HChenZ/amd_fpga_2026/data/pynq/readme.md

# 旧 PYNQ v1 原始证据

更新：2026-11-01。本目录的记录属于无PUF的 PYNQ v1 / pynq-svc-v1，不是当前PUF3。
10-28 board目录保存容量内KAT；10-31 notebook_20261031_112052保存该旧版benchmark，
error_gate_20261031_112812保存9项错误/恢复门禁。它们在最终报告中作历史对照。
旧10-29目录已由远端变更移出工作树，可从Git历史追溯；不能把重测时间写回原记录。
当前PUF3主采样位于相邻pynq_puf3目录。本页不修改任何原始结果或既有包。
