HChenZ/amd_fpga_2026/docs/tech_report/figs/fig_3_1.tex

% 图 3-1 系统实物照片（正视，上电运行状态）
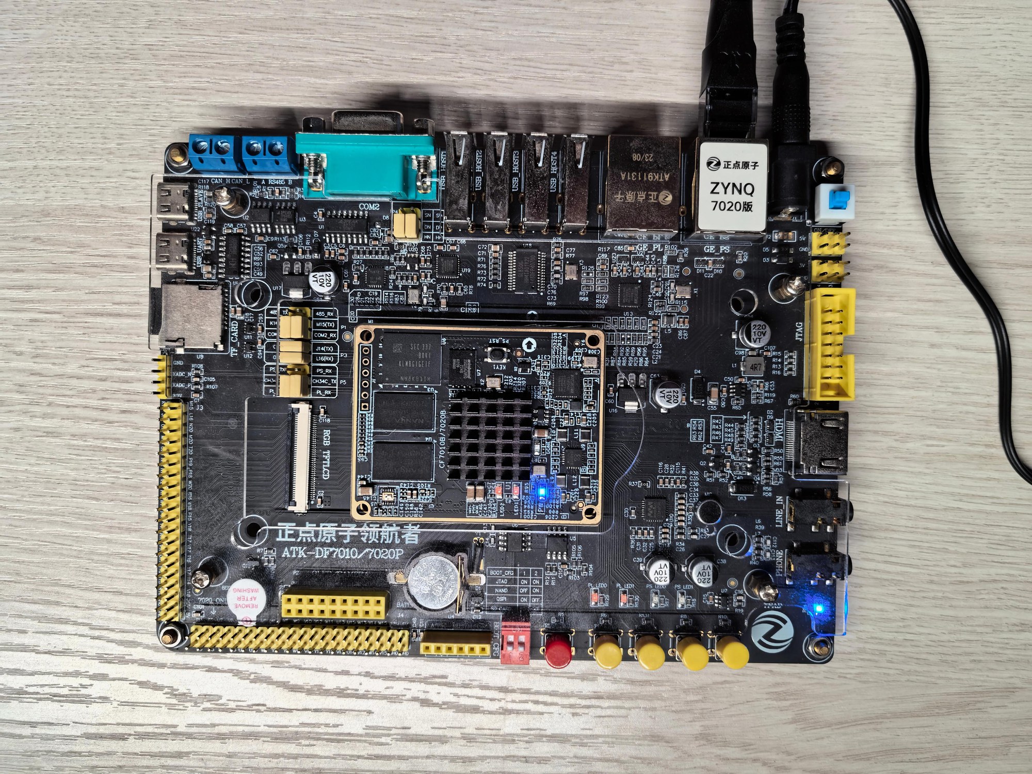
[picture p1: docs/tech_report/figs/board_photo.jpg]
