HChenZ/amd_fpga_2026/docs/tech_report/src_template/10_part1.md

## 摘要 {.unnumbered}

本作品在正点原子领航者 ZYNQ7020 开发板上实现集成 Ascon-AEAD128 的 RISC-V SoC。
PL 内为五级流水线 RV32IM + Zicsr 处理器，包含分支预测、I/D Cache、AXI 互连及 UART、GPIO、CLINT。
密码功能以 NIST SP 800-232 Final 为基准，提供纯软件、存储器映射加速器和定制指令三种方案。
四条定制指令使用 custom-0 编码空间，以 inline assembly 调用，不修改 GCC backend。

当前 PYNQ 发布版由 PS 经两个 AXI-Lite 窗口及 PL 内 UART mailbox 控制 RV32 服务固件。
明文和关联数据各不超过 16 B，三模式各通过 289 组官方容量内 KAT 及 289 次错误 Tag 拒绝。
Notebook 顺序执行、9 项错误恢复门禁与每模式 50 次加解密往返均已有实板记录。
固定官方 KAT #529（PT=16 B、AD=0），各预热 5 次后采样 30 次，加密 SW/HW/ISE 中位周期为
23342/1439/3995，HW 与 ISE 的周期加速比为 16.221×、5.843×；解密为 24005/1388/4385 周期。
周期来自固件 AEAD 调用边界，不含 PS 与串口；PS 调用墙钟中位 4.262–5.216 ms 单列，不充作同倍数响应加速。

Vivado 2025.2 对当前 `pynq_wrapper` 发布版在配置 100 MHz 下实现 WNS +0.034 ns、TNS 0、
setup/hold 失败端点 0、DRC 0 Error/0 Critical Warning，普通 Warning 如实保留。
另实现独立的 256 路 RO-PUF 与 Device DNA 密钥通路原型，同次上电的注册/重建自检通过，
最新有效日志注册质量为 128/128；不声称跨上电稳定、密钥保密隔离或完整安全启动。
host 完整 1089 组 KAT 与板级 289 组分列；独立频率、小时级稳定性与干净环境端到端复现尚未完成。

**关键词**：RISC-V；Ascon-AEAD128；定制指令扩展；MMIO；Zynq-7000；PYNQ；RO-PUF 原型

## 第一部分 作品概述

### 1.1 功能与特性

本作品在 Zynq-7020 上实现 RV32/PYNQ 短消息认证加密平台。PL 内为五级 RV32IM + Zicsr CPU，
提供标准 Ascon-AEAD128 软件、MMIO 与定制指令三种方案。当前 PT/AD 各 ≤16 B，key/nonce/tag 各 16 B。
PS 通过两个 AXI-Lite 窗口与 PL 内 UART mailbox 调用 RV32 服务固件，Jupyter 展示正确性、CPU 周期与 PS 墙钟。
三模式各 289 组官方容量内 KAT、坏 Tag 拒绝及 9 项错误恢复门禁已有实板记录；
完整 1089 组仅为 host 范围，不承诺超容量板级功能。

本作品面向资源受限嵌入式设备的短消息认证加密，选择 NIST SP 800-232 Final Ascon-AEAD128，
在既有五级流水线 RISC-V CPU 上比较纯软件与两条硬件加速路径。算法公开参考实现与官方 KAT
提供独立正确性基准；可交互 PYNQ 演示提供调用、验证与性能展示入口。

本次交付聚焦标准正确性、同平台周期对照、可运行 overlay 与可追溯证据。
host 执行完整 1089 组 KAT；板端只声明容量内 289 组及负向验证，未验收项见 §3.3.5。

### 1.2 应用领域

本作品面向资源受限嵌入式系统的短消息认证加密评估，例如传感器状态、控制消息或设备间小包数据。
当前实测只证明开发板上的有限长度功能与性能，不等于已部署产品的安全认证。

平台也可作为体系结构与 FPGA 实验载体：同一 RV32 上比较纯软件、CPU 驱动 MMIO 与定制指令，
用相同向量和测量边界观察周期差异。替换算法或平台需重新适配验证，不能直接沿用本作品性能值。

### 1.3 主要技术特点

三方案同平台、同输入对照；custom-0 的四条定制指令以 .insn 调用，不修改 GCC backend；
AEAD 密文和 Tag 与锁定 Final 参考逐字节比对；CPU mcycle 与 PS 墙钟分别保存。
构建采用 Vivado 2025.2，bit/hwh/固件逐项记录哈希；仿真、板测、实现报告与未测项分层标注。
当前 PYNQ 数据通道为 AXI-Lite 字节 FIFO 与 RV32 uncached UART，不使用共享可缓存数据缓冲。

### 1.4 主要性能指标

<span class="tabcap">表 1-1</span> **主要性能指标**

| 指标 | SW | HW/MMIO | ISE |
|---|---:|---:|---:|
| 加密 cycles | 23342 | 1439 | 3995 |
| 加密周期加速比 | 1.000× | 16.221× | 5.843× |
| 解密 cycles | 24005 | 1388 | 4385 |
| 解密周期加速比 | 1.000× | 17.295× | 5.474× |
| 加密 PS 墙钟 ms | 5.216 | 4.479 | 5.154 |
| 板级 KAT / 坏 Tag 拒绝 | 289/289 | 289/289 | 289/289 |

上表为当前 PYNQ release 官方 KAT #529（PT=16 B、AD=0）预热 5 次、采样 30 次的中位数，周期不含 PS/UART。
整机 LUT 14269、FF 19691、BRAM 34.5、DSP 4；100 MHz 下 WNS +0.034 ns、TNS 0、DRC 0 Error，频率未独立实测。

### 1.5 主要创新点

1. 同一 RV32 平台、同输入比较软件、MMIO 和定制指令，避免跨平台拼接加速比。
2. custom-0 状态读写与 P8/P12 置换，经 inline assembly 调用，不改编译器后端。
3. 策略扫掠与端点归因结合 RTL 结构改造，形成带 run 记录的时序收敛过程。
4. 发布哈希、官方 KAT、原始周期和墙钟、错误恢复门禁构成可复核演示链。

### 1.6 设计流程

设计流程以"先定口径、再做实现、最后留证"为主线，分六个阶段（图 1-1）：
确定指标及出处；按模块完成 RTL 并同步编写 testbench；
以参考实现和官方向量建立期望值，经单元仿真与 SoC 回归逐层收敛；
先策略扫掠、再按失败端点改结构；板上验证三方案并采集 KAT、周期与错误恢复；
核验哈希后于 11 月 1 日提交前冻结。细节见附录 D。

> <span class="figslot" data-src="1-1">图 1-1</span> **设计与验证流程**
