HChenZ/amd_fpga_2026/docs/tech_report/src_template/new/p2_2.md

本作品为纯电子系统，不含机械结构与运动部件。板卡采用正点原子领航者 ZYNQ7020 开发板，
以底板 + 核心板的两段式结构装配；设计成果全部位于 PL 内部逻辑与 PS 端软件，
不需要额外的机械加工件、传感器支架或外部供电模块。板级连接的仅有 50 MHz 时钟源、
USB 串口（UART）、两个用户按键、两个用户 LED 与以太网口，其中串口与网口分别用于
固件日志输出与 PYNQ 远程访问。
