HChenZ/amd_fpga_2026/docs/tech_report/src_template/new/p2_3_1.md

软件分为 RV32 裸机固件、PS Python 调用层与开发机验证脚本。
历史 PL-only 使用 ascon_rv32、ascon_hw_rv32、ascon_ise_rv32；当前发布使用 pynq_svc，
在同一固件中按 mode 选择 SW/HW/ISE。固件由 COE 随 bitstream 初始化，不在运行时动态加载。

PS 侧由 AsconHost、MailboxBackend、PynqUartTransport 与 mailbox_protocol.py 完成请求、身份、
deadline 与 epoch 管理。超时需显式 reset/recover，不隐式重发；单客户端串行，未实现跨进程锁。
主机侧由 sim/ascon、sim/pynq、sim/board 的脚本分别执行标准验证、桥/服务仿真和回归。

> <span class="figslot">图 2-11</span> **软件分层与调用关系**：PS Python、RV32 服务固件与验证脚本，
> 标明 AXI-Lite/UART 帧协议与 MMIO/定制指令边界。
