HChenZ/amd_fpga_2026/docs/tech_report/src_template/new/p2_3_2_2.md

MMIO 驱动使用 0x30000000 寄存器窗口：写 KEY(+0x10–1C)、NONCE(+0x20–2C)、
ADLEN/MLEN，推入 AD_WDATA(+0x40)/MSG_WDATA(+0x44)，写 CTRL 启动，轮询 STATUS，
读取 OUT_RDATA(+0x48) 与 TAGOUT(+0x4C–58)，结束后显式清零。
消息与 AD 各 ≤16 B，BUSY 写忽略，认证成功且在有效长度内才允许输出。

当前 #529 加密中位 1439 cycles，解密 1388 cycles；两者包含驱动调用内搬运与轮询，不含 PS/UART。
HW 轮询异常当前可能表现为 INTERNAL 或认证失败，不能声称存在独立 TIMEOUT 状态码；异常后整链恢复。
历史 688 cycles 与核本体 103 cycles 不替代当前服务测量。
