HChenZ/amd_fpga_2026/docs/tech_report/src_template/new/p2_3_2_3.md

ISE 用 ascon.w/ascon.rd 访问 10 个 32-bit 状态字，以 ascon.p12/ascon.p8 执行置换。
主操作码 0x0B、funct7=0、funct3=0/1/2/3；inline assembly 使用 .insn，未修改 GCC backend。
构建归档检出 24 条 custom-0 静态编码；真实服务运行 KAT 提供动态正确性证据。

当前 #529 加密为 3995 cycles，相对 SW 为 5.843×；历史 PL-only 2570 cycles/8.10× 单列。
取消与 hold 的定向测试通过，不据此声称完整中断/抢占上下文保存恢复已验收。
