HChenZ/amd_fpga_2026/docs/tech_report/src_template/new/p2_3_2_4.md

board_benchmark.py 对同一 release 完成身份检查、三模式 smoke 和固定输入采样。
官方 KAT #529、每模式预热 5 次，每操作 30 次，逐次核对 CT/tag/PT，并保存 raw_cycles/raw_wall_ns。
JSON 同时记录服务标志、发布哈希、测量范围和统计；错误结果不能混入成功性能统计。

周期来自 RV32 mcycle 的高低高一致读取。PS 端墙钟独立计量，不以事件计数器相加代替总周期，
也不将 CPU 周期加速比称为 PS 响应加速比。当前结果目录为 data/pynq/notebook_20261029_130920/。
