HChenZ/amd_fpga_2026/docs/tech_report/src_template/new/p3_1.md

当前 PYNQ release 已在领航者 ZYNQ7020 上运行：PYNQ 2.7.0、Python 3.8.2，PS7 FCLK0 配置 100 MHz。
Python 通过 AXI-Lite/UART mailbox 调用 PL 内 RV32，同一 overlay 可切换 SW/HW/ISE，无需重载 bitstream。
板级容量内 KAT、Notebook、warm benchmark 与错误恢复均已留证；小时级稳定性与独立频率尚未测量。

> <span class="figslot">图 3-1</span> **系统实物正面照片**：docs/tech_report/figs/board_photo.jpg，
> 可见领航者 ATK-DF7010/7020P 丝印与上电指示。照片不证明拍摄时运行的 bitstream、芯片速度等级或长时稳定性；
> 背面、核心芯片完整丝印、跳线与 SD 镜像记录仍需补齐。

| 项目 | 已有证据 |
|---|---|
| 当前 KAT | 三模式各 289/289，坏 Tag 各 289/289 |
| 当前加密中位周期 | SW/HW/ISE=23342/1439/3995 |
| 错误恢复 | 9/9 checks、7/7 reset；每模式 50 次加解密往返 |
| 实现时序 | WNS +0.034 ns、TNS 0，DRC 0 Error/0 Critical |
| 当前 bit/hwh | 4045688 B / 148833 B，配套身份与哈希 |
