HChenZ/amd_fpga_2026/docs/tech_report/src_template/new/p3_2.md

当前成果分为硬件/固件源、配套 release 与原始验证数据。
工程入口为 board/vivado_zynq7000_xc7z020_pynq/build.tcl；BRAM COE 由服务固件 build.sh 生成。
实际使用的 top、part、源集、IP 与源文件哈希见发布 manifest，不能以不存在的脚本或目录代替。

| 产物 | 实际位置 | 版本与范围 |
|---|---|---|
| 当前 overlay/固件 | board/vivado_zynq7000_xc7z020_pynq/release/ | bit/hwh/bin/coe/elf/manifest/sha256sums |
| 当前实现与回归 | build/reports/pynq_final_20261028/ | timing.rpt、utilization.rpt、drc.rpt、summary.json |
| 当前容量内 KAT | data/pynq/board_20261028/ | 官方 289 组 × 3 模式，含错误 Tag 拒绝 |
| 当前固定输入采样 | data/pynq/notebook_20261029_130920/ | 各档 30 样本与 PS 墙钟 |
| 当前错误恢复 | data/pynq/error_gate_20261029_134023/ | JSON、log、identity、已执行 ipynb |
| 历史 PL-only 镜像 | build/local/board_bitstream/ | 三镜像各 4045687 B；本地备份不是 clone 保证 |
| 历史 PL-only 日志 | data/ascon/results/board/ | uart_20261026_sw_and_ise.txt、uart_20261027_mmio.txt |

clean-clone 与最终证据包仍需独立验收；现有工件校验通过不等于源到板全流程已干净重建。
