HChenZ/amd_fpga_2026/docs/tech_report/src_template/new/p3_4_3.md

```sh
# 1. 编译服务固件
#    产物：build/local/pynq_svc/pynq_svc.{elf,bin,coe}
bash src/firmware/pynq_svc/build.sh

# 2. 构建独立 PYNQ overlay
#    不打开、不修改历史冻结工程
vivado -mode batch -source board/vivado_zynq7000_xc7z020_pynq/build.tcl
```

固件反汇编中应能找到 custom-0 指令（P12、P8），证明 ISE 确实进入二进制。构建完成后核对时序报告
WNS ≥ 0、TNS = 0、DRC 无 Error。复建的 bitstream 不要求与发布版逐字节相同，
应分别核对源输入、功能、时序、资源与新产物哈希；直接复现已发布结果时使用 `release/` 中的配套文件。
