HChenZ/amd_fpga_2026/docs/tech_report/src_template/new/p3_4_4.md

写卡、串口跳线与启动模式按 `board/vivado_zynq7000_xc7z020_pynq/handoff_20261028.md` 第 C 节执行。
登录板卡后：

```sh
cd ~/jupyter_notebooks
git clone https://github.com/HChenZ/amd_fpga_2026.git
cd amd_fpga_2026
# bit/hwh/固件必须配套
sha256sum -c board/vivado_zynq7000_xc7z020_pynq/release/sha256sums.txt
# 三模式各 289 组 KAT 与坏 Tag 拒绝
python3 src/pynq/board_demo.py --full-kat --out pynq_board_full.json
# KAT #529，预热 5 次，采样 30 次
python3 src/pynq/board_benchmark.py --out pynq_warm_benchmark.json
# 9 项错误恢复，每模式 50 次往返
python3 src/pynq/board_error_gate.py --out pynq_board_error_gate.json
```

交互演示使用 `src/pynq/pynq_board_demo.ipynb`（修改首个单元的仓库路径后 Restart Kernel → Run All）；
CLI 与 Notebook 共享同一通道，不要同时运行。通过标准：boot 自检 mask=7、固件标识 pynq-svc-v1、
simulated=false，三模式 KAT 与坏 Tag 拒绝全部通过；周期结果应与 1.4 节主要性能指标同量级。
