HChenZ/amd_fpga_2026/docs/tech_report/src_template/new/p4_1.md

以下方向均未实施，属后续计划，不计入本轮成果。

1. 长消息支持：当前 PT/AD 各 ≤16 B，经 AXI-Lite 字节 FIFO 传输；可改为共享缓冲或流式搬运，
   并补齐完整 1089 组板级 KAT 与多块吞吐测量。
2. 器件绑定密钥：将独立 RO-PUF/Device DNA 原型并入当前 overlay，关闭派生输入回读通路，
   补充跨上电、温压与多器件统计后再评估密钥用途。
3. 指令与算法：在现有 custom-0 状态指令上扩展 SP 800-232 中的 Ascon-Hash256/XOF128，
   并以 intrinsic 封装降低软件调用开销。
4. 工程验证：补独立频率测量、小时级稳定性、完整 ISA/异常矩阵与干净环境复现。
