HChenZ/amd_fpga_2026/skill/ab_eval_pynq/harness/selftest/t4_diagnose/naive/answers.md

## Q1
DMA 配置可能有问题，检查 IP 设置并重新生成比特流。

## Q2
硬件可能卡住了，重启板卡再试。

## Q3
可能是缓冲区没有更新，检查代码逻辑。

## Q4
可能比特流损坏，重新下载。

## Q5
时钟配置错误，检查 Vivado 设计。

## Q6
HLS 核可能没有正确启动，检查 ap_start。

## Q7
地址错误，检查地址映射。

## Q8
平台差异导致，检查驱动。
