HChenZ/amd_fpga_2026/docs/tech_report/figs/fig_2_10.pdf

PYNQ release: pynq-svc-v1, simulated=false, selftest_mask=7 PT/AD capacity: 16 B each
Official capacity KAT: SW / HW / ISE = 289 / 289 / 289 PASS Bad Tag rejection: SW / HW / ISE = 289 / 289 / 289 PASS

KAT #529, PT16 B / AD0, warmup=5, samples=30 each encrypt cycles (median): SW=23342, HW=1439, ISE=3995 decrypt cycles (median): SW=24005, HW=1388, ISE=4385 encrypt PS wall ms: SW=5.216, HW=4.479, ISE=5.154

Error gate: 9/9 PASS; reset recovery: 7/7
Each mode: 50 encrypt + 50 decrypt requests PASS
Sources: data/pynq/board_20261028/; notebook_20261029_130920/; error_gate_20261029_134023/ (JSON summaries, not a screenshot)
