HChenZ/amd_fpga_2026/docs/tech_report/figs/fig_2_2.pdf

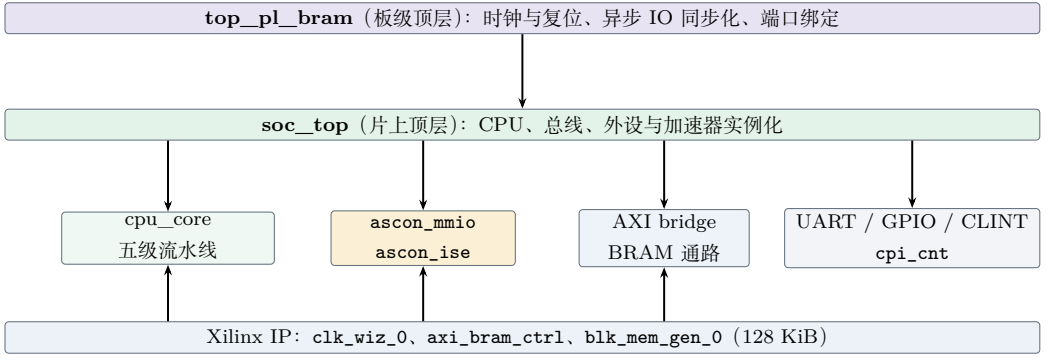
[picture p4: figure]
top_pl_bram（板级顶层）：时钟与复位、异步 IO 同步化、端口绑定; soc_top（片上顶层）：CPU、总线、外设与加速器实例化; cpu_core; 五级流水线; ascon_mmio; ascon_ise; AXI bridge; BRAM 通路; UART / GPIO / CLINT; cpi_cnt; Xilinx IP：clk_wiz_0、axi_bram_ctrl、blk_mem_gen_0（128 KiB）

历史 PL-only：const.xdc，50 MHz 输入与板外 IO；不作为当前 PYNQ 的约束

此图仅说明历史纯 PL 基准工程；三份 bitstream 各 4 045 687 B。 当前入口：board/vivado_zynq7000_xc7z020_pynq/build.tcl，顶层 pynq_wrapper，PS7 FCLK0 配置 100 MHz， 源集与工件身份以发布 manifest 为准。
