HChenZ/amd_fpga_2026/docs/tech_report/figs/fig_2_6.pdf

旋转常数：s0 : (19, 28)；s1 : (61, 39)；s2 : (1, 6)；s3 : (10, 17)；s4 : (7, 41)。 线性更新：si ← si ⊕ rotr(si, ri,1) ⊕ rotr(si, ri,2)。
轮常量为 8 bit，注入 s2 低字节；AEAD 的域分离 s4 ← s4 ⊕ 2

63 位于 AD 与消息之间。
AEAD IV：0x0000_1000_808c_0001；rate=128 bit，capacity=192 bit。 同一轮函数定义可以多次实例化，不意味着 MMIO 与 ISE 共享一块物理电路。
