HChenZ/amd_fpga_2026/docs/tech_report/figs/fig_2_7.pdf

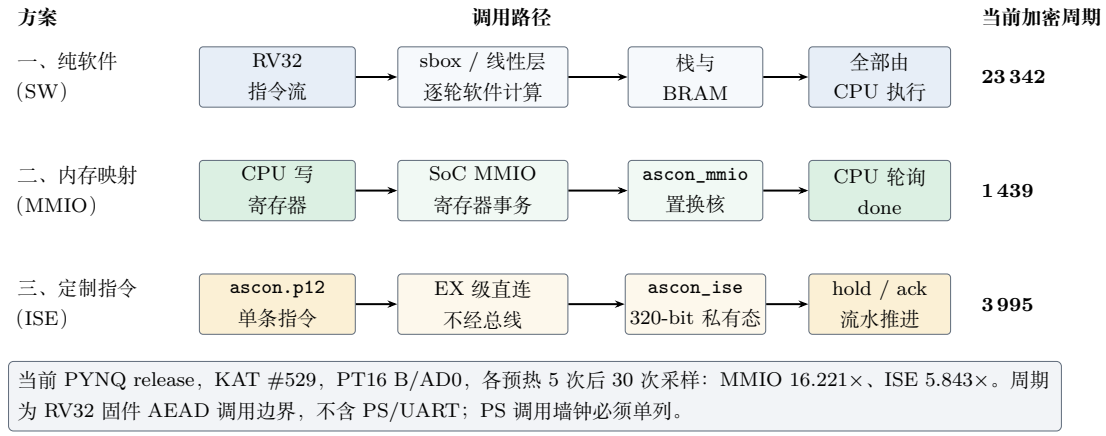
[picture p5: figure]
调用路径; 当前加密周期; 一、纯软件; 指令流; sbox / 线性层; 逐轮软件计算; BRAM; 全部由; CPU 执行; 二、内存映射; （MMIO）; CPU 写; 寄存器; SoC MMIO; 寄存器事务; ascon_mmio; 置换核; CPU 轮询; done; 三、定制指令; （ISE）; ascon.p12; 单条指令; EX 级直连; 不经总线; ascon_ise; 320-bit 私有态; hold / ack; 流水推进

当前 PYNQ release，KAT #529，PT16 B/AD0，各预热 5 次后 30 次采样：MMIO 16.221×、ISE 5.843×。周期 为 RV32 固件 AEAD 调用边界，不含 PS/UART；PS 调用墙钟必须单列。
