HChenZ/amd_fpga_2026/docs/tech_report/figs/fig_3_4.pdf

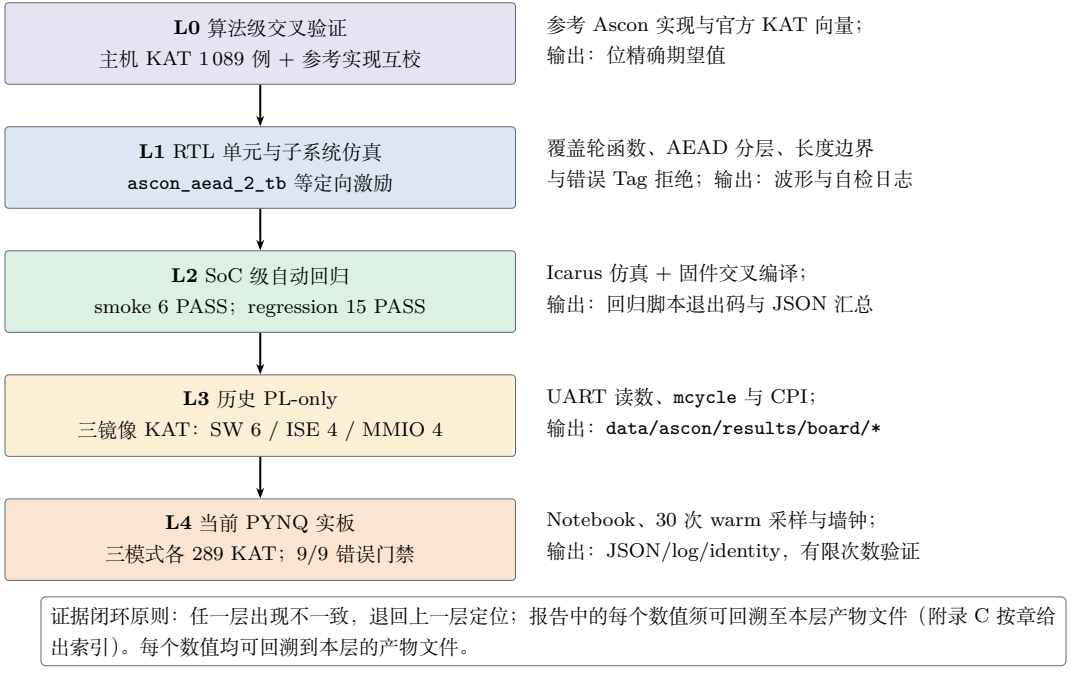
[picture p7: figure]
L0 算法级交叉验证; 主机 KAT 1 089 例 + 参考实现互校; L1 RTL 单元与子系统仿真; ascon_aead_2_tb 等定向激励; L2 SoC 级自动回归; smoke 6 PASS；regression 15 PASS; L3 历史 PL-only; 三镜像 KAT：SW 6 / ISE 4 / MMIO 4; L4 当前 PYNQ 实板; 三模式各 289 KAT；9/9 错误门禁; 参考 Ascon 实现与官方 KAT 向量；; 输出：位精确期望值; 覆盖轮函数、AEAD 分层、长度边界; 与错误 Tag 拒绝；输出：波形与自检日志; Icarus 仿真 + 固件交叉编译；; 输出：回归脚本退出码与 JSON 汇总; UART 读数、mcycle 与 CPI；; 输出：data/ascon/results/board/*; Notebook、30 次 warm 采样与墙钟；; 输出：JSON/log/identity，有限次数验证; 证据闭环原则：任一层出现不一致，退回上一层定位；报告中的每个数值须可回溯至本层产物文件（附录 C 按章给; 出索引）。每个数值均可回溯到本层的产物文件。
