HChenZ/amd_fpga_2026/report/technical/amd_fpga_2026_latex_final/amd_fpga_2026_report/output/pdf/final_report.pdf

# 全国大学生嵌入式芯片与系统设计竞赛

## 2026 FPGA 创新设计赛道

# 技术报告

### 报告类型： 技术报告

### 参赛赛道： AMD 自主选题初级组

### 作品名称： RISC-V 轻量密码加速 SoC

### 队伍编号： 41555

### 团队名称： 芯尽自然亮

### 文档日期： 2026 年 10 月 31 日

目录

摘要 | 1
第一部分 作品概述 | 2
第二部分 系统组成及功能说明 | 4

i

第三部分 完成情况及性能参数 | 37
第四部分 总结 | 59
第五部分 参考文献 | 62
附录 A 术语与缩写 | 63
附录 B 地址映射与指令编码 | 64
附录 C 证据索引 | 66

ii

附录 D 研制历程、证据分级与统计口径 | 77
插图目录 | 79
表格目录 | 80

iii

摘要

本作品在正点原子领航者 ZYNQ7020 开发板上实现集成 Ascon-AEAD128 的 RISC-V SoC。PL 内为五级流水线 RV32IM + Zicsr 处理器，包含分支预测、I/D Cache、AXI 互连 及 UART、GPIO、CLINT。密码功能以 NIST SP 800-232 Final 为基准，提供纯软件、存储 器映射加速器和定制指令三种方案。四条定制指令使用 custom-0 编码空间，以 inline assembly 调用，不修改 GCC backend。
本报告最终演示对象为 PUF3：PS 经两个 AXI-Lite 窗口及 PL 内 UART mailbox 控制 pynq-svc-puf3，同一 overlay 提供 SW/MMIO/ISE 与 RO-PUF/DNA 密钥通路。明文和关 联数据各不超过 16 B，三模式各通过 289 组容量内官方 KAT 及 289 次错误 Tag 拒绝。固 定官方 KAT #529（PT=16 B、AD=0），HWKEY 关闭，各预热 5 次后采样 30 次，加密 SW/HW/ISE 中位周期为 21862/1369/3895，HW 与 ISE 的周期加速比为 15.969×、5.613×； 解密为 22562/1213/4288 周期。周期来自固件 AEAD 调用边界，不含 PS 与串口；10-31 采样 的 PS 调用墙钟中位 4.137–5.130 ms 单列，不充作同倍数响应加速。
Vivado 2025.2 对当前 pynq_puf3_wrapper 在 100 MHz 约束下实现 WNS +0.104 ns、 TNS 0、WHS +0.041 ns，已约束路径 setup/hold 失败端点均为 0；整机为 18674 LUT、32002 FF、34.5 BRAM tile、4 DSP。DRC 为 0 Error/0 Critical Warning，但 methodology 含 TIMING-17，RO 振荡环计数器域仍未签核。10-31 完整板测以 mcycle 对 PS 单调时钟测得约 99.9723 MHz；同次上电 enroll quality=127/128、连续 5 次重建及 HWKEY 开关恢复通过。host 完 整 1089 组 KAT 与板级 289 组分列；跨上电、温压、熵、BER、唯一性、小时级稳定性与干 净环境端到端复现尚未验收。旧 PYNQ release 的 9 项错误恢复门禁保留为历史证据，不移作 PUF3 的通过结论。
关键词：RISC-V；Ascon-AEAD128；定制指令扩展；MMIO；Zynq-7000；PYNQ；RO-PUF 原型

## 第一部分 作品概述

### 1.1 功能与特性

本作品在 Zynq-7020 上实现 RV32/PYNQ 短消息认证加密平台，最终演示使用 PUF3 单 一 overlay。PL 内为五级 RV32IM + Zicsr CPU，提供标准 Ascon-AEAD128 软件、MMIO 与 定制指令三种方案，并接入可显式切换的 RO-PUF/DNA 密钥通路。当前 PT/AD 各 ≤16 B， key/nonce/tag 各 16 B。PS 通过两个 AXI-Lite 窗口与 PL 内 UART mailbox 调用 RV32 服 务固件，Jupyter 展示正确性、CPU 周期、PS 墙钟及 PUF 流程。PUF3 三模式各 289 组容量 内 KAT 与坏 Tag 拒绝已有实板记录；完整 1089 组仅为 host 范围。旧 release 的 9 项错误恢 复证据单列。
本作品面向资源受限嵌入式设备的短消息认证加密，选择 NIST SP 800-232 Final Ascon-AEAD128，在既有五级流水线 RISC-V CPU 上比较纯软件与两条硬件加速路径。算法公开参 考实现与官方 KAT 提供独立正确性基准；可交互 PYNQ 演示提供调用、验证与性能展示入 口。
本次交付聚焦标准正确性、同平台周期对照、可运行 overlay 与可追溯证据。host 执行完 整 1089 组 KAT；板端只声明容量内 289 组及负向验证，未验收项见 §3.3.3.7。

### 1.2 应用领域

本作品面向资源受限嵌入式系统的短消息认证加密评估，例如传感器状态、控制消息或设 备间小包数据。当前实测只证明开发板上的有限长度功能与性能，不等于已部署产品的安全认 证。
平台也可作为体系结构与 FPGA 实验载体：同一 RV32 上比较纯软件、CPU 驱动 MMIO 与定制指令，用相同向量和测量边界观察周期差异。替换算法或平台需重新适配验证，不能直 接沿用本作品性能值。

### 1.3 主要技术特点

三方案同平台、同输入对照；custom-0 的四条定制指令以.insn 调用，不修改 GCC backend； AEAD 密文和 Tag 与锁定 Final 参考逐字节比对；CPU mcycle 与 PS 墙钟分别保存。构建采 用 Vivado 2025.2，bit/hwh/固件逐项记录哈希；仿真、板测、实现报告与未测项分层标注。当 前 PYNQ 数据通道为 AXI-Lite 字节 FIFO 与 RV32 uncached UART，不使用共享可缓存数 据缓冲。

### 1.4 主要性能指标

表 1-1 主要性能指标

指标 | SW | HW/MMIO | ISE
加密 cycles | 21862 | 1369 | 3895
加密周期加速比 | 1.000× | 15.969× | 5.613×
解密 cycles | 22562 | 1213 | 4288
解密周期加速比 | 1.000× | 18.600× | 5.262×
加密 PS 墙钟 ms | 5.130 | 4.403 | 4.385
板级 KAT / 坏 Tag 拒绝 | 289/289 | 289/289 | 289/289

上表来自 data/pynq_puf3/notebook_20261031_114512/result.json，HWKEY 关 闭，官方 KAT #529（PT=16 B、AD=0）预热 5 次、采样 30 次，周期不含 PS/UART。整机 LUT 18674、FF 32002、BRAM 34.5、DSP 4；100 MHz 约束下 WNS +0.104 ns、TNS 0、DRC 0 Error。mcycle/PS 时基测得约 99.9723 MHz；RO 振荡环计数器域未签核，不以正 WNS 宣 称全域通过。

### 1.5 主要创新点

1. 同一 RV32 平台、同输入比较软件、MMIO 和定制指令，避免跨平台拼接加速比。
2. custom-0 状态读写与 P8/P12 置换，经 inline assembly 调用，不改编译器后端。
3. 策略扫掠与端点归因结合 RTL 结构改造，形成带 run 记录的时序收敛过程。
4. 工件哈希、官方 KAT、原始周期、墙钟与 PUF 门禁构成可复核演示链，旧版证据分列。

### 1.6 设计流程

设计流程以“先定口径、再做实现、最后留证”为主线，分六个阶段（图 1-1）：确定指标及

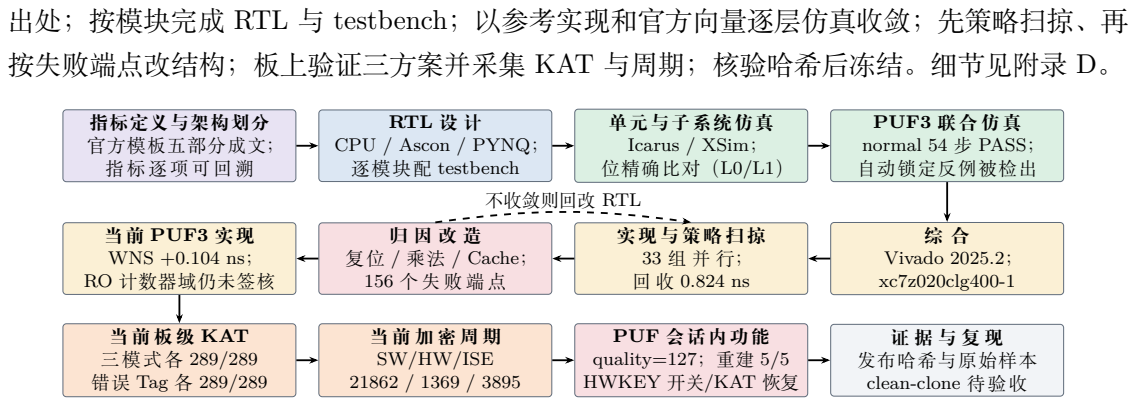
[picture p8: figure]
出处；按模块完成 RTL 与 testbench；以参考实现和官方向量逐层仿真收敛；先策略扫掠、再; 按失败端点改结构；板上验证三方案并采集 KAT 与周期；核验哈希后冻结。细节见附录 D。; 指标定义与架构划分 官方模板五部分成文； 指 标 逐 项 可 回 溯; RTL 设 计 CPU / Ascon / PYNQ； 逐模块配 testbench; 单元与子系统仿真 Icarus / XSim； 位精确比对（L0/L1）; PUF3 联 合 仿 真 normal 54 步 PASS； 自动锁定反例被检出; 综 合 Vivado 2025.2； xc7z020clg400-1; 归 因 改 造 复位 / 乘法 / Cache； 156 个 失 败 端 点; 当 前 PUF3 实 现 WNS +0.104 ns； RO 计数器域仍未签核; 当 前 板 级 KAT 三模式各 289/289 错误 Tag 各 289/289; 当 前 加 密 周 期 SW/HW/ISE 21862 / 1369 / 3895; PUF 会话内功能 quality=127；重建 5/5 HWKEY 开关/KAT 恢复; 证 据 与 复 现 发布哈希与原始样本 clean-clone 待验收; 不收敛则回改 RTL

图 1-1 设计与验证流程

## 第二部分 系统组成及功能说明

### 2.1 整体介绍

处理器采用经典五级顺序流水线结构：取指（IF）、译码与读寄存器（ID）、执行（EX）、访 存（MEM）、写回（WB），并配置 I-cache、D-cache、分支预测器、旁路网络与集中式冒险控 制。顶层 cpu_core 之下的并列单元构成如下表。

表 2-1 处理器功能单元组成

单元 | 文件 | 职责
取指 | if_stage.v、if_id.v | PC 生成、I-cache 查询、预测目标选择、冲刷 响应
译码 | id_stage.v、id_ex.v | 指令字段解析、立即数生成、结果类型 （ResultKind）判定、寄存器索引下发
执行 | ex_stage.v、mult.v、divider.v | ALU 与移位、分支条件判定、多周期乘除、 Ascon ISE 接入
访存 | mem_stage.v、mem_wb.v | load/store 对齐与 D-cache 事务、总线请求
写回 | mem_wb.v、regfile.v | 结果选择、GPR 写端口、CSR 写端口
控制 | ctrl.v（stall_ctrl）、bypass.v | 5 位 stall/flush 向量、两级旁路选择
存储 | icache.v、dcache.v、bus_ interconnect.v | 各 64 组 × 2 路 × 4 字/行；地址译码与总线 状态机
系统 | csr_file.v、clint.v、uart_ctrl.v、 gpio.v、cpi_cnt.v | 特权 CSR、定时器中断、串口、GPIO、CPI 事件计数
互连 | cpu_axi_bridge.v、axi_full_ master.v、soc_top.v、top.v、top_ pl_bram.v | 内部总线至 AXI4 master、BRAM 与外设； 板级顶层与时钟复位

数据通路的关键接口约定如下：

- 指令与数据的地址空间由 Cache 区分：I-cache 与 D-cache 独立查询同一片 BRAM 区 域（统一编址，0x1000_0000 起 128 KiB）；不可 Cache 的访问（MMIO）直接经总线完 成，不进入 Cache；
- 结果类型于 ID 级判定：指令在译码阶段即标注结果来源（算术、逻辑、移位、load、跳 转链接、乘法），EX 级据此选择数据通路，避免在执行级重复译码；
- 旁路于 ID 级选路、于 EX 入口生效：优先级为 EX/MEM > MEM/WB（bypass.v 中两级 MUX）；load-use 冒险以停顿方式解决，不采用推测加重放；
- CSR 读写置于 EX 级：mepc、mcause、mtvec 与陷入入口位于同一路径，使 ecall 与 mret 的 PC 修复仅有单一实现。

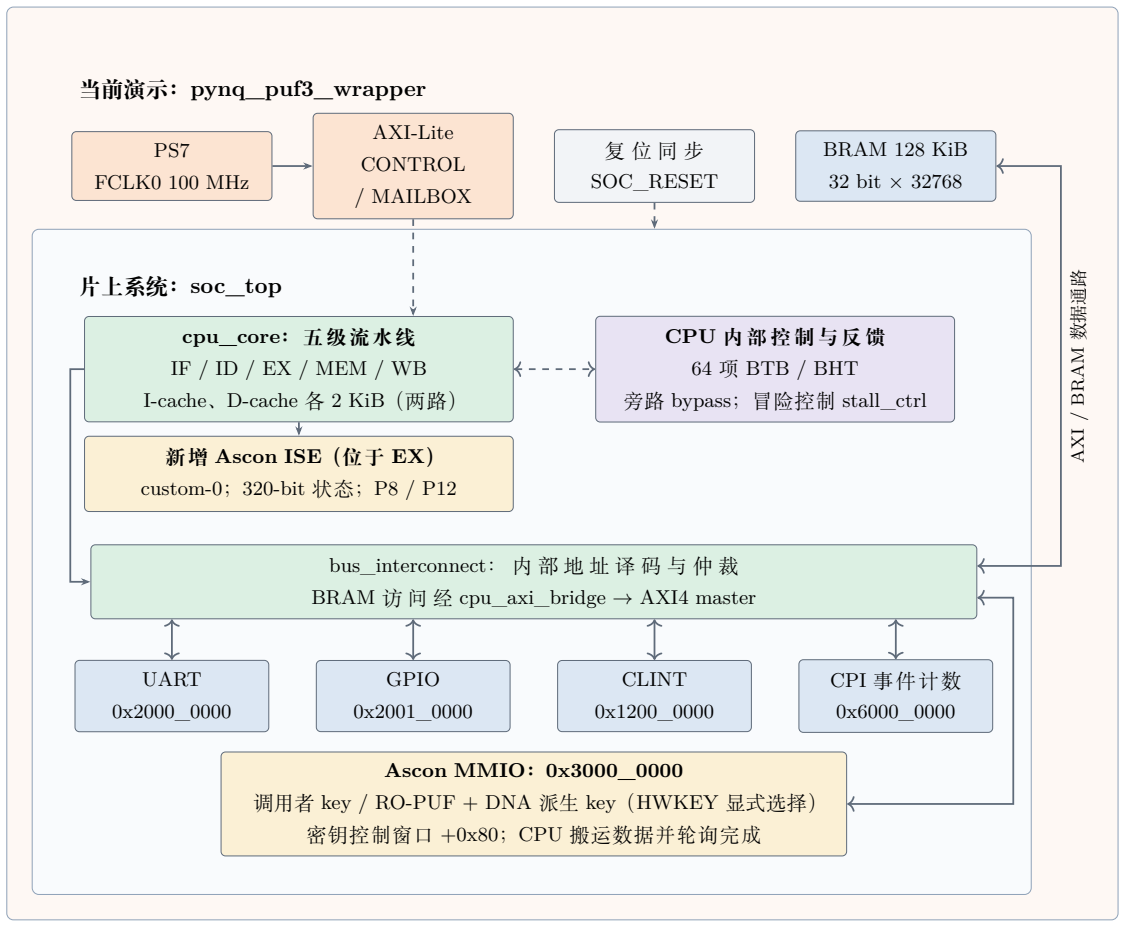
[picture p9: figure]
当前演示：pynq_puf3_wrapper; FCLK0 100 MHz; AXI-Lite; CONTROL; / MAILBOX; SOC_RESET; BRAM 128 KiB; 32 bit × 32768; 片上系统：soc_top; cpu_core：五级流水线; IF / ID / EX / MEM / WB; I-cache、D-cache 各 2 KiB（两路）; CPU 内 部 控 制 与 反 馈; 64 项 BTB / BHT; 旁路 bypass；冒险控制 stall_ctrl; 新增 Ascon ISE（位于 EX）; custom-0；320-bit 状态；P8 / P12; bus_interconnect： 内 部 地 址 译 码 与 仲 裁; BRAM 访 问 经 cpu_axi_bridge → AXI4 master; UART; GPIO; CLINT; CPI 事件计数; Ascon MMIO：0x3000_0000; 密钥控制窗口 +0x80；CPU 搬运数据并轮询完成; AXI / BRAM 数据通路

调用者 key / RO-PUF + DNA 派生 key（HWKEY 显式选择）

图 2-1 处理器与 SoC 总体框图

CPU 五级流水、I/D-cache、旁路与冒险控制、总线互连、AXI BRAM、UART/GPIO/CLINT/CPI，以及 Ascon MMIO 与 EX 级 ISE。当前系统时钟由 PS7 FCLK0 提供，PL-only 顶层仅作历史对照。

### 2.2 处理器架构与设计思路

### 2.2.1 设计目标与总体思路

CPU 采用 RV32 五级流水线结构，并集成 Ascon-AEAD128 软件、MMIO 加速和自定义 指令路径；本报告围绕当前 PUF3 工程的接口、验证和实测结果展开。

1. 在 XC7Z020 上以 100 MHz 稳定运行。7020 的 LUT 与布线资源有限，结构选择优先 考虑时序可收敛，而不是追求更高的单线程性能。
2. 为三种 Ascon 实现提供公平的对照平台。软件、MMIO 与定制指令必须运行在同一 CPU、 同一存储层次、同一测量方式（mcycle）下，周期差异才只来自实现方式本身。
3. 让定制指令接入后不破坏既有流水线语义。新增指令要能被停顿、被陷入取消，且不会因 停顿而重复执行。

据此形成以下设计取舍：

表 2-2 处理器设计取舍

决策 | 选择 | 理由与代价
流水线深 度 | 经典五级顺序流水，不做乱序与多发射 | 控制逻辑可审查、可验证；单发射使周期计 数可直接比较
冒险控制 | ctrl.v 集中产生 stall / flush，按固定优 先级裁决 | 多种停顿源（Cache、总线、乘除、ISE、 load-use）叠加时只有一处裁决，便于证明 正确性
数据冒险 | EX/MEM、MEM/WB 两级旁路， load-use 停顿一拍 | 不做推测加重放，以少量停顿换取简单可 靠的控制
译码 | ID 级标注结果类型（ResultKind）并随流 水传递 | 后级按类型选数据通路，避免在 EX/WB 重复译码，缩短关键路径
存储层次 | 分离 I/D-cache，代码与数据统一编址于 128 KiB BRAM；MMIO 绕过 Cache | 取指与访存并行；外设访问保持顺序与副 作用语义
分支预测 | 64 项 BTB + 2-bit BHT，分布式 RAM 零 延迟读出 | 小表面积与时序代价低；命中率未单独实 测，不作性能结论
加速接入 | MMIO 外设挂总线；ISE 置于 EX 级、持 有 320-bit 私有状态 | 前者不改 CPU，后者省去总线往返；ISE 以 hold / ack 握手跨多拍执行

时序收敛同样体现上述思路：先用 33 组实现策略确定工具能回收的余量，再按失败端点 归因做结构改造（D-cache 增加 MISS_CAPTURE、乘法器寄存器化、ISE 局部复位），而不 是降低频率（见 2.2.11 节）。

### 2.2.2 流水线微架构

图 2-2 按流水级分列给出处理器微架构。顶部为贯穿各级的集中冒险控制，竖条为四组流 水寄存器，底部为总线与 SoC 外设。

- IF：PC 按” 陷入向量 > 分支重定向 > 预测目标 > PC+4” 选择；分支预测器在同拍组 合读出目标，I-cache 使用同步数据 RAM 返回指令，未命中则停顿取指并整行回填。
- ID：并行生成五种立即数，标注结果类型；寄存器堆双读一写并带写读直通；load-use 冒
| 险在此检测，命中时冻结前两级并插入气泡。
- EX：旁路网络先选出最新操作数，再送入 ALU、乘除法、CSR 与 Ascon ISE。分支在 EX 级裁决，误预测时重定向 PC 并冲刷两条较年轻指令，同时训练 BTB/BHT。乘除与 ISE 为多周期单元，通过 ex_stall_req 冻结前级。
- MEM：可 Cache 地址走两路组相联 D-cache；MMIO 地址绕过 Cache，直接发出单拍
| 注册请求。
- WB：按结果类型选择 ALU、load、PC+4 或 CSR 值写回寄存器堆，并经旁路回送 EX。

各单元的实现细节见 2.2.3–2.2.10 节，结构改造汇总见 2.2.11 节。

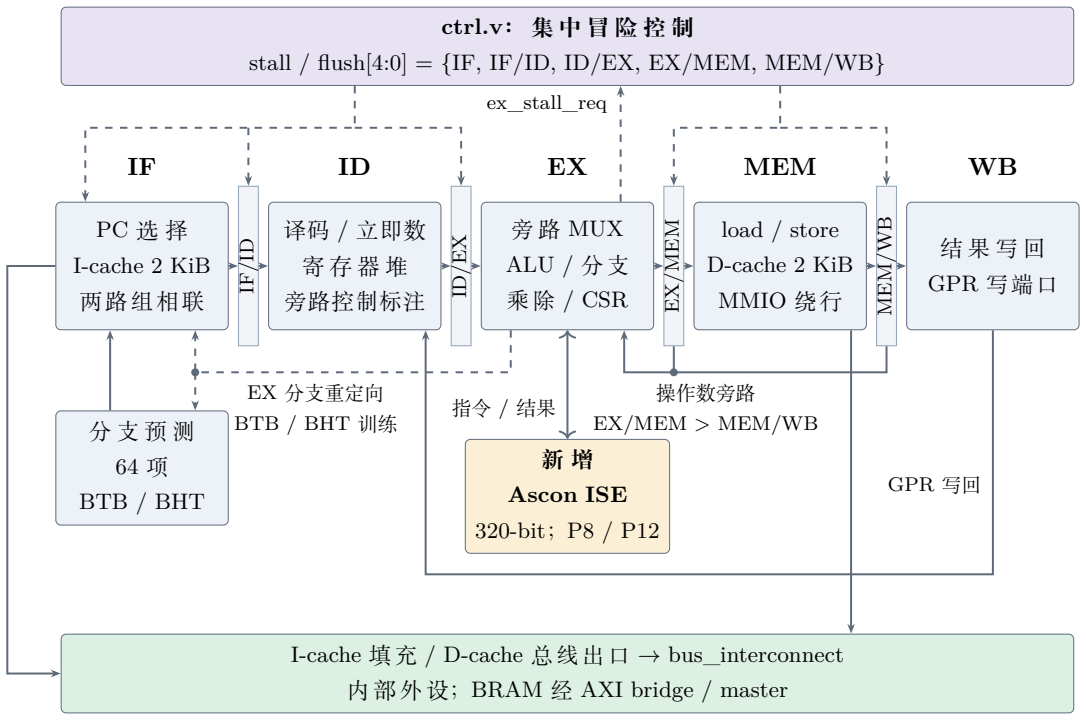
[picture p10: figure]
ctrl.v： 集 中 冒 险 控 制; MEM; I-cache 2 KiB; 两路组相联; 译码 / 立即数; 旁路控制标注; 旁 路 MUX; ALU / 分支; 乘除 / CSR; load / store; D-cache 2 KiB; MMIO 绕行; GPR 写端口; EX/MEM; MEM/WB; ex_stall_req; BTB / BHT; EX 分支重定向; BTB / BHT 训练; Ascon ISE; 320-bit；P8 / P12; 操作数旁路; EX/MEM > MEM/WB; GPR 写回; 内 部 外 设；BRAM 经 AXI bridge / master

stall / flush[4:0] = {IF, IF/ID, ID/EX, EX/MEM, MEM/WB}

I-cache 填充 / D-cache 总线出口 → bus_interconnect

图 2-2 RV32 处理器流水线微架构

CPU 共用源与 PUF3 构建源集对应。蓝色为既有 CPU 基础，橙色为新增 Ascon ISE；乘法握手及 D-cache MISS_CAPTURE 为本次优化。控制优先级见 §2.2.10；ISE 完成保持至 EX 级 ack，支持取消。

### 2.2.3 取指单元（IF）

取指级的职责为每周期产生一个 PC 及一条指令，需同时处理 Cache 命中、分支预测与流 水线冲刷三项相互耦合的条件。

- PC 来源优先级（由高至低）：陷入与中断入口、EX 级分支重定向（jump_en）、分支预 测目标、pc + 4；
- I-cache 查询：容量 2 KiB，64 组 × 2 路 × 4 字/行，两路组相联；tag 组合查询，数据 RAM 同步读出。未命中时进入 FILL 状态并向总线发出一次 burst 请求，ctrl.v 收到

icache_stall 后冻结 IF 与 IF/ID；
- 预测器接口：取指级以当前 PC 组合读出 pred_taken 与 pred_target（分布式 RAM， 零延迟），预测命中时当拍改选 PC，不增加流水级；
- 冲刷：flush[4] 清除 IF，flush[3] 清除 IF/ID。分支重定向（jump_en）时 ctrl.v 置 flush[3:2]（清除 IF/ID 与 ID/EX 两级，作废两条较年轻指令）；陷入、mret 与外 部中断时置 flush[3:1]（额外清除 EX/MEM）。各级冲刷的流水线代价随清除级数而 变，本文不作未经实测的拍数结论。

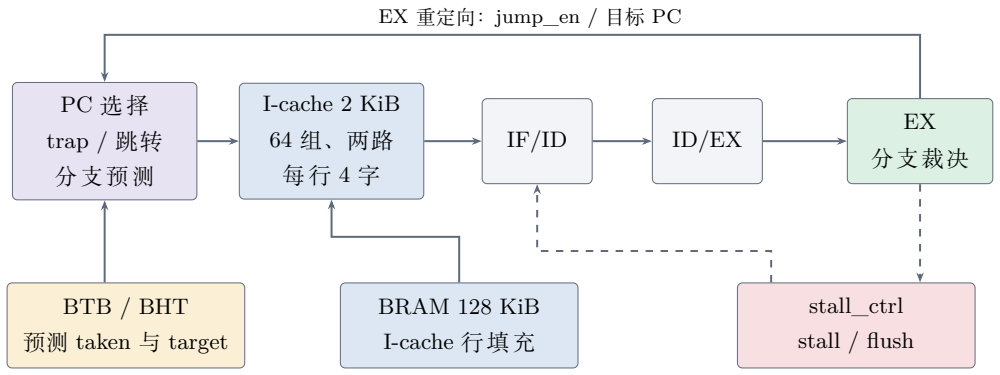
[picture p11: figure]
trap / 跳转; 分支预测; I-cache 2 KiB; 分支裁决; EX 重定向：jump_en / 目标 PC; BTB / BHT; 预测 taken 与 target; BRAM 128 KiB; I-cache 行填充; stall_ctrl; stall / flush

分支：flush[3:2] 清 IF/ID 与 ID/EX。陷入 / mret / 中断：flush[3:1]。 I-cache / fence.i 停顿：stall[4:3]，flush[2]。结构示意不代表固定惩罚拍数。

图 2-3 IF 级数据通路与冲刷语义

PC 选择、I-cache 查询、预测改选、miss FILL 与分支冲刷（flush[3:2] 两级）；为结构示意，不作为实测周期 波形。

### 2.2.4 译码单元（ID）

译码级完成字段解析与指令意图标注，为流水线中控制逻辑最密集的一级。

- 立即数生成：I、S、B、U、J 五种格式并行生成，由 opcode 选择；
- 寄存器堆：32 × 32-bit，双读一写；x0 恒为零（写端口屏蔽）；同步写、组合读。读地址与 有效写地址相同时直接返回 w_reg_data，存在寄存器堆内部写读旁路，并非返回旧值；
- 结果类型（ResultKind）：将指令映射为六类结果来源（算术、逻辑、移位、load、跳转 链接、乘法），该标注随流水线传递至 EX/MEM/WB，为后级” 不再重复译码” 的基础；
- CSR 指令与陷入：csrrw、csrrs、csrrc、ecall 与 mret 于 ID 级识别为 SYSTEM 类，具体读写与 mepc、mcause 更新在 EX 级完成；
- load-use 检测：ID 级比较 id_ex.rd 与当前 rs1、rs2，命中时置 stall_ld，由 ctrl. v 冻结 IF 与 IF/ID（stall[4:3]），并在 ID/EX 插入气泡（flush[2]）；EX/MEM 不 再清除。

### 2.2.5 执行单元（EX）

执行级为多功能并行与多周期串行相结合的混合结构，本作品的两处关键改造均作用于该 级。
并行功能单元：ALU（加、减、逻辑、比较、移位）、分支条件判定、跳转链接地址生成与 CSR 读写均在单周期内完成；乘法器 mult.v 完成 32 × 32 有符号与无符号乘法（RV32M 的 mul、mulh、mulhsu、mulhu），综合后被映射为 4 个 DSP48E1（实现报告 DSP 利用率 4 ／ 220），映射结果由工具的乘法推断产生而非显式例化 DSP 原语；除法器 divider.v 为迭代式

多周期实现（div、divu、rem、remu）。
多周期与握手：执行级向 ctrl.v 发出 ex_stall_req，后者冻结 IF、IF/ID 与 ID/EX

并在 EX/MEM 插入气泡。多周期单元完成时将结果与 done 一并锁存，直至被确认（ack）方 予释放。乘法器于本轮改造中增加 mul_ack 与 cancel 两个内部端口，其契约为：输入寄存器 至乘积寄存器，接受后下一拍乘积与 mul_done 有效；done 与结果保持至 ack；cancel 或 reset 取消且不产生完成信号。该契约使” 乘法结果在 EX 级保持” 与” 陷入取消” 两项行为互不干 扰。
Ascon ISE 接入点：custom-0（opcode 0x0b，funct7 = 0，funct3 区分四类操作）在该级 被识别为一类带状态的多周期指令，其读写对象为 ISE 内部的 10 个 32-bit 状态字（§2.3.3.4）， 而非通用寄存器。执行级以 hold 方式使流水线跨越 P12/P8 的多拍执行，done 保持至指令推

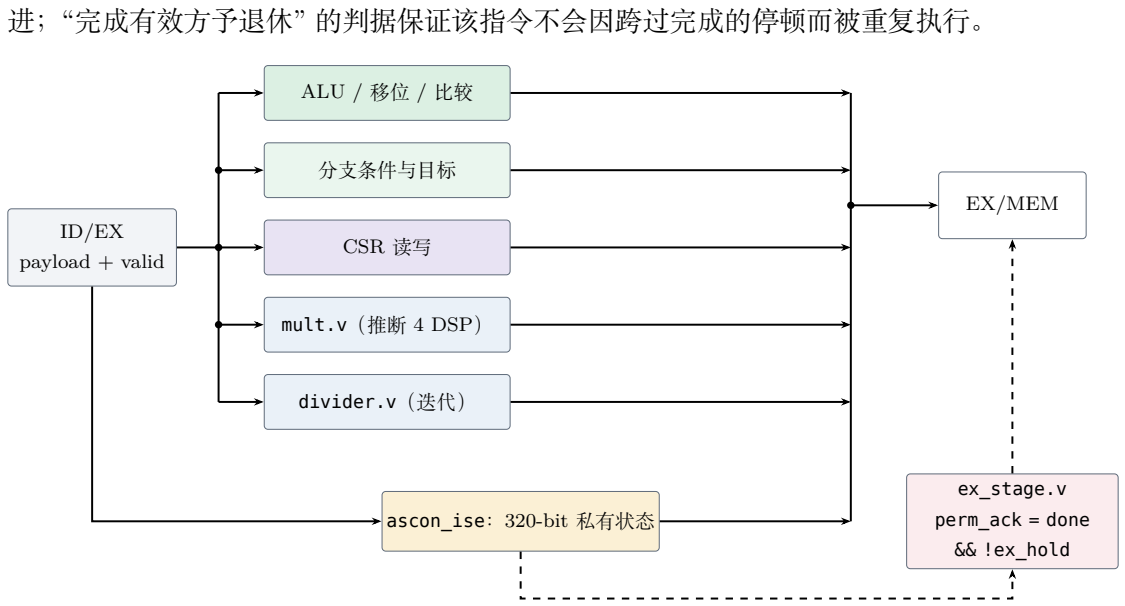
[picture p12: figure]
进；“完成有效方予退休” 的判据保证该指令不会因跨过完成的停顿而被重复执行。; payload + valid; ALU / 移位 / 比较; 分支条件与目标; CSR 读写; mult.v（推断 4 DSP）; divider.v（迭代）; ascon_ise：320-bit 私有状态; EX/MEM; ex_stage.v; perm_ack = done; && !ex_hold

Idle | Busy | Done
接受置换请求 | 置换完成

trap / mret / 中断取消

ack：指令推进、释放 stall

图 2-4 EX 级功能单元与多周期握手状态图

含 Idle → Busy → Done → ack 转换、陷入与中断取消分支，以及 ISE hold 与 ALU 单拍路径的复用关系。

### 2.2.6 访存与写回（MEM/WB）及 Cache 结构

访存级将执行级的地址与数据转换为 D-cache 事务或总线事务；写回级完成 GPR 与 CSR 写回。
D-cache 结构（dcache.v）：容量 2 KiB，64 组 × 4 字/行，两路组相联，采用 write-through 策略（store 不等待填充），tag 与数据分存；不可 Cache 的地址（MMIO 窗口）绕过 Cache，

改为单拍注册请求。状态机为 IDLE / MISS_CAPTURE / FILL 三态：

- IDLE：查询 tag，命中即返回；

- MISS_CAPTURE：本轮新增状态，将 miss 的 tag、index、way 及请求属性锁存一拍，使”miss 判定至总线请求” 不再经过单一长组合路径；
- FILL：等待总线填充完成，逐字写入 way。

I-cache：容量 2 KiB，64 组 × 2 路 × 4 字/行，两路组相联，状态机为 IDLE/FILL 两态， 未命中时整行填充。
写回：mem_wb 选择访存结果、load 数据、PC + 4 或 CSR 读值，驱动 regfile 写口；x0

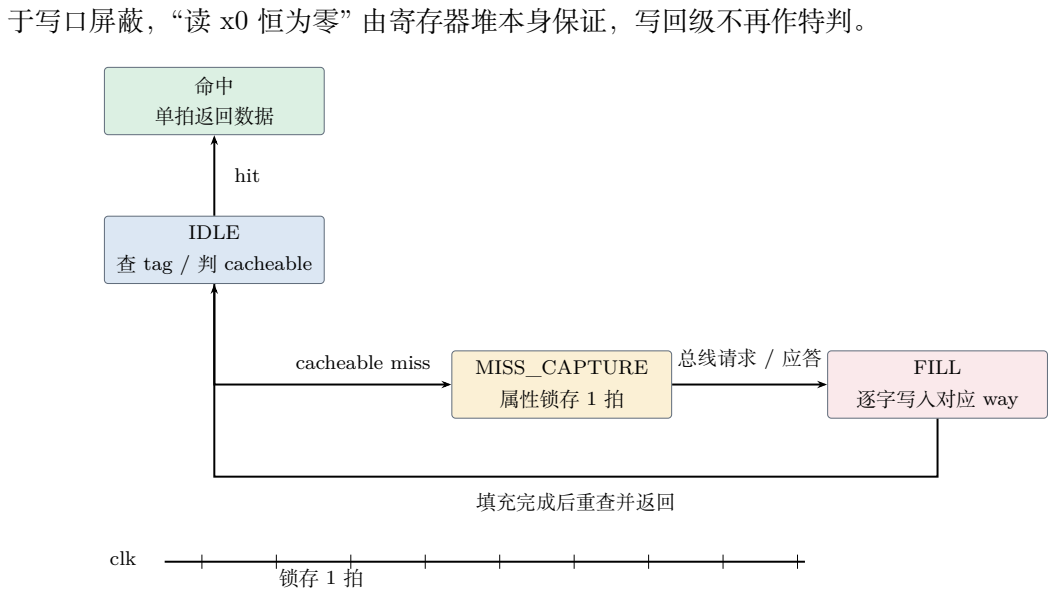
[picture p13: figure]
于写口屏蔽，“读 x0 恒为零” 由寄存器堆本身保证，写回级不再作特判。; IDLE; 查 tag / 判 cacheable; 单拍返回数据; MISS_CAPTURE; 属性锁存 1 拍; FILL; 逐字写入对应 way; hit; cacheable miss; 总线请求 / 应答; 填充完成后重查并返回; clk

req

busy

rdata

恢复命中

请求

等待

返回

图 2-5 D-cache 与总线请求时序

命中单拍、MISS_CAPTURE 一拍锁存、FILL 逐字写入，以及 store 与 MMIO 的绕过通路。

### 2.2.7 CSR、异常与计数

csr_file.v 实现的 CSR 集合为：mstatus（0x300）、misa（0x301）、mie（0x304）、 mtvec（0x305）、mscratch（0x340）、mepc（0x341）、mcause（0x342）、mtval（0x343）、mip （0x344）、mvendorid（0xF11）、marchid（0xF12）、mimpid（0xF13）、mhartid（0xF14），以

及 64-bit mcycle 与 mcycleh（0xB00 ／ 0xB80）。其中 mvendorid ／ marchid ／ mimpid

／ mhartid 返回常量 0。

- mcycle 为唯一周期来源：每个非复位时钟加一，RV32 经 0xb00（低）与 0xb80（高）访 问，软件按 high→low→high 顺序读取并校验一致性后重读。本作品全部周期加速比均以 mcycle 差值计算，不以事件计数之和替代——后者（cpi_cnt 的 inst、stall、flush 事件） 存在重叠，不可相加为周期数；

- 陷入流程：ecall 于 EX 级写入 mepc（当前 PC）与 mcause = 11，跳转至 mtvec；mret 自
mepc 恢复 PC；外部中断经 ireq_external = gpio_irq | uart_irq | ascon_irq
汇聚，抢占时由 stall_ctrl 清除较年轻指令；
- 计数与 CPI：cpi_cnt.v 挂接 0x6000_0000 窗口，提供 probe_inst_valid、probe_

stall_ld、probe_stall_md 与 probe_flush_br（每事件计权 2）四组 64-bit 计数； CPI 以同一区间的 cycle delta 与已退休指令 delta 计算，不采用事件加权和。

### 2.2.8 分支预测

预测器为 64 项单表结构（branch_predictor.v，INDEX_WIDTH = 6）：

- 表项：tag 表、BTB 目标表（分布式 RAM，ram_style="distributed"，整体 dont_ touch）、2-bit 饱和计数器 BHT 与打包 valid 向量；
- 索引：index = pc[7:2]（指令 4 字节对齐，低 2 位恒为零），tag = pc[31:8]；
- 预测：仅当 valid && tag_match && bht >= 2'b10 时判为 taken，目标取 BTB 中记 录的历史目标；
- 更新：分支进入 EX 级后训练（update_en、pc_ex、actual_taken、actual_target）， 并按 2-bit 状态机更新 BHT（00↔01↔10↔11，初值为弱不跳）。误预测冲刷由 ctrl.v 统 一处理，预测器不参与冲刷。

采用” 小型表 + 分布式 RAM” 而非大容量 BTB，系针对本平台的容量与时序折衷：在 100 MHz、LUT 资源受限的 7020 器件上，该结构的面积与时序代价均较低；就本 SoC 的主要 负载（AEAD 分块循环与基准测试主循环）而言，其命中率与单独性能贡献尚未量化，本文不 以结构描述替代实测结论。

### 2.2.9 总线与 SoC 外设

bus_interconnect.v 按地址高位将读写请求译码至各从设备；cpu_axi_bridge.v 与 axi_full_master.v 将内部事务转换为 AXI4 master（ID 1 bit、WSTRB = XLEN/8，支持 单拍与 burst）。

表 2-3 SoC 地址窗口与外设

窗口 | 基址 | 从设备 | 说明
MEM | 0x1000_
| 0000 | AXI BRAM Controller → Block RAM | 128 KiB，代码与数据统一空间，可 Cache
CLINT | 0x1200_

0000

clint.v | msip、mtimecmp、mtime，提供软件定时
中断

UART 0x2000_

0000

uart_ctrl.v | 当前 PYNQ 内部链路 6.25 Mbaud；历史板
外串口 115200；读 FIFO 有副作用

GPIO 0x2001_

0000

gpio.v | LED 控制、按键事件锁存（读清），两级同
步与消抖

续表 2-3

窗口 | 基址 | 从设备 | 说明
ASCON | 0x3000_
| 0000 | src/rtl/ascon/ ascon_mmio.v 与变体 key_mmio.v | AEAD 寄存器；+0x80 起为 PUF 状态/控 制，HWKEY 默认关闭（§2.3.4）
CPI | 0x6000_

0000

cpi_cnt.v | 四组 64-bit 事件计数

MMIO 事务不进入 D-cache。当前 PUF3 显式选择 board/vivado_zynq7000_

xc7z020_pynq_puf3/ 下 rtl/soc_top.v 与 rtl/key_mmio.v 两个变体，并使用

src/rtl/ascon/ascon_mmio.v 的硬件 key 输入；旧 PYNQ release 的 rtl_p0 源集

（现隔离于 archive/history/board/vivado_zynq7000_xc7z020_pynq/rtl_p0/）不含该 通路，不能互换。

### 2.2.10 流水线控制与冒险处理

ctrl.v 输出两个 5 位向量 stall[4:0] 与 flush[4:0]，位序为 {IF, IF/ID, ID/EX,

EX/MEM, MEM/WB}，优先级由高至低如下表。

表 2-4 流水线控制事件优先级

顺序 | 事件 | ctrl.v 中的动作
1 | inter_req（外部中断）或 jump_trap_en （陷入，同一条件分支） | flush[3:1]；jump_sel = 10（中断／陷 入向量）
2 | jump_trap_out（mret） | flush[3:1]；jump_sel = 11（mepc）
3 | dcache_stall | stall[4:0] 全冻结
4 | dmem_axi_stall_req（store 等待总线） | stall[4:0] 全冻结
5 | ex_stall_req（多周期单元与 ISE） | stall[4:2]；flush[1]（EX/MEM 插气 泡）
6 | jump_en（分支重定向） | flush[3:2]（IF/ID 与 ID/EX）；jump_ sel = 01
7 | load_use_rs1 ／ load_use_rs2 | flush[2]（ID/EX 插气泡）；stall[4:3] （IF 与 IF/ID）
8 | icache_stall ／ fence_i_stall | stall[4:3]；flush[2]

表中次序为 ctrl.v 内 if-else 链的实际判定顺序，据此，D-cache 与数据总线停顿优先于 分支重定向，I-cache/fence.i 停顿位于 load-use 之后，中断与陷入同属首个条件分支。 该层为加速指令正确执行的关键：ISE 的多拍执行属第 5 项，陷入与中断属第 1 项；两者 叠加时以 “陷入优先、ISE 状态一并清零、不发布迟到结果” 为语义（§2.3.3.4）。

### 2.2.11 与加速及时序收敛相关的结构改造

表 2-5 与加速及时序收敛相关的结构改造

序号 | 改造内容 | 位置 | 动机
1 | 器件与工程迁移：Kintex-7 → Zynq-7020，重建 3 个 IP 与 1 个 XDC，PLL 由 50 MHz 倍频至 100 MHz | board/vivado_ zynq7000_xc7z020_ ascon/ | 早期工程的目标器件为 xc7k325t，与提交板卡不符
2 | D-cache 增加 MISS_CAPTURE
状态，miss 属性锁存一拍后
再发总线
dcache.v | 消除”miss 判定至总线请求” 的长
组合路径（11 个失败端点）
3 | store 与 MMIO 绕过 MISS_
CAPTURE，恢复单拍注册请求
dcache.v | MISS_CAPTURE 对不可 Cache 访
问仅增加延迟，据此回收周期代
价
4 | 乘法器输入与输出寄存器化，
并引入 mul_ack、cancel 握
手

mult.v、ex_stage.v 乘法器组合深度对应 48 个失败 端点、−0.105 ns

5 | ISE 状态寄存器改为局部复
位控件

src/rtl/ascon/
ascon_ise.v

全局复位扇出对应 93 个失败端
点、−0.128 ns
6 | 新增 Ascon MMIO 窗口与
ISE 指令；PUF3 增加
HWKEY 显式开关

src/rtl/ascon/、

board/
vivado_zynq7000_
xc7z020_pynq_puf3/
下 rtl/soc_top.v 与

rtl/key_mmio.v

三模式短消息加速与 PUF 功能
共存
7 | UART 起始位检测审计（d0
与 d1/d2）
uart_rx.v | 已记录同步链风险；未做错误概
率实测，不以估计数值判定无影
响

前五项与加速功能无直接关联，但决定该 SoC 能否在 100 MHz 收敛。第 4 章将说明：33 组策略扫掠将 WNS 自 −0.942 ns 提升至 −0.118 ns，而剩余 0.118 ns 须由上述结构改造回收。

### 2.3 硬件系统介绍

### 2.3.1 硬件整体介绍

当 前 入 口 为 | board/vivado_zynq7000_xc7z020_pynq_puf3/build.tcl，
top=pynq_puf3_wrapper、part=xc7z020clg400-1、Vivado 2025.2。PS7 GP0 连接两 个 AXI-Lite 窗口，FCLK0 配置为 100 MHz；proc_sys_reset 与控制窗口管理复位。 pynq_svc_puf.coe 作为 128 KiB BRAM 初值，板上不做动态固件装载。

源集采用 board/vivado_zynq7000_xc7z020_pynq_puf3/ 内的 rtl/soc_top.v、 rtl/key_mmio.v，其余 CPU、Ascon、keys 与 pynq 模块由 build.tcl 从 src/rtl/

选择；blk_mem_gen_0 与 axi_bram_ctrl_0 的 XCI 从 board/vivado_zynq7000_ xc7z020_ascon/ 中保留的配置导入；opt_design 前置 hook puf_opt_pre.tcl 调用共享的

build/keys_ro_allow_loops.tcl 确认 RO 环路，并按 BD 层次重建 pb_ro_puf。board/

vivado_zynq7000_xc7z020_pynq_puf3/candidate/中的 manifest 记录源哈希、排除文件 与工件；IP 版本另见 reports/context.txt。目录名仍为 candidate，本文按用户指定将其作为最 终演示版本，不据此改变其 PUF 未验收状态。构建时按 manifest 的 excluded_from_build 排

除共享目录中的同名 soc_top.v、keys/key_mmio.v 及 PL-only 顶层 top_pl_bram.v，不 能用旧缓存或其他 COE 替代。
历史 PL-only 基准使用 top_pl_bram、板外串口及 clk_wiz_0；它与当前 PS 时钟工程分 开保存。三套历史固件对应三份 bitstream，当前 PYNQ 则在同一 overlay 下按 mode 选择三

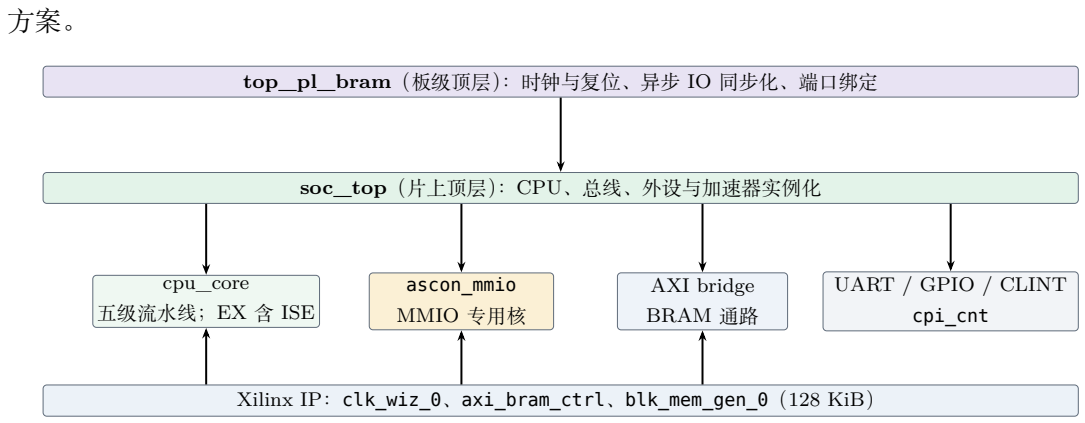
[picture p14: figure]
top_pl_bram（板级顶层）：时钟与复位、异步 IO 同步化、端口绑定; soc_top（片上顶层）：CPU、总线、外设与加速器实例化; cpu_core; 五级流水线；EX 含 ISE; ascon_mmio MMIO 专用核; AXI bridge; BRAM 通路; UART / GPIO / CLINT; cpi_cnt; Xilinx IP：clk_wiz_0、axi_bram_ctrl、blk_mem_gen_0（128 KiB）

历史 PL-only：const.xdc，50 MHz 输入与板外 IO；不作为当前 PYNQ 的约束

此图仅说明历史纯 PL 基准工程；三份 bitstream 各 4 045 687 B。
当前入口为 PUF3 的 build.tcl，顶层 pynq_puf3_wrapper，PS7 FCLK0 配置 100 MHz；源集与工件以 PUF3 candidate/manifest.json 为准。

图 2-6 历史 PL-only 工程结构

top_pl_bram 的板外时钟与串口入口，仅用于解释历史基准；当前 PS7/FCLK0/AXI-Lite 结构见 PS/PL 通 路图。

### 2.3.2 机械设计介绍

本作品为纯电子系统，不含机械结构与运动部件。板卡采用正点原子领航者 ZYNQ7020， 以底板与核心板装配。当前 PUF3 通过 PS 的 DDR/FIXED_IO、网口及 PYNQ 工作，不把 历史 PL-only 的 50 MHz 板外时钟、UART、按键与 LED 管脚作为当前 PL 顶层端口。PS 参 考晶振在 HWH 中为 33.333333 MHz；CPU 时钟来自 FCLK0，PL 内串口仅用于 mailbox 通 信。

### 2.3.3 电路各模块介绍

本节介绍三种密码实现和当前 PS/PL 接口；处理器核见 2.2 节。当前源集选择以发布 manifest 与 build.tcl 为准；同名源文件的其他变体不自动属于本次交付。职责、接口、测量范围与 验证边界分别说明，不以设计意图替代已取得的证据。

### 2.3.3.1 算法标准与参数定义

Ascon 的安全核心为 320 bit 状态 S = (s0, s1, s2, s3, s4)，每个分量 64 bit，认证加密通过” 吸收与挤出＋置换” 实现。AEAD128 的参数如下表。

表 2-6 Ascon-AEAD128 参数

参数 | 取值 | 本作品的处理
key | 16 byte / 128 bit | K0 取低 64 bit，K1 取高 64 bit
nonce | 16 byte / 128 bit | N0、N1 同理
tag | 16 byte / 128 bit | 完整输出，不截断
rate / capacity | 128 bit / 192 bit | 每块吸收 16 byte
初始向量 | 整数 0x0000_1000_808c_0001，字节串 01 00 8c 80 00 10 00 00 | 常量以位移式匹配
轮常量 | f0 e1 d2 c3 b4 a5 96 87 78 69 5a 4b
（第 0 至 11 轮）

P12 取前 12 个，P8 取后 8 个

域分离 | s4 ⊕= 2⁶³（0x8000_0000_0000_0000） | 于 AD 与 PT 之间插入

轮函数。第 i 轮先执行常量加与 S-box，再执行线性扩散：

s2 ⊕= ci

s0 ⊕= s4, | s4 ⊕= s3, | s2 ⊕= s1

t0 = s0 s1, t1 = s1 s2, t2 = s2 s3, t3 = s3 s4, t4 = s4 s0

s0 ⊕= t1, | s1 ⊕= t2, | s2 ⊕= t3, | s3 ⊕= t4, | s4 ⊕= t0
s1 ⊕= s0, | s0 ⊕= s4, | s3 ⊕= s2, | s2 = s2

线性层（rotr 表示 64 bit 循环右移）：

si ⊕= rotr(si

, ri,1) ⊕ rotr(si
, ri,2), (ri,1, ri,2) ∈ {(19, 28),(61, 39),(1, 6),(10, 17),(7, 41)}

AEAD 流程（加密方向）：

1. 初始化：S ← (IV, K0, K1, N0, N1)，S ← P

12(S)，s3 ⊕= K0，s4 ⊕= K1；
2. 关联数据：按 16 byte 分块吸收并执行 P

8；非空整块之后仍须追加一个空 padding 块并 再次执行 P

8；
3. 域分离：s4 ⊕= 2⁶³；

4. 明文：按 16 byte 分块挤出 Ci = Pi ⊕ (s0∥s1) 并执行 P

8；末块不足 16 byte 时先补 0x01
再补 0x00，末块不再置换；
5. 终结：s2 ⊕= K0，s3 ⊕= K1，S ← P

12(S)，s3 ⊕= K0，s4 ⊕= K1；
6. 标签：T = LE64(s3) ∥ LE64(s4)；密文与明文等长。

三种方案遵循的实现要点如下。完整 1,089 组 KAT 为 host 验证范围；当前板级三模式仅 验证容量内 289 组：

- padding 为” 追加字节 0x01 后补 0x00“，在 64-bit 字中表示为 1 ≪ (8n)，n < 8；
- AD 为空时既不吸收亦不 padding，但仍执行域分离；
- 整块 AD 与整块 PT 之后均须再经一个空 padding 块，不得以” 满块即结束” 处理；
- 长度须显式给出，不得由” 最高非零 bit” 反推（否则 00 与 a500 将判定错误）。

旋转常数：s0 : (19, 28)；s1 : (61, 39)；s2 : (1, 6)；s3 : (10, 17)；s4 : (7, 41)。 线性更新：si ← si ⊕ rotr(si, ri,1) ⊕ rotr(si, ri,2)。
轮常量为 8 bit，注入 s2 低字节；AEAD 的域分离 s4 ← s4 ⊕ 2

63 位于 AD 与消息之间。
AEAD IV：0x0000_1000_808c_0001；rate=128 bit，capacity=192 bit。 同一轮函数定义可以多次实例化，不意味着 MMIO 与 ISE 共享一块物理电路。

图 2-7 Ascon 置换数据通路

5 × 64-bit 状态、S-box 的五个与非项组合、线性层的五组双旋转与轮常量注入；标注 P12/P8 轮数差异及 ISE 内 320-bit 状态寄存器位置。

### 2.3.3.2 方案一：纯软件实现（SW）

软件实现为正确性基准，同时作为周期加速比的参照基准（SW cycles 位于分子）。生产

代码位于 ascon/ascon_c/aead/，锁定且不可修改的参考实现位于 sim/ascon/reference/ ascon_c/（ascon-c 固定 commit 446347f2）。
API 契约（C）：
- crypto_aead_encrypt(c, clen, m, mlen, ad, adlen, nsec, npub, k)：clen 含 16 byte tag；
- crypto_aead_decrypt(m, mlen, nsec, c, clen, ad, adlen, npub, k)：tag 拼 接于密文末尾，成功返回 0，且 *mlen = clen − 16；认证失败返回 −1，*mlen = 0， 并清除 m[0, clen−16) 范围内的候选明文；clen < 16 时返回 −1 且不写 m。

“认证失败须清除候选明文” 为项目验收要求，非 SUPERCOP 的强制项：原始 C 参考在 bad tag 时返回 −1，但缓冲区仍保留明文，且 mlen 等于明文长度。本作品修复生产 C 实现的 失败处理，并将” 原始 C 的真实 FAIL 行为” 作为保留证据，不予掩盖。
历史 PL-only 构建：以 xpack GCC 15.2.0、-O2 交叉编译裸机固件，链接至 0x10000000，

经 UART 输出结果。在 16 字节明文、warm 条件下，板上实测为 20806 周期。当前 PUF3 的固定输入加密中位为 21862 周期，见 §3.3.4.1；各组加速比仅使用同版本、同次运行的 SW cycles / 目标 cycles，不混用历史测量边界。

### 2.3.3.3 方案二：存储器映射加速器（MMIO ／ HW）

MMIO 实现将整个 AEAD 挂接于 0x30000000，CPU 承担参数搬运、状态轮询与结果读 取。当前接口取自 src/rtl/ascon/ascon_mmio.v；HWKEY 关闭时使用调用者 key，开启 时由 PUF3 的内部派生通路供 key。标准 KAT 与三模式 benchmark 均在 HWKEY 关闭时执 行。

表 2-7 MMIO 加速器寄存器

偏移 | 名称 | 读写 | 位定义与语义
0x00 | CTRL | W | [0] START（自清脉冲，仅空闲态接受）；[1] ENCRYPT（1 加密，0 解密）；[2] ZEROIZE（仅空闲 态接受，同一写中优先于 START）
0x04 | STATUS | R | [0] BUSY；[1] DONE；[2] FAIL（解密 tag 校验失败）
0x08 | ADLEN | W | AD 字节数
0x0C | MLEN | W | 消息字节数
0x10--0x1C | KEY | W | 四个小端序 32-bit key 字；key_hw_sel=1 时忽略写入， START 锁存硬件 key
0x20--0x2C | NONCE | W | N0 至 N3
0x30--0x3C | TAGIN | W | 解密时待校验的 tag
0x40 | AD_WDATA W | 推入一个 AD 字（内部指针自增）
0x44 | MSG_ WDATA | W | 推入一个消息字（加密为明文，解密为密文）
0x48 | OUT_ RDATA | R | 弹出一个输出字（加密为密文，解密为明文），指针自增
0x4C--0x58 | TAGOUT | R | 加密计算所得 tag

以下四项行为构成” 可用外设” 而非” 可计算模块” 的判据，须写入契约：

1. BUSY 期间全部写操作被忽略，包括 ZEROIZE、START、key/nonce、长度与输入缓冲；
2. 输出读门禁：OUT_RDATA 仅在 DONE && !BUSY && !FAIL 且未超出有效字数时返回数 据并推进指针，其余情形返回零且不推进。认证失败不得发布明文由硬件保证，不依赖软 件自觉；
3. ZEROIZE：清除 key、nonce、tagin、长度与状态，以及全部 AD、MSG、OUT 数组， 并经子核心复位清除适配器缓冲、s0..s4、候选明文与 P8/P12 私有副本。DONE 本身不 等于清理，取完结果后须显式清零；
4. 长度上限：硬件实际支持 AD 与消息各 0 至 16 byte（参数名 MAX_AD_BYTES=256 仅为

缓冲上限，不代表多块能力），超长请求显式返回 FAIL。该限制为 P0 的边界条件：板级 MMIO 周期加速比仅对 ≤16 byte 成立，正文不将其泛化为” 任意长度”。

延迟结构上，MMIO 调用周期由参数搬运、轮询往返与密码核本体组成。历史 PL-only 16 B 调用为 688 周期，核本体观测 103 周期；当前 PUF3 固定输入加密为 1369 周期。核外开 销的历史分解不直接套用到当前调用。AEAD ZEROIZE 不销毁独立 PUF 子系统中的 helper 或派生 key，二者生命周期须分别处理。

### 2.3.3.4 方案三：定制指令扩展（ISE）

ISE 将置换并入 CPU：320 bit Ascon 状态作为执行级的专用寄存器堆，由 4 条定制指令 访问。指令占用 RISC-V 预留的 custom-0 编码（0b0001011），未新造主操作码值，4 条指令 以 funct3 区分。

表 2-8 定制指令编码与语义

funct3 | 助记符 | 操作数 | 周期 | 语义
000 | ascon.w | rs1 为数据，rs2[3:0] 为索 引 | 1 | state[32*idx +: 32] = rs1
001 | ascon.rd | rs1[3:0] 为索引，rd 为结果 1 | rd = state[32*idx +:
| | | | 32]
010 | ascon.p12 | — | 多周期 | state = P12(state)
011 | ascon.p8 | — | 多周期 | state = P8(state)

状态映射固定为 10 个 32-bit 字：s0 低与高、s1 低与高，直至 s4。非法索引（不在 0 至 9 范围）读返回零、写被忽略；该行为属显式容错约定，不产生非法指令异常。保留 opcode 与 funct 编码的全局审计仍在待办之列，正文不声称已覆盖全部指令空间。 实现细节与生命周期如下：

- perm_start 为电平信号（指令位于 EX 且未完成期间保持有效），内部状态机对其打一 拍脉冲，完成后锁存结果；据此，流水线 hold 跨越完成不会导致重复执行；
- 取消：陷入与中断经 cancel 丢弃在飞操作并清零 ISE 状态，且不发布迟到结果；普通 分支冲刷仅清除较年轻指令，不影响已完成的置换；
- 局部复位寄存器化：P12/P8 的 1280-bit 私有复位扇出原挂接于全局复位的组合锥（93 个 失败端点、−0.128 ns），改为” 取消当拍清架构 state，下一拍清私有 s_reg/s_out“， 接受与 p_start 同拍释放局部复位，不增加正常执行的置换周期（§3.3.1）；
- 无上下文保存与恢复 ABI：陷入取消后不可自中间轮续算，调用者须串行独占或整体重 算。当前 bare-metal 自测不启用抢占，真实中断、多任务与嵌套调用下的恢复尚未验证；
- 软件封装：以 asm volatile 手写 intrinsic（不改动 GCC backend），逐字读写状态并调 用 P8/P12；软件侧 AEAD 循环与 MMIO 版本共用同一调用顺序与测试向量，故两版密 文与 tag 可逐字节比对。

历史 PL-only 16 B 加密为 2570 周期、相对同组软件 8.10×；当前 PUF3 固定输入为 3895

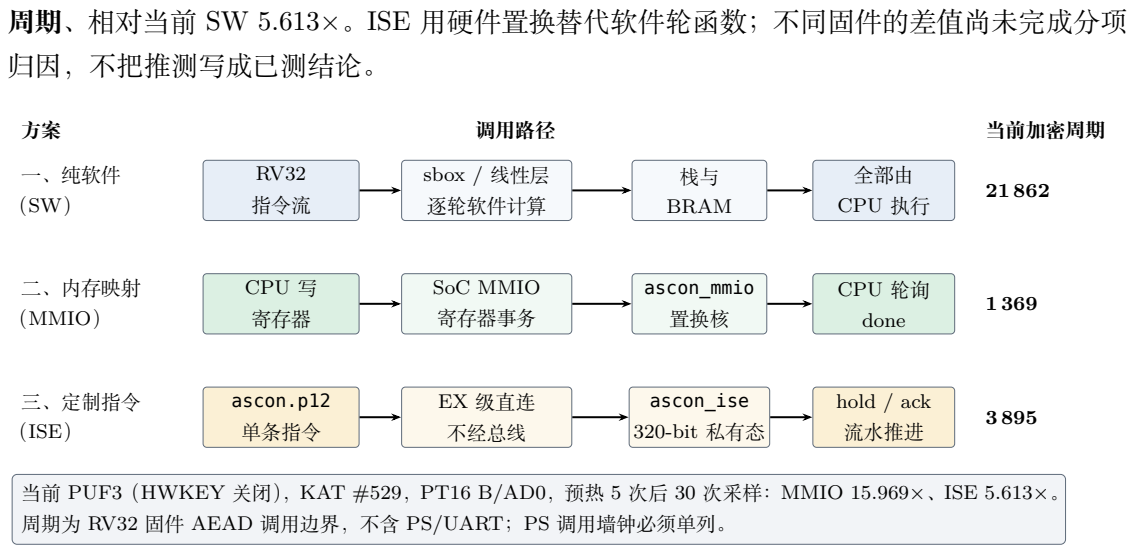
[picture p15: figure]
周期、相对当前 SW 5.613×。ISE 用硬件置换替代软件轮函数；不同固件的差值尚未完成分项; 归因，不把推测写成已测结论。; 调用路径; 当前加密周期; 一、纯软件; 指令流; sbox / 线性层; 逐轮软件计算; BRAM; 全部由; CPU 执行; 二、内存映射; （MMIO）; CPU 写; 寄存器; SoC MMIO; 寄存器事务; ascon_mmio 置换核; CPU 轮询; done; 三、定制指令; （ISE）; ascon.p12 单条指令; EX 级直连; 不经总线; ascon_ise 320-bit 私有态; hold / ack; 流水推进

当前 PUF3（HWKEY 关闭），KAT #529，PT16 B/AD0，预热 5 次后 30 次采样：MMIO 15.969×、ISE 5.613×。 周期为 RV32 固件 AEAD 调用边界，不含 PS/UART；PS 调用墙钟必须单列。

图 2-8 三种实现的调用路径对比

SW（全部于 CPU 内完成）、HW（CPU 经寄存器搬运至加速器并轮询）、ISE（CPU 直接执行 custom-0，状 态位于 EX 级）；标注三者的数据搬运量与关键延迟分项（搬运、轮询、算法本体）。

### 2.3.3.5 三种方案的可比性边界

表 2-9 三种方案的可比性边界

维度 | SW | MMIO（HW） | ISE
数据通路 | 全部于 CPU 内逐字运 算

CPU → MMIO 总线 → 专用核 CPU EX 级内，状
| | | 态寄存器
单次 AEAD 的 CPU 动作 | 纯计算 | 写 key/nonce/AD/msg/len → START → 轮询 STATUS → 读 OUT/TAG | 写状态 → P8/P12 → 读状态
当前 PUF3 加密周 期（KAT #529） | 21862 | 1369 | 3895
当前周期加速比 （相对 SW） | 1.000× | 15.969× | 5.613×
当前服务长度能力 | PT/AD 各 ≤16 B | PT/AD 各 ≤16 B | PT/AD 各 ≤16 B
主要成本 | CPU 软件运算 | 寄存器与窗口逻辑、轮询开销 | 指令译码、状态搬 运与 EX 级多周期
面积统计 | 三模式共同占用的整机 资源；不拆分独立面积 | 同左 | 同左
时序关注点 | CPU/Cache 公共路径 | 外设控制、轮询与完成路径 | EX 级 hold 与状态 复位扇出

续表 2-9

维度 | SW | MMIO（HW） | ISE
当前使用方式 | 正确性与周期基线 | CPU 搬运参数并主动轮询，短 消息加速 | 软件 AEAD 控制流 与硬件置换紧耦合

上述结果不宜读作” 性能强弱排序”，而应理解为两条技术路线的取舍：MMIO 的周期加速 比更高，但其能力受 16 byte 寄存器窗口与轮询开销约束，且 CPU 在轮询期间不可用；ISE 的 周期加速比相对较低，然其状态位于流水线内，无 MMIO 总线往返，但当前服务仍统一受 16 B 长度限制。三者置于同一 SoC、同一套向量与同一块板上测量，方能为该取舍提供实测依据。

证 | 据 archive/history/docs/ascon_key_management.md； report/design/ascon_standard_

baseline.md； src/rtl/ascon/ascon_mmio.v； src/rtl/ascon/ascon_ise.v。
当前采样来源为 data/pynq_puf3/notebook_20261031_114512/result.json。

### 2.3.3.6 PS/PL 数据通道方案论证

任务书初稿拟定的方案为”AXI-Lite 控制寄存器 + 共享 BRAM”。查证冻结 RTL 后，该 方案在不修改 src/rtl 的前提下不可成立，依据如下：

表 2-10 PS/PL 数据通道选择依据

证据 | 位置 | 后果

外设访问全部在 bus_
interconnect 内部译码（clint、
uart、gpio、cpi、ascon），无通向
PL 边界的 MMIO 出口
| | src/rtl/bus_ interconnect.v | 若为 CPU 增加 PS 可见寄存器窗 口，必须修改该文件

仅 0x1000_0000 至 0x100F_FFFF 被判为可 Cache

src/rtl/dcache.v 共享 BRAM 必落于该窗口内，PS 写入后 CPU 可能读到旧 Cache 行

无 D-cache 失效或清洗指令（仅
fence.i 触发 I-cache 冲刷）
src/rtl/cpu_core.v、 dcache.v | 固件无法在两次事务之间保证一致 性，volatile 与 fence 不足以替 代

历史 P0 时序余量为 WNS +0.087
ns
archive/history/ docs/freeze_ checkpoint_ 20261027.md §4 | 改动公共路径需重新验证；采用独 立 PYNQ 工程控制变更范围

据此，本作品采用” 以既有 UART MMIO 作为 PS/PL 数据通道” 的方案：在 PL 内新增

pynq_mbox.v 实现串口的另一端，字节经 uart_tx 送入 SoC 的 uart_rxd，SoC 的 uart_ txd 经 uart_rx 收入 RX FIFO 供 PS 读取。该方案具备四项性质：

1. 独立发布源集：历史 PL-only 证据保留，当前 BD 与桥接 RTL 单独构建并验证；
2. UART 属不可 Cache MMIO，当前无 PS/RV32 共享可缓存 buffer，缓存可见性记为 N/A， 不泛化为所有架构均无一致性问题；

3. 同一份服务固件既可运行于 P0 纯 PL 版本（接真实 UART 引脚），亦可运行于 PYNQ 版本（PS 为对端），仅需维护一条代码路径；
4. 代价为延迟与带宽：PUF3 链路为约 6.25 Mbaud（BAUD_CNT_MAX=16，100 MHz 分频）， 8N1 每字节约 1.6 µs。理论字节时间不等于 PS 调用墙钟。固定 KAT #529 的实测中位 为 4.137–5.130 ms，包含 Python、MMIO 与 UART。固件 AEAD 周期不含串口，须 与墙钟分列。

### 2.3.3.7 结构与寄存器定义

Jupyter (Python)
└─ AsconHost → MailboxBackend → PynqPuf3Transport（PUF3 Notebook 内）
│ pynq.MMIO × 2（GP0，各 4 KiB）
├─ CONTROL 0x4000_0000 ── pynq_ctl.v ：SOC_RESET / BUTTON / STAT(LED, RST) / ID └─ MAILBOX 0x4000_1000 ── pynq_mbox.v ：TX FIFO（64）─uart_tx─┐
│ PL 内部，不经引脚
RX FIFO（256）─uart_rx──┐ | │
▼ | ▼
SoC uart_rxd / uart_txd（PUF3 变体源集） cpu_core + dcache + uart_ctrl（0x2000_0000） └─ SW ／ MMIO ／ ISE + PUF/HWKEY

CONTROL 窗口（pynq_ctl.v，AXI-Lite 32 bit，遵循 WSTRB[0]）：

表 2-11 CONTROL 窗口寄存器

偏移 | 名称 | 读写 | 位定义
0x00 | CTRL | RW | [0] SOC_RESET（1 保持 RV32 复位，上电默认 1）；[3:2] BUTTON[1:0] 透传至 SoC GPIO
0x04 | STAT | RO | [0] SOC_RST_N（送给 SoC 的复位，1 为运行）；[3:2] LED[1:0] 回读
0x08 | ID | RO | 0x3346_5150（”PQF3”，小端）；区别于旧版 PYNQ ID
0x0C | VERSION | RO | 0x0000_0001

复位约定为：CTRL[0] 上电置 1（SoC 保持复位），PS 确认链路可用后写 0 释放；释放信 号经三级同步器进入 SoC 时钟域。
MAILBOX 窗口（pynq_mbox.v，TX 深度 64、RX 深度 256）：

表 2-12 MAILBOX 窗口寄存器

偏移 | 名称 | 读写 | 含义
0x00 | TXDATA | W | [7:0] 压入一字节；FIFO 满时延迟写响应
0x04 | RXDATA | R | [7:0] 弹出一字节；空时读 0 且不弹出
0x08 | TXSTAT | R | [15:0] 深度；[16] 满；[17] 空

续表 2-12

偏移 | 名称 | 读写 | 含义
0x0C | RXSTAT | R | [15:0] 深度；[16] 满；[17] 空；[18] 溢出（粘滞）
0x10 | RXCLR | W | [0] 清溢出标志
0x14 | TXFLUSH | W | [0] 清空 TX FIFO
0x18 | CNT | R | [15:0] PS 已压入字节数；[31:16] 已接收字节数（16-bit 回
绕）
0x1C | ID | R | 0x4D42_4F58。小端读出 58 4F 42 4D（”XOBM”），大端
为”MBOX”；与 CONTROL 的小端”PQF3” 编码方向相反， 按 RTL 现状记录

link_flush（由 CONTROL 的 SOC_RESET 驱动）为高时清空两侧 FIFO 与计数，保 证每次 SoC 复位后链路回到确定状态。

### 2.3.3.8 服务协议与服务固件

AEAD 字节流沿用 src/pynq/mailbox_protocol.py 的四类帧；PUF3 另增加 Y01P/Y01K：

表 2-13 服务帧类型

帧 | 长度 | 方向 | 用途
Y01Q | 48 B 头 + key16 + nonce16 + AD
+ data + tag

PS → PL AEAD 请求

Y01R | 48 B 头 + payload | PL → PS AEAD 响应
Y01S | 64 B | PL → PS 开机与 epoch 应答：固件标识、能力上
限、自检结果、boot mcycle
Y01E | 20 B | PS → PL PS 下发会话 epoch
Y01P | 16 B | PS → PL PUF 状态、注册、重建和 HWKEY 开
关命令
Y01K | 112 B | PL → PS PUF 状态、诊断量、op_mcycle；末 8
B 为发帧时刻 mcycle

请求头字段依次为：magic（Y01Q）、version、flags、epoch（u64）、request_id（u64）、 operation （1 加密 / 2 解密）、mode（1 SW / 2 HW / 3 ISE）、adlen、dlen、output_capacity、 taglen；响应头为 magic（Y01R）、version、flags、epoch、request_id、status、operation、mode、

size、cycles。状态码为 OK、AUTH_FAILED、LENGTH、UNSUPPORTED、INTERNAL；响应 flags 中 SIMULATED 位在真实硬件执行时恒为 0，CYCLES_VALID 位指示周期字段是否有效。协议约束 为：失败响应不得携带数据与周期；key 与 nonce 长度须为 16；解密请求须携带 16 字节 tag。

服务固件 pynq-svc-puf3（src/firmware/pynq_svc_puf/）具备以下设计特征：

- 单槽串行：一次仅处理一个请求，响应发完后回到帧同步状态，故 PS 侧无需额外 ACK 线；
- 周期口径：仅在 AEAD 调用边界读取 64-bit mcycle（0xB00/0xB80，hi-lo-hi 一致读取）， 不含串口传输时间；
- 能力上限：message 与 AD 各 16 字节，超长请求立即拒绝并返回 LENGTH；
- 构 建：src/firmware/pynq_svc_puf/build.py | 使 用 | GCC | 15.2.0、
RV32IM_Zicsr/ilp32、-O2；反汇编检出 22 条 custom-0 静态编码，其中 P12 为 1

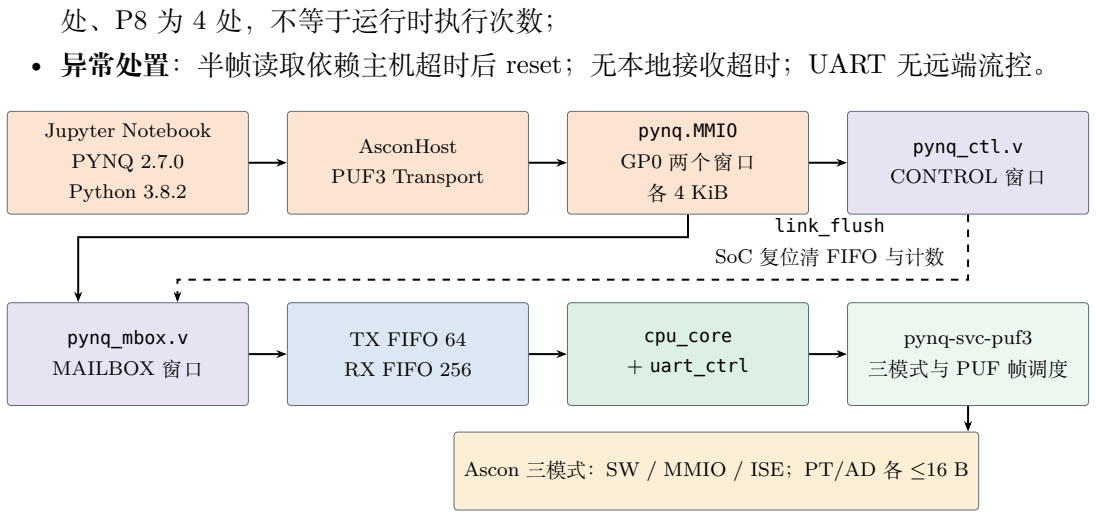
[picture p16: figure]
处、P8 为 4 处，不等于运行时执行次数；; • 异常处置：半帧读取依赖主机超时后 reset；无本地接收超时；UART 无远端流控。; Jupyter Notebook; PYNQ 2.7.0; Python 3.8.2; AsconHost; PUF3 Transport; pynq.MMIO GP0 两个窗口; 各 4 KiB; pynq_ctl.v CONTROL 窗口; pynq_mbox.v MAILBOX 窗口; TX FIFO 64; RX FIFO 256; cpu_core; + uart_ctrl; pynq-svc-puf3; 三模式与 PUF 帧调度; Ascon 三模式：SW / MMIO / ISE；PT/AD 各 ≤16 B; link_flush SoC 复位清 FIFO 与计数

帧格式（src/pynq/mailbox_protocol.py 与服务固件共同实现）：Y01Q 请求、Y01R 响应、Y01S 自检与 boot mcycle（64 B）、Y01E 会话 epoch（20 B）。新增 Y01P/Y01K 为 PUF 请求/响应（16/112 B）。ID 寄存器： CONTROL 0x3346_5150（小端读出“PQF3”）；MAILBOX 0x4D42_4F58（小端读出“XOBM”，按大端字 节序为“MBOX”，与 CONTROL 编码方向相反，按 RTL 现状记录）。板上官方容量内 KAT 与坏 Tag 拒绝各 289/289；固定 #529 的 warm 加密中位 SW/HW/ISE 为 21 862 / 1 369 / 3 895 周期；PUF 会话内重建 5/5。旧 release 的 9/9 门禁另列。

图 2-9 PS/PL 协同通路结构

Jupyter → Python API → 两个 AXI-Lite 窗口 → PL 内 UART 桥 → RV32 服务固件 → SW/MMIO/ISE； 标注时钟域（FCLK0 100 MHz）、FIFO 深度与帧格式。

### 2.3.3.9 Overlay 构建与时序签核

Overlay 由 PUF3 的 build.tcl 创建独立工程 pynq_puf3.xpr 与同名 Block Design。PS7 GP0、FCLK0=100 MHz、复位和两个 AXI-Lite 窗口连接如图 2-10。实现 策略为 Performance_ExtraTimingOpt 加布线后 phys_opt。board/vivado_zynq7000_

xc7z020_pynq_puf3/candidate/的 pynq_puf3.bit 为 4,045,693 B，pynq_puf3.hwh 为 158,472 B；BRAM MIF 与 pynq_svc_puf.coe 的 32768 个字一致（128 KiB 含补零）。

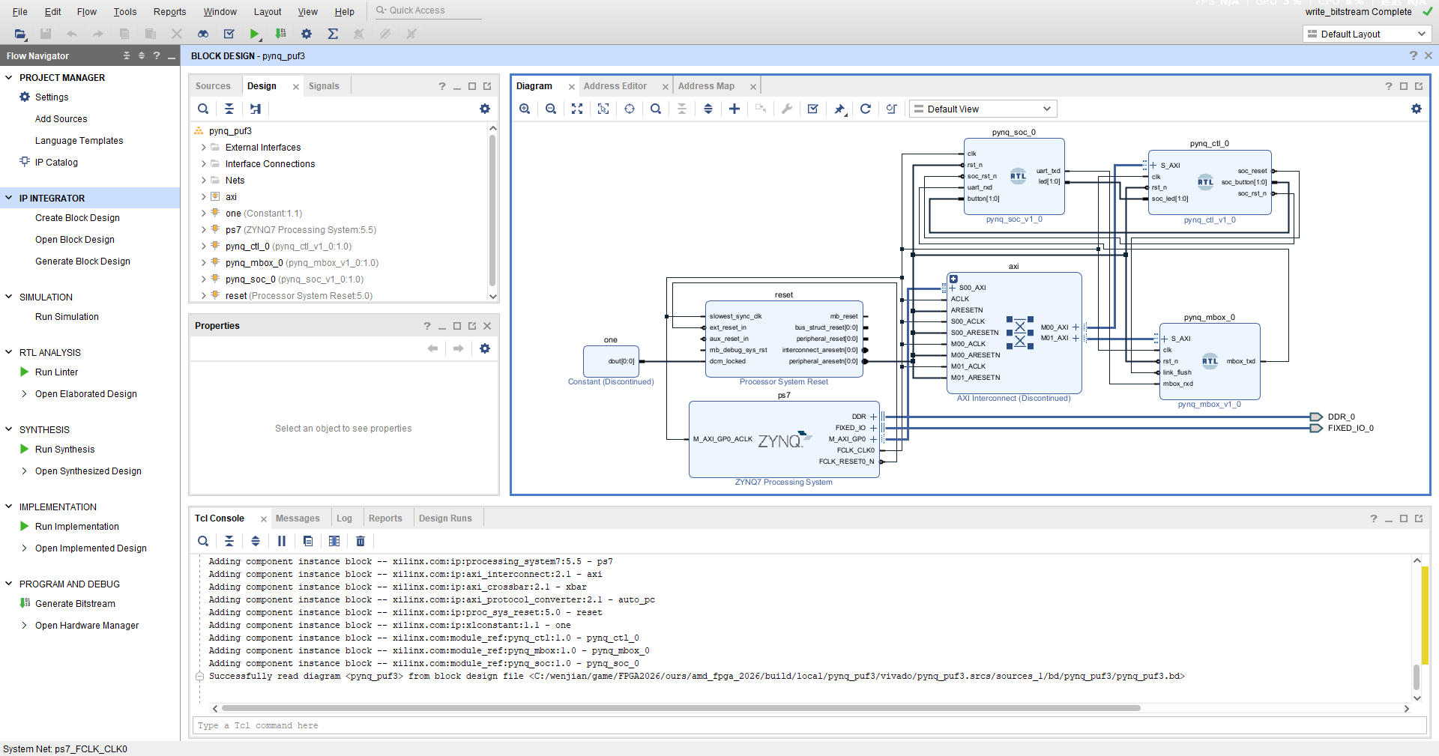
[picture p17: figure]

图 2-10 PUF3 的 Vivado Block Design

用户提供的真实截图，工程名 pynq_puf3；PS7 GP0 经 AXI Interconnect 连接控制/邮箱窗口，UART 在 PL 内部接至 SoC。DDR 与 FIXED_IO 已引出；与当前 build.tcl/HWH 结构对应。

时序与实现结果（100 MHz 约束，2026-10-30 的 PUF3 布线后报告）：

表 2-14 Overlay 时序与实现结果

指标 | 数值 | 判据
WNS / TNS | +0.104 ns / 0 | 已约束路径 setup 失败端点 0/73907
WHS / THS | +0.041 ns / 0 | 已约束路径 hold 失败端点 0/73907
未约束检 查 | no_clock=5120；未约束最大延迟引脚 =15360；组合环 =256 | 属 RO 振荡环计数器；不得宣称全域签核
DRC / methodol- ogy | DRC 0 Error / 0 Critical Warning；报 告列 824 项 Warning | methodology 另有 TIMING-17 Critical Warning 1000 条；不能与 DRC 混同
整机资源 | LUT 18674、FF 32002、BRAM 34.5 tile、 DSP 4 | PUF3 utilization.rpt；含完整 PUF 子系统

时序分三块报告：CPU/Ascon/总线的 clk_fpga_0 为 +0.104/+0.041 ns；25 MHz 的 ro_clk 为 +24.822/+0.115 ns，双向跨域路径也为正。256 路 RO 振荡环计数器在 Slow/Fast 角的最差 setup/hold 分别为 −0.478/−0.552 与 −0.598/−0.427 ns，尚未签核。1280 个 RO LUT 均分配 到 pblock，但 pblock 为 soft，仅 440 个实际放在区域内。原件见 board/vivado_zynq7000_

xc7z020_pynq_puf3/candidate/reports/。

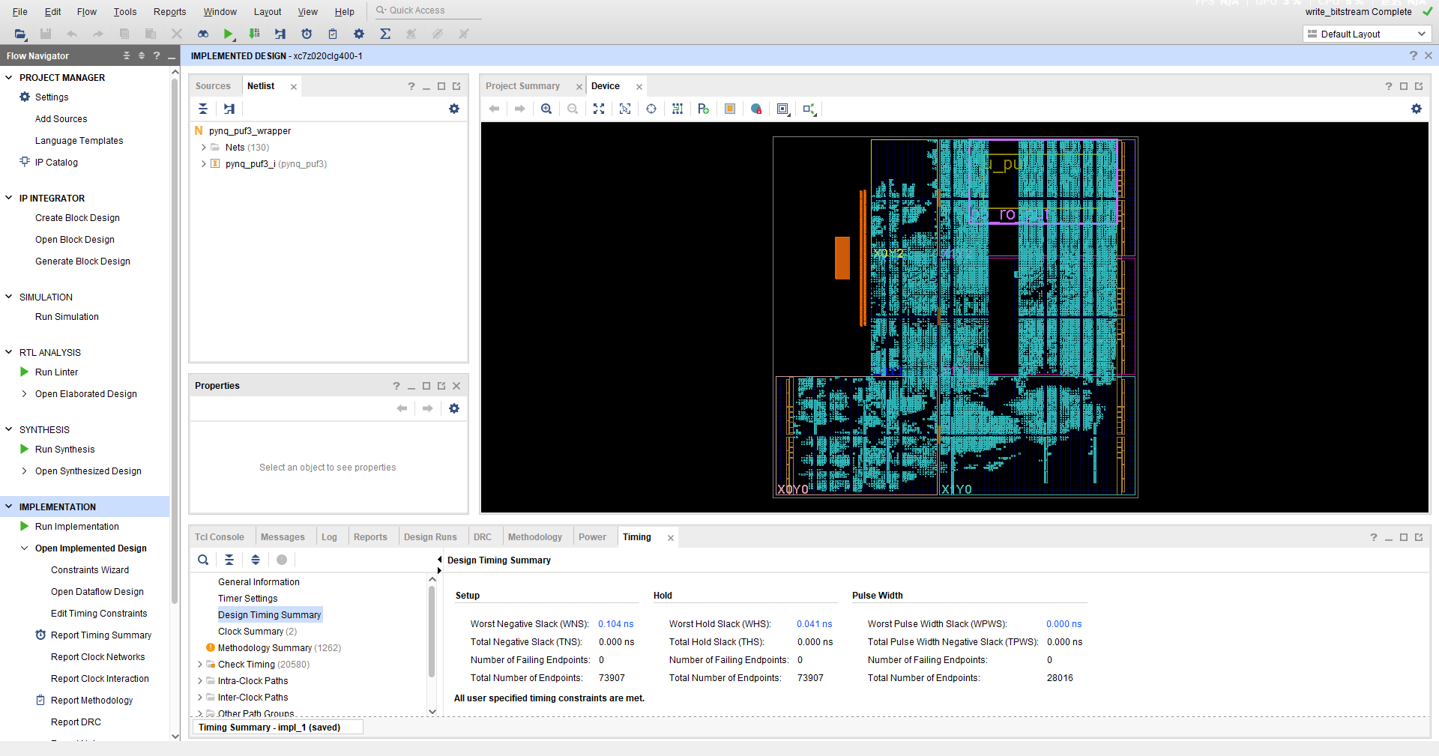
[picture p18: figure]

图 2-11 PUF3 实现后器件视图与时序摘要

用户提供的真实截图，top=pynq_puf3_wrapper、part=xc7z020clg400-1；界面 WNS +0.104 ns、WHS +0.041 ns 与报告一致。界面“All user specified timing constraints are met”仅针对已约束路径；RO 计数器域未签 核。

### 2.3.3.10 验证结果与板上实测

仿真与主机侧验证：下表前九项为旧 PYNQ release 的 10-28 基础验证，不视为 PUF3 全 量重跑；末两项为 PUF3 自身的固件构建和联合仿真，见 candidate/reports。前四项测试与

golden_checker.py 仍在 src/pynq/；run_bridge.py、run_service.py 属旧 release 验 证工具，现随历史工程隔离在 archive/history/sim/pynq/，其中旧相对路径按当时布局解 读，不作当前复现命令。

表 2-15 仿真与主机侧验证

验证项 | 内容 | 结果
test_host_api.py | 17 项，含历史 Notebook 顺序执行 | PASS
test_mailbox.py | 24 项协议编解码与错误分支 | PASS
test_navigator.py | 8 项 | PASS
test_pynq_transport.py | 14 项，含 real-service 标志回归 | PASS
golden_checker.py | 1,089 组官方 KAT、4,290 次拒绝（host 范围） | PASS
run_bridge.py | 真实桥 RTL：双向传输、空读、WSTRB、RX 满与溢出、 顺序读回、复位中止发送 | PASS
run_service.py | 真实 CPU + 最终固件 + AXI-Lite/UART + 行为级 AXI 存储；三模式 36 请求（加密/解密/坏 tag），检查 mcycle 非零；半帧复位后重新握手 | PASS
固件构建 | RV32IM_Zicsr/ilp32，24 条 custom-0，P12/P8 存在 | PASS

续表 2-15

验证项 | 内容 | 结果
镜像一致性 | Vivado BRAM MIF 与最终 BIN 逐字节比较（128 KiB 含 补零） | PASS
PUF3 固件构建 | GCC 15.2.0；22 条 custom-0；P12 1 处、P8 4 处； MIF/COE 32768 字一致 | PASS
PUF3 联合仿真 | normal 54 步通过；原自动锁定 RTL 的 mutant_autolock 反例被检出；RO/DNA 为行为模型 | PASS

PUF3 板上结果（10-31，领航者 ZYNQ7020，PYNQ 2.7.0，Python 3.8.2）：overlay 加

载与 PQF3 ID 检查通过；服务为 pynq-svc-puf3、simulated=false、selftest_mask=7，

PT/AD 上限各 16 B。data/pynq_puf3/notebook_20261031_114512/result.json 的总 状态为 PASS、exit_code=0，绑定 bit/hwh/manifest 哈希。
PUF3 在 message 与 AD 各 0 至 16 字节的全部 289 组组合上，SW/HW/ISE 各完成加 密、正确解密与坏 Tag 拒绝。该结果只保存各用例编号及通过计数，没有逐 KAT 周期数组。 下表保留 10-28 旧 release 的全长度周期统计作为历史对照，不作为 PUF3 性能；PUF3 固定 输入原始周期见表 3-13。

表 2-16 历史 PYNQ release 容量内 KAT 周期统计（非 PUF3）

模式 | 加密 KAT | 错误 Tag 拒
绝
周期最小值 | 周期均值 | 周期中位数 | 周期最大值
SW | 289/289 | 289/289 | 17584 | 23801.7 | 23543 | 33595
HW | 289/289 | 289/289 | 1229 | 1589.0 | 1594 | 1797
ISE | 289/289 | 289/289 | 3012 | 4122.0 | 4137 | 5209

上表的历史均值之比约为 SW/HW 15.0×、SW/ISE 5.8×，不是逐条加速比的均值。它覆 盖不同长度组合，不能与固定 #529 的 PUF3 warm 结果或 PL-only 的 20806/688/2570 周期 直接比较。不同源集、编译器与调用边界的周期差尚未完成分项归因。
证据身份：表 2-16 对应旧 release 的 bit 6e7f9320…/hwh 3ebd2640…，来源

data/pynq/board_20261028/pynq_board_full.json。当前 PUF3 对应 bit 769ed24c…

/hwh 4a0e7b95…，其数据以 data/pynq_puf3/notebook_20261031_114512/result.json 为准，不以旧版数值补缺。
10-31 PUF3 benchmark 与 Notebook：官方 KAT #529、PT=16 B、AD=0， 每模式预热 5 次后各 30 次加密/解密，全部 KAT 匹配。原始 cycles 数组与墙钟
摘 要 在 | data/pynq_puf3/notebook_20261031_114512/result.json； 已 执 行 本 体 为
src/pynq_puf3/pynq_puf3_board_test.ipynb。墙钟只归档 | summary，未保存逐次
raw_wall_ns，不能声称已从其原始数组复算中位数。
旧 release 的 V03 错误恢复（10-31 归档）：9/9 checks、7/7 reset，epoch 1→8；17 B 长度、半帧、过期 deadline、重复 ID、错误 epoch、RX overflow 与每模式 50 次加解密均有证

据，目录为 data/pynq/error_gate_20261031_112812/。它绑定 pynq-svc-v1，不能移作 PUF3 已测；当前 PUF3 额外错误恢复矩阵为 NOT_RUN。过期 deadline 用例也不证明硬件 永久卡死可自动恢复。

PUF3: pynq-svc-puf3, simulated=false, selftest_mask=7 PT/AD capacity: 16 B each
Official capacity KAT: SW / HW / ISE = 289 / 289 / 289 PASS Bad Tag rejection: SW / HW / ISE = 289 / 289 / 289 PASS

KAT #529, PT16 B / AD0, warmup=5, samples=30 each encrypt cycles (median): SW=21862, HW=1369, ISE=3895 decrypt cycles (median): SW=22562, HW=1213, ISE=4288 encrypt PS wall ms: SW=5.130, HW=4.403, ISE=4.385

PUF quality=127; reconstructs_stable=5; HWKEY restore PASS FCLK0 via mcycle/PS: 99.9723 MHz; RO timing NOT signed off Source: data/pynq_puf3/notebook_20261031_114512/result.json (JSON summary, not a screenshot; HWKEY off during benchmark)

图 2-12 PUF3 板测数据重排

容量内 KAT、固定输入 warm benchmark 与 PUF 会话内流程，取自 10-31 归档 JSON，不是原始终端截图 或 Python 调用示例。

### 2.3.3.11 未闭环项

表 2-17 PYNQ 通路未闭环项

项 | 状态 | 说明
超出容量的 800 组板上用例 | NOT_RUN / 当前接 口不支持 | 全量 host 已通过，不列为本次新增功能承诺
warm benchmark 执行 Notebook 本体 | 已归档 | src/pynq_puf3 的板测 Notebook 含执行输出
小时级与资源泄漏 | not_measured | 30 次固定输入采样不等于小时级 RSS/FD 统 计
协议错误与恢复 | PUF3 完整矩阵 NOT_RUN | 9/9 属旧 release；当前无共享 cacheable buffer
重复断电上电稳定性 | not_measured | 需冷启动与每次 smoke，软件 reset 不等于断 电
FCLK 的 mcycle/PS 时基测 量 | 已测约 99.9723 MHz | 约 3 秒间隔估测；不是示波器测量或 Fmax
RO 计数器时序 | 未签核 | Slow/Fast 角存在负 setup/hold slack
硬件轮询超时的错误语义 | [待完善] | 当前可能表现为内部失败或解密认证失败； 异常时整链 reset 后重测，不作为认证性能数 据

证据 archive/history/board/vivado_zynq7000_xc7z020_pynq/validation_20261028.md；archive/

history/board/vivado_zynq7000_xc7z020_pynq/validation_20261029.md；data/pynq/board_

20261028/pynq_board_full.json；data/pynq/notebook_20261031_112052/；data/pynq/error_gate_

20261031_112812/

### 2.3.4 PUF3 集成的 RO-PUF 与器件绑定通路

当前最终演示版本 PUF3 已将 RO 采样、注册、重建判定、派生与 MMIO 硬件 key 选择 接入同一 overlay。它与不含 PUF 的旧 PYNQ release 是两个源集。以下保留 PL-only 原型的 研制记录，并给出 10-31 当前板测；功能接入不等于产品级硬件信任根或安全启动验收。

### 2.3.4.1 架构与已实现代码

src/rtl/keys/ 包含 device_dna、ro_unit、ro_puf_core、puf_key 和 key_mmio。256 路 RO 经计数、两两比较及多次表决产生 128-bit 响应；注册保存参考响应与掩码，重建将当 前响应的掩码位与参考比较。Device DNA 提供 57-bit 器件标识，不是秘密熵源。 派生通路将固定上下文、响应及 DNA 组成 320-bit 状态，执行 P12 后取低 128 bit 作为 key。这是自定义置换派生原型，不是 NIST 对该 KDF 构造的认证或安全证明。key 寄存器没 有 CPU 读地址，内部连接 ascon_mmio。PUF3 将选择逻辑改为 key_hw_sel = hwkey_on & key_have；复位关闭，key_mmio 的 CTRL(+0x84)[3]/[4] 打开/关闭，OFF 优先，STA-TUS(+0x80)[6]/[7] 回读实际选择/请求。标准 KAT 与 benchmark 使用调用者 key，随后才单 独验证 PUF key。HWKEY 不改变 SW/ISE 的 key 来源。

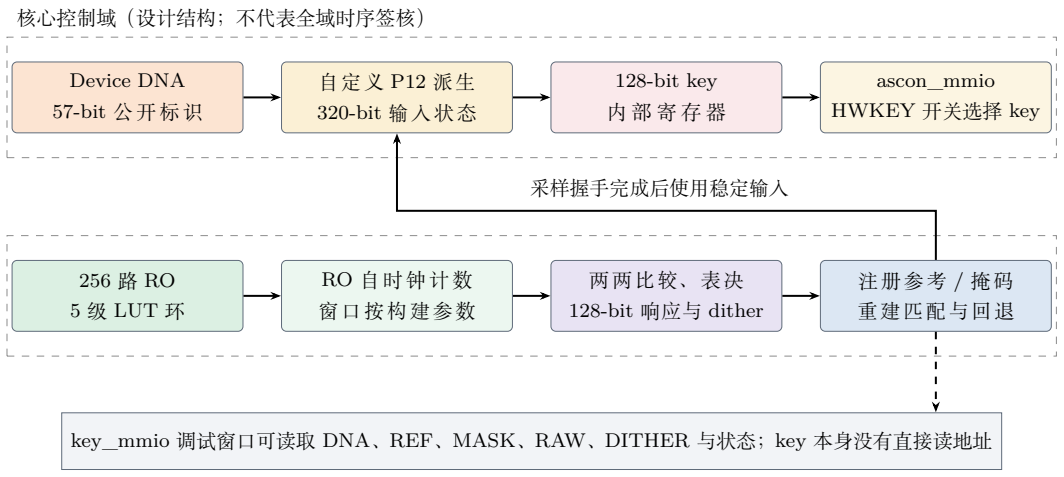
[picture p19: figure]
核心控制域（设计结构；不代表全域时序签核）; Device DNA; 57-bit 公开标识; 自定义 P12 派生; 320-bit 输入状态; 128-bit key; ascon_mmio; HWKEY 开关选择 key; 5 级 LUT 环; RO 自时钟计数; 窗口按构建参数; 两两比较、表决; 128-bit 响应与 dither; 注册参考 / 掩码; 重建匹配与回退; 采样握手完成后使用稳定输入; key_mmio 调试窗口可读取 DNA、REF、MASK、RAW、DITHER 与状态；key 本身没有直接读地址

当前 PUF3 已集成此通路；quality=127/128，连续 5 次会话内重建及 HWKEY 开关通过。 派生输入可由调试窗口读取，不能仅凭 key 无读地址声称保密隔离。 跨上电、温压与多器件可靠性未测；RO 振荡环计数器域未签核，不声称完整安全启动。

图 2-13 PUF3 内的 RO-PUF/DNA 密钥原型

RO 阵列、计数与表决、参考和掩码、DNA 与 P12 派生、128-bit 内部 key；HWKEY 显式选择，调试回读 与未签核计数器域保留说明。

### 2.3.4.2 实板观测与失败保留

证据为 data/ascon/results/board/uart_20261027_keys3.txt 及对应 XDat（原件

归档于 archive/evidence/raw_records_20261102.zip，可按 §3.4.1 恢复）。同一文件含 两个版本片段，必须区分：

表 2-18 实板观测与失败保留

片段 | 原始状态 | 可以支持的结论
v2 抢跑片段 | busy 时启动，出现 quality=0，后续 127， 最终 FAIL | 不能把该 127/128 当作正式通过结果
v3 先等 idle | enroll=0x00008026，quality=128；MASK 全 1、DITHER 全 0、REF=RAW | 此次注册 128/128 位通过该采样判据
v3 reconstruct status=0x00008026；固件输出 PASS | 同次上电注册后，重建状态未报告
| | mismatch/fallback

固件 keys_rv32/main.c（PUF 原型自检固件，现位于 archive/history/src/ firmware/keys_rv32/）的 PASS 检查的是 ready、mismatch 与 fallback 状态，并未在这 份板级日志中直接比较两次秘密 key，也没有以派生 key 完成 AEAD Tag 验证。因此 “同次注 册/重建自检通过” 成立，“跨上电同密钥稳定” “认证启动通过” 不成立。

### 2.3.4.3 安全与实现边界

当前 key_mmio 可回读 REF、MASK、RAW 与 DNA，puf_key 的派生上下文和算法也可 见。因此仅有 “key 寄存器不可直接读取” 不足以证明软件无法重算派生值；本版应称为可观测 的密钥生成实验原型，不能称为已经实现密钥保密隔离。无 helper 或匹配失败时的 DNA-only 回退也不提供秘密密钥保证。
历史 PL-only 扩展源集曾记录 no_clock=10944、未约束内部端点 =27312，不能套用到 PUF3。当前 PUF3 为 5120 个无时钟引脚、15360 个未约束最大延迟引脚、256 个组合环；采 样控制时钟 ro_clk 已声明，但振荡环计数器仍有负 slack。跨上电、温压、多器件唯一性及小 时级稳定性继续未测。
10-31 最终演示版本 PUF3 板测。 data/pynq_puf3/notebook_20261031_114512/
result.json | 及 同 目 录 | mailbox_log.txt | 对 应 已 执 行 的 | src/pynq_puf3/

pynq_puf3_board_test.ipynb。bit 哈希前缀为 769ed24c，区别于旧 release 的 6e7f9320。 三模式各通过 289 组容量内 KAT 与 289 次坏 Tag 拒绝；注册 quality=127/128，未注册启用 硬件 key 返回 NO_PUF_KEY，连续 5 次 reconstruct 稳定；HWKEY 开启后调用者 key 的 官方密文被拒，PUF key 往返成功，重建后密文一致，关闭后 KAT 恢复。
当前 PUF3 固定输入加密中位 SW/HW/ISE 为 21862/1369/3895 cycles，解密为 22562/1213/4288；加密加速比 15.969/5.613，解密 18.600/5.262，与摘要、表 1-1 和表 3-13 采用同一记录。HWKEY 开启的单次 HW 加密另记 1676 cycles，不混入上述官方 KAT benchmark。

本轮使用约 3 秒的 mcycle 与 PS 单调时钟间隔估测 FCLK0 为 99.9723 MHz，寄存器推 导为 99.999999 MHz。PYNQ Clocks 的 150 MHz 显示使用了 50 MHz 参考时钟假设，不能直 接当作实际频率。此估测不是示波器或 Fmax 测量，也不能移作旧 release 的独立频率验收。记

录仍明确 timing_signoff_ro_domain=false、cross_power_cycle=not_measured；跨断 电、熵、BER、温压与唯一性继续未测。
PUF3 中的密钥通路作为已实施的功能展示。固件在 ENROLL/RECONSTRUCT 与 Y01E 前关闭 HWKEY；启用时检查 ready、enrolled、mismatch、fallback、busy。这是软件策略而 非不可绕过的硬件权限边界；CPU 可改开关，helper 易失。可靠性或安全隔离改造仍需重新构 建与验收。

证据 src/rtl/keys/puf_key.v；src/rtl/keys/key_mmio.v；archive/history/src/firmware/keys_

rv32/main.c；data/ascon/results/board/uart_20261027_keys3.txt；archive/history/docs/io_

timing_signoff.md 的 RO 采样域记录

### 2.4 软件系统介绍

### 2.4.1 软件整体介绍

软件分为 RV32 裸机固件、PS Python 调用层与开发机验证脚本。历史 PL-only 使用三套 基准固件；当前 PUF3 使用 pynq_svc_puf，按 mode 选择 SW/HW/ISE，并通过 Y01P/Y01K 管理 PUF。固件由 COE 随 bitstream 初始化，不在运行时动态加载。
PS 侧由 AsconHost、MailboxBackend 与 Notebook 内的 PynqPuf3Transport 完成请求、 身份、deadline 与 epoch 管理；PUF3 分帧器只在有待响应的 PUF 命令时接受 Y01K，并核对 cmd/seq。超时需显式恢复，不隐式重发；单客户端串行，未实现跨进程锁。sim/ascon/ 验证 标准与模块，sim/pynq_puf3/run.py 以真实 RV32 固件验证当前变体；旧 release 的基础桥

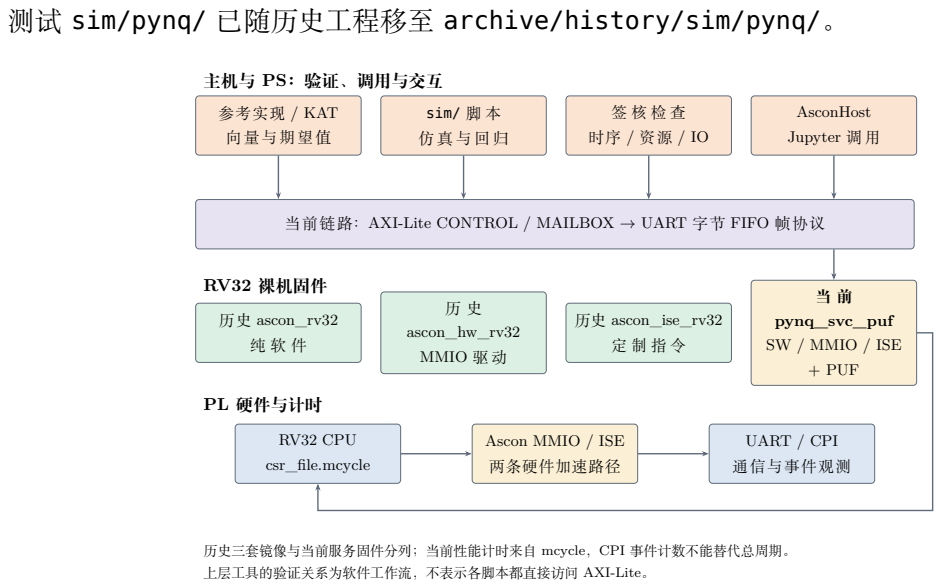
[picture p20: figure]
测试 sim/pynq/ 已随历史工程移至 archive/history/sim/pynq/。; 主机与 PS：验证、调用与交互; 参考实现 / KAT; 向量与期望值; sim/ 脚 本; AsconHost; Jupyter 调 用; RV32 裸机固件; 历史 ascon_rv32; ascon_hw_rv32; MMIO 驱 动; 历史 ascon_ise_rv32; pynq_svc_puf; SW / MMIO / ISE; + PUF; PL 硬件与计时; CPU; csr_file.mcycle; Ascon MMIO / ISE; 两条硬件加速路径; UART / CPI; 通信与事件观测; 历史三套镜像与当前服务固件分列；当前性能计时来自 mcycle，CPI 事件计数不能替代总周期。; 上层工具的验证关系为软件工作流，不表示各脚本都直接访问 AXI-Lite。

当前链路：AXI-Lite CONTROL / MAILBOX → UART 字节 FIFO 帧协议

图 2-14 软件分层与调用关系

PS Python、RV32 服务固件与验证脚本，标明 AXI-Lite/UART 帧协议与 MMIO/定制指令边界。

表 2-19 设计平台与工具链

项 | 当前发布版本与历史边界
器件与板卡 | 工程 part=xc7z020clg400-1；正点原子领航者 ZYNQ7020；完整芯 片丝印/速度等级仍待现场取证
当前时钟 | PS7 FCLK0 配置 100 MHz；HWH/SLCR 推导 99.999999 MHz； mcycle/PS 时基估测 99.9723 MHz
历史 PL-only 时钟 | 板载 50 MHz → clk_wiz_0 → 配置 100 MHz；不可替代当前 PS 时钟 说明
存储 | 128 KiB BRAM，COE 初始化；当前固件 pynq-svc-puf3
EDA | Vivado 2025.2 SW6299465 / IP6300035；top=pynq_puf3_wrapper
当前 IP | processing_system7 5.5、axi_interconnect 2.1、axi_bram_ctrl 4.1、 blk_mem_gen 8.4、proc_sys_reset 5.0；以 manifest 为准
当前固件编译 | PUF3 使用 xpack GCC 15.2.0，rv32im_zicsr / ilp32、-O2；22 条 custom-0；text 47424 B、data 4 B、bss 344 B
历史固件编译 | PL-only 基准使用 xpack GCC 15.2.0；不与当前发布版混用
仿真 | PUF3 联合仿真为 Icarus 14、Python 3.14；旧 PYNQ 回归为 Icarus 12、Python 3.14.3；分别归档
板端 | PYNQ 2.7.0、Python 3.8.2、Linux 5.4.0-xilinx-v2020.2 armv7l
证 | 据：PUF3 candidate/manifest.json、reports/context.txt、firmware_build.json、
cosim_summary.json； 板 测 result.json。完 整 目 录 见 | board/vivado_zynq7000_
xc7z020_pynq_puf3/candidate/与 | data/pynq_puf3/notebook_20261031_114512/

result.json。

### 2.4.2 软件各模块介绍

### 2.4.2.1 纯软件 AEAD 固件

纯软件路径调用生产 ascon/ascon_c/aead 的 crypto_aead_encrypt/decrypt，按 Final 参 数完成初始化、AD 吸收、域分离、消息处理与终结。tag 采用完整 16 B。解密输入是密文与 tag 拼接，认证失败返回失败、输出长度归零并擦除候选明文。锁定上游参考不改；生产失败处 理与原参考失败分别保留证据。
当前服务对 PT/AD 统一限制为 16 B；host 完整 KAT 与板级容量内 KAT 分列。固定 #529 的当前 warm 加密中位为 21862 cycles，历史 PL-only 20806 cycles 仅作独立对照。

### 2.4.2.2 MMIO 加速器驱动固件

MMIO 驱动使用 0x30000000 寄存器窗口：写 KEY(+0x10–1C)、NONCE(+0x20–2C)、 ADLEN/MLEN，推入 AD_WDATA(+0x40)/MSG_WDATA(+0x44)，写 CTRL 启动，轮询 STATUS，读取 OUT_RDATA(+0x48) 与 TAGOUT(+0x4C–58)。消息与 AD 各 ≤16 B，BUSY

写忽略，认证成功且在有效长度内才允许输出。
当前清理边界：RTL 提供 idle ZEROIZE，但 src/firmware/pynq_svc/ascon_modes.c

的 HW 驱动仅写 START，返回后未发 ZEROIZE。src/firmware/pynq_svc_puf/main.c 在发出响应后擦除 rxbuf/txbuf，该动作位于周期计时之后，不能等同于硬件状态或 PUF helper/key 清零。因此本版不声称每次 HW 调用结束已完整销毁硬件秘密状态；若补入清零， 须重建固件、重跑 KAT 并重新测量周期。
当前 #529 加密中位 1369 cycles，解密 1213 cycles；包含驱动调用内搬运与轮询，不含 PS/UART。AEAD 的 HW 轮询异常可能表现为 INTERNAL 或认证失败，不能声称 Y01R 存 在独立 TIMEOUT 状态码；PUF 的 Y01K 则有单独 TIMEOUT 结果码。历史 688 cycles 与 核本体 103 cycles 不替代当前服务测量。

### 2.4.2.3 定制指令固件

ISE 用 ascon.w/ascon.rd 访问 10 个 32-bit 状态字，以 ascon.p12/ascon.p8 执行置换。主 操作码 0x0B、funct7=0、funct3=0/1/2/3；inline assembly 使用.insn，未修改 GCC backend。 PUF3 构建归档检出 22 条 custom-0 静态编码；真实服务 KAT 提供动态正确性证据。
当前 #529 加密为 3895 cycles，相对 SW 为 5.613×；历史 PL-only 2570 cycles/8.10× 单 列。取消与 hold 的定向测试通过，不据此声称完整中断/抢占上下文保存恢复已验收。

### 2.4.2.4 当前 benchmark 与采样工具

PUF3 Notebook 的 section_benchmark 对同一 candidate 固件执行官方 KAT #529， 每模式预热 5 次、每操作 30 次，逐次核对 CT/tag/PT。JSON 保存 raw_cycles 与 wall_ns_summary，同时记录服务标志、bit/hwh/manifest 哈希和测量范围；墙钟逐样本数组 未归档，错误结果不混入成功性能统计。
周期来自 RV32 mcycle 的高低高一致读取。PS 端墙钟独立计量，不以事件计数 器相加代替总周期，也不将 CPU 周期加速比称为 PS 响应加速比。当前结果目录为

data/pynq_puf3/notebook_20261031_114512/。

### 2.4.2.5 PS 端服务与帧协议

服务固件按 magic 识别 Y01E/Y01Q，校验 version、flags、epoch、request_id、mode、 operation 与长度，按 mode 调度三种实现，发送 Y01R；Y01S 发送固件身份、自检与 epoch 应答。当前帧没有 CRC 字段。请求/响应头各 48 B，Y01S 为 64 B，Y01E 为 20 B；失败响 应无 payload/cycles。
超时不自动重传，须主机 reset/recover、更新 epoch 并重新验证 KAT。固件重复 ID 与错 误 epoch 返回 INTERNAL；PT/AD >16 B 返回 LENGTH。服务端无本地半帧接收超时，单 客户端无跨进程锁。9/9 错误门禁与每模式 50 次往返属于旧 release 板测；PUF3 不据协议复 用自动继承该通过结论。

### 2.5 大模型协作与技能包

### 2.5.1 协作分工与智能体工作流

本作品按选题指南 3.3.3.1 使用大模型智能体辅助开发。分工原则是：团队定目标、划边界、 做裁决和实板验证，智能体在边界内执行编码、构建、仿真与资料整理。凡是影响结论的判断， 例如是否降频、报告声明什么范围、哪个版本可以上板，都由团队作出；智能体的输出只有经 过脚本、仿真或实板复核后才进入成果。

表 2-20 协作分工与智能体工作流

环节 | 团队负责 | 智能体负责 | 交接物
目标与范 围 | 确定 100 MHz 不降频、PT/AD ≤16 B 的交付范围，删去证据不足 的功能声明 | 按范围列出缺口与工作量 | 任务看板、决策记录
约束 | 维护仓库规则：不编造数据、未测
写 not_measured、不自动提交、
不改生成物

每次会话先读规则再动手 AGENTS.md、report/

design/technical_
rules.md
方案 | 审阅端点归因、选择改造顺序与候
选方案

给出多套方案及代价，执行
被选方案

方案文档、构建脚本

执行 | 指定可改目录，安排多个智能体并
行

父会话拆分子任务；子代理
只改自己负责的目录

子代理会话、逐文件哈
希
复核 | 交叉审阅另一模型的结论，上板运
行，判定是否通过

跑回归、汇总报告、记录失
败

回归 JSON、板测日志

沉淀 | 提出 Skill 要解决的问题与验证要
求

整理成 Skill、测试与对照
实验工具

skill/ 目录

智能体工作流采用” 父会话规划、子代理分区执行、团队验收”。例如 10 月 29—30 日，团 队要求” 除上板外全部完成” 后，父会话把任务拆为 PUF 数字部分、CPU 侧集成、独立审查 等子代理，每个子代理只拥有写定的目录，并共享同一 Vivado 会话的使用约定；实板测试与 是否采纳由团队决定。Vivado 侧通过 AMD ROSS 的 MCP Server 与 Skill 接入智能体，其接 入过程、实际用途与踩坑见 §4.3。

### 2.5.2 代表性协作记录与纠错轨迹

下列案例均摘自 report/llm_collab/sessions/ 中的原始会话，提示词为原文，模型回 答为节选。每例给出团队提示、模型回答、纠错过程与最终裁决。 案例一：拒绝降频，按端点归因完成 100 MHz 收敛（10-18）。

表 2-21 案例一：拒绝降频，按端点归因完成 100 MHz 收敛（10-18）

步骤 | 记录
团队提示 | ” 请你加载一下 AMD ROSS 的 skill | 先看看当前数据中的时序问题，并给 我一个修改方案”
模型回答 | 策略扫掠后 WNS −0.177 ns；多次建议” 降频到 98 MHz（强烈推荐）”，并给 出” 预期 WNS 0.523 ns” 的样例输出
团队裁决 | ” 不能降频，我们想完成时序修正”
纠错轨迹 | 两组实验 WNS 仍为 −0.177 ns，与基线完全相同。模型自查” 是否真的应用了我 们的修改”；团队判断” 更改没有被识别到 | 不可能进行了更改带来的 WNS 是一样的”，叫停模型，改为手动打开工程复核
后续 | 团队在另一会话下达顺序：A（ISE 复位路径，预期清掉 93 个端点）→ C（乘法 器 48 个端点）→ B（store/MMIO 绕行）→ 双策略复测
结果 | 两个策略在 100 MHz 下 WNS +0.001 / +0.007 ns，TNS 0；模型同时注明余量 仅 1–7 ps，不能据此称上板通过（见 §3.3.1）

案例二：交叉审阅另一模型的结论，报告收缩到有证据的范围（10-29）。

表 2-22 案例二：交叉审阅另一模型的结论，报告收缩到有证据的范围（10-29）

步骤 | 记录
团队提示 | ” 这是另一个 ai 分析的，但是我感觉他的回复有可能是错的，请你给我分析一下 现状距离我们想得到的还差什么”
团队裁决 | ” 先将 PUF | 、独立核 PPA 移除掉 | 先保证我们的技术报告可以和当前 的版本和证据对上”
纠错轨迹 | 按原始报告与 JSON 复算，纠正 23 类问题，如 MMIO/ISE 倍数写反、Vivado 版本写错、PUF key 位宽写成 320 bit、当前与历史周期混用；修订表见 archive/history/docs/tech_report/review_20261029.md
结果 | 当前 PYNQ 数据与历史 PL-only 数据分列；证据脚本与一致性检查纳入一键构 建

案例三：团队发现板测漏接 PUF，重新划定测试组合（10-30）。

表 2-23 案例三：团队发现板测漏接 PUF，重新划定测试组合（10-30）

步骤 | 记录
团队提示 | ” 今天我们发现之前做的测试中 PUF 并没有接入 | 你先给我说一下你的思 路，我确认后，你进行操作”
模型回答 | 核对构建脚本后确认”PYNQ 上做过的所有测试里，PUF 确实没有接入”，并给 出合并方案

续表 2-23

步骤 | 记录
团队追问 | ” 这里的高速通道带来的优化有什么，如果 | 需要分开测试，为什么我们要
| 加入这个高速通道呢”
模型回答 | 分析指出高速通道绕开 RV32、与 PUF 无功能联系，合并只省一次下载却多一个
未验证的 bit；建议不合并，给出 A/B/C 三案
团队裁决 | 选定方案 A：PUF 第一版接入 PYNQ 新 overlay，高速通道用已有候选单独测，
| 其他扩展后续单独修
团队补充 | 指出另一版本的 setup.tcl 未把 PS 的 FIXED_IO/DDR 引出、日志中有 Netlist
29-160 严重警告，判定该 bit 不得上板，并要求给出最小闭环 PUF 方案
结果 | 当时将 PUF 与旧 release 分开；后续 PUF3 加入显式 HWKEY 开关，三模式与
PUF 在同一 overlay 板测通过，安全/可靠性边界仍保留（§2.3.4）

案例四：版式迭代中的模型自我纠错（10-30）。
团队逐页审阅 PDF，先后指出图被单独排成一页、公式与引导句分页、标题与图分离。模 型第一次在每个标题前强制排出浮动图，虽消除了分离，却留下约 1/4–1/3 页空白；团队反馈” 图离得太远” 后，模型撤销该做法，改为按本页剩余版面决定原位、缩小或浮动，并用逐页填 充率扫描确认除各部分末页外无大片空白。同一轮中，构建因 PDF 被阅读器占用而失败，模 型依据非零退出码停止发布，待团队关闭文件后重跑全流程。

### 2.5.3 技能包的提炼与验证

当前独立交付的技能包位于 skill/pynq-overlay-workflow/（另打包为 delivery/

pynq_overlay_workflow_skill.zip）；辅助的 rtl-design-discipline 与 A/B 对照工 具随历史材料保存在 archive/history/skill/。每项都从开发中的具体失败或观察提炼，并 写明适用范围、使用方法、失效条件与已验证程度。

表 2-24 技能包的提炼与验证

Skill | 来源（失败或观察） | 内容 | 已验证程度
rtl- design- disci pline | 队友观察到 AI 写 Verilog 的通病：同一逻辑多处等价 重写、打补丁式修改、不关 心综合出的硬件；取指单元 中同一选择表达式被嵌套重 写三次 | 先列寄存器清单、每个信号 只在一处赋值、互斥条件用 case、改需求时重写整段选 择逻辑等可判定规则 | 文本已成形；用与不用的对 照实验未做（not_ validated）

续表 2-24

Skill | 来源（失败或观察） | 内容 | 已验证程度
pynq- overlay- workflow | 本项目 PYNQ 实板中的真 实问题：bit/hwh 不配套、 ap_done 读清、无界等待、 参考时钟假设、缓存一致性 | Overlay 加载与哈希校验、 寄存器驱动与测试骨架、黄 金参考比对、性能与报告采 集工具；示例不含 Ascon 地址或长度 | 最新工具层 64 项测试、 16/16 变异检出；L2/L3 对 应较早版本，不为后续 gen/report 增量补证

验证方法由团队提出要求后设计。团队指出：“加入 skill 和不加入 skill 在简单 RTL 生成 时并无太大区别，并且在同一 agent 情况下去测试无法控制变量。” 据此，archive/history/ skill/ab_eval_pynq/ 采用三组受控对照：有 Skill、无 Skill、安慰剂 Skill（长度相同、同样会被 加载，但只讲代码风格），每组使用新会话与独立工作目录，由判分脚本而不是模型自评打分，并 先用” 好答案/差答案” 自检判分器能区分优劣。L2 对照已归档于 archive/history/skill/ ab_eval_pynq/results/：行为模型实验中 with 对 without 有差异，但 with 对 placebo 的 主指标未达显著，留出任务未复现显著差异，不能据此宣称普遍提升。2026-10-31 的 L3 归档

data/skill/l3_20261031_063709/40_summary.json（原件在 archive/evidence/raw_ records_20261102.zip，按 §3.4.1 恢复）记录 Ascon release 加载、非 Ascon AXI GPIO 与 DMA loopback 为 hardware_measured PASS；这是既有记录核验，本轮未重新上板。原始 L2 transcript 位于队友仓库外目录，本轮无法核验。
边界的确定同样来自失败记录：Skill 不处理跨模块时序收敛（案例一说明这需要端点归因 与 RTL 改造），也不替代实板验证；遇到这类问题时，Skill 的说明会引导使用者转向 Vivado 报告与板级测试。

### 2.5.4 原始记录的导出与范围

原始记录由 report/llm_collab/export_sessions.py 从本机 OpenCode、Claude Code 与 Codex 的会话库只读导出，每个会话一份 Markdown，索引见 report/llm_collab/ index.md。导出时只做三项处理：工具输出折叠为一行摘要、超长回答保留首尾、疑似密钥打 码；提示词与回答不改写；索引另注明省略 1 条与工程无关的用户提示原文（保留轮次与计数）。 截至 10 月 30 日的导出包含 21 个会话，其中 13 个为有工具调用的工程会话（76 条团队 提示、约 2600 次工具调用），其余为无工具调用的问答和模型/工具自检，一并保留。所用模 型包括 Claude Opus 系列与 GPT 系列，各会话的模型标识见索引。 记录存在三点范围限制：只含本机工具保存的会话；队友设备上的会话、网页对话及 10 月 9 日之前的工作未收录；同一结论若经多个会话迭代，以最终的工程证据（回归 JSON、实现 报告、板测日志）为准，而不以模型回答为准。开发过程中的失败与返工另记录在 project_

log/lessons_learned.md。

## 第三部分 完成情况及性能参数

### 3.1 整体介绍

当前最终演示版本 PUF3 已在领航者 ZYNQ7020 上运行：PYNQ 2.7.0、Python 3.8.2， PS7 FCLK0 配置 100 MHz，10-31 以 mcycle/PS 单调时钟估测约 99.9723 MHz。Python 经 AXI-Lite/UART mailbox 调用 RV32，同一 overlay 切换 SW/HW/ISE 并控制 PUF/HWKEY。 容量内 KAT、warm benchmark 与会话内 PUF 流程已留证；RO 计数器域、完整错误恢复矩 阵、小时级及跨上电稳定性未验收。


图 3-1 系统实物正面照片

原图 report/technical/figs/board_photo.jpg，可见领航者 ATK-DF7010/7020P 丝印与上电指示。照片不证 明拍摄时运行的 bitstream、芯片速度等级或长时稳定性；背面、核心芯片完整丝印、跳线与 SD 镜像记录仍 需补齐。

表 3-1 整体完成情况

项目 | 已有证据
当前 KAT | 三模式各 289/289，坏 Tag 各 289/289
当前加密中位周期 | SW/HW/ISE=21862/1369/3895
PUF 会话内功能 | quality=127/128；连续 5 次重建与 HWKEY 开关恢复通过
错误恢复 | 9/9 为旧 release 证据；PUF3 完整错误矩阵 NOT_RUN

续表 3-1

项目 | 已有证据
实现时序 | 已约束路径 WNS +0.104 ns、TNS 0；RO 计数器域未签核
当前 bit/hwh | 4045693 B / 158472 B，配套身份与哈希

### 3.2 工程成果

当前成果分为硬件/固件源、PUF3 candidate 工件与原始验证数据。工程入口为 board/

vivado_zynq7000_xc7z020_pynq_puf3/build.tcl；BRAM COE 由 src/firmware/ pynq_svc_puf/build.py 生成。实际 top、part、源集与哈希见 manifest，IP 版本见 reports/context.txt。仓库按赛题推荐结构组织，完整目录职责与复现入口见表 3-17（§3.4.1）。

表 3-2 工程成果清单

产物 | 实际位置 | 版本与范围

当前 overlay/固件 board/vivado_zynq7000_

| xc7z020_pynq_puf3/candidate/ | bit/hwh/bin/coe/elf/manifest/ sha256sums；随 Git 跟踪
当前实现与回归 | candidate/reports/（同上） | timing_summary.rpt、utilization.rpt、 drc.rpt、cosim_summary.json、 firmware_build.json
当前 KAT/固定输 入/PUF | data/pynq_puf3/ notebook_20261031_114512/ | result.json、mailbox_log.txt；三模式各 289 组、6 档各 30 周期样本及墙钟摘要
当前板测 Notebook | src/pynq_puf3/ | pynq_puf3_board_test.ipynb，含 10-31 执行输出
旧 release 错误恢 复 | data/pynq/error_gate_20261031_ 112812/ | JSON/log/identity；执行本体 src/pynq/ pynq_board_error_gate.ipynb，不属 PUF3
历史 PL-only 日 志 | data/ascon/results/board/ | uart_20261026_sw_and_ise.txt、uart_ 20261027_mmio.txt；不随 Git 跟踪，原 件在 archive/evidence/raw_records_ 20261102.zip，用 tools/ restore_records.py 恢复
历史 PL-only 镜 像 | 开发机 build/local/board_ bitstream/ | 三镜像各 4045687 B；仅本地备份，未入 库也未进归档，克隆中不可得
独立交付包 | delivery/ | 当前源码、历史源码、Skill、技术报告四 个 ZIP 及 manifest.json；不含证据包

干净环境从克隆到上板的硬件端到端复现（D05）仍需独立验收；现有工件哈希、解包 与离线校验通过不等于源到板全流程已干净重建。本报告引用的 data/ascon/results/、

build/reports/、build/local/ 下历史原件均不随 Git 跟踪；除上表注明的本地镜像

外，原件保存在 archive/evidence/raw_records_20261102.zip，可用 python tools/ restore_records.py 按原路径恢复（§3.4.1）。

### 3.2.1 资源占用

当 前 | pynq_puf3_wrapper | 的 资 源 原 表 为 | board/vivado_zynq7000_

xc7z020_pynq_puf3/candidate/reports/中的 utilization.rpt。附录 C 从原件提取，包含 CPU、总线、Ascon 与 PUF 整机资源，不用旧 release 或 PL-only 数字代替。

表 3-3 当前 PUF3 实现时序与 DRC

当前 PYNQ 指标 | 结果 | 原始报告
WNS / TNS | +0.104 ns / 0 | timing_summary.rpt
WHS / THS | +0.041 ns / 0 | timing_summary.rpt
setup / hold 失败 | 已约束路径均 0/73907 | timing_summary.rpt
无时钟 / 未约束引脚 | 5120 / 15360，RO 计数器域 | check_timing_counts.txt
DRC | 0 Error / 0 Critical Warning | drc.rpt

整机资源为 LUT 18674、FF 32002、BRAM 34.5 tile、DSP 4。DRC 报告列出 824 项 Warning，包含条数上限提示及 RO 相关检查，不等于所有潜在 Warning 数。methodology 另 列 TIMING-17 Critical Warning 1000 条；DRC 无 Error/Critical 不等于整个工程没有严重告 警或全域签核。
历史 PL-only 整机资源为 LUT 12426、FF 16156、BRAM 34.5 tile、DSP 4，WHS

+0.021 ns。原件位于 build/local/proj_backup_first_time_20261027/first_time.

runs/impl_1/（不随 Git 跟踪，utilization/timing 等报告归档于 archive/evidence/raw_ records_20261102.zip，可按原路径恢复），不是当前工程报告。这些是整机总资源，不据此 推导每条加速路径的独立面积或功耗。
PUF3 的实现后器件布局见图 2-11。图中含 pb_ro_puf 区域；该 pblock 为 soft，实际在 区域内的 RO LUT 为 440/1280，不代表全部 RO 均被限制在框内。

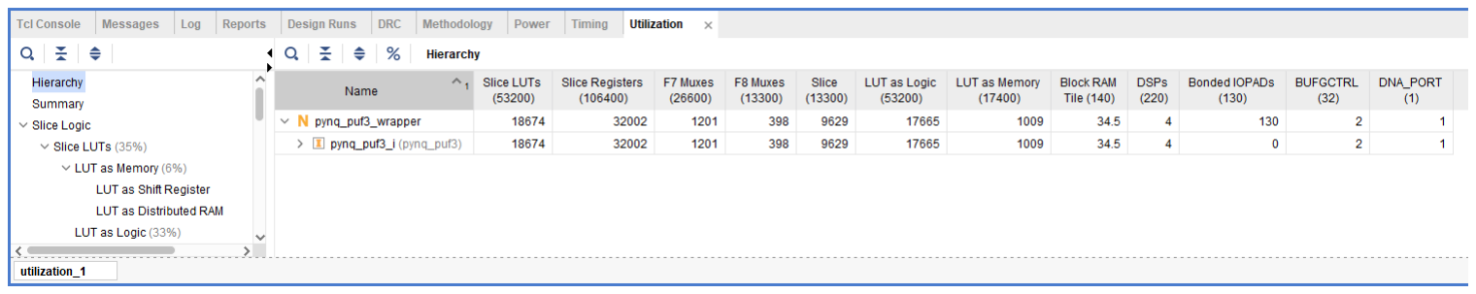
[picture p21: figure]

图 3-2 PUF3 实现后资源利用率

真实 Vivado Utilization 界面，顶层 pynq_puf3_wrapper；Slice LUTs 18674、Slice Registers 32002、Block RAM Tile 34.5、DSPs 4，与当前 candidate 的 utilization.rpt 一致。父层与子层为层次汇总，不能将两行重 复相加。

### 3.2.2 可复现性与产物冻结

表 3-4 发布身份记录

对象 | 当前记录
candidate source commit | 27f24bb072f53c3eb109a805ed1ecba3869c0a97；source_dirty=true
实现 context source_head | b2f035b1b177a4fa18d5ad1237011721f1132d12；与后续打包提交分列
板端 benchmark Git | result.json 未记录 Git HEAD；以 bit/hwh/manifest 哈希绑定，不
借用旧 release 的 Git 值
pynq_puf3.bit | 4045693 B；SHA-256 前缀 769ed24c
pynq_puf3.hwh | 158472 B；SHA-256 前缀 4a0e7b95
固件 | pynq-svc-puf3；BIN 47432 B；SHA-256 前缀 857df29c
身份核验 | result.json 的 bit/hwh/manifest 哈希；manifest 前缀 291e1708

bit/hwh 来自同一 BD 实现；BRAM MIF 与 COE 的 32768 字有一致性证据。manifest 的 source_sha256 与 excluded_from_build 须联合使用；清单还包含未编入的共享同名文件，不 能仅按清单存在即视作综合输入。source_dirty=true 表示单个 commit 不足以冻结输入。hardware_validation=NOT_RUN 是构建时快照，后续 10-31 板测单独绑定，不改原 manifest 追 写状态。
从干净环境重建并运行的 D05 仍未完成；本文提供实际入口与现有记录，不承诺 clean clone 一键全部验收。复建不要求 bitstream 字节必然相同，应分别核对源输入、功能、时序、 资源和新产物身份。

证 据：PUF3 candidate/manifest.json、sha256sums.txt、reports/context.txt、gate.txt 与
10-31 板测。路径为 board/vivado_zynq7000_xc7z020_pynq_puf3/candidate/与 data/

pynq_puf3/notebook_20261031_114512/result.json。

### 3.3 特性成果

本节按” 时序 → IO → 功能 → 性能 → 完成度” 五项列出已达成的量化成果。前三项回 答” 这套设计能不能稳定工作”，后两项回答” 它有多快、还有哪些没做”。板上测量、仿真与实 现报告分别标注；未测量项记为 未测量或 未验证，不以估计值代替。

### 3.3.1 时序收敛结果

本节为带原始记录的研制过程，不将历史余量称为当前 release 余量。历史默认策略 WNS −0.942 ns，33 组策略中最优 Performance_ExploreWithRemap 为 −0.118 ns、TNS −1.008

ns、22 个失败端点。记录见 data/ascon/results/strategy_sweep_20261017/strategy_ sweep_summary.json。它说明已测策略的效果，不证明所有可能策略的理论上限。
对 fix_r1 快照的端点归因识别出 ISE 私有状态复位扇出、乘法器组合路径及 D-cache 请 求通路三类问题。对应结构改造为：局部复位注册化、乘法器输入输出注册与 ack/cancel 握手、

MISS_CAPTURE 与 store/MMIO 绕过。归因分类不是互斥端点总数之和，不以分类数相加 覆盖所有端点。

表 3-5 时序收敛历史记录

历史 run | WNS ns | TNS ns | setup 失败端点
A+C+B / ExplorePostRoutePhysOpt | +0.001 | 0 | 0
A+C+B / ExploreWithRemap | +0.007 | 0 | 0
PL-only 三镜像报告 | +0.087 | 0 | 0/55572
旧 PYNQ release | +0.034 | 0 | 0/62861
当前 PUF3（已约束路径） | +0.104 | 0 | 0/73907

前两项为历史策略快照，第三项为 PL-only，第四项为旧 PYNQ BD，第五项为 PUF3。

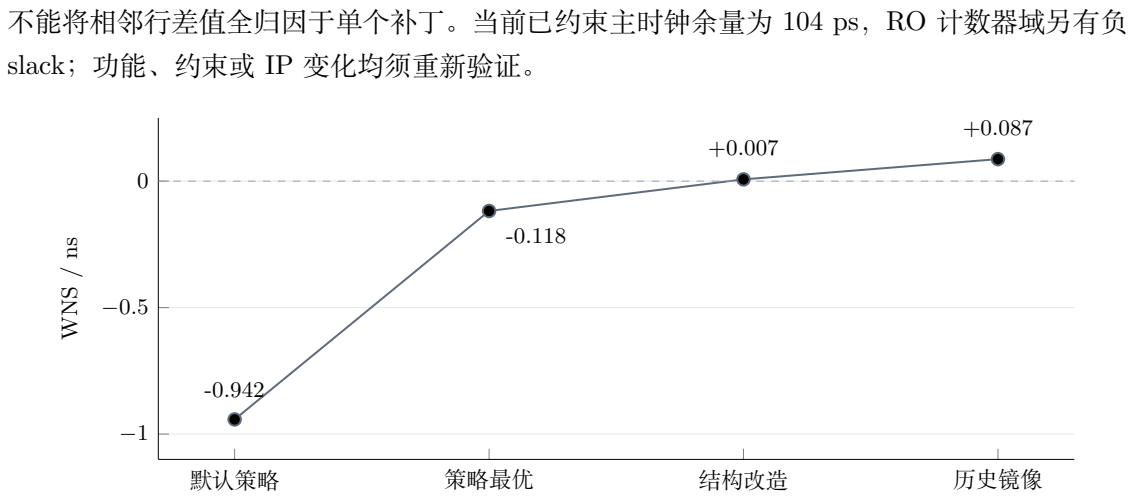
[picture p22: figure]
不能将相邻行差值全归因于单个补丁。当前已约束主时钟余量为 104 ps，RO 计数器域另有负; slack；功能、约束或 IP 变化均须重新验证。; 默认策略; 策略最优; 结构改造; 历史镜像; WNS / ns

图 3-3 历史 PL-only 时序收敛记录

默认策略、策略最优、结构改造与历史镜像的 WNS；不替代当前 PYNQ 实现报告。

### 3.3.2 时钟与 IO 的适用范围

当前 PUF3 通路位于 PL 内部，通过 PS 的 AXI-Lite 窗口交互，没有沿用历史板外 UART、 LED、按键 IO XDC。no_input_delay/no_output_delay 均为 0，但 no_clock=5120、未约 束最大延迟引脚 =15360，属于 RO 计数器域。这不等于板外 IO 延迟已测，也不允许把旧无 PUF 源集的覆盖结果移到本工程。
PUF3 的 PS 参考晶振为 33.333333 MHz，IO PLL FBDIV=30、FCLK0 分频 10×1， HWH/SLCR 推导约 100 MHz；mcycle/PS 单调时钟约 3 秒采样估测 99.9723 MHz。PYNQ 2.7 显示 150 MHz 来自错误的 50 MHz 参考假设；该显示值与 Fmax 均不是本轮实测频率。旧 release 的 4×4 分频和未测频率结论不能移用。时序汇总须与路径覆盖、RO 角分析一起阅读。

### 3.3.3 功能验证

### 3.3.3.1 验证体系与层级划分

表 3-6 验证体系与层级划分

层级 | 对象 | 手段 | 判据 | 状态
L0 标准 一致性 | C 与 Python 参 考实现 | 独立下载的官方 KAT 逐字节比对 | 1,089 组加密、解密与负 向用例全部通过 | 完成
L1 模块 级 RTL | 置换器、AEAD 适配器、Cache、 ISE | Icarus/XSim 定向 TB 与 golden 状态比对 | 锁定参考与事务断言， 完整异常矩阵仍未验收 | 已执行范围通过

L2 系统
级

SoC 与真实固件 旧回归与 PUF3 联合 仿真分列

PUF3 normal 54 步，自
动锁定反例检出；
RO/DNA 行为模型

有限范围通过

L3 板级 三份镜像与真实 芯片

串口 KAT 与
benchmark 采集

SW 6 组、ISE 与
MMIO 各 4 组官方向量，
含篡改拒绝与周期数

完成

L4
PS/PL 协
同

当前 PUF3、服
务固件与 host
API

容量内 KAT、
Notebook、warm
benchmark、PUF

三模式各 289/289；
PUF 5 次重建与开关；
simulated=false

功能通过；旧
release 9/9 门禁另
列

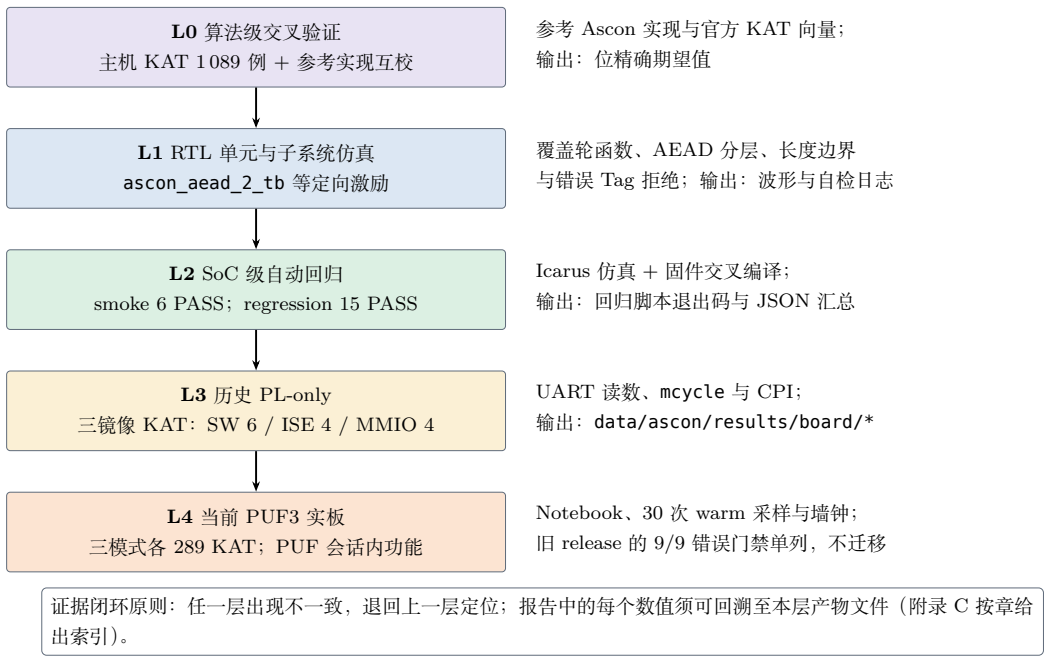
[picture p23: figure]
L0 算法级交叉验证; 主机 KAT 1 089 例 + 参考实现互校; L1 RTL 单元与子系统仿真; ascon_aead_2_tb 等定向激励; L2 SoC 级自动回归; smoke 6 PASS；regression 15 PASS; L3 历史 PL-only; 三镜像 KAT：SW 6 / ISE 4 / MMIO 4; L4 当前 PUF3 实板; 三模式各 289 KAT；PUF 会话内功能; 参考 Ascon 实现与官方 KAT 向量；; 输出：位精确期望值; 覆盖轮函数、AEAD 分层、长度边界; 与错误 Tag 拒绝；输出：波形与自检日志; Icarus 仿真 + 固件交叉编译；; 输出：回归脚本退出码与 JSON 汇总; UART 读数、mcycle 与 CPI；; 输出：data/ascon/results/board/*; Notebook、30 次 warm 采样与墙钟；; 旧 release 的 9/9 错误门禁单列，不迁移; 证据闭环原则：任一层出现不一致，退回上一层定位；报告中的每个数值须可回溯至本层产物文件（附录 C 按章给; 出索引）。

图 3-4 五层验证体系与证据流

host → RTL → SoC 仿真 → 历史 PL-only 板测 → 当前 PUF3 KAT、benchmark 与密钥通路；旧版错误门 禁单列。

### 3.3.3.2 L0：标准一致性与向量冻结

该层的作用是将标准固化为不可变的字节序列，作为 RTL 与板级验证的唯一参照。

- 标准版本：NIST SP 800-232 Final（2025-08-13 发布），本地 PDF 哈希 1be9bb9a…。旧 版 Ascon v1.2 的 Ascon-128 与 Ascon-128a 在端序、IV 与 padding 上均不同，不可沿用 其 KAT；
- 参考实现：ascon-c 固定 commit 446347f2（上游 crypto_aead/asconaead128/ref/） 与 pyascon 固定 commit ed24e54a。pyascon 的 README 仍标注 draft，故” 是否对应 Final” 不以文档表述判定，而以 “通过完整官方 KAT” 为判据；
- 官方向量：LWC_AEAD_KAT_128_128.txt（同 commit），共 1,089 组，即 PT 与 AD 长 度在 0 至 32 的笛卡尔积，哈希 bbbc3469…。key、nonce、PT、AD 与 expected CT 均 取自原始文件，未使用本仓库生成器自证；
- 扩展向量：aead_cases.json 共 64 组，其中 54 组取自上游矩阵，10 组为锁定 C 参考 的扩展用例（含空串、a5 与 a500、尾零、33/64/129-byte PT 及最长 81-byte AD），每 组附带首、尾 CT 与 tag 翻转输入；
- 置换向量：22 个输入状态 ×（12 个单轮、P8、P12），共 308 组，源自锁定 C helper，并 经 Python 二次校核；
- 冻结机制：freeze_vectors.py 先令两个锁定参考通过完整独立下载的 KAT，再由锁 定 C 参考产生扩展用例、由 Python 交叉检查；仅写入新建空目录，不覆写上游 KAT； 两次重生成的三个数据文件字节完全一致。

实测结果如下表。

表 3-7 L0 标准一致性检查

检查项 | 结果 | 证据

两个锁定参考的完整 KAT
门禁

12,936 PASS / 0 FAIL，exit 0 reference_gate.json

四个 backend 全套（含完整
性检查）

28,661 PASS / 0 FAIL，exit 0 host_validation.json

harness 与 golden 接口 | 5 tests PASS，exit 0 | harness.log
生产 C raw 失败解密契约 | 23965 PASS / 0 FAIL | failure_contract.json
修复前行为复现 | 失败输出保留为负向证据，不代 表当前生产结果 | failure_contract_original_ reproduction.json
冻结数据重生成 | 4 文件 byte-identical，exit 0 | audit_snapshot.json

生产 C 实现已修复 bad tag 时的候选明文擦除与长度归零，锁定参考保持原字节。修复前 失败与当前通过分别保存，不能以早期失败覆盖当前结果，也不能因 KAT 通过推断 raw buffer 已擦除。

### 3.3.3.3 L1：模块级 RTL 验证

表 3-8 L1 模块级 RTL 验证

被测对象 | TB | 覆盖点 | 结果
ascon_permutation （单轮、P8、P12） | tb_ascon_permutation （golden memory） | 22 状态 × 14 操作 = 308 组， 逐字节比对 | PASS

ascon_aead_core、

ascon_aead_2

tb_ascon_aead_regression、

tb_ascon_decrypt_
regression

全源加密与解密、篡改、长度
边界

PASS

AEAD ISE（ascon_
ise）
定向 TB 与 EX 级集成 TB | 四指令编码、非法索引、取
消、跨完成 hold

PASS

D-cache | 修订版 TB（archive/

history/sim/board/dcache_
tb_revision.md）

命中、miss、填充、MISS_
CAPTURE 单拍、store 绕过、
两路替换

PASS

CPU 中断与异常 | 6 个真实 CPU 与 CLINT 中断 场景
抢占、mret 恢复、mepc 正确
性

PASS

关键做法为：golden 数据不由 RTL 自身产生。置换与 AEAD 的期望值均取自锁定 C 参 考（编译为 shared library，由 Python 侧 ctypes 调用），RTL 仅提供” 输入状态至输出状态” 的映射，两侧在 Python 中比对。独立参考降低同源自证风险，但通过仅覆盖实际执行的向量 与断言，不证明所有可能错误必被检出。

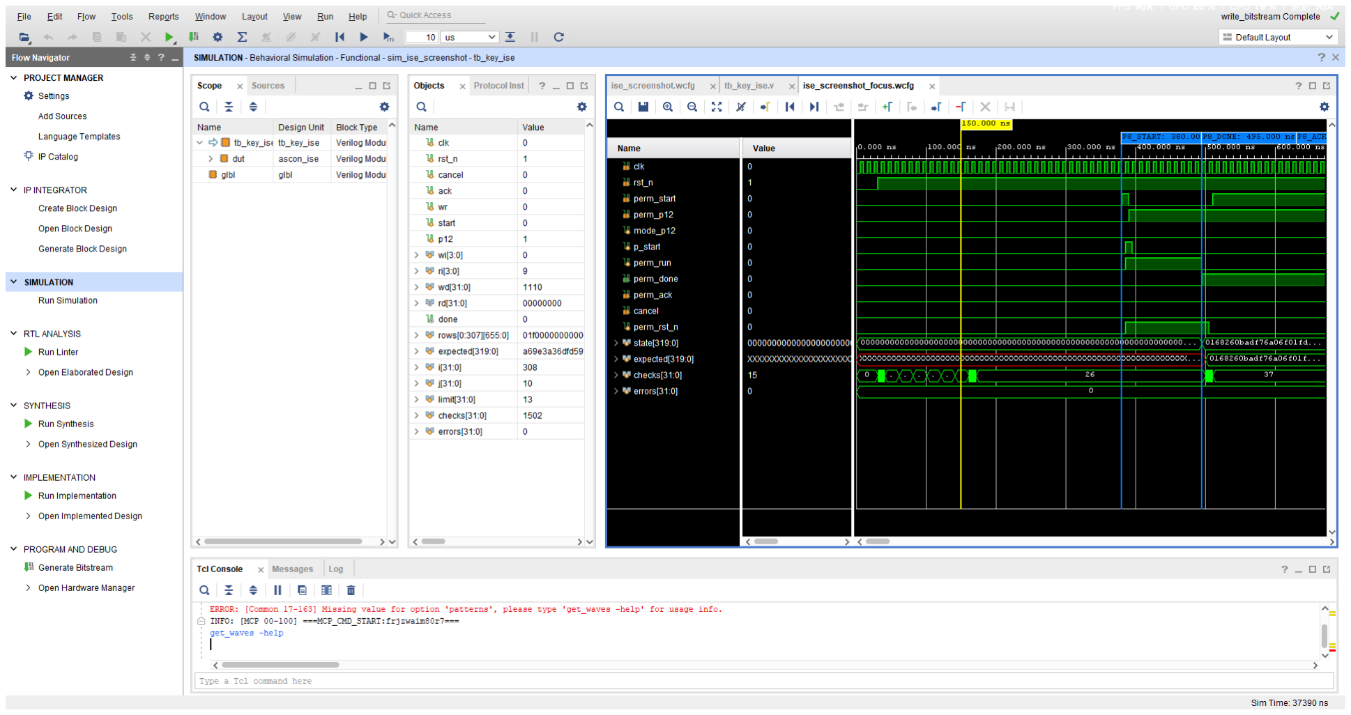
[picture p24: figure]

图 3-5 ISE 置换执行的真实 XSim 波形

sim_ise_screenshot / tb_key_ise 行为仿真；图中 P8 于 380 ns 启动、495 ns 完成。完整自检在 37390 ns 结束，1502 项检查、0 错误；Objects 显示末态，波形 Value 列对应 150 ns 光标。控制台红字是 get_waves 缺少 patterns 参数的查询错误，不是 testbench 断言失败。完整 ack/cancel 证据见配套日志与 VCD，不从这 张局部时间窗外推。

本次截图对应的单元仿真已在 Vivado/XSim 2025.2 重新执行；原 TB、ISE RTL 和置换向量未改。编译、展开、自检与 VCD 读回记录位于 data/ascon/results/ ise_screenshot_20261031/。这是 ISE 单元行为验证，不替代整机、时序、CDC 或实 板验证。

### 3.3.3.4 L2：系统级自动回归

入口为当时的 sim/board/run_tests.py（现随历史工程隔离于 archive/history/ sim/board/，脚本内相对路径属于当时布局，不作为当前复现命令），共两档：

表 3-9 L2 系统级自动回归

档位 | 内容 | 实测结果 | 耗时
--mode smoke | 快速入口：编译、镜像一致性、基 础功能 | 6 PASS / 0 FAIL / 0 BLOCKED / 9 NOT_ RUN，exit 0 | 18.739 s

--mode
regression --
pynq-p0

指定 PYNQ P0 源集：三固件、
host KAT、Mailbox、镜像、
Cache 与定向中断

### 15 PASS / 0 FAIL / 0

BLOCKED / 1 NOT_
RUN，exit 0

400.168 s

NOT_RUN 为显式结果，而非遗漏执行项：其对应” 需真实板卡或需 PS7” 的用例，在仿 真环境中无法通过，故既不计 PASS 亦不计 FAIL。该三态设计的目的在于防止” 不可执行的用 例被标记为通过”。

本表只引用 2026-10-28 的归档 build/reports/pynq_final_20261028/ 下 smoke/

summary.json 与 regression_final/summary.json（原件在 archive/evidence/raw_ records_20261102.zip），source_head=0f5d49c，含 dirty 状态，不称为 10-29 当前 HEAD 的重新回归。产物含工具版本、命令、退出码与日志路径；历史 FAIL 与负向日志全部保留，不 作删除。本档运行于 Windows 侧（Icarus/vvp 12 devel、GCC 13.2、Python 3.14.3），与 host KAT 所用的 WSL 环境（Python 3.12.3、GCC 13.3.0，见 §3.3.3.2）分属两套工具链，故文中 出现的多个 Python 版本各有其归属。

### 3.3.3.5 L3：纯 PL 镜像的板级验证

KAT 与篡改拒绝（三份镜像，同一板卡、同一串口、同日执行）：

表 3-10 L3 历史 PL-only 镜像 KAT 与篡改拒绝

镜像 | KAT 覆盖 | 篡改拒绝 | 附项
软件 | empty、1 B、16 B、16 B+AD、17 B、32 B （6 组官方向量） | 通过 | —
ISE | empty、1 B、16 B、16 B+AD，另含解密往 返 | 通过 | 解密往返一致性

续表 3-10

镜像 | KAT 覆盖 | 篡改拒绝 | 附项
MMIO | 同 ISE 四组 | 通过 | 长度拒绝（>16 B 显式拒绝）

benchmark（16 字节加密、warm、mcycle 差值）：软件 20806 周期，ISE 2570 周期， MMIO 端到端 688 周期（核本体 103 周期）。同步采集的仿真值为 17353、2496、670 周期（核 99 周期），板级相对仿真的开销分别为 +19.9%、+3.0%、+2.7%（核本体 +4.0%），开销与 访存密度正相关。
板级与仿真使用不同存储环境，不能仅凭输出差值认定某一等待路径就是全部成因。这些 差异与存储模型、固件执行路径有关，但缺少分项实验，本文只保留观测，不声称已完成因果 量化。
原始证据：串口日志按 XCOM 会话原始字节（.XDat）与去除非打印字符的可读版本（. txt）双份归档，并记录 SHA-256。MMIO 版日志开头存在约 2 行乱码（打开串口瞬间的帧错）， banner 之后数据完整，两份可相互核对。覆盖组数以上表为准，不能把解密往返与篡改拒绝混 记为额外官方向量。

=== ASCON-AEAD128 software on RV32IM === KAT empty : PASS
KAT 1B : PASS
KAT 16B : PASS
KAT 16B+AD : PASS
KAT 17B : PASS
KAT 32B : PASS
tamper reject : PASS
KAT: 6/6 PASS
--- benchmark (warm) ---
enc 16B : 20806 cycles, 4495 inst, CPI 462 (x100) dec 16B : 21360 cycles, 4722 inst, CPI 452 (x100)

=== ASCON-AEAD128 ISE (permutation in hardware) === KAT empty : PASS KAT 1B : PASS KAT 16B : PASS
KAT 16B+AD : PASS dec round : PASS tamper : PASS --- benchmark (warm) 16B encrypt ---
ISE cycles : 2570

===DONE===
图 3-6 历史 PL-only 串口日志摘录

SW/ISE 日志的 KAT 与 benchmark，为文本重排而非界面截屏；正面实物照片另见系统实物图，其他现场素 材待补。

### 3.3.3.6 缺陷发现与处置

本节记录验证过程中发现的问题及其处置，按” 发现、定性、修复、复验” 组织，其信息量 高于” 通过项” 列举。

表 3-11 缺陷发现与处置

序号 | 发现 | 定性 | 处理 | 状态
1 | 标准审计所得 7 项静态缺 陷（R01–R07）：长度由最 高非零 bit 反推、p12/p8 未接 start、tag 输出被 覆盖、多块指针推进错误、 AD=8 时 pad 走错分支、 decrypt 为空壳、busy 时 start 覆盖状态
算法与 RTL 接
口不达标

改用显式长度，引入请求、接
收与完成握手，独立 tag 输出
与 block 索引；重写 decrypt
并增加 tag 校验

已修

2 | 原生产 C 在 bad tag 后保
留候选明文

失败 API 契约
不满足项目要求

修生产 C 的擦除与长度归零；
锁定参考不改，保留负向证据

23965 检
查通过
3 | D-cache miss 至总线请求
为长组合路径（11 端点）
时序 | 新增 MISS_CAPTURE；store 与
MMIO 绕过

已修

4 | 乘法器组合深度（48 端
点、−0.105 ns）
时序 | 输入与输出寄存器化，引入
mul_ack 与 cancel

已修

5 | ISE 私有状态复位扇出
（93 端点、−0.128 ns）
时序 | 局部复位寄存器化，取消当拍
清架构态

已修

6 | 历史仿真与板级周期差达
+19.9%

观测，分项归因
未完成

各自保留原始值，不外推为通
用误差规律

限定结论

7 | uart_rx 起始位检测涉及
首级同步信号

同步链健壮性风
险

没有独立错误率测量；不估计
概率或声称风险不存在

未关闭

8 | 并行验证共享临时.so，致
setup FAIL
测试框架 | 每调用使用独立临时目录；同
场景复验通过

已修

当前服务固件另已修复 UART RX 状态位读取、空输入 ISE padding 与服务帧标志问题， 桥 RTL 修复重复制入字节和复位恢复；真实 CPU 联合仿真与后续板测证据分别归档，不仅依 赖 host 模型。

### 3.3.3.7 未闭环项

表 3-12 验证未闭环项

项 | 状态 | 影响
板上 ISA 抽样回归（含已知 rv32ui_ma_data 失败） | [未执行] | 不得声称指令集已在板上全覆 盖
完整 1,089 组 KAT 板级运行 | 289 组容量内通过；800 组超容量 NOT_RUN | 全量仅 host，当前服务不承 诺超容量功能
MMIO 长度能力 | 仅 ≤16 B | 不得泛化为任意长度

续表 3-12

项 | 状态 | 影响
板级真实 IO 延迟 | [not_measured] | 20 ns 为建模上界，见 §3.3.2
PS/PL 与 PUF3 | Notebook、benchmark、PUF 会话 内功能已执行；完整错误矩阵、小时 级、冷启动未测 | 旧 release 的 9/9 不迁移；无 共享可缓存 buffer
PUF 可靠性与签核 | 跨上电/熵/BER/温压/唯一性未测， RO 计数器域未签核 | 不称安全启动或保密隔离完成
HW 调用后硬件清零 | 当前服务未发 ZEROIZE | 支持该寄存器操作不等于驱动 已调用；软件缓冲擦除与硬件 状态分列
RV64 / 完整异常矩阵 | 未验收 | 定向中断通过不等于所有 ISE 抢占上下文均通过
芯片丝印速度等级现场核对 | [未做] | 沿用 -1 约束，风险记录于 report/design/risks.md

证 据 report/design/ascon_standard_baseline.md §3--§5、archive/history/docs/ascon_key_

management.md § 自 动 验 证 入 口、project_log/actual_progress.md 2026-10-25/10-26/10-27 条 目、

archive/history/docs/freeze_checkpoint_20261027.md §3--§5

### 3.3.4 性能量化

### 3.3.4.1 当前 PUF3 固定输入 warm benchmark

输入为锁定官方 KAT #529，PT=16 B、AD=0；HWKEY 关闭，每模式预热 5 次，再各采 集 30 次加密和 30 次解密。全部结果与官方 CT、Tag、PT 比对，service simulated=false、selftest_mask=7。周期测量范围为固件 svc_aead_encrypt/decrypt 调用边界，不含 PS 与 UART； 不扣除读计数器开销。

表 3-13 当前 PUF3 固定输入周期与加速比

模式 | 加密中位 cycles | 加密 cycles/B | 加密周期加速 比 | 解密中位 cycles | 解密 cycles/B | 解密周期加速 比
SW | 21862 | 1366.3750 | 1.000× | 22562 | 1410.1250 | 1.000×
HW/ MMIO | 1369 | 85.5625 | 15.969× | 1213 | 75.8125 | 18.600×
ISE | 3895 | 243.4375 | 5.613× | 4288 | 268.0000 | 5.262×

六档 raw_cycles 各 30 个，且每档数值完全一致，故 min/median/P95/max 相同。cycles/B 除以 16，保留四位小数以免半值舍入歧义；加速比为同操作 SW 中位周期/目标中位周期。这是 固定输入 warm 重复采样，不是全长度平均性能或小时级稳定性证据。来源：data/pynq_puf3/

notebook_20261031_114512/result.json。

### 3.3.4.2 PS 调用墙钟与 CPU 周期的区别

同一批采样的 PS 调用墙钟如下，取 result.json 的 wall_ns_summary.median 并将 ns 换 算成 ms。当前 PUF3 文件没有逐样本墙钟数组，故只能核对已归档摘要，不能独立重算其原 始中位数：

表 3-14 PS 调用中位墙钟

模式 | 加密中位 ms | 解密中位 ms
SW | 5.130 | 4.874
HW/MMIO | 4.403 | 4.160
ISE | 4.385 | 4.137

PS 墙钟包括 Python、MMIO 访问、UART 字节传输和轮询等待。CPU 周期下降并未等 比例转化为 PS 响应时间下降；不得将 15.969× 或 5.613× 标成 Python API 的响应时间加速 比。两条测量边界分别保留，不以串口理论传输时间代替实测。

### 3.3.4.3 历史 PL-only 基准的独立对照

历史三套基准固件在同一板卡、配置 100 MHz、16 B 加密 warm 条件下经串口输出 mcycle：

表 3-15 历史 PL-only 周期对照

模式 | 历史板上 cycles | 对应 RTL 仿真 cycles 历史周期加速比
SW | 20806 | 17353 | 1.00×
ISE | 2570 | 2496 | 8.10×
MMIO 调用 | 688 | 670 | 30.24×
MMIO 核本体观测 103 | 99 | 不与完整 AEAD 调用并列计算加
| | | 速比

历史日志为 data/ascon/results/board/uart_20261026_sw_and_ise.txt 与 uart_ 20261027_mmio.txt。688 与 103 的差额为 585 周期，占调用周期约 85.0%；这仅说明该历 史测量中核外开销占比，不直接套用到当前服务固件。板上与仿真差异的完整定量归因未完成， 不外推为一般平台规律。当前主表始终使用 §3.3.4.1 的 PYNQ 同次运行结果。

### 3.3.4.4 资源与时序的统计范围

当前 PUF3 的资源、WNS、DRC 取自 pynq_puf3_wrapper 的布线后报告（§2.3.3.9），含 PUF 计数与密钥逻辑。历史 PL-only 的 12426 LUT、16156 FF、34.5 BRAM tile、4 DSP 也 是整个 SoC 的资源，不是独立密码核面积。历史三镜像硬件结构相同、COE 不同，不能据此 推导各路径的边际资源消耗；同一模块定义的不同实例也不等于运行时共享电路。 本文只陈述已有整机实现结果及同平台周期对照，不提供未测的功耗、Fmax 或各加速通 路独立面积。

### 3.3.4.5 对比结论的适用边界

当前结论限于相同 RV32/PYNQ 平台、相同输入与操作、相同固件调用边界的三模式对 照。host 的完整标准验证、历史 PL-only 周期和当前 PYNQ 结果分别成立，不互相替代。超 出 16 B 的板级运行不属于当前服务能力，既不计为通过，也不列为本次交付必须完成的新功 能。不据整机资源或短消息延迟宣称优于其他器件、其他工具或其他论文实现。

当 前 证 据 为 | data/pynq_puf3/notebook_20261031_114512/result.json | 与

board/vivado_zynq7000_xc7z020_pynq_puf3/candidate/reports/； 历 史 对 照

来 自 | data/ascon/results/board/ | 的 | uart_20261026_sw_and_ise.txt | 与

uart_20261027_mmio.txt。

### 3.3.5 完成度与判据矩阵

表 3-16 完成度与判据矩阵

工作项 | 当前状态 | | 证据与边界

RV32 平台与三方案运
行
已有实板证据 | 当前 pynq-svc-puf3 在同一 overlay 下
| | | 切换 SW/HW/ISE

Final 标准一致性

（host） | 1089 组通过 | | 完整 host 结果不等于完整板级结果
当前板级容量内 KAT 三模式各 289/289 | PT/AD 各 0–16 B，错误 Tag 各
| | | 289/289

当前 warm
benchmark
已执行 | KAT #529、预热 5 次、每档 30 次；
| | | 原始 cycles 与墙钟摘要已存

Notebook 从头顺序执

行 | 已执行并归档 | | src/pynq_puf3/ 内板测本体；10-31 JSON/log 单独归档
板级错误恢复 | PUF3 完整矩阵 NOT_RUN | 旧 release 为 9/9 checks、7/7 reset，不
| | | 移作当前通过
连续请求 | 已验证有限次数 | PUF3 全容量 KAT 与 30 次 warm 采
| | | 样；旧 release 的 50 次往返另列
当前实现时序 / DRC 部分域签核 | WNS +0.104 ns、TNS 0、DRC 0
Error/0 Critical；RO 计数器未签核、
| | | methodology 有 Critical

当前 RO-PUF/DNA
通路
已集成、会话内功能通过 | quality=127/128；连续 5 次重建、
HWKEY 开关及 KAT 恢复通过；可靠
| | | 性/保密隔离未验收
完整 1089 组板测 | NOT_RUN | 800 组超接口容量；本稿不承诺全量板
| | | 级支持
板上 ISA 抽样 | NOT_RUN | 历史仿真 49/50，ma_data 因非对齐访
| | | 存失败；不称全套 ISA 通过

续表 3-16

工作项 | 当前状态 | 证据与边界
RV64、完整异常与抢 占矩阵 | 未验收 | 不作为当前 RV32 bare-metal 演示的已 验证能力
小时级资源泄漏与冷 启动重复性 | not_measured | 无 RSS/FD 长时曲线，不以有限次数 请求替代
FCLK 与完整实物取 证 | 部分完成 | mcycle/PS 时基估测 99.9723 MHz；正 面照片已有，完整丝印、跳线和 SD 镜 像取证仍待补
实际交付 Skill | pynq-overlay-workflow S01–S05 已 收口 | 最新离线 64 测试、16/16 变异；L2/L3 属较早版本，泛化结论仍受限（§2.5.3）
clean-clone / 交付包 | D05 硬件端到端未完成；交付改为 delivery/ 四个独立 ZIP | 11-02 解包校验（host 61 项、Skill 61 通过/3 跳过、固件 BIN 与 candidate 一致、elaboration）通过；不含 Vivado 重建与实板，不等于干净环境硬件复现 （§3.4）

### 3.4 复现说明

本节给出从克隆仓库到上板的复现路线、命令与判据。所有命令在仓库根目录执行；输出

写入新的 build/local/reproduce/<run>/ 或脚本默认的 build/local/ 忽略目录，不覆盖 已跟踪的 candidate/、build/metadata/ 与 10-31 板测原件。任一步非零退出即保存日志并停

止，不以历史结果补齐。逐步说明与常见问题见仓库 report/reproduce_from_zero.md，本 节与其一致。按目的选择路线：

- A 运行已发布 PUF3：§3.4.1 克隆 → §3.4.3 第 0 步身份核对 → §3.4.5 上板。证明匹配 candidate 的本次板测，不代表从源码重建。
- B 从源码重建：§3.4.3 全部 → §3.4.4 → §3.4.5（使用新 candidate）。逐层验证软件、RTL、 固件、实现与本次板测，须保存新结果，不能把 10-31 板测绑定到新 bit。
- C 校验交付包：§3.4.6。证明包完整性、离线单测、固件 BIN 一致与源集 elaboration，不 运行 Vivado 或实板。

### 3.4.1 仓库结构与原始记录

仓库按赛题 3.3.5.4 推荐的 README.md、src、sim、build、board、data、skill、report 八项组织，另有 tools、archive、delivery 等补充目录（表 3-17）。2026-11-02 起原 docs/ 并入

report/：技术报告移至 report/technical/，设计说明移至 report/design/，从零复现指

南为 report/reproduce_from_zero.md。当前 PUF3 及其共享依赖保留在根目录；独立历 史工程（旧 PYNQ v1、PUF-only、CPU-DMA、PUF v2 等）隔离在 archive/history/ 的 相同相对子树，其中脚本的相对路径属于当时布局，仅作源码追溯，不作为当前复现命令。

表 3-17 仓库目录与复现用途

目录 | 内容 | 复现中的用途
board/ vivado_zynq7000_ xc7z020_pynq_puf3/ | build.tcl、ro_corner_sta.tcl、package.py、 opt_design 前置 hook 与时序 XDC；rtl/ 下 soc_top.v、key_mmio.v 两个变体； candidate/ 为已验证工件、manifest 与 reports | Vivado 重建入口；现成 工件上板与身份核对

board/
vivado_zynq7000_
xc7z020_ascon/、

board/
atk_navigator_7020/

PUF3 导入的 axi_bram_ctrl_0、
blk_mem_gen_0 XCI 与历史 PL-only 工程配 置；板卡与引脚资料

构建依赖；不是上板入口

src/ | rtl/（CPU 及 ascon/、keys/、pynq/）； firmware/pynq_svc_puf/ 及其复用的 pynq_svc/、ascon_hw_rv32/；pynq/ 公共 API 与帧协议；pynq_puf3/ 板测 Notebook
源码与板端入口
ascon/ | 生产 C（ascon_c/aead/）与 Python 实现 （pyascon/）
纯软件 AEAD 源
sim/ | ascon/（host 标准验证、独立 RTL 回归、锁定 参考 reference/）；pynq_puf3/run.py（真实 RV32 联合仿真）；keys/（DNA_PORT、 BUFG、LUT 行为模型）
离线验证
build/ | 共享 RO 环路 hook 与 pblock 约束； metadata/ 中冻结的源集核对与交付校验记录
构建支持；本机输出写
入忽略目录 build/

local/
data/ | ascon/（锁定 KAT、扩展与置换向量、规范及 来源）；pynq_puf3/（10-31 主采样）；pynq/ （旧 release 板测）
判据与原始样本

skill/pynq-overlay-workflow/

独立 Skill、示例与测试 | 单测；与工程构建无关
report/ | technical/（本报告 PDF）、design/、
| llm_collab/、reproduce_from_zero.md

说明、协作记录与逐步
复现指南

续表 3-17

目录 | 内容 | 复现中的用途
tools/ | verify_puf3_sources.py、verify_delivery.py、 restore_records.py、package_delivery.py | 身份校验、交付包校验、 原件恢复与打包
archive/ | history/ 隔离的历史工程源码；evidence/ 原 始记录 ZIP 与索引 | 追溯；不参与当前构建
delivery/ | 当前源码、历史源码、Skill、技术报告四个 ZIP 与 manifest.json | 交付包校验

tasks/、
project_log/、
image/、submission/

任务看板、实际进度与踩坑记录、界面截图、旧
提交流程说明

追溯；不参与构建

Git 只跟踪源码、配置、已验证 candidate 与当前板测原件。本报告引用的 data/ascon/

results/、build/reports/ | 与 | build/local/proj_backup_first_time_20261027/
等 历 史 原 件 保 存 在 | archive/evidence/raw_records_20261102.zip；tools/
restore_records.py 按原路径把其中 data/ 与 build/ 记录恢复到本机忽略目录，已有文件字 节不同即拒绝覆盖。开发机本地的历史 PL-only bitstream（build/local/board_bitstream/） 未入库，也不在该归档中。

git clone https://github.com/HChenZ/amd_fpga_2026.git
cd amd_fpga_2026
git rev-parse HEAD | # 记录版本
git status --short | # 新克隆应无输出
python -X utf8 tools/restore_records.py | # 按需：恢复附录 C 与 host 样本测试所需的归档原件

### 3.4.2 环境与版本

表 3-18 环境与版本

项 | 版本或要求
源码 | 在新目录克隆，记录 git rev-parse HEAD 与 git status --short；不在已 有开发副本上强制同步或覆盖旧构建
身份核对 | Python 3.10 及以上（既有记录为 3.12–3.14）与 Git；不需要 Vivado、交叉编译 器或板卡
host 标准验证 | Python 与主机 GCC（锁定 C 参考编译为共享库后经 ctypes 调用）；推荐 Linux/WSL，Windows 下须在同一环境中可找到 gcc，并设置 PYTHONUTF8=1 （见 §3.4.3）
RTL 与联合仿真 | Icarus Verilog（iverilog/vvp）；PUF3 归档记录为 Icarus 14.0 (devel)
固件工具链 | xPack riscv-none-elf-gcc 15.2.0，rv32im_zicsr/ilp32、-O2；build.py 的 -- prefix 填 gcc 可执行文件名或完整路径

续表 3-18

项 | 版本或要求
EDA | Vivado 2025.2（build.tcl 版本不符即报错退出）；器件 xc7z020clg400-1、top pynq_puf3_wrapper；不升级 IP
测试与校验 | pytest；PyMuPDF 仅用于交付包校验读取报告 PDF（python -m pip install pytest PyMuPDF）
板卡 | 正点原子领航者 ZYNQ7020 与厂家移植 PYNQ 2.7.0 镜像；10-31 板测记录 Python 3.8.2、Linux 5.4.0-xilinx-v2020.2 armv7l；网口与电脑同网段

### 3.4.3 离线验证：源集身份、host、RTL 与联合仿真

# 0 源集与工件身份（无需 Vivado / 交叉编译器 / 板卡）

python -X utf8 tools/verify_puf3_sources.py
python -X utf8 tools/verify_puf3_sources.py --compile --output build/local/reproduce/run_01/source_check.json # 1 host 标准验证与失败契约（需主机 gcc；--report 指向新目录，避免覆盖恢复出的归档原件；
# 中文 Windows 先设置 PYTHONUTF8=1，PowerShell 写法 $env:PYTHONUTF8=1）

python -X utf8 sim/ascon/run_validation.py --report build/local/reproduce/run_01/host_validation.json
python -X utf8 sim/ascon/check_failure_contract.py --report build/local/reproduce/run_01/failure_contract.json python -X utf8 sim/ascon/test_harness.py
# 2 独立 RTL 回归（Icarus；需保留 .git 与 origin/main 引用）

python -X utf8 sim/ascon/prepare_rtl_vectors.py --output build/local/reproduce/run_01/rtl_vectors
python -X utf8 sim/ascon/run_rtl_regression.py --vectors build/local/reproduce/run_01/rtl_vectors --report
| build/local/reproduce/run_01/rtl_regression.json
python -X utf8 sim/ascon/test_rtl_harness.py --vectors build/local/reproduce/run_01/rtl_vectors --report
| build/local/reproduce/run_01/rtl_harness.json
# 3 PUF3 固件与真实 RV32 联合仿真（输出 build/local/pynq_svc_puf/ 与 build/local/pynq_puf3/sim/）

python -X utf8 src/firmware/pynq_svc_puf/build.py --prefix riscv-none-elf-gcc
python -X utf8 sim/pynq_puf3/run.py

表 3-19 离线验证判据与既有记录

步骤 | 通过判据 | 既有记录

0 源集身份 exit 0、status=PASS；56 项生产输入与 7 项构建支持

| hash 一致，5 项工件 MATCH，build_support.missing 为空；--compile 时 elaboration.exit_code=0 | build/metadata/ puf3_sources.json

1 host 标准 三条命令 exit 0；host_validation 的

| summary.failed=0（四个后端各覆盖锁定的 1,089 组 KAT）；failure_contract 无失败项；test_harness 为 unittest OK，子进程中的预期 FAIL 是注入反例 | host_validation 28,661/0； failure_contract 23,965/0； harness 5 tests OK
2 RTL 回 归 | 三条命令 exit 0；rtl_regression 的 summary.status=PASS（容量内官方 KAT 289 组加密 与解密）；rtl_harness 的 summary.failed=0 | rtl_integration_regression PASS； rtl_integration_harness 4/0

续表 3-19

步骤 | 通过判据 | 既有记录
3 固件 | 输出 BUILD OK；build.json 中 custom-0 共 22 条 （P12 1 处、P8 4 处）；同为 xPack 15.2.0 时 BIN 应与 candidate（857df29c…）逐字节一致 | candidate/reports/ firmware_build.json

3 联合仿真 exit 0；summary.json 中 result=PASS、

| normal_pass=true、 mutant_autolock_detected=true、steps=54；反例 TB 非零退出是预期结果 | candidate/reports/ cosim_summary.json

步骤 1、2 的既有记录位于 data/ascon/results/（按 §3.4.1 恢复），其中 host 结果来 自 WSL（Python 3.12.3、GCC 13.3.0）。这一层只证明 host、RTL 与仿真模型范围，不能转记 为目标硬件已跑完整 1,089 组或物理 PUF 可靠；仿真中的 RO/DNA/BUFG 与 AXI BRAM 均为行为模型。
2026-11-02 在源码版本 864520d 的干净检出（git worktree，无任何忽略文件）中，于中 文 Windows 11（Python 3.13.9、MinGW-w64 GCC 8.1.0、Icarus 14.0 devel、xPack GCC 15.2.0）按上述命令复跑：第 0 步 status=PASS、elaboration exit 0；host 28,661/0、失败契约 23,965/0；RTL 回归 PASS、反例 4/0；固件 BIN 与 COE 均与 candidate 逐字节一致；联合仿 真 54 步 PASS 且自动锁定反例被检出；随后恢复原件运行 pytest 得 122 passed / 3 skipped。 test_harness.py 在未启用 Python UTF-8 模式时报 3 个 error：子进程清理已加载的临时 DLL 时输出本地编码的错误信息，父进程解码失败，并非功能断言失败；设置 PYTHONUTF8=1 后同

一检出中 5 项全部 OK。记录见 build/metadata/offline_reproduce_check.json；该复 跑不含 Vivado 与实板。

### 3.4.4 比特流构建与新候选

# 前置：§3.4.3 第 3 步通过；build.tcl 读取 build/local/pynq_svc_puf/pynq_svc_puf.coe

vivado -mode batch -source board/vivado_zynq7000_xc7z020_pynq_puf3/build.tcl -notrace -tclargs Performance_ExtraTimingOpt 4
vivado -mode batch -source board/vivado_zynq7000_xc7z020_pynq_puf3/ro_corner_sta.tcl -notrace -tclargs build/local/pynq_puf3/vivado/pynq_puf3.runs/impl_1/pynq_puf3_wrapper_postroute_physopt.dcp build/local/pynq_puf3/ro_sta
# 可选：仅在专用重建克隆中先备份 candidate/ 再运行；该脚本会删除并重写 candidate/

python -X utf8 board/vivado_zynq7000_xc7z020_pynq_puf3/package.py

build.tcl 要求 Vivado 2025.2；若 build/local/pynq_puf3/vivado/pynq_puf3.xpr 已 存在即拒绝覆盖（应换新克隆，不盲删旧构建），缺少固件 COE 时报错。它按 §2.3.1 的源 集选择创建工程，实现后执行门禁：setup/hold slack 均不小于 0、无 DRC Error/Critical Warning、无 Netlist 29-160、1280 个 RO LUT 全部分配到 pb_ro_puf；通过时打印

PYNQ_PUF3_GATE 行与 PYNQ_PUF3_BUILD_PASS，bit/hwh 写入 build/local/pynq_puf3/ vivado/，报告在其 reports/。ro_corner_sta.tcl 只对本次布线后 checkpoint 做器件模型角 分析，RO_CORNER_STA_DONE 表示分析完成，不表示 RO 计数器时序通过。

package.py 复查门禁与 DRC 报告、联合仿真（normal 与自动锁定反例）、固件 BIN 与变体 RTL 哈希、hwh 中 FCLK0 配置（FBDIV 30、分频 10×1）、MIF 与 COE 逐字一致以及 RO 分 析所用 checkpoint，然后重写 candidate/ 并打印 PYNQ_PUF3_PACKAGE_PASS；新 manifest 的 hardware_validation 仍为 NOT_RUN，须由新板测绑定。复建不要求 bitstream 字节或 WNS +0.104 ns 逐位重现，应分别核对功能、时序、资源与新工件哈希；直接复现已发布板测时使用

board/vivado_zynq7000_xc7z020_pynq_puf3/candidate/的配套文件。

### 3.4.5 上板运行

板卡为正点原子领航者 ZYNQ7020；镜像取自厂家资料盘 4_Source_Code/5_PYNQ_

Design/IMG/ZYNQ-7020-2.7.0.zip，解压后 img 的 SHA-256 前缀 a9a48675，记录于

archive/history/board/vivado_zynq7000_xc7z020_pynq/handoff_20261028.md §B。 写卡、底板 P5 串口跳线、SD 启动模式与网络按该文件 §C 及 board/atk_navigator_7020/ 资料执行；该文件其余步骤针对旧 v1，不用于 PUF3。10-31 板测 JSON 记录了 PYNQ 与内 核版本，但未记录镜像哈希。登录板卡后：

cd /home/xilinx/jupyter_notebooks
git clone https://github.com/HChenZ/amd_fpga_2026.git # 板卡无外网时由电脑 scp 完整仓库

cd amd_fpga_2026
git rev-parse HEAD
cd board/vivado_zynq7000_xc7z020_pynq_puf3/candidate
sha256sum -c sha256sums.txt # bit/hwh/bin/coe/elf/manifest 共 6 项应全部 OK
# 浏览器打开 http://< 板卡 IP>:9090，将 src/pynq_puf3/pynq_puf3_board_test.ipynb

# 复制为新副本（保留已归档的执行版），Restart Kernel -> Run All；

# 仓库不在默认路径 /home/xilinx/jupyter_notebooks/amd_fpga_2026 时先设置 ASCON_REPO

# 默认 FULL_KAT=True、WARMUP=5、REPETITIONS=30、KAT_COUNT=529、RECONSTRUCTS=5、CLOCK_INTERVAL_S=3.0

表 3-20 板测判据与 10-31 主采样

段 | 判据（任一不满足即 FAIL） | 10-31 主采样
身份与时钟 | bit/hwh 哈希与 candidate manifest 一致；控制 ID 为 PQF3=0x33465150；服务为 pynq-svc-puf3、 simulated=false、selftest_mask=7；下载前 IO PLL FBDIV 等于 hwh 的 30；下载后由 SLCR 推算的 FCLK0 在 100±0.5 MHz 内；mcycle 对 PS 单调时钟测 得 100 MHz±1% | 99.999999 MHz（寄存器推 导）；99.9723 MHz （mcycle/PS）
容量内 KAT | SW/HW/ISE 各 289 组（PT/AD 各 0–16 B）加密结果 与官方 CT/Tag 一致、解密还原 PT，翻转 Tag 末字节 后各 289 次被拒
三模式各 289/289，坏 Tag
各 289 次拒绝
固定输入基 准 | KAT #529、PT16/AD0、HWKEY 关闭，每模式预热 5 次后加密、解密各 30 次，逐次核对 CT/Tag/PT

加密 21862/1369/3895；解
密 22562/1213/4288 cycles

续表 3-20

段 | 判据（任一不满足即 FAIL） | 10-31 主采样
PUF 会话内 流程 | 注册有效（quality>0）；5 次重建均无 mismatch/fallback；HWKEY 开启后调用者 key 的官 方密文被拒、PUF key 往返成功且重建后密文一致，关 闭后 KAT 恢复 | quality=127/128；重建 5/5
总体与输出 | result.json 中 status=PASS、exit_code=0；结果写入 新的 data/pynq_puf3/notebook_< 时间 >/
| （result.json 与 mailbox_log.txt）

notebook_20261031_
114512

新板测的 result.json 绑定本次 bit/hwh/manifest 哈希；重建产生的新 candidate 只能 由新板测证明，不得沿用 10-31 记录，也不得覆盖 10-31 主采样。原版 PYNQ Clocks 显示 150 MHz 源于其 50 MHz 参考时钟假设，不作为频率判据。src/pynq/ 中 board_demo.py、 board_benchmark.py、board_error_gate.py 绑定旧 pynq-svc-v1，不能替代该 Notebook。

### 3.4.6 交付包与报告数据复核

python -X utf8 tools/restore_records.py | # 恢复归档原件（拒绝覆盖不同字节）
python -m pytest -q -p no:cacheprovider | # 默认收集 src/pynq 与独立 Skill 测试

python -X utf8 tools/verify_delivery.py --output build/local/reproduce/run_01/delivery_check.json

pytest 的冻结基线为 122 passed / 3 skipped，3 项跳过是依赖另一工程实物工件的可选 Skill 测试，不等于实板 PASS。verify_delivery.py 在仓库外解包四个 ZIP，核对 ZIP 与成员哈希，运行 包内 host 61 项与独立 Skill 测试，用包内源码重编固件并与 candidate 的 BIN 比较，再做 PUF3

源集 elaboration；11-02 记录为 PASS（build/metadata/source_delivery_check.json）。 它不运行 Vivado 或实板；不要以 package_delivery.py 代替校验，该脚本会重写四个 ZIP 与清 单。
报告摘要、表 1-1、表 3-13/3-14 与附录 C 摘录由报告目录中的 review_evidence.py 从原

件重算核对，不手填数值。LaTeX 编辑源随 delivery/technical_report.zip 提供；在完

整仓库中恢复原件后，将包内 latex/ 解压到 report/technical/amd_fpga_2026_latex_ final/amd_fpga_2026_report/ 即可运行该脚本，build_review.py 另需 Tectonic 重新编译 并核对 PDF。

### 3.4.7 复现边界

- 干净环境从克隆到上板的完整硬件端到端复现（D05）尚未由第三方执行；本节离线步骤 已在干净检出中复跑（§3.4.3），Vivado 重建与实板未在本轮重做。
- PT/AD 超过 16 B 的 800 组官方 KAT 超出当前接口容量，板上不执行；完整 1,089 组 只在 host 验证。
- 当前已约束主时钟 setup 余量 104 ps，RO 计数器域仍未签核；更换 Vivado、IP、约束 或实现策略须重新验证，正 WNS 不保证复建结果。

- 芯片完整丝印与速度等级仍待实物核对；PUF 只有会话内功能证据，跨上电、温压、BER、 熵与唯一性未测；旧 release 的 9/9 错误门禁与 Skill L3 结果不能继承到 PUF3。
- archive/history/ 中的历史脚本保留当时相对路径，只作源码追溯；开发机本地的历 史 PL-only bitstream 未入库，克隆中不可得。

## 第四部分 总结

### 4.1 可扩展之处

以下方向为后续计划；当前最终演示已采用 PUF3，§2.3.4 的功能通过不等于下述可靠性 与安全性目标已完成。

1. 长消息支持：当前 PT/AD 各 ≤16 B，经 AXI-Lite 字节 FIFO 传输；可改为共享缓冲或 流式搬运，并补齐完整 1089 组板级 KAT 与多块吞吐测量。
2. 器件绑定密钥：在 PUF3 已接入的基础上修正 RO 计数器时序，评估关闭派生输入回读 通路、helper 持久化与失败处理，补充跨上电、温压、BER、熵及多器件统计后再评估密 钥用途。
3. 指令与算法：在现有 custom-0 状态指令上扩展 SP 800-232 中的 Ascon-Hash256/XOF128， 并以 intrinsic 封装降低软件调用开销。
4. 工程验证：补 PUF3 完整错误恢复矩阵、小时级稳定性、完整 ISA/异常矩阵与干净环境 复现；已有 mcycle/PS 时基频率估测，仪器级测量另行开展。

### 4.2 心得体会

实现可运行与结论可复核是不同目标。标准 KAT、真实 CPU 仿真与实板测试各自覆盖不 同问题，不能用某一层通过替代另一层验收；相同文件名也不能证明工件属于同一构建。因此， 发布身份、逐文件哈希、source_dirty 和源集选择应与原始样本一并保存。 性能比较首先是测量边界的比较。当前固定 16 B 输入下 MMIO 与 ISE 均降低了固件调 用周期，但 PS 侧调用仍包含 Python 与通信开销，响应时间没有获得同倍数改善。保留这一 区别，比仅展示最大的周期加速比更有解释力。
验证框架同样需要负向用例。旧 release 的错误长度、过期 epoch、重复请求及 FIFO overflow 门禁，和 PUF3 的自动锁定反例、未注册拒绝 HWKEY、坏 Tag 拒绝，分别提供有限但可复 查的证据。它们不构成无限时稳定性、完整 ISA 合规或安全认证证明；版本变化后不能靠文字 转移通过结论。

### 4.3 AMD ROSS 使用心得

AMD ROSS 是面向 Vivado 的智能体辅助套件，由 Vivado MCP Server 与一组 Skill 组成 （官方仓库 Xilinx/ross-ai-assistant，MIT 许可）。本项目在 Vivado 2025.2 上通过 OpenCode 接 入其 MCP Server，用于 RTL lint、时序端点分析、长时实现与仿真配置。以下内容均整理自 项目日志与当时的验证文档，不含新的测量。

表 4-1 AMD ROSS 在本项目中的实际用途

场景 | 用法 | 结果
接入评估 （10-17） | 只读核对官方文档与各 Skill 的版本要 求；官方下载入口返回 BIG-IP 错误 19，未取得 Server | MCP 时序/资源查询记为 not_measured， 不凭整体版本号推断兼容性
接入（10-18） | 本机 vivado-mcp-server 2026.9.1 以 stdio 方式登记到 OpenCode， VIVADO_PATH 指向 Vivado 2025.2 | 实测连接可用；工程保持 2025.2，未升级 到 2026.1
D-cache 修复后 lint | vivado-rtl-lint Skill（走其 2026.1 以前 版本的解析分支），与修复前 HEAD 对 照 | 2 条 WARNING（ASSIGN-1、ASSIGN-6） 与 HEAD 相同，修复未引入新告警
时序端点归因 | 在独立目录打开 fix_r1 布线后 DCP 的 副本，导出全部失败端点 | 156 个端点分为 ISE 93、乘法器 48、 D-cache 11、其他 4，据此确定 A→C→B 的改造顺序（§3.3.1）
双策略实现 | 在 MCP 会话中执行 build_timing_acb.tcl | exit 0，耗时 3895.571 s；WNS +0.001 / +0.007 ns，TNS 0，四类失败端点全部归 零
DSP 打包核实 | 只读查询 Remap 实现中乘法器 DSP 的寄存器属性 | 4 个 DSP 均 AREG/BREG=1，仅 1 个 PREG=1，MREG 均为 0；以实测属性代 替按编码意图推测
方法学告警处 置 | PUF v2 实验工程参照 timing-methodology Skill 的 TIMING-6/7/17 指引逐项判定 | 未加豁免、全局 clock group 或成片 false path；2025.2 不接受该 Skill 的 report_methodology -json 示例，保留文 本报告流程
ISE 波形仿真 | 在 PUF3 工程中新增 sim_ise_screenshot 仿真集，复用原 tb_key_ise 与向量 | 1502 项检查、0 错误，37390 ns 结束；图 3-5 的截图基于该仿真

价值在于把 Vivado 纳入对话闭环。打开 checkpoint、查询路径、生成报告都可以在同一 会话中完成，“查报告—定位—修改—复验” 的周期明显缩短。更重要的是能拿到完整数据：按 top-20 路径推测时只看到 ISE 复位扇出，导出全部 156 个失败端点后才发现乘法器这一第二 瓶颈，只改 ISE 一项不能保证收敛。约 65 分钟的双策略实现托管在 MCP 会话中，期间可以 并行处理其他工作。
版本边界要逐个 Skill 核对。ROSS 的完整测试基线是 Vivado 2026.1，但各 Skill 的最低版 本不同：timing-methodology、ip-configurator、ILA/VIO 调试要求 2026.1 及以上，rtl-lint 则保 留了旧版本解析分支。在 2025.2 上，lint Skill 的 linterCsvFile 参数不被支持（Synth 8-734）， 改按其 2026.1 以前的分支由.rpt 解析生成 CSV。没有取得 Server 时只记 not_measured，既 不一概拒绝，也不宣称全部兼容。
MCP 的返回文字不能直接当作结果。MCP 按命令字符串做短时去重，中途切换工程

或仿真顶层后再发相同的 close_project、launch_simulation 可能被跳过，须检查返回中的 SKIPPED、用语义相同的显式参数重发，并以真实仿真器 transcript 核实；一批命令中有一 条失败时同批其余命令全部跳过，后续 lint 读到的仍是旧文件。execute 本身可以写工程，工具 白名单不能保证 Tcl 只读，因此分析一律在 DCP 副本或新目录中进行；多个 AI 与人工 Vivado 会话并行时会抢同一工程、顶掉 run，需要独立会话与目录。本机未配置 amd-doc-search 文档 检索，不熟悉的命令和 IP 参数以 Vivado help、对象内省和报错信息确认。 结论与裁决仍由团队负责。加载 ROSS Skill 分析时序后，模型多次建议降频到 98 MHz （§2.5.2 案例一），团队否决并改为端点归因加 RTL 结构改造，最终在 100 MHz 约束下收敛。 ROSS 是工具链的一环，不替代验证本身：功能正确性靠 testbench、独立黄金参考与 KAT， 物理实现以布线后报告为准，板上行为靠实板测试。若后续升级到 Vivado 2026.1，可再评估 timing-methodology 与 ILA/VIO 调试 Skill；当前交付为保持可复现，仍固定在 Vivado 2025.2。

证 | 据 archive/history/docs/ross_usage_experience.md；archive/history/docs/ross_and_

engineering_skills_evaluation.md；archive/history/docs/timing_acb_validation.md；project_

log/lessons_learned.md 的 L68、L85、L87、L88、L91、L93 条；project_log/development_log.md

2026-10-31 ISE 截图仿真条目

## 第五部分 参考文献

1. NIST, Ascon-Based Lightweight Cryptography Standards for Constrained Devices, SP 800-232, Aug. 2025. DOI: 10.6028/NIST.SP.800-232.
2. C. Dobraunig et al., “Ascon v1.2: Lightweight Authenticated Encryption and Hashing,” Journal of Cryptographic Engineering, 2021（背景，不作 Final 向量来源）.
3. Ascon C reference implementation, ascon/ascon-c, commit 446347f2，crypto_aead/

asconaead128/ref/，CC0-1.0.
4. M. Meichlseder, pyascon, commit ed24e54a（锁定第二参考，Final 一致性由 KAT 验证） .
5. RISC-V International, The RISC-V Instruction Set Manual, Volumes I and II.
6. AMD/Xilinx, Zynq-7000 SoC Technical Reference Manual, UG585.
7. AMD/Xilinx, Vivado Design Suite User Guide: Implementation, UG904.
8. AMD/Xilinx, Vivado Design Suite User Guide: Using Constraints, UG903.
9. AMD/Xilinx, Vivado Design Suite User Guide: Design Analysis and Closure Techniques, UG906.
10. 全国大学生嵌入式芯片与系统设计竞赛 2026 FPGA 创新设计赛道《选题指南（AMD 自 主选题初级组）》（比赛名称以实际报名及可追溯原件为准）.
11. AMD/Xilinx, Ross AI Assistant（Vivado MCP Server 与 Skills），GitHub Xilinx/ross-ai-assistant，审阅提交 2cdc9eef，MIT；本项目使用 vivado-mcp-server 2026.9.1.

## 附录 A 术语与缩写

表 A-1 术语与缩写

缩写 | 全称与含义
AEAD | Authenticated Encryption with Associated Data，认证加密
AD | Associated Data，关联数据
ISE | Instruction Set Extension，本文的状态读写与置换定制指令
MMIO | Memory-Mapped I/O，存储器映射访问
KAT | Known-Answer Test，已知答案测试
WNS / TNS | Worst Negative Slack / Total Negative Slack
WHS / THS | Worst Hold Slack / Total Hold Slack
DRC | Design Rule Check
COE | BRAM 初值文件
mcycle | RV32 的 64-bit 周期来源，CSR 0xB00/0xB80
warm | 经过预热的执行状态，不等于首次调用或长期平均

## 附录 B 地址映射与指令编码

B.1 SoC 地址映射

表 B-1 SoC 地址映射

窗口 | 基址 | 从设备
MEM | 0x10000000 | 128 KiB AXI BRAM，统一代码数据空间
CLINT | 0x12000000 | 定时器与软件中断
UART | 0x20000000 | 当前 mailbox 的 RV32 uncached MMIO 端
GPIO | 0x20010000 | LED 与按键事件
ASCON | 0x30000000 | src/rtl/ascon/ascon_mmio.v 的 AEAD 寄存器
PUF KEY | 0x30000080 | PUF3 变体 board/vivado_zynq7000_ xc7z020_pynq_puf3/rtl/key_mmio.v 的状态、控制与诊 断回读
CPI | 0x60000000 | 指令与停顿等事件，不能相加替代总周期

B.2 定制指令编码

主 操 作 码 | custom-0=0x0B、funct7=0；funct3=0/1/2/3 | 分 别 为 | as-
con.w/ascon.rd/ascon.p12/ascon.p8。状态共 10 个 32-bit 字，按 s0 低/高至 s4 低/高排 列；非法索引读零、写忽略。索引取自寄存器值而非寄存器编号；具体接口与取消边界见 §2.3.3.4，不声称完整非法编码空间已验收。

B.3 MMIO 加速器寄存器

AEAD | 寄 存 器 为 | CTRL(0x00)、STATUS(0x04)、ADLEN(0x08)、MLEN(0x0C)、
KEY(0x10–1C)、NONCE(0x20–2C)、TAGIN(0x30–3C)、AD_WDATA(0x40)、 MSG_WDATA(0x44)、OUT_RDATA(0x48)、TAGOUT(0x4C–58)。标准 KAT/benchmark 使用调用者 key；HWKEY 开启时忽略 KEY 写入，START 锁存内部派生 key。
PUF3 在同一基址的 +0x80 为 STATUS，+0x84 为 CTRL（[0] START、[1] ENROLL、
[2] CLEAR、[3] HWKEY_ON、[4] HWKEY_OFF，OFF 优先）；STATUS[6]/[7] 为实际选 择/开关请求。+0x88/8C 为 DNA、+0x90 为 QUALITY、+0x94–A0 为 REF、+0xA4–B0 为 MASK、+0xB4–C0 为 DITHER、+0xC4–D0 为 RAW。这些诊断量可读，key 无直接读地址 不等于保密隔离。

B.4 PYNQ AXI-Lite 窗口

表 B-2 PYNQ AXI-Lite 窗口

窗口 | PS 基址 | 功能
CONTROL | 0x40000000（4 KiB） | 复位、按键控制、LED/复位状态；ID=0x33465150 （PQF3）、VERSION=1
MAILBOX | 0x40001000（4 KiB） | 字节 TX/RX FIFO、状态、overflow、计数、ID

地址由当前 HWH 校验；不是 RV32 本地 MMIO 地址。详细定义见 §2.3.3.7。

## 附录 C 证据索引

2026-10-31 核验：远端 c385a9d99754 的板测更新已合并到工作区；本稿最终演示对象

改为 PUF3。主要数据来自 data/pynq_puf3/notebook_20261031_114512/result.json，

工件位于 board/vivado_zynq7000_xc7z020_pynq_puf3/candidate/。旧 PYNQ release、 PL-only 与当前 PUF3 按原身份引用，不能把旧版已通过项目自动转移到当前版本。 本目录的 review_evidence.py 从原始 JSON、manifest 与报告生成下列摘录，并验证哈

希、周期重算与正文主表。输出 validation/evidence_check.json 记录证据文件哈希。墙 钟在 PUF3 JSON 中只有摘要，不能独立复算其逐次中位数。ISE 配图对应同日另列的 XSim 单元复验；报告构建仅读取证据，没有重新综合实现或上板。

下表与各节“来源”中，board/vivado_zynq7000_xc7z020_pynq_puf3/candidate/、

data/pynq_puf3/、data/pynq/ 与 src/ 下文件随 Git 跟踪；data/ascon/results/、data/

skill/、build/reports/ 与 build/local/ 下的历史原件不随 Git 跟踪，保存在 archive/

evidence/raw_records_20261102.zip，运行 python tools/restore_records.py 后按 原路径可得（§3.4.1）。

表 C-1 结论与主要证据对照

结论 | 主要证据
当前工件身份 | board/vivado_zynq7000_xc7z020_pynq_puf3/ candidate/的 manifest.json、sha256sums.txt
当前实现/资源/时序 | board/vivado_zynq7000_xc7z020_pynq_puf3/ candidate/reports/的 timing_summary.rpt、utilization.rpt、 drc.rpt、ro_corner_sta.txt
当前 KAT/benchmark/PUF | data/pynq_puf3/notebook_20261031_114512/ result.json 及同目录 mailbox_log.txt
当前执行 Notebook | src/pynq_puf3/pynq_puf3_board_test.ipynb
当前仿真与固件 | board/vivado_zynq7000_xc7z020_pynq_puf3/ candidate/reports/的 cosim_summary.json、 firmware_build.json
旧 release 全容量统计 | data/pynq/board_20261028/pynq_board_full.json，只用 于历史表 2-16
旧 release 错误恢复 | data/pynq/error_gate_20261031_112812/；执行本体为 src/pynq/pynq_board_error_gate.ipynb
host 标准与失败契约 | data/ascon/results/ 的 host_validation、reference_gate、 failure_contract JSON

续表 C-1

结论 | 主要证据
历史 PL-only 原始日志 | data/ascon/results/board/ 下 uart_20261026_sw_and_ise.txt、uart_20261027_mmio.txt、 uart_20261027_keys3.txt
历史策略记录 | data/ascon/results/strategy_sweep_20261017/
真实工程截图 | 本报告 figs/ 下 Block Design、Implemented Design、 Utilization、ISE waveform 四张 PNG；用户提供，原字节保存
ISE 截图配套自检 | data/ascon/results/ise_screenshot_20261031/，1502 checks / 0 errors
原始记录归档 | archive/evidence/raw_records_20261102.zip；tools/ restore_records.py 按原路径恢复，拒绝覆盖不同字节
实物照片 | report/technical/figs/board_photo.jpg（与图 3-1 内嵌 JPEG 字节一致）；不证明当前运行镜像或芯片速度等级

资源利用率界面和 ISE 真实仿真波形已补入图 3-2、3-5，原工程截图的缺图位置已补齐。 截图支持可视核对，不替代原始报告、板测身份或 RO 全域签核。交付不再附证据包；仓库中 的原始记录以上述归档保存，开发机本地的历史 PL-only bitstream 未入库。

C.1 当前 PUF3 工件身份

来源：board/vivado_zynq7000_xc7z020_pynq_puf3/candidate/的 manifest.json。以 下仅摘取身份与工件字段，构建时的 NOT_RUN 保持原样，后续板测另列。

{
"source_commit": "27f24bb072f53c3eb109a805ed1ecba3869c0a97", "source_dirty": true,
"part": "xc7z020clg400-1",
"top": "pynq_puf3_wrapper",
"vivado": "2025.2",
"control_id": "0x33465150", "hardware_validation": "NOT_RUN", "artifacts": {
"pynq_puf3.bit": {
"bytes": 4045693,
"sha256": "769ed24c4ef4b155eccf5b92569a94d00315f7f6913b68c7eaffe65a96fa4654" },
"pynq_puf3.hwh": {
"bytes": 158472,
"sha256": "4a0e7b95b6cb2d25c0a387e3a193aae56e937f0e2201346c67320dbc973a9675" },
"pynq_svc_puf.bin": {
"bytes": 47432,
"sha256": "857df29c4310cd483e92730d81f333a68e6970658d5cb81344faf29ec50dd9b7" },
"pynq_svc_puf.coe": {

"bytes": 327742,
"sha256": "bf3b0591afb251695d81846e6f844b2c5087b6ed38047242dcdde3fea05c6a9e" },
"pynq_svc_puf.elf": {
"bytes": 53868,
"sha256": "d7ceb168daba6de16e67f8ef753b373ee0b87e2797ab2746297a45b5d3f3ff28" }
}
}

C.2 当前实现原件

以下均来自 board/vivado_zynq7000_xc7z020_pynq_puf3/candidate/reports/，摘 录行保留原文，省略的行不补写。

C.2.1 时序原文

| Tool Version : Vivado v.2025.2 (win64) Build 6299465 Fri Nov 14 19:35:11 GMT 2025
| Date | : Fri Oct 30 19:32:48 2026
| Design | : pynq_puf3_wrapper
| Device | : 7z020-clg400
| Speed File | : -1 PRODUCTION 1.12 2019-11-22
| Design State : Physopt postRoute
TIMING-17 Critical Warning Non-clocked sequential cell | 1000
| Design Timing Summary
WNS(ns) | TNS(ns) TNS Failing Endpoints TNS Total Endpoints | WHS(ns) | THS(ns) THS Failing
Endpoints THS Total Endpoints | WPWS(ns) | TPWS(ns) TPWS Failing Endpoints TPWS Total Endpoints
0.104 | 0.000 | 0 | 73907 | 0.041 | 0.000
0 | 73907 | 0.000 | 0.000 | 0 | 28016
clk_fpga_0 {0.000 5.000} | 10.000 | 100.000
ro_clk | {0.000 20.000} | 40.000 | 25.000
clk_fpga_0 | 0.104 | 0.000 | 0 | 54424 | 0.041 | 0.000
0 | 54424 | 0.000 | 0.000 | 0 | 22191
ro_clk | 24.822 | 0.000 | 0 | 6127 | 0.115 | 0.000
0 | 6127 | 19.500 | 0.000 | 0 | 5825
ro_clk | clk_fpga_0 | 3.742 | 0.000 | 0 | 258 | 0.216
0.000 | 0 | 258
clk_fpga_0 | ro_clk | 6.994 | 0.000 | 0 | 1 | 0.428
0.000 | 0 | 1

C.2.2 整机资源原文

| Tool Version : Vivado v.2025.2 (win64) Build 6299465 Fri Nov 14 19:35:11 GMT 2025
| Date | : Fri Oct 30 19:33:12 2026
| Design | : pynq_puf3_wrapper
| Device | : xc7z020clg400-1
| Design State : Physopt postRoute
| Slice LUTs | | 18674 | | 0 | | 0 | | 53200 | 35.10 |
| Slice Registers | | 32002 | | 0 | | 0 | | 106400 | 30.08 |
| Slice Registers | | 32002 | | 0 | | 0 | | 106400 | 30.08 |

| Block RAM Tile | | 34.5 | | 0 | | 0 | | 140 | 24.64 |
| DSPs | | | 4 | | 0 | | 0 | | 220 | 1.82 |

C.2.3 DRC 汇总原文

| Tool Version : Vivado v.2025.2 (win64) Build 6299465 Fri Nov 14 19:35:11 GMT 2025
| Date | : Fri Oct 30 19:33:02 2026
| Host | : DESKTOP-5H4M0DR running 64-bit major release (build 9200)
| Command | : report_drc -file
C:/wenjian/game/FPGA2026/ours/amd_fpga_2026/build/local/pynq_puf3/vivado/reports/drc.rpt
| Design | : pynq_puf3_wrapper
| Device | : xc7z020clg400-1
| Speed File | : -1
| Design State : Fully Routed
Checks found: 824
| Rule | | Severity | Description | | Checks |
| CHECK-3 | | Warning | Report rule limit reached | | 2 | |
| DPOP-1 | | Warning | PREG Output pipelining | | 2 | |
| DPOP-2 | | Warning | MREG Output pipelining | | 4 | |
| LUTLP-2 | | Warning | Combinatorial Loop Allowed | | 256 | |
| PDRC-153 | | Warning | Gated clock check | | 256 | |
| PLHOLDVIO-2 | Warning | Non-Optimal connections which could lead to hold violations | 256 | |
| RBOR-1 | | Warning | RAMB output registers | | 3 | |
| REQP-1839 | | Warning | RAMB36 async control check | | 20 | |
| REQP-1840 | | Warning | RAMB18 async control check | | 20 | |
| RTSTAT-10 | | Warning | No routable loads | | 1 | |
| UTLZ-3 | | Warning | Resource utilization | | 4 | |

C.2.4 RO 计数器角分析与覆盖

正 WNS 不覆盖未声明的振荡环计数器。下列器件模型分析不是板上 RO 频率测量。

There are 5120 register/latch pins with no clock driven by root clock pin: pynq_puf3_i/pynq_soc_0/inst/u_soc_axi_top/u_soc_top/u_puf_key/u_puf/ro_en_reg/Q (HIGH) There are 15360 pins that are not constrained for maximum delay. (HIGH)
There are 256 combinational loops in the design. (HIGH)
FAST_MIN ring period ns: min 1.194 max 7.849 -> fastest RO 837 MHz
SLOW_MAX ring period ns: min 3.473 max 18.613 -> fastest RO 288 MHz 20-bit counter wraps above 400 MHz (window 65536 x 40 ns)
== Slow corner, RO period 3.473 ns ==
ro_osc1 intra setup -0.478 (pynq_puf3_i/pynq_soc_0/inst/u_soc_axi_top/u_soc_top/u_puf_key/u_puf/g_ro[169].cnt_reg[169][3]/C -> pynq_puf3_i/pynq_soc_0/inst/u_soc_axi_top/u_soc_top/u_puf_key/u_puf/g_ro[169].cnt_reg[169][17]/D, skew -1.545)
ro_osc1 intra hold -0.552
(pynq_puf3_i/pynq_soc_0/inst/u_soc_axi_top/u_soc_top/u_puf_key/u_puf/g_ro[170].cnt_reg[170][15]/C -> pynq_puf3_i/pynq_soc_0/inst/u_soc_axi_top/u_soc_top/u_puf_key/u_puf/g_ro[170].cnt_reg[170][16]/D, skew 1.447)
== Fast corner, RO period 1.194 ns ==
ro_osc1 intra setup -0.598 (pynq_puf3_i/pynq_soc_0/inst/u_soc_axi_top/u_soc_top/u_puf_key/u_puf/g_ro[182].cnt_reg[182][3]/C -> pynq_puf3_i/pynq_soc_0/inst/u_soc_axi_top/u_soc_top/u_puf_key/u_puf/g_ro[182].cnt_reg[182][11]/D, skew -0.705)

ro_osc1 intra hold -0.427
(pynq_puf3_i/pynq_soc_0/inst/u_soc_axi_top/u_soc_top/u_puf_key/u_puf/g_ro[170].cnt_reg[170][15]/C -> pynq_puf3_i/pynq_soc_0/inst/u_soc_axi_top/u_soc_top/u_puf_key/u_puf/g_ro[170].cnt_reg[170][16]/D, skew 0.804)

C.3 容量内 KAT 核对

来源：data/pynq_puf3/notebook_20261031_114512/result.json 的 sections.kat。核 对 3 组用例集合均为 PT/AD 各 0–16 B 的 289 组；KAT 编号 #529 是其中一组，不是用例总 数。

{
"sw": {
"kat_pass": 289,
"tag_reject": 289,
"case_count": 289
},
"hw": {
"kat_pass": 289,
"tag_reject": 289,
"case_count": 289
},
"ise": {
"kat_pass": 289,
"tag_reject": 289,
"case_count": 289
}
}

C.4 固定输入 warm 复算（KAT #529，PT16/AD0）

来 源：data/pynq_puf3/notebook_20261031_114512/result.json | 的 | sec-
tions.benchmark。5 次预热、每档 30 次；cycles 从 raw_cycles 重算，墙钟从 wall_ns_summary 换算，二者证据粒度不同。

sw/encrypt: n=30 median_cycles=21862; cycles/B=1366.3750; median_wall_ms(summary)=5.1296550 sw/decrypt: n=30 median_cycles=22562; cycles/B=1410.1250; median_wall_ms(summary)=4.8743495 hw/encrypt: n=30 median_cycles=1369; cycles/B=85.5625; median_wall_ms(summary)=4.4026330 hw/decrypt: n=30 median_cycles=1213; cycles/B=75.8125; median_wall_ms(summary)=4.1595980 ise/encrypt: n=30 median_cycles=3895; cycles/B=243.4375; median_wall_ms(summary)=4.3854980 ise/decrypt: n=30 median_cycles=4288; cycles/B=268.0000; median_wall_ms(summary)=4.1371100 hw/encrypt speedup=15.969
hw/decrypt speedup=18.600
ise/encrypt speedup=5.613
ise/decrypt speedup=5.262

C.5 旧 release 错误门禁记录

来源：data/pynq/error_gate_20261031_112812/pynq_board_error_gate.json。这 是旧 release 的证据，PUF3 完整错误矩阵仍为 NOT_RUN。

firmware_id=pynq-svc-v1 (NOT PUF3)
initial_health: PASS
over_capacity_data_17B: PASS over_capacity_ad_17B: PASS half_frame_requires_reset: PASS deadline_timeout_requires_recovery: PASS duplicate_request_id_rejected: PASS stale_epoch_rejected: PASS rx_fifo_overflow_detected: PASS repeated_requests: PASS

C.6 归档仿真回归

C.6.1 PUF3 联合仿真与固件

来 | 源：board/vivado_zynq7000_xc7z020_pynq_puf3/candidate/reports/的
cosim_summary.json、firmware_build.json。normal 为生产正例；mutant_autolock 是应 失败的原自动锁定 RTL 反例。仿真中 RO/DNA/BUFG 与 AXI BRAM 使用行为模型，不测 PUF 物理特性。

{
"cosim": {
"result": "PASS",
"steps": 54,
"normal_pass": true,
"mutant_autolock_detected": true,
"simulation_only": "behavioral RO/DNA/BUFG and AXI BRAM; KEY_WINDOW=256 via defparam" },
"custom0": {
"p12_0x200b": 1,
"p8_0x300b": 4,
"all_opcode_0x0b": 22
},
"size": "text\t | data\t | bss\t | dec\t | hex\tfilename\r\n 47424\t | 4\t | 344\t 47772\t
ba9c\tC:\\wenjian\\game\\FPGA2026\\ours\\amd_fpga_2026\\build\\local\\pynq_svc_puf\\pynq_svc_puf.elf" }

C.6.2 ISE 截图配套单元仿真

来源：data/ascon/results/ise_screenshot_20261031/。截图显示首个 P8 片段；完 整自检结果和源文件哈希另存，控制台的查询命令错误不计为 TB 断言错误。

Time resolution is 1 ps
SUMMARY ISE checks=1502 errors=0

$finish called at time : 37390 ns : File "C:/wenjian/game/FPGA2026/ours/amd_fpga_2026/sim/ascon/tb_key_ise.v" Line 63

{
"status": "PASS",
"evidence_kind": "behavioral_rtl_simulation", "tool": "Vivado/XSim 2025.2", "simulation_top": "tb_key_ise",
"checks": 1502,
"errors": 0,
"finish_ns": 37390.0,
"scope": "Existing ISE unit TB; not whole-SoC, timing, CDC, or board validation" }

C.6.3 旧 P0 smoke 与 regression

来源：build/reports/pynq_final_20261028/，保留 NOT_RUN 项，不称为 PUF3 重 跑。

{
"smoke": {
"source_head": "0f5d49c38597947dace3f1c99220deca8ef48e14", "counts": {
"PASS": 6,
"FAIL": 0,
"BLOCKED": 0,
"NOT_RUN": 9
},
"elapsed_s": 18.739,
"status": "PASS"
},
"regression_final": {
"source_head": "0f5d49c38597947dace3f1c99220deca8ef48e14", "counts": {
"PASS": 15,
"FAIL": 0,
"BLOCKED": 0,
"NOT_RUN": 1
},
"elapsed_s": 400.168,
"status": "PASS"
}
}

C.7 host 标准验证与失败契约

来源：data/ascon/results/。原始失败复现与生产修复后结果分别保留。

{
"host_validation": {
"passed": 28661,
"failed": 0,

"exit_code": 0
},
"reference_gate": {
"passed": 12936,
"failed": 0,
"exit_code": 0
},
"failure_contract": {
"passed": 23965,
"failed": 0,
"exit_code": 0
},
"failure_contract_original_reproduction": { "passed": 1,
"failed": 1,
"exit_code": 1
}
}

C.8 历史 PL-only 日志选行

来源：data/ascon/results/board/ 的 SW/ISE 和 MMIO 原始文本。当前性能主表不 用这些历史周期。

=== ASCON-AEAD128 software on RV32IM === KAT empty : PASS
KAT 1B : PASS
KAT 16B : PASS
KAT 16B+AD : PASS
KAT 17B : PASS
KAT 32B : PASS
tamper reject : PASS
KAT: 6/6 PASS
enc 16B : 20806 cycles, 4495 inst, CPI 462 (x100) enc 32B : 25787 cycles, 5606 inst, CPI 459 (x100) dec 16B : 21360 cycles, 4722 inst, CPI 452 (x100) dec 32B : 26444 cycles, 5857 inst, CPI 451 (x100) ===DONE===
=== ASCON-AEAD128 ISE (permutation in hardware) === KAT empty : PASS
KAT 1B | : PASS
KAT 16B | : PASS
KAT 16B+AD : PASS
dec round : PASS
tamper | : PASS
ISE cycles | : 2570
===DONE===
=== ASCON-AEAD128 hardware (MMIO) on RV32IM ===
KAT empty | : PASS
KAT 1B | : PASS
KAT 16B | : PASS
KAT 16B+AD : PASS
dec roundtrip: PASS

tamper reject: PASS
len reject : PASS
crypto latency : 103 cycles
full MMIO | : 688 cycles
===DONE===

C.9 历史 PL-only 时序原文

来 | 源：build/local/proj_backup_first_time_20261027/first_time.runs/

impl_1/ 的 routed timing summary。原件已归档于 archive/evidence/raw_records_

20261102.zip，恢复后按该路径可读。

| Tool Version : Vivado v.2025.2 (win64) Build 6299465 Fri Nov 14 19:35:11 GMT 2025
| Date | : Tue Oct 27 18:42:44 2026
| Design | : top_pl_bram
| Device | : 7z020-clg400
| Speed File | : -1 PRODUCTION 1.12 2019-11-22
| Design State : Routed
| Design Timing Summary
WNS(ns) | TNS(ns) TNS Failing Endpoints TNS Total Endpoints | WHS(ns) | THS(ns) THS Failing
Endpoints THS Total Endpoints | WPWS(ns) | TPWS(ns) TPWS Failing Endpoints TPWS Total Endpoints
0.087 | 0.000 | 0 | 55572 | 0.021 | 0.000
0 | 55572 | 3.750 | 0.000 | 0 | 17227

C.10 历史策略 sweep 记录

逐 项 记 录 见 | strategy_sweep_summary.json， 位 于 | data/ascon/results/

strategy_sweep_20261017/。该历史默认/最优 WNS 为 −0.942/ − 0.118 ns；不与不同 源集的 PUF3 run 混作单补丁效果。校验清单包含该文件哈希。

C.11 实物照片与工程截图

图 3-1 为已有板卡正面照片；图 2-10、2-11、3-2、3-5 分别为用户提供的 Block Design、 Implemented Design、Utilization 和 ISE 波形截图，每张只出现一次。四张 PNG 逐字节复制 并保存 SHA-256，工程名、数值、波形及控制台记录保持原样。

vivado_block_design.png
SHA-256 0bd4c00d440e6383c67189dfdfd83e5fc6279eb30ec67ee4a6b540aa3e9201c6 vivado_implemented_design.png
SHA-256 7931afa35924144401781e4f1529f6bca8d9d5b585a5a7dd0c3b52d96c023e91 vivado_utilization.png
SHA-256 1047372c228582332d7d1c4abcd6cb79dcfa2d56fffb9dec91173f2c4952b2cf vivado_ise_waveform.png
SHA-256 4fef2cc0498695c3c9d8a11f3ad4bfd0924e2433d8f3914090eee160f06ad4ac

C.12 PUF3 功能与历史原型边界

当前来源：data/pynq_puf3/notebook_20261031_114512/result.json。下列结果证 明会话内功能，不证明跨上电恢复、BER、熵、温压或唯一性；REF/RAW/MASK/DNA 可读， 也不证明保密隔离。

{
"clock": {
"fclk0_mhz_register_derived": 99.999999, "fclk0_mhz_measured_mcycle": 99.9723, "pynq_clocks_fclk0_mhz": 150.0, "measurement": {
"mcycle": [
1417316,
302040308
],
"host_s": [
353.655703317,
356.662766276
]
}
},
"functional": {
"enroll_quality": 127,
"reconstructs_stable": 5,
"caller_key_rejected_under_puf_key": true, "same_ciphertext_after_reconstruct": true, "kat_restored_after_hwkey_off": true,
"puf_key_hw_encrypt_cycles": 1676,
"limits": "in-session only (helper volatile); REF/MASK/RAW/DNA readable; entropy/BER/temperature/cross-power-cycle not measured"
},
"timing_signoff_ro_domain": false,
"cross_power_cycle": "not_measured"
}

历史来源：data/ascon/results/board/uart_20261027_keys3.txt，保留 v2 抢跑失败和 v3 通过片段；历史 quality=128 不覆盖当前的 127。

# 来源：XCOM 串口捕获（COM7 / 115200 8N1），原始字节见 xcom_raw_20261027_keys3.XDat

# 本文件含两段连续捕获：

# | 第 1 段 = PUF 握手 v2 固件（固件未等 idle 抢跑，读数误判，结论作废，仅作问题记录）

# | 第 2 段 = v3 固件（先等 idle 再发 START），板级全通过

[第 1 段：v2 固件 —抢跑误判]

STATUS boot : 00000001 busy=1 enrolled=0 done=0 quality=0 STATUS pre-enr: 00000001 busy=1 enrolled=0 done=0 quality=0 STATUS enrol: 00000023 quality=0
FAIL enroll not marked
FAIL quality=0
STATUS pre-rec: 00007f05 busy=1 enrolled=1 done=0 quality=127 STATUS recon: 00007f26
FAIL
[第 2 段：v3 固件 —板级通过]

STATUS boot : 00000001 busy=1 enrolled=0 done=0 quality=0

STATUS idle : 0000003a busy=0 enrolled=0 done=1 quality=0 STATUS enrol: 00008026 quality=128
STATUS recon: 00008026
PASS key subsystem: enroll + reconstruct stable

## 附录 D 研制历程、证据分级与统计口径

D.1 研制历程

表 D-1 研制历程

阶段 | 时间 | 已发生结果
资产恢复 | 2026-09 | 从原始 ZIP 恢复真实 XC7Z020 baseline，与 Kintex legacy 分开保存
标准锁定 | 2026-10-07 | 固定 Final 规范、参考实现提交、许可、KAT 与 SHA-256
三方案集成 | 2026-10-09–16 | AEAD RTL、MMIO、ISE 接入，目标固件仿真与安全 契约验证
时序收敛 | 2026-10-17–20 | 33 组策略及结构改造；双策略芯片内部时序通过
历史 PL-only 板测 | 2026-10-26–27 | SW/ISE/MMIO 三镜像代表 KAT 与 warm 周期记录
PYNQ 发布 | 2026-10-28 | 独立 BD、bit/hwh/固件对应；三模式各 289 组容量内 KAT 与坏 Tag 拒绝
PYNQ 验证收口 | 2026-10-29 | Notebook 顺序执行、30 次 warm benchmark、9/9 错误 门禁与每模式 50 次往返
PUF3 集成 | 2026-10-30 | 修正 FCLK 分频与 HWKEY 显式选择；同一 overlay 的 容量内 KAT、benchmark、PUF 流程通过
最新板测归档 | 2026-10-31 | PUF3 三模式各 289 组、30 次采样及 PUF 流程再次通 过；作为本稿最终演示对象；旧 release 错误门禁仍另列

D.2 设计准则与证据分级

接口先于实现；未测量项不填零、不计为通过。分别记录 hardware_measured、simulation、 implementation_report 与 not_measured。正 WNS 只说明该 run 在给定约束下通过，不等于 最大频率或跨温压稳定性。相同模块源文件不等于共享一个硬件实例；全 SoC 资源不充作某一 加速通路的独立面积。
当前 PUF3 的 bit/hwh/固件由 candidate/manifest 与逐文件哈希对应。打包 source_commit、实现 context source_head 和板测工件身份分别记录；板测 JSON 未保 存 Git HEAD，不补填其他版本的提交。构建 source_dirty=true，须结合 source_sha256、 excluded_from_build 与构建输入，不能只 checkout 单个 commit 即宣称可复现。

D.3 术语与统计口径

表 D-2 术语与统计口径

术语 | 定义
三方案 | SW 为软件 AEAD；HW/MMIO 为 CPU 读写寄存器的 AEAD 外设； ISE 为状态读写与 P8/P12 定制指令
周期加速比 | 同次运行、相同输入与操作下 SW cycles / 目标 cycles；不是 PS 响应 时间加速比
固件调用周期 | RV32 svc_aead_encrypt/decrypt 边界 mcycle 差值，不含 PS/UART
PS 调用墙钟 | PS 侧一次 mailbox 调用时间，含 Python、MMIO、串口及等待
历史 P0/PL-only | 三套独立基准固件对应的 bitstream，仅为历史对照
当前最终演示 PUF3 | 一个 overlay 内 SW/HW/ISE 与 PUF/HWKEY；服务 pynq-svc-puf3； PT/AD 各 ≤16 B；工件仍存 candidate/
旧 PYNQ release | 不含 PUF、服务 pynq-svc-v1；其 9/9 错误门禁与历史性能不迁移到 PUF3
配置/测量频率 | 配置 100 MHz；HWH/SLCR 推导 99.999999 MHz；mcycle/PS 时基 估测 99.9723 MHz，非 Fmax

## 插图目录

1-1 设计与验证流程 | | 3
2-1 处理器与 SoC 总体框图 | | 5
2-2 RV32 处理器流水线微架构 | | 7
2-3 IF 级数据通路与冲刷语义 | | 8
2-4 EX 级功能单元与多周期握手状态图 | | 9
2-5 D-cache 与总线请求时序 | | 10
2-6 历史 PL-only 工程结构 | | 14
2-7 Ascon 置换数据通路 | | 16
2-8 三种实现的调用路径对比 | | 19
2-9 PS/PL 协同通路结构 | | 23
2-10 PUF3 的 Vivado Block Design | | 24
2-11 PUF3 实现后器件视图与时序摘要 | | 25
2-12 PUF3 板测数据重排 | | 27
2-13 PUF3 内的 RO-PUF/DNA 密钥原型 | | 28
2-14 软件分层与调用关系 | | 30
3-1 系统实物正面照片 | | 37
3-2 PUF3 实现后资源利用率 | | 39
3-3 历史 PL-only 时序收敛记录 | | 41
3-4 五层验证体系与证据流 | | 42
3-5 ISE 置换执行的真实 XSim 波形 | | 44
3-6 历史 PL-only 串口日志摘录 | | 46

## 表格目录

1-1 主要性能指标 | | 3
2-1 处理器功能单元组成 | | 4
2-2 处理器设计取舍 | | 6
2-3 SoC 地址窗口与外设 | | 11
2-4 流水线控制事件优先级 | | 12
2-5 与加速及时序收敛相关的结构改造 | | 13
2-6 Ascon-AEAD128 参数 | | 15
2-7 MMIO 加速器寄存器 | | 17
2-8 定制指令编码与语义 | | 18
2-9 三种方案的可比性边界 | | 19
2-10 PS/PL 数据通道选择依据 | | 20
2-11 CONTROL 窗口寄存器 | | 21
2-12 MAILBOX 窗口寄存器 | | 21
2-13 服务帧类型 | | 22
2-14 Overlay 时序与实现结果 | | 24
2-15 仿真与主机侧验证 | | 25
2-16 历史 PYNQ release 容量内 KAT 周期统计（非 PUF3） | | 26
2-17 PYNQ 通路未闭环项 | | 27
2-18 实板观测与失败保留 | | 29
2-19 设计平台与工具链 | | 31
2-20 协作分工与智能体工作流 | | 33
2-21 案例一：拒绝降频，按端点归因完成 100 MHz 收敛（10-18） | | 34
2-22 案例二：交叉审阅另一模型的结论，报告收缩到有证据的范围（10-29） . . . . | 34
2-23 案例三：团队发现板测漏接 PUF，重新划定测试组合（10-30） | | 34
2-24 技能包的提炼与验证 | | 35
3-1 整体完成情况 | | 37
3-2 工程成果清单 | | 38
3-3 当前 PUF3 实现时序与 DRC | | 39
3-4 发布身份记录 | | 40
3-5 时序收敛历史记录 | | 41
3-6 验证体系与层级划分 | | 42
3-7 L0 标准一致性检查 | | 43
3-8 L1 模块级 RTL 验证 | | 44

3-9 L2 系统级自动回归 | | 45
3-10 L3 历史 PL-only 镜像 KAT 与篡改拒绝 | | 45
3-11 缺陷发现与处置 | | 47
3-12 验证未闭环项 | | 47
3-13 当前 PUF3 固定输入周期与加速比 | | 48
3-14 PS 调用中位墙钟 | | 49
3-15 历史 PL-only 周期对照 | | 49
3-16 完成度与判据矩阵 | | 50
3-17 仓库目录与复现用途 | | 52
3-18 环境与版本 | | 53
3-19 离线验证判据与既有记录 | | 54
3-20 板测判据与 10-31 主采样 | | 56
4-1 AMD ROSS 在本项目中的实际用途 | | 60
A-1 术语与缩写 | | 63
B-1 SoC 地址映射 | | 64
B-2 PYNQ AXI-Lite 窗口 | | 65
C-1 结论与主要证据对照 | | 66
D-1 研制历程 | | 77
D-2 术语与统计口径 | | 78
