HChenZ/amd_fpga_2026/ascon/readme.md

# 算法代码与本机旧工程

更新：2026-11-01。ascon_c/aead 与 pyascon 是标准算法/host参考验证相关代码，被多个固件/工具复用，
不绑定某一个overlay。XOF保留为原目录，不是当前PUF3主演示功能。
锁定的独立reference在sim/ascon/reference；其来源/hash/许可不因本次说明更新改变。

本机ASCON.xpr及其缓存是旧top_pl_bram开发工程，不是当前PUF3 BD入口；不因目录名含Ascon就作为主演示工程。
当前PUF3请按report/design/version_entrypoints.md选择，程序与工程文件不改、不删除。
