HChenZ/amd_fpga_2026/data/readme.md

# 向量、当前板测与原始记录

- ascon/保留Final标准来源、KAT和固定向量，供源码验证使用；结果日志不混入源码附件。
- pynq_puf3/保留当前10-31主采样，身份PQF3/固件pynq-svc-puf3，绑定已验证candidate。
- pynq/是旧v1的对照记录，不是PUF3的错误门禁。
- 原始host/ISA/实现/高级实验/恢复/Skill记录压缩归档在archive/evidence，字节不改；本机恢复副本被忽略。

原始记录可能保留当时的路径、称谓和版本标识，不能为修改对外文字而篡改；交付源码不包含这些记录包。
记录路径的中性显示别名不改变原字节。需要重新测量时另建run，不改旧结果的日期或通过状态。
