HChenZ/amd_fpga_2026/board/vivado_zynq7000_xc7z020_pynq_puf3/readme.md

# pynq_puf3：三模式 SW/HW(MMIO)/ISE 服务 + PUF v1，单一 bitstream

2026-11-02 隔离补注：旧v1/PUF-only工程已移至archive/history/board；下文当时相邻工程路径仅保留设计语境。
当前构建/固件/Notebook及共享IP路径不改，当前源包另附必要依赖。交付从project_board.md和delivery/README.md开始，
不再把旧证据包作为比赛附件；原始记录仍保留在仓库归档。

**2026-11-01 入口说明**：本目录是当前主演示，PUF3 意为三模式 + PUF v1，不是 PUF 第三代。
板测用 src/pynq_puf3/pynq_puf3_board_test.ipynb，默认 FULL_KAT=True；旧 src/pynq 的三个 CLI
仍为 pynq-svc-v1，不能只换 --release 路径使用。本轮仅说明分责，不改程序或工件。
生成 manifest 的 NOT_RUN 是打包时快照，当前板测以10-31 result.json的工件绑定为准；不要直接改 manifest 成 PASS。
共享依赖与历史入口见 report/design/version_entrypoints.md。

2026-10-30；owner TBD。独立入口：不打开、不修改 PYNQ 发布版
（`../vivado_zynq7000_xc7z020_pynq/release/`）、`../vivado_zynq7000_xc7z020_pynq_puf/`
与 JTAG 工程；共享的 `src/rtl/soc_top.v`、`src/rtl/keys/key_mmio.v` 也没有改。

## 为什么需要它

| overlay | 三模式加速比 | PUF |
|---|---|---|
| PYNQ 发布版（`rtl_p0`，ID `PYNQ`） | 有，已上板 | 无 |
| pynq_puf（`src/rtl` PUF 版，ID `PFU1`） | 无（固件是 keys_rv32 自检） | 有，仍是 NOT_RUN |
| **pynq_puf3（本目录，ID `PQF3`）** | 有 | 有 |

pynq_puf 不能直接换成三模式固件，原因是 `src/rtl/soc_top.v` 会在 PUF 密钥就绪时
（复位后约 0.65 ms）**自动并永久**把 `key_hw_sel` 置 1。之后 `ascon_mmio` 忽略 CPU 写入的 KEY，
HW 模式就过不了官方 KAT。仿真反例证明了这一点：同一份固件配原 RTL，开机自检
mask 只有 `0x05`，HW 模式丢失（`reports/cosim_mutant_autolock.log`）。

## FCLK0 时钟配置（2026-10-30 板测发现后修正）

第一版候选（bit `56b3bc45…`）在板上读回 `pynq.Clocks.fclk0_mhz = 93.75`，身份检查阶段即失败。
根因：PYNQ 加载 overlay 时只把 hwh 里的 FCLK0 **分频值**写进 SLCR，IO PLL 保持启动镜像的配置。

| 项 | 第一版 hwh | 板上启动镜像 | 结果 |
|---|---|---|---|
| PS 晶振 | 33.333333 MHz | 33.333333 MHz（厂家 base BD） | — |
| IO PLL | FBDIV 48 → 1600 MHz（IP 自选） | FBDIV 30 → 1000 MHz | 不一致 |
| FCLK0 分频 | 4 × 4 | 由 PYNQ 照 hwh 写入 | 实际 1000/16 = **62.5 MHz** |
| PYNQ 读回 | — | 原版 PYNQ 2.7 `_ClocksZynq` 固定假设 50 MHz 参考 | 50 × 30 / 16 = **93.75 MHz** |

厂家 base BD 的 FCLK1 142.857 = 1000/7、FCLK3 200 = 1000/5，与 IO PLL 1000 MHz 吻合。
修正后的 `build.tcl` 固定 `PCW_OVERRIDE_BASIC_CLOCK=1`、`PCW_IOPLL_CTRL_FBDIV=30`、
分频 10 × 1，得到 1000/10 = 100 MHz；时序约束仍按 10 ns 签核。门禁目标没有放宽。

注意：修正后原版 `pynq.Clocks.fclk0_mhz` 会显示 **150 MHz**（50 × 30 / 10），这是它的参考时钟
假设造成的，不是真实频率。板测 Notebook `src/pynq_puf3/pynq_puf3_board_test.ipynb` 因此改为：
1. 下载前读 SLCR，IO PLL FBDIV 必须等于 hwh 的 30，否则拒绝下载；
2. 下载后用 hwh 的晶振值（33.333333）由 SLCR 推算 FCLK0，必须为 100 ± 0.5 MHz；
3. 用 RV32 `mcycle`（Y01K 帧末 8 字节为发帧时刻 mcycle）对 PS 单调时钟做独立测量，
   间隔 3 s，必须为 100 MHz ± 1 %；
4. 原版 PYNQ 读数和它假设的参考时钟只记录，不参与判定。

PYNQ 发布版和 pynq_puf 的 hwh 同样是 FBDIV 48、分频 4 × 4，在这块板上实际同样是 62.5 MHz。
cycles 与加速比不受影响（都按 mcycle 计），但"板上 100 MHz"的说法对它们不成立。
这两个工程不属于本目录，本次未改。

## 改了什么

| 层 | 文件 | 变化 |
|---|---|---|
| RTL | `rtl/soc_top.v`（复制自 `src/rtl/soc_top.v`） | `key_hw_sel = hwkey_on & key_have`，不再在 `key_valid` 时自动锁定 |
| RTL | `rtl/key_mmio.v`（复制自 `src/rtl/keys/key_mmio.v`） | CTRL[3] HWKEY_ON、CTRL[4] HWKEY_OFF（OFF 优先，复位为关）；STATUS[6] key_hw_sel、STATUS[7] hwkey_on |
| 固件 | `src/firmware/pynq_svc_puf/` | 由 pynq_svc 加上 Y01P/Y01K 帧；固件 ID `pynq-svc-puf3`；开机自检和 Y01E 前先关 HWKEY |
| PS / board test | `src/pynq_puf3/pynq_puf3_board_test.ipynb` | 单文件 Notebook，内含 PQF3 驱动、`Puf3BridgeRegs`、`PynqPuf3Transport.puf_command()`、KAT、benchmark 和 PUF 流程 |
| BD | `build.tcl` | 与 pynq_puf 相同（FIXED_IO/DDR 外接、RO pblock、门禁），只换 COE、变体 RTL 和 ID `0x33465150` |

`puf_opt_pre.tcl` 是 `../vivado_zynq7000_xc7z020_pynq_puf/puf_opt_pre.tcl`（56929b0）的快照；
`pynq_puf3_timing.xdc` 是同目录 `pynq_puf_timing.xdc`（ro_clk 生成时钟）的快照，
内容与提交 5eb64a5 中的版本逐字节一致。

Y01Q/Y01R/Y01S/Y01E 的字节格式与发布版完全一致，所以三模式 cycles 的测量口径不变。
但加速比必须在本 bitstream 上**重新测量**，不能沿用发布版的数字。

### PUF 帧（Y01P → Y01K）

Y01P 16B：`'Y01P' | u32 version=1 | u32 cmd | u32 seq`。cmd：0 STATUS、1 ENROLL、
2 RECONSTRUCT、3 HWKEY_ON、4 HWKEY_OFF。

Y01K 112B：`magic | u16 version | u16 flags | u32 cmd | u32 seq | u32 result | u32 STATUS |
u32 DNA_LO | u32 DNA_HI | u64 op_mcycle | REF16 | MASK16 | RAW16 | DITHER16 | u64 now_mcycle`。
末8字节是发帧时刻 mcycle，不是零填充；本处只按已实现固件更正说明。
result：0 OK、1 TIMEOUT、2 NOT_ACCEPTED、3 BAD_CMD、4 BAD_VERSION、5 NO_PUF_KEY、6 BUSY_STUCK。

固件策略（不是硬件强制）：ENROLL/RECONSTRUCT 开始前关 HWKEY；HWKEY_ON 只在
key_ready=1、enrolled=1、mismatch=0、fallback=0、busy=0 时执行，否则返回 NO_PUF_KEY，
所以 DNA-only 降级密钥不会被当作 PUF 密钥使用。

## 构建与离线检查（仓库根目录）

```sh
python -X utf8 src/firmware/pynq_svc_puf/build.py
python -X utf8 sim/pynq_puf3/run.py
vivado -mode batch -source board/vivado_zynq7000_xc7z020_pynq_puf3/build.tcl -notrace -tclargs Performance_ExtraTimingOpt 4
vivado -mode batch -source board/vivado_zynq7000_xc7z020_pynq_puf3/ro_corner_sta.tcl -notrace -tclargs build/local/pynq_puf3/vivado/pynq_puf3.runs/impl_1/pynq_puf3_wrapper_postroute_physopt.dcp build/local/pynq_puf3/ro_sta
python -X utf8 board/vivado_zynq7000_xc7z020_pynq_puf3/package.py
```

`ro_corner_sta.tcl` 是 `../vivado_zynq7000_xc7z020_pynq_puf/ro_corner_sta.tcl`（5eb64a5）的逐字节快照。
`package.py` 会检查 `ro_corner_sta.txt` 第一行记录的 dcp，必须就是出 bit 的那个 checkpoint。

当前候选（bit `769ed24c…`）由修正时钟后的 `build.tcl` 从头一次构建得到（impl_1，
ExtraTimingOpt + 布线后 phys_opt），没有再挑选策略。策略来历：第一版网表上 RefinePlacement
（未开布线后 phys_opt）为 −0.123；`explore_impl.tcl` 在同一网表上试了 4 个策略，ExtraTimingOpt
+0.104 最好，第一版 bit 由 `finalize_run.tcl impl_2` 写出（已作废）。修正版的 PL 布局布线结果与
第一版相同（WNS/WHS、RO 布局、ro_corner_sta 数值完全一致），变化的只有 PS7 时钟配置与固件。

`build.tcl` 拒绝复用已存在的 `build/local/pynq_puf3/vivado`。以下任一条件不满足就停止，
不复制 bit：setup/hold ≥ 0、没有 DRC Error/Critical Warning、没有 `Netlist 29-160`、
1280 个 RO LUT 全部分配到 `pb_ro_puf`。`package.py` 会复查这些门禁，并另外检查：
cosim 两个用例、固件 bin 哈希、变体 RTL 哈希，以及生成的 `.mif` 与 COE 逐字一致。

## 离线结果

候选（2026-10-30，离线门禁 PASS），完整信息见 `candidate/manifest.json`；
当前板测原始证据（最终报告唯一主采样）见 `data/pynq_puf3/notebook_20261031_114512/`。
10-30 的三次运行（含首次 62.5 MHz 失败）已于 11-01 由 c05782d 移出工作树，可从 Git 历史取回：

| 项 | 结果 |
|---|---|
| 实现 | 综合使用 Vivado Synthesis Defaults；实现使用 Performance_ExtraTimingOpt，并开启布线后 phys_opt（`build.tcl` impl_1，从头构建），FCLK0 10.000 ns |
| PS 时钟（hwh） | 晶振 33.333333 MHz，IO PLL FBDIV 30（1000 MHz，与板上启动镜像一致），FCLK0 分频 10 × 1 → 99.999999 MHz |
| Setup / hold | WNS +0.104 ns、TNS 0；WHS +0.041 ns、THS 0（73907 个端点） |
| 策略对比 | impl_1 RefinePlacement −0.123（未开布线后 phys_opt）；ExtraTimingOpt +0.104；RefinePlacement +0.025；Explore +0.016；NetDelay_low −0.244。违例路径都在 CPU 的 id_ex 前递 → dcache/id_ex CE，不在 PUF/HWKEY 逻辑 |
| DRC / PS 引脚 | 0 个 Error 或 Critical Warning；没有 `Netlist 29-160` |
| RO | 1280 个 LUT 全部分配到 `pb_ro_puf`；pblock 变为 soft，物理上只有 440 个落在区域内 |
| 资源 | 18674 LUT / 32002 FF / 34.5 BRAM tile / 4 DSP |
| BRAM 初始化 | 生成的 `.mif` 与 `pynq_svc_puf.coe` 逐字一致（32768 字） |
| HWH | `pynq_ctl_0` 位于 0x40000000，ID_VALUE 0x33465150；`pynq_mbox_0` 位于 0x40001000；FCLK0 100 MHz |
| 未签核 | 5120 个无时钟引脚（ro_en 根时钟）、15360 个无最大延迟约束的引脚、256 个有意保留的组合环；methodology TIMING-17 共 1000 条 |

### 三块电路的签核状态（与 pynq_puf 提交 5eb64a5 的方法相同）

| 部分 | 状态 | 依据 |
|---|---|---|
| CPU / Ascon / 总线（clk_fpga_0，100 MHz） | 已签核：WNS +0.104 ns，WHS +0.041 ns | 实现策略 ExtraTimingOpt + 布线后 phys_opt；每次尝试都记在 `reports/explore_impl.txt` |
| PUF 采样控制（ro_clk，25 MHz） | 已签核：WNS +24.822 ns，WHS +0.115 ns；ro_clk→clk 为 +3.742 / +0.216，clk→ro_clk 为 +6.994 / +0.428 | `pynq_puf3_timing.xdc` 把 ro_clk 声明为 FCLK0 四分频（只用于实现阶段，不加例外），无需测量 |
| 振荡环计数器（256 × 20 位） | **未签核** | 见下 |

`ro_corner_sta.tcl` 只做分析、不改 bit：它用 AMD 器件延时模型算出每个已布线环的周期，
再在每个角下用该角自己的环周期检查计数器。本候选的结果（`reports/ro_corner_sta.txt`）：

| 角 | 最快环 | 计数器 setup 最差 | 计数器 hold 最差 |
|---|---|---|---|
| Slow（周期 3.473 ns） | 288 MHz | −0.478 ns | −0.552 ns |
| Fast（周期 1.194 ns） | 837 MHz | −0.598 ns | −0.427 ns |

在两个角下，计数器都有负 slack（计数器时钟由 LUT 驱动）；快角下最快环超过 20 位计数器
在窗口内回绕的上限（400 MHz）。这一块只靠约束或上板测量签不下来，必须修改 PUF RTL，
本候选不宣称已签核。

cosim 用例：

- **normal**：54 步全部 PASS，覆盖开机自检、36 个三模式 KAT 请求和 PUF 流程。
  PUF 流程依次为：降级状态下拒绝 HWKEY → ENROLL → RECONSTRUCT → HWKEY_ON →
  HW 拒绝调用方 key（AUTH_FAILED）→ SW/ISE 不受影响 → HWKEY_OFF 后 HW KAT 恢复 →
  未知命令 BAD_CMD → Y01E 重新握手后 HWKEY 自动关闭。
- **mutant_autolock**：使用原 `src/rtl` 自动锁定 RTL，开机 mask 为 0x05，TB 以非零码退出。

## 上板

```sh
在 PYNQ Jupyter 中打开并按顺序执行
`src/pynq_puf3/pynq_puf3_board_test.ipynb`。
```

最近一次板测（2026-10-31 11:45 UTC，`data/pynq_puf3/notebook_20261031_114512/result.json`，最终报告引用）：

- Notebook 状态 `PASS`、exit code `0`；bit/hwh/manifest 哈希与 `candidate/` 一致；FCLK0 寄存器推算
  `99.999999 MHz`，mcycle/PS 时基估测 `99.9723 MHz`（非示波器/Fmax 测量）。
- SW/HW/ISE 各 289 个容量内 KAT 通过，错误 Tag 各 289 次拒绝。
- KAT #529（HWKEY 关闭）中位 cycles：加密 21862/1369/3895，解密 22562/1213/4288；HW 相对 SW 加速比
  `15.969x` / `18.600x`，ISE `5.613x` / `5.262x`。墙钟只有 summary 中位，不保存原始数组。
- PUF quality `127`（/128），5 次 reconstruct 稳定，HWKEY 隔离和关闭后 KAT 恢复均通过。
- 结论仅为 `in-session functional pass`；超过 16 B 接口的 KAT、完整错误门禁、跨电源周期、温度/BER/熵/唯一性和
  RO 振荡环计数器时序签核仍未完成。

测试分四段，全部通过才 exit 0：
1. 身份与时钟：哈希、ID、固件 ID；下载前 IO PLL FBDIV = 30，下载后 SLCR 推算 FCLK0 = 100 ± 0.5 MHz，
   mcycle 实测 100 MHz ± 1 %（见上文"FCLK0 时钟配置"；原版 `pynq.Clocks` 显示 150 属正常）；
2. 三模式 KAT：当前 Notebook 默认 `FULL_KAT=True`，每模式跑289个；False是旧6例抽样，不是本 Notebook 的 `--full-kat` CLI 参数；
3. 基准：KAT #529，预热 5 次、采集 30 次，输出中位 mcycle 和相对 SW 的加速比；
4. PUF：enroll，5 次 reconstruct 稳定且 helper 不变；HWKEY 打开后 HW 拒绝官方密文；
   PUF 密钥往返成功；reconstruct 后密文相同；HWKEY 关闭后官方 KAT 恢复。

## 限制（不得宣称）

- 每次复位都要重新 enroll（helper 是易失的），只能证明同一会话内可重复；
  熵、BER、温度、唯一性、跨上电重建均为 not_measured。
- 振荡环计数器域没有签核（ro_corner_sta 在两个角下都是负 slack），需要改 PUF RTL；
  正的 WNS 只覆盖 clk_fpga_0 和 ro_clk 两个已声明的时钟。
- REF/RAW/MASK/DITHER/DNA 可经 MMIO 读出，不能宣称保密；HWKEY 是固件策略，
  CPU 软件可以随时打开或关闭。
- 板测结果在 Notebook 的 `result.json` 和 `mailbox_log.txt` 输出存在之前一律为 NOT_RUN；当前已有一次 `in-session functional pass`，不等同于完整 PUF 验收通过。
