HChenZ/amd_fpga_2026/report/llm_collab/sessions/20261028_codex_f6619c40.md

# # AMD FPGA 2026 — PYNQ 最终集成、验证、提交与上板交接 你

- 工具：codex；模型：openai；会话：`01a1812b-1b72-7942-b088-1d17f6619c40`
- 开始：2026-10-28 14:23；用户提示 1 条；工具调用 87 次

## 用户提示（2026-10-28 14:23）

# AMD FPGA 2026 — PYNQ 最终集成、验证、提交与上板交接

你现在负责完成 AMD FPGA 2026 项目的 PYNQ 集成与最终交付。

仓库：https://github.com/HChenZ/amd_fpga_2026

**本次任务是实际完成代码、工程、验证、Git 提交与团队交接。**

## 一、项目背景与任务目标

- 开发板：正点原子领航者 ZYNQ 7020，目标器件暂按 `xc7z020clg400-1`，实物完整型号及速度等级须核实。
- 主要开发工具：Vivado 2025.2、Windows、WSL2 Ubuntu、RISC-V GCC、Python。
- PYNQ 系统镜像已经解压，Windows 路径：`E:\ZYNQ-7020-2.7.0`，目录中有 `.img` 文件。
- 用户现在无法进行开发板网络联调，晚上由队友完成上板验证。
- 队友已将新的 PYNQ Overlay 骨架、PUF 代码及相关文档合并到远端 main。

**最终目标：尽可能完成 PYNQ + 自研 RISC-V CPU + Ascon-AEAD128 的软件与硬件集成，让队友晚上拉取仓库后，按照交接文档进行上板验证。**

允许对 SoC 顶层、总线、固件等共享文件进行必要修改，不需要为了 PUF 单独设计严格隔离机制。但应优先保证已有 P0 的 Ascon 正确性、性能与上板成果不退化。

## 二、第一阶段：检查工作区并同步最新 main

开始任何修改之前，必须实际执行：

```bash
git status
git branch -vv
git branch --show-current
git worktree list
git remote -v
git fetch origin --prune
git log --oneline -12 origin/main
```

特别要求：

1. 确认当前是否在 `main` 分支。
2. 检查工作区是否干净，是否存在未提交或未跟踪文件。
3. 查看是否有其他 worktree，确认队友是否还在其他分支开发。
4. 检查本地与远端 main 的提交差异。
5. 如果当前是干净的 main，使用 `git pull --ff-only origin main` 更新。
6. 如果当前不在 main，或者工作区存在未提交修改，不要直接切换、覆盖或丢弃数据。先安全保存已有改动，再以最新 main 建立工作分支或独立 worktree。
7. 本次开发建议使用 `feat/pynq-final-integration` 分支。
8. 不得使用 `git reset --hard`、`git clean -fd` 或 force push 来处理冲突。

我此前了解到远端 main 最新为 `0f5d49c`，但你必须重新 fetch 核对，不得假设它仍是最新版本。

## 三、第二阶段：复核队友已提交的 PYNQ 实现

首先阅读：

- `AGENTS.md`
- `README.md`
- `docs/pynq_bringup_m1.md`
- `docs/freeze_checkpoint_20261027.md`
- `docs/io_timing_signoff.md`
- `board/vivado_zynq7000_xc7z020_pynq/readme.md`
- `tasks/task_board.md`
- `project_log/actual_progress.md`

重点检查：

- `src/rtl/pynq/`
- `src/firmware/pynq_svc/`
- `src/pynq/pynq_transport.py`
- `src/pynq/make_pynq_profile.py`
- `src/pynq/test_pynq_transport.py`
- `sim/pynq/`
- 现有 Vivado PYNQ 工程与源集

队友已经设计了 AXI-Lite + UART FIFO Bridge 方案：

Jupyter → Python API → AXI-Lite → UART Bridge → RISC-V 服务固件 → Ascon SW/MMIO/ISE。

**请优先复用这个方案，不要未经必要性分析重新设计一套共享 BRAM Mailbox 系统。**

检查所有模块的接口契约、状态机、复位、握手、缓存、时钟和数据格式。

现有测试结果只能作为历史证据，必须重新检查当前 main 的实际状态。

## 四、第三阶段：完成剩余代码开发

重点完成以下工作：

### 4.1 PYNQ 通信与 RTL

检查并修复：

- AXI-Lite 控制寄存器读写。
- FIFO 满、空、溢出及反压处理。
- UART Bridge 双向传输。
- SoC Reset、启动握手及状态反馈。
- 不同复位条件下的请求清理。
- Mailbox 请求与响应帧。
- 事务身份、epoch、request_id、ACK、超时及错误恢复。
- 控制寄存器与 Python 驱动之间的语义一致性。

不得通过硬编码或伪造完成信号使测试通过。

### 4.2 RISC-V 服务固件

检查并完善 `src/firmware/pynq_svc/`：

- 正确接收 Python 侧请求。
- 执行 Ascon 软件、MMIO、ISE 三种模式。
- 正确处理 key、nonce、AD、plaintext、ciphertext、tag。
- 支持加解密与官方 KAT。
- 正确拒绝错误 Tag，不返回未经认证的明文。
- 严格检查长度上限，不允许静默截断。
- 正确读取并返回 64-bit `mcycle`。
- 处理连续请求、复位、超时和异常状态。

检查交叉编译脚本是否包含写死的工具链绝对路径，尽量改为可配置方式，保证队友也能复现。

### 4.3 Python 和 Jupyter

完成真实硬件 Transport 与现有 AsconHost 的连接。

检查：

- `pynq.MMIO` 的实际访问。
- Overlay 加载与硬件身份校验。
- HWH 地址和寄存器映射。
- PYNQ 2.7.0 环境中的 Python 兼容性。
- SW/MMIO/ISE 模式选择。
- 加密、解密、Tag 和 cycles 的展示。
- 错误提示、异常处理及超时恢复。
- Notebook 从头顺序执行的可复现性。

模拟模式必须显式标注 `simulated`；真实硬件失败时不得静默回退模拟。没有真实周期数据就使用 `NOT_MEASURED`。

## 五、第四阶段：完成 Vivado PYNQ 工程

这是本轮重点。

不要只补充 GUI 操作步骤，而应尽可能完成**可复现的 Tcl 自动构建**。

基于已有：

`board/vivado_zynq7000_xc7z020_pynq/`

完成或修复：

1. PS7 配置。
2. AXI GP0 与 AXI-Lite 外设连接。
3. `pynq_ctl`、`pynq_mbox`、`pynq_soc` 集成。
4. PS/PL 时钟和复位。
5. RISC-V SoC 与 BRAM IP。
6. 对应 `pynq_svc.coe` 的 BRAM 初始化。
7. 生产 RTL 源文件选择和模块冲突检查。
8. Block Design 验证。
9. 综合、实现和 bitstream 生成。
10. 导出匹配的 `.bit`、`.hwh` 和必要的硬件信息。

注意，当前仓库已有 PUF 相关 RTL，也保留了 P0 冻结源集。

必须审查 PYNQ 当前的 `rtl_p0` 文件与 main 最新源码的差异，明确当前选择的是哪一套实现，以及是否影响原有 Ascon KAT。

优先保证 PYNQ 的 Ascon 功能正确，再考虑后续 PUF 集成；不得破坏此前已经上板验证的三套 Ascon 版本。

如果 Vivado 无法完成构建，应实际定位失败原因并尽可能修复。禁止将只通过 elaboration 或使用 IP stub 的结果视为正式 FPGA 工程通过。

## 六、第五阶段：全面执行离线验证

运行现有测试，包括：

```bash
python src/pynq/test_host_api.py
python src/pynq/test_mailbox.py
python src/pynq/test_navigator.py
python src/pynq/test_pynq_transport.py
python src/pynq/golden_checker.py
python src/pynq/make_pynq_profile.py --selftest
bash sim/pynq/elab_check.sh
bash src/firmware/pynq_svc/build.sh
```

另外按 `sim/board/readme.md` 执行适用的 smoke、regression 和 targeted validation。

必要时新增测试，重点包括：

- AXI-Lite 寄存器功能。
- UART Bridge 双向数据完整性。
- FIFO 边界与反压。
- Reset during transaction。
- Mailbox 协议、超时和错误恢复。
- Ascon 官方 KAT 与错误 Tag 拒绝。
- PS/PL 接口相关的真实 RTL 联合仿真。
- 真实服务固件与 Python 协议的一致性。

测试必须记录实际命令、退出码、PASS/FAIL、运行环境和原始证据。

若没有实物板卡或实际系统环境，板级验证必须标注 `NOT_RUN`，不能伪造通过。

## 七、第六阶段：统一通过 GitHub 仓库交付

队友晚上应该能够通过：

```bash
git pull --ff-only origin main
```

获取本次交付的代码、必要产物和交接文档。

交付规则：

1. 源代码、Tcl、XDC、Vivado 工程配置、Python、Notebook、固件源码与测试脚本全部正常纳入仓库。
2. 正式上板必须使用的最终 `.bit`、`.hwh`、`.coe`、固件文件及必要的配置，经过验证后应放入工程下明确的发布目录，例如：

   `board/vivado_zynq7000_xc7z020_pynq/release/`

3. 只保留真正需要交付的最终产物，不要提交全部 Vivado `.runs`、`.cache`、`.gen`、`.Xil` 或中间 checkpoint。
4. 对于被 `.gitignore` 忽略、但确实必须交付的少量最终文件，检查大小和来源后按需显式跟踪；不得盲目解除整个生成目录的忽略规则。
5. 如果个别产物不适合直接存入 Git，评估 Git LFS 或 GitHub Release，明确实际获取方法，并确保队友有访问权限；不能只留下本机路径。
6. 所有正式产物生成 SHA256 manifest，记录源码提交、Vivado 版本、IP 版本、bit/hwh/COE 之间的对应关系。
7. 轻量的验证报告、结果摘要及必要日志纳入仓库相应目录。
8. 不需要上传约 8GB 的厂家 PYNQ 系统 `.img`。该镜像在 `E:\ZYNQ-7020-2.7.0`，交接文档必须注明文件名、SHA256 和获取方式。
9. 保持仓库结构清楚，不创建多余的重复工程或无用压缩包。

**原则：凡是队友晚上运行项目所必需的文件，都应能够通过仓库、受控发布附件或文档中明确的外部来源找到。不能只存在于我的本地 `build/local`。**

## 八、第七阶段：编写详细的中文交接文档

请在仓库中编写：

`board/vivado_zynq7000_xc7z020_pynq/handoff_20261028.md`

这份文档是今晚队友上板的主要依据。

要求写成可以逐步照做的操作手册，而不是简略的开发总结。

必须包含：

### A. 当前开发成果

- 本次代码修改与新增模块。
- 最终源代码提交。
- 软件、RTL、固件和 Vivado 工程验证情况。
- 哪些测试实际通过。
- 哪些仍需上板。
- 所有已知风险和限制。

### B. 文件与环境

- 仓库入口。
- 最终 Vivado 工程。
- Tcl 自动构建入口。
- 固件编译入口。
- bit/hwh/COE 的实际位置。
- PYNQ 镜像的文件名、版本和来源。
- 必需的工具、版本和依赖。
- 如何验证 SHA256 和工程身份。

### C. 开发板启动

- 电源连接。
- JTAG 下载线。
- USB-UART 串口。
- P5 跳帽。
- SD Boot 设置。
- 镜像写卡。
- Linux 启动日志。
- 与路由器连接。
- 查询开发板 IP。
- 浏览器访问 Jupyter。

涉及跳帽、启动模式或供电时，必须依据实际领航者 7020 资料，不得猜测。

### D. PYNQ 上板验证

按顺序给出：

1. PYNQ Linux 启动。
2. Python/PYNQ 环境检查。
3. Jupyter 基础功能检查。
4. 加载自研 Overlay。
5. 检查 AXI-Lite 寄存器身份。
6. 测试 PS/PL Mailbox 通信。
7. 启动 RISC-V 服务固件。
8. 执行 Ascon 软件加解密。
9. 执行 Ascon MMIO 加解密。
10. 执行 Ascon ISE 加解密。
11. 官方 KAT 和错误 Tag 验证。
12. 周期数和加速比测试。

每一步都应写出实际命令或点击位置、预期结果、失败判据以及需要保存的证据。

如果某一功能在本轮尚未实现，必须明确标注，不得编写成已经可执行的操作。

### E. 故障排查和备用方案

针对以下问题分别说明：

- SD 卡无法启动。
- 串口无输出或乱码。
- 开发板无法获取 IP。
- Jupyter 无法访问。
- Overlay 加载失败。
- HWH 物理地址不匹配。
- AXI-Lite 读取异常。
- UART FIFO 数据丢失。
- RISC-V 服务固件未启动。
- Ascon KAT 错误。
- 性能数据异常。
- PYNQ 真实通信尚未打通。

保留已经通过上板验证的 PL-only Ascon 方案作为备用演示路线。

### F. 晚间验收记录

文档中留出实际填写位置：

- 板卡型号与芯片丝印。
- 镜像和 SD 卡信息。
- Linux/PYNQ/Python 版本。
- bitstream SHA256。
- UART 原始日志。
- 软件/MMIO/ISE KAT 结果。
- 真实周期与加速比。
- Vivado WNS/TNS/DRC。
- 遇到的问题及最终结论。

队友不需要重新研究代码，只要按照交接文档执行并记录结果。

同时同步更新 `README.md`、任务看板和实际开发日志，历史证据不得擅自改写。

## 九、第八阶段：使用中文提交、合并和推送 GitHub

**用户已明确授权本次开发完成后执行 commit、merge、push，不需要再次逐项请求确认。**

所有 Git 提交信息必须使用中文描述。

可以保留 Conventional Commits 英文类型前缀，但具体描述必须是中文，例如：

```text
feat(pynq): 完成PS与PL通信接口和Overlay工程
fix(pynq): 修复UART邮箱握手及FIFO状态处理
test(pynq): 补充Ascon通信与加解密回归测试
docs(pynq): 完善领航者7020上板交接文档
merge: 合并PYNQ最终集成成果
```

要求：

1. 完成代码检查、测试和文档后，审核 `git diff`、`git status`。
2. 仅提交本次任务实际修改的文件和明确需要跟踪的正式产物。
3. 确认没有误提交临时缓存、未授权的其他工作区内容、敏感数据或巨型镜像。
4. 在开发分支提交代码，Commit Message 使用中文。
5. 再次 fetch 最新 main，检查队友是否新增提交。
6. 如有远端更新，安全整合并重新运行受影响的测试。
7. 将开发成果合并进入 main，合并提交说明同样使用中文。
8. 推送远端 `origin/main`。
9. 确认远端 main 包含本次全部已验收成果，且工作区干净。
10. 记录最终 Commit SHA、提交链接和修改文件清单。

对于已经通过离线验证、但仍需晚上上板确认的成果，可以如实提交并保留 `NOT_RUN` 标记。

如果出现无法安全解决的合并冲突、提交权限问题或关键测试失败，不得强行覆盖或伪造结果。应保留已完成的提交和分支，准确报告阻塞。

## 十、最终执行报告

请在完成后用**中文**输出：

1. 当前与最终 Git 分支、Commit SHA。
2. 本次实际新增、修改的代码及功能。
3. 已执行测试和对应 PASS/FAIL。
4. Vivado 工程是否真正生成 bitstream。
5. 最终 `.bit`、`.hwh`、`.coe` 等文件在仓库中的位置。
6. 哪些功能仍需实板验证。
7. 交接文档的 GitHub 路径。
8. 是否成功合并并推送到远端 main。
9. 队友晚上拉取仓库后，第一步应该做什么。

**不要停留在调研或计划阶段。优先完成可执行开发和验证，确保队友今晚能够最大限度地直接上板，而不是重新编写代码。**

若确实无法完成某项硬件功能，保留已完成的有效成果，明确其阻塞原因和可执行的下一步。还有就是如果遇到仓库本地还有没有提交的，直接覆盖/丢弃就行

### 模型回答（2026-10-28 14:25）

我会先核对工作区、分支和远端 main，再复核 PYNQ 链路并执行构建与回归。已收到本轮 commit、merge、push 授权；实板结果会保留为 `NOT_RUN`，只发布实际构建和验证过的产物。

虽然你允许丢弃本地改动，我会先检查其内容；如有需要保留的工作，可用独立工作区继续集成。

<details><summary>工具调用 3 次</summary>

- `exec` `text(await tools.exec_command({cmd:"git status; git branch -vv; git branch --show-current; git worktree list; git remote -v; git fetch origi`
- `exec` `text(await tools.exec_command({cmd:"git pull --ff-only origin main; git switch -c feat/pynq-final-integration; Get-Content docs/pynq_bringup`
- `exec` `text(await tools.exec_command({cmd:"Get-Content src/rtl/pynq/top_pynq.v; Get-Content src/rtl/pynq/pynq_soc.v; Get-Content src/firmware/pynq_`

</details>

### 模型回答（2026-10-28 14:26）

已确认起始工作区干净、分支为 main；fetch 后远端最新仍为 `0f5d49c`，现已快进更新并建立 `feat/pynq-final-integration`。另外两个 worktree 保持原样。

当前 PYNQ 目录确实只有骨架，还没有 Tcl 构建入口或 bit/hwh。我会沿用 UART FIFO Bridge，优先补齐真实构建链，并检查固件、复位和主机协议的一致性。

<details><summary>工具调用 3 次</summary>

- `exec` `text(await tools.exec_command({cmd:"Get-Content src/rtl/pynq/pynq_mbox.v; Get-Content src/rtl/pynq/pynq_ctl.v; Get-Content src/firmware/pynq`
- `exec` `text(await tools.exec_command({cmd:"where.exe python; where.exe vivado; where.exe iverilog; Get-ChildItem C:/,E:/ -Directory | Select-Object`
- `exec` `text(await tools.exec_command({cmd:"Get-Content src/firmware/pynq_svc/svc_io.c; Get-Content src/rtl/uart_rx.v | Select-Object -Last 95; Get-`

</details>

### 模型回答（2026-10-28 14:26）

复核发现三个会影响上板的问题：服务固件的 ISE 路径漏了空消息和整块尾部的 padding；AXI 写寄存器忽略了 `WSTRB`；SoC 复位时 FIFO 清空了，但串口收发器仍可能残留半帧。我会修复这些问题并补验证。

另外，UART 两线本身没有接收端反压，原注释所说的“FIFO 满会让 SoC TX 停止”不成立。当前最大响应可完整放入 RX FIFO，但仍需验证连续传输和溢出恢复。

<details><summary>工具调用 9 次</summary>

- `exec` `text(await tools.exec_command({cmd:"@'\nfrom pathlib import Path\np=Path('src/firmware/pynq_svc/ascon_modes.c');s=p.read_text();s=s.replace(`
- `exec` `text(await tools.exec_command({cmd:"$env:PYTHONUTF8='1'\n@'\nfrom pathlib import Path\np=Path('src/firmware/pynq_svc/ascon_modes.c');s=p.rea`
- `exec` `text(await tools.exec_command({cmd:"$env:PYTHONUTF8='1'\n@'\nfrom pathlib import Path\np=Path('board/vivado_zynq7000_xc7z020_pynq/build.tcl'`
- `exec` `text(await tools.exec_command({cmd:"$env:PYTHONUTF8='1'\n@'\nimport subprocess,json,time,os\nfrom pathlib import Path\nout=Path('build/local`
- `exec` `text(await tools.exec_command({cmd:"Get-Content build/local/pynq_final/vivado.log -Tail 30; rg --files | rg 'run_cpu_regression|tb_cpu|tb_as`
- `exec` `text(await tools.exec_command({cmd:"$env:PYTHONUTF8='1'\n@'\nfrom pathlib import Path\np=Path('board/vivado_zynq7000_xc7z020_pynq/build.tcl'`
- `exec` `text(await tools.exec_command({cmd:"Get-Content src/pynq/pynq_transport.py -First 100; Get-Content sim/ascon/tb_ascon_sw.v | Select-Object -`
- `exec` `text(await tools.exec_command({cmd:"Get-Content sim/pynq/tb_pynq_bridge.v -First 180; Get-Content build/local/pynq_final/vivado_retry.log -T`
- `exec` `text(await tools.exec_command({cmd:"$env:PYTHONUTF8='1'\n@'\nfrom pathlib import Path\np=Path('src/pynq/pynq_transport.py');s=p.read_text().`

</details>

### 模型回答（2026-10-28 14:31）

Python、协议、Transport 模型和 profile 自检首轮均通过，服务固件也已用 WSL 的 GCC 13.2.0 重新编译。还发现并修复了服务帧模拟标志位解析错误，以及主机在开机自检结束前就发送 epoch 帧的问题；后者可能撑满 CPU 的 16 字节接收 FIFO。

Vivado 已完成 BD 验证，正在生成 IP 并继续综合。我正在补跑真实 CPU、服务固件和 AXI-Lite/UART 桥的联合仿真，核验模型测试覆盖不到的链路。

<details><summary>工具调用 11 次</summary>

- `exec` `text(await tools.exec_command({cmd:"$env:PYTHONUTF8='1'\n@'\nfrom pathlib import Path\n# Reuse established CPU+behavioral AXI memory wiring,`
- `exec` `text(await tools.exec_command({cmd:"Get-Content build/local/pynq_final/regression/summary.md; Get-Content build/local/pynq_final/regression/`
- `exec` `text(await tools.exec_command({cmd:"$env:PYTHONUTF8='1'\n@'\nfrom pathlib import Path\np=Path('sim/pynq/run_service.py');p.write_text('''\"\`
- `exec` `text(await tools.exec_command({cmd:"Get-Content build/local/pynq_final/vivado_retry.log -Tail 15; Get-Content build/local/pynq_final/vivado/`
- `exec` `text(await tools.write_stdin({session_id:31409,chars:"",yield_time_ms:1000,max_output_tokens:1500})); text(await tools.exec_command({cmd:"$e`
- `exec` `text(await tools.exec_command({cmd:"$env:PYTHONUTF8='1'\n@'\nfrom pathlib import Path\np=Path('src/rtl/pynq/pynq_mbox.v');s=p.read_text().re`
- `exec` `text(await tools.exec_command({cmd:"Select-String 'ERROR:' build/local/pynq_final/vivado/pynq_overlay.runs/pynq_pynq_soc_0_0_synth_1/runme.l`
- `exec` `text(await tools.exec_command({cmd:"$env:PYTHONUTF8='1'\n@'\nfrom pathlib import Path\np=Path('board/vivado_zynq7000_xc7z020_pynq/build.tcl'`
- `exec` `text(await tools.exec_command({cmd:"python -m py_compile src/pynq/ascon_host_api.py src/pynq/mailbox_protocol.py src/pynq/mailbox_backend.py`
- `exec` `text(await tools.exec_command({cmd:"$env:PYTHONUTF8='1'\n@'\nfrom pathlib import Path\np=Path('src/pynq/board_demo.py');p.write_text('''\"\"`
- `exec` `text(await tools.exec_command({cmd:"Select-String -Pattern 'ERROR:|CRITICAL' build/local/pynq_final/vivado_final.log; Get-Content src/pynq/m`

</details>

### 模型回答（2026-10-28 14:36）

完整回归在当前 main 上暴露了源集问题：原 CPU runner 没有加入新增的 PUF 模块，三套固件测试都在编译阶段失败。我保留了失败日志，并新增显式的 `--pynq-p0` 选项，用 PYNQ 已钉住的两个 P0 文件验证本轮源集，避免混入 PUF 的硬件密钥覆盖逻辑。

Vivado 首次综合也因旧辅助 RTL 使用 `i++` 而失败；全量设为 SystemVerilog 又遇到 BD module-reference 限制。接下来只为需要的辅助文件设置 SystemVerilog 类型，继续验证。

<details><summary>工具调用 8 次</summary>

- `exec` `text(await tools.exec_command({cmd:"$env:PYTHONUTF8='1'\n@'\nfrom pathlib import Path\np=Path('board/vivado_zynq7000_xc7z020_pynq/build.tcl'`
- `exec` `text(await tools.exec_command({cmd:"$env:PYTHONUTF8='1'\n@'\nfrom pathlib import Path\np=Path('sim/pynq/tb_pynq_bridge.v');s=p.read_text();s`
- `exec` `text(await tools.write_stdin({session_id:31409,chars:"",yield_time_ms:1000,max_output_tokens:2000})); text(await tools.exec_command({cmd:"Ge`
- `exec` `text(await tools.exec_command({cmd:"$env:PYTHONUTF8='1'\n@'\nfrom pathlib import Path\np=Path('sim/pynq/run_service.py');s=p.read_text().rep`
- `exec` `text(await tools.exec_command({cmd:"Get-Content build/local/pynq_final/service_1.log -Tail 12; Get-Content build/local/pynq_final/regression`
- `exec` `text(await tools.exec_command({cmd:"rg -n 'https|镜像|image|img|zip' board/atk_navigator_7020/readme.md board/atk_navigator_7020/vendor_source`
- `exec` `text(await tools.exec_command({cmd:"rg --files --hidden --no-ignore build board E:/amd_fpga_2026_backups E:/amd_fpga_2026_integration/build `
- `exec` `text(await tools.exec_command({cmd:"$env:PYTHONUTF8='1'\n@'\nimport json\nfrom pathlib import Path\ncells=[('markdown','# 领航者7020：真实 PYNQ As`

</details>

### 模型回答（2026-10-28 14:39）

新增桥测试已通过：零 `WSTRB` 无副作用、RX FIFO 填满后的溢出标志、256 字节顺序读回、清标志，以及发送中途复位。TX FIFO 满时也已改为等待空间后再完成写事务，避免静默丢字节。

PYNQ 2.7 的旧版 Python 兼容处理、真实硬件 CLI 和 Notebook 已补齐。镜像 SHA256 已算出，正在写入交接手册；Vivado 和真实服务固件联合仿真仍在运行，尚未标为通过。

<details><summary>工具调用 12 次</summary>

- `exec` `text(await tools.exec_command({cmd:"Get-Content build/local/pynq_final/vivado_build.log -Tail 8; Get-Content build/local/pynq_final/vivado/p`
- `exec` `text(await tools.exec_command({cmd:"rg --files --hidden --no-ignore E:/amd_fpga_2026_key_lifecycle E:/FPGA C:/fpga_work E:/VIVADO | rg '\\.b`
- `exec` `text(await tools.exec_command({cmd:"rg -n 'wire.*pc|reg.*pc|rx_count' src/rtl/cpu_core.v board/vivado_zynq7000_xc7z020_pynq/rtl_p0/soc_top.v`
- `exec` `text(await tools.exec_command({cmd:"$env:PYTHONUTF8='1'\n@'\nfrom pathlib import Path\np=Path('sim/pynq/tb_pynq_svc.v');s=p.read_text().repl`
- `exec` `text(await tools.exec_command({cmd:"Get-CimInstance Win32_Process -Filter \"name='vvp.exe'\" | Select-Object ProcessId,CommandLine; Get-Cont`
- `exec` `text(await tools.exec_command({cmd:"Select-String -Pattern '1000ac80|10002450' build/local/pynq_svc/pynq_svc.disasm.txt -Context 4,5; Get-Co`
- `exec` `text(await tools.exec_command({cmd:"Get-Content build/local/pynq_final/service_1.log -Tail 10; Get-Content build/local/pynq_final/vivado_bui`
- `exec` `text(await tools.exec_command({cmd:"rg -n 'uart_ctrl|uart_.*\\(' board/vivado_zynq7000_xc7z020_pynq/rtl_p0/soc_top.v; Get-Content build/loca`
- `exec` `text(await tools.exec_command({cmd:"Get-Content src/rtl/uart_ctrl.v | Select-Object -Skip 240 -First 100; Get-Content src/firmware/ascon_hw_`
- `exec` `text(await tools.exec_command({cmd:"Get-Content src/rtl/uart_ctrl.v -Tail 50; Get-Content build/local/pynq_final/service_1.log -Tail 6; Get-`
- `exec` `text(await tools.exec_command({cmd:"Select-String 'cpu_r_data' src/rtl/uart_ctrl.v -Context 0,16","max_output_tokens":1200})); `
- `exec` `text(await tools.exec_command({cmd:"Copy-Item build/local/pynq_final/service_1.log build/local/pynq_final/service_before_fix.log\nStop-Proce`

</details>

### 模型回答（2026-10-28 14:43）

联合仿真定位到了一个模型测试没有发现的关键错误：固件把 UART “接收非空”读成了 STATUS bit3，实际 RTL 定义是 bit1；bit3 是“接收 FIFO 满”。这会让固件收到部分 epoch 数据后一直等待。

已修正寄存器位并重新编译，修复前日志已保留。正在重跑真实固件链路；最终 BRAM 初始化和 bitstream 也必须使用这版固件。

<details><summary>工具调用 7 次</summary>

- `exec` `text(await tools.exec_command({cmd:"Get-Content build/local/pynq_final/service_1.log -Tail 6; Get-Content build/local/pynq_final/vivado_buil`
- `exec` `text(await tools.exec_command({cmd:"$env:PYTHONUTF8='1'\n@'\nfrom pathlib import Path\np=Path('board/vivado_zynq7000_xc7z020_pynq/handoff_20`
- `exec` `text(await tools.exec_command({cmd:"Get-Content build/local/pynq_final/service_1.log -Tail 12; Get-Content build/local/pynq_final/vivado_bui`
- `exec` `text(await tools.exec_command({cmd:"Select-String 'ERROR:' build/local/pynq_final/vivado/pynq_overlay.runs/synth_1/runme.log; Get-Content bu`
- `exec` `text(await tools.exec_command({cmd:"$env:PYTHONUTF8='1'\n@'\nfrom pathlib import Path\np=Path('sim/board/run_tests.py');s=p.read_text();need`
- `exec` `text(await tools.exec_command({cmd:"$env:PYTHONUTF8='1'\n@'\nfrom pathlib import Path\np=Path('sim/pynq/tb_pynq_svc.v');s=p.read_text().repl`
- `exec` `text(await tools.exec_command({cmd:"Get-Content build/local/pynq_final/vivado_resume.log -Tail 10; Get-Content build/local/pynq_final/servic`

</details>

### 模型回答（2026-10-28 14:49）

修复 UART 状态位后，真实 RV32 联合仿真已通过 SW/MMIO/ISE 共 36 次加密、解密和错误 Tag 拒绝。另一次加入“半帧中途复位后重新握手”的验证正在运行。

Vivado 的 SoC 综合已通过；顶层综合失败定位到导入 XCI 时残留的 `ascon_keys.coe` 依赖。Tcl 已清除旧依赖，并重新生成服务固件 BRAM，当前继续顶层构建。

<details><summary>工具调用 11 次</summary>

- `exec` `text(await tools.exec_command({cmd:"$env:PYTHONUTF8='1'\n@'\nfrom pathlib import Path\np=Path('src/pynq/board_demo.py');s=p.read_text().repl`
- `exec` `text(await tools.exec_command({cmd:"Get-Content build/local/pynq_final/vivado_resume.log -Tail 8; Get-Content build/local/pynq_final/service`
- `exec` `text(await tools.apply_patch("*** Begin Patch\n*** Update File: E:/amd_fpga_2026/board/vivado_zynq7000_xc7z020_pynq/package_release.py\n@@\n`
- `exec` `text(await tools.exec_command({cmd:"$env:PYTHONUTF8='1'\n@'\nfrom pathlib import Path\np=Path('board/vivado_zynq7000_xc7z020_pynq/package_re`
- `exec` `text(await tools.exec_command({cmd:"$env:PYTHONUTF8='1'\n@'\nfrom pathlib import Path\np=Path('sim/pynq/run_service.py');s=p.read_text().rep`
- `exec` `text(await tools.exec_command({cmd:"Get-Content build/local/pynq_final/vivado_resume.log -Tail 10; Get-Content build/local/pynq_final/regres`
- `exec` `text(await tools.exec_command({cmd:"Select-String 'C_EXT_RESET_HIGH|PCW_FPGA0_PERIPHERAL_FREQMHZ' build/local/pynq_final/vivado/pynq_overlay`
- `exec` `text(await tools.exec_command({cmd:"rg -n 'C_EXT_RESET_HIGH|ext_reset_in' build/local/pynq_final/vivado/pynq_overlay.gen/sources_1/bd/pynq/i`
- `exec` `text(await tools.exec_command({cmd:"Get-ChildItem build/local/pynq_final/vivado -Filter '*.mif' -Recurse | Select-Object -First 3 FullName; `
- `exec` `text(await tools.write_stdin({session_id:31303,chars:"",yield_time_ms:1000,max_output_tokens:1800})); text(await tools.write_stdin({session_`
- `exec` `text(await tools.clock__curr_time({})); text(await tools.exec_command({cmd:"Get-CimInstance Win32_Process -Filter \"name='vvp.exe'\" | Selec`

</details>

### 模型回答（2026-10-28 14:54）

最终 P0 完整回归已通过：三套真实 CPU 固件、COE/BIN 一致性、Host/邮箱 KAT、D-Cache 和中断定向验证均为 PASS。修订版桥测试和模型测试也已通过。

Vivado 已进入布局优化。发布目录会等实现、时序和产物核验完成后再收口；交接文档已写好启动、校验、KAT、周期取证与故障恢复步骤，正在补入最终结果。

<details><summary>工具调用 7 次</summary>

- `exec` `text(await tools.exec_command({cmd:"$env:PYTHONUTF8='1'\n@'\nfrom pathlib import Path\nimport shutil,json,ast\nreport=Path('build/reports/py`
- `exec` `text(await tools.exec_command({cmd:"Get-Content build/local/pynq_final/vivado_resume.log -Tail 10; Get-Content build/local/pynq_final/servic`
- `exec` `text(await tools.exec_command({cmd:"$env:PYTHONUTF8='1'\n@'\nfrom pathlib import Path\nimport hashlib,shutil,json\nmif=Path('build/local/pyn`
- `exec` `text(await tools.exec_command({cmd:"git diff -- src/pynq/pynq_transport.py src/rtl/pynq/pynq_mbox.v src/firmware/pynq_svc/main.c sim/board/r`
- `exec` `text(await tools.exec_command({cmd:"Get-Content build/local/pynq_final/vivado_resume.log -Tail 10; Get-Content build/local/pynq_final/vivado`
- `exec` `text(await tools.exec_command({cmd:"Get-Content build/local/pynq_final/vivado_resume.log -Tail 12; Select-String -Pattern 'WNS=|Timing const`
- `exec` `text(await tools.exec_command({cmd:"$env:PYTHONUTF8='1'\n@'\nimport subprocess,json,time\nfrom pathlib import Path\nout=Path('build/reports/`

</details>

### 模型回答（2026-10-28 15:01）

官方 corpus 驱动的真实服务联合仿真也已通过：三模式共 36 次请求，检查了加密结果、解密明文、错误 Tag 不返回明文和非零 mcycle；半帧中途复位后重新握手通过。Vivado 生成的 BRAM MIF 已与最终固件 BIN（补零到 128 KiB）逐字节核对一致。

当前实现进入第二轮布线优化，仍需等待最终 setup、hold 和 DRC 结果。发布文件、哈希清单和中文交接手册会随验收结果一起提交。

<details><summary>工具调用 4 次</summary>

- `exec` `text(await tools.exec_command({cmd:"Get-Content build/local/pynq_final/vivado_resume.log -Tail 7; Get-Content build/reports/pynq_final_20261`
- `exec` `text(await tools.exec_command({cmd:"$env:PYTHONUTF8='1'\n@'\nfrom src.pynq.make_pynq_profile import parse_hwh\nfrom pathlib import Path\np=P`
- `exec` `text(await tools.exec_command({cmd:"Get-Content build/local/pynq_final/vivado/pynq_overlay.runs/impl_1/pynq_wrapper_timing_summary_postroute`
- `exec` `text(await tools.exec_command({cmd:"Select-String 'WNS\\(ns\\)' build/local/pynq_final/vivado/pynq_overlay.runs/impl_1/pynq_wrapper_timing_s`

</details>

### 模型回答（2026-10-28 15:03）

100 MHz 实现结果已出：bitstream 已生成，最终 WNS `+0.034 ns`、TNS `0`、WHS `+0.020 ns`，setup/hold 均无失败端点，内部未约束端点为 0。

接下来核验最终 DRC，打包匹配的 bit/hwh、固件和 SHA256 清单，再完成中文提交、合并及远端 main 核验。

<details><summary>工具调用 11 次</summary>

- `exec` `text(await tools.exec_command({cmd:"Get-Content build/local/pynq_final/vivado_resume.log -Tail 8; Get-Content build/local/pynq_final/vivado/`
- `exec` `text(await tools.exec_command({cmd:"Get-Content build/local/pynq_final/vivado_resume.log -Tail 8; Get-Content build/local/pynq_final/vivado/`
- `exec` `text(await tools.exec_command({cmd:"$env:PYTHONUTF8='1'\n@'\nfrom pathlib import Path\nimport shutil\nfor f in ['build.tcl','resume.tcl']:\n`
- `exec` `text(await tools.exec_command({cmd:"git check-ignore board/vivado_zynq7000_xc7z020_pynq/release/pynq.bit board/vivado_zynq7000_xc7z020_pynq/`
- `exec` `text(await tools.exec_command({cmd:"$env:PYTHONUTF8='1'\n@'\nfrom pathlib import Path\nfor name in ['build.tcl','rebuild_firmware.tcl']:\n p`
- `exec` `text(await tools.exec_command({cmd:"Get-Content .gitattributes -First 18; git config --get core.autocrlf; Get-Content build/local/pynq_final`
- `exec` `text(await tools.exec_command({cmd:"$env:PYTHONUTF8='1'\n@'\nfrom pathlib import Path\np=Path('.gitattributes');s=p.read_text(encoding='utf-`
- `exec` `text(await tools.exec_command({cmd:"$env:PYTHONUTF8='1'\n@'\nfrom pathlib import Path\nimport shutil\np=Path('.gitattributes');s=p.read_text`
- `exec` `text(await tools.exec_command({cmd:"$env:PYTHONUTF8='1'\npython board/vivado_zynq7000_xc7z020_pynq/package_release.py\npython src/pynq/make_`
- `exec` `text(await tools.exec_command({cmd:"Get-Content build/reports/pynq_final_20261028/context.txt -Tail 12; git status --short; git fetch origin`
- `exec` `text(await tools.exec_command({cmd:"$env:PYTHONUTF8='1'\n@'\nfrom pathlib import Path\nimport subprocess,json,hashlib\np=Path('.gitattribute`

</details>

### 模型回答（2026-10-28 15:10）

中文提交、合并和推送已完成，远端 main 已更新到 `506e856`。正式 bit/hwh、服务固件和清单已进入仓库，无需依赖本机 `build/local`。

我正在最后核对远端提交和发布文件哈希。今晚仍需确认实物型号、PYNQ 启动、Overlay 加载、PS7 MMIO、容量内 289 组 KAT 和真实周期；这些均保留为 `NOT_RUN`。

<details><summary>工具调用 1 次</summary>

- `exec` `text(await tools.exec_command({cmd:"git fetch origin --prune; git status; git branch --show-current; git rev-parse HEAD; git rev-parse origi`

</details>

### 模型回答（2026-10-28 15:10）

已完成开发、验证、中文提交、合并和推送。任务：Y01/Y02/Y03/Y04/V01/V04，owner：TBD。

1. **Git 状态**：起始为 main；开发分支为 `feat/pynq-final-integration`。最终 main 与远端一致：[506e856](https://github.com/HChenZ/amd_fpga_2026/commit/506e856626dc6d59fa7ea31674a55bb42f9ced19)，工作区干净。硬件对应源码提交为 `86dc10f`。

2. **实际改动**：补齐自动 Vivado Tcl、真实硬件 CLI/Notebook、CPU/服务固件联合仿真；修复 UART 接收状态位、ISE padding、握手与证据标志、WSTRB、FIFO 和复位处理。保留 P0 软件密钥源集，未覆盖原 PUF 工程。

3. **验证结果**：指定八条命令全部 PASS；smoke、显式 P0 完整 regression、桥测试均 PASS。真实 CPU 联合仿真通过三模式共 **36 次官方向量事务**及半帧复位恢复。历史失败日志已保留。

4. **Vivado**：已真正生成 **100 MHz bitstream**。WNS **+0.034 ns**、TNS **0**、WHS **+0.020 ns**；DRC **0 Error / 0 Critical Warning**，仍有警告，已记录。

5. **正式产物**：[release 目录](https://github.com/HChenZ/amd_fpga_2026/tree/main/board/vivado_zynq7000_xc7z020_pynq/release) 包含 `pynq.bit`、`pynq.hwh`、`pynq_svc.coe/.elf/.bin`、manifest 和 SHA256 清单。仓库文件哈希已逐项核验通过。

6. **仍需实板验证**：芯片完整型号、PYNQ 启动、Overlay/PS7 MMIO、每模式容量内 289 组 KAT、连续请求及真实周期。消息和 AD 上限各 **16B**；板级结果仍为 `NOT_RUN`。

7. **中文交接文档**：[handoff_20261028.md](https://github.com/HChenZ/amd_fpga_2026/blob/main/board/vivado_zynq7000_xc7z020_pynq/handoff_20261028.md)。含接线、写卡、加载、验证、排障和晚间记录表。旧 PL-only 三版 bit 本机未找到，备用路线需持有者按冻结 SHA 提供原文件。

8. **远端交付**：已成功合并并推送 `origin/main`，再次 fetch 和远端 SHA 核验一致。

9. **队友第一步**：执行 `git pull --ff-only origin main`，打开交接文档，先核对板卡、镜像及发布文件 SHA256，再按 C、D 节上板。
