HChenZ/amd_fpga_2026/report/llm_collab/sessions/20261102_codex_45a9efb2.md

# 请帮我解决当前 AMD FPGA 项目技术报告的代码块中的长命令被强制拆行、出现

- 工具：codex；模型：openai；会话：`01a19c5c-c3a8-7d91-a49f-0ac645a9efb2`
- 开始：2026-11-02 21:06；用户提示 2 条；工具调用 77 次

## 用户提示（2026-11-02 21:06）

请帮我解决当前 AMD FPGA 项目技术报告的代码块中的长命令被强制拆行、出现 `↪` 换行符号的问题。。仅修改这个不要做其他改动

**一、先检查现有工程**

1. 检查当前 Git 仓库状态，阅读 `README.md`、`report/readme.md` 和技术报告的编译说明。
2. 找到当前最新版技术报告及对应的 LaTeX 源文件。当前报告为 85 页，PDF 路径为 `report/technical/amd_fpga_2026_latex_final/amd_fpga_2026_report/output/pdf/final_report.pdf`。
3. 如果 LaTeX 源文件不在 Git 工作树中，请检查 `delivery/technical_report.zip`，使用现有正式源文件，不要重新生成整篇报告。
4. 检查代码框使用的 LaTeX 环境、字体大小、换行配置以及换行标记的来源。

**二、排版修改要求**

1. 每条 Bash、PowerShell、Python 或 Vivado 命令在 LaTeX 源码中必须保留为一条完整的逻辑命令，不要人为添加硬换行。
2. 优先让整条命令在 PDF 的一行内显示。可以适当缩小代码字体、调整代码框左右留白或者利用页面可用宽度，但不要使字体小到难以阅读。
3. 如果命令确实太长，允许在空格等合适位置自动进行视觉换行，但不要显示 `↪`、`\` 或其他额外的换行符号，也不要将一条命令误排成两条独立命令。
4. 不得修改任何命令的实际参数、路径、执行顺序和语义。
5. 不得出现超出页边距、代码被截断、文字重叠等问题。
6. 请检查整个报告中的代码块，而不只是第 3.4 节。保持所有代码块的排版风格统一。
7. 尽量通过修改 LaTeX 的代码环境配置一次性解决，不要逐条手工修改命令。

**三、重点检查位置**

技术报告第 3.4 节“复现说明”，尤其是下面这条命令：

`python -X utf8 tools/verify_puf3_sources.py --compile --output build/local/reproduce/run_01/source_check.json`

目前它在 PDF 中被拆为两行，第二行前面出现 `↪` 标记。

我的期望是：优先完整显示为一行；放不下时可以自动换行，但显示和复制时不能产生额外命令字符。

其他较长的 Vivado、RTL 仿真及验证命令也按同一标准检查。

**四、修改范围**

本次只允许调整代码块的排版格式及必要的 LaTeX 配置。

不要修改：

- 报告正文内容、技术论述与章节结构；
- 任何实验数据、表格数值、公式、图片和图题；
- 复现命令的实际内容；
- RTL、固件、Vivado 工程、板测数据与原始证据；
- 已验证的 bitstream、HWH 和 candidate。

尽量保持原有页数、字体风格及版式，不要因为修改代码块造成新的大面积空白或分页异常。

**五、重新编译和检查**

完成后：

1. 使用仓库现有的 LaTeX/Tectonic 编译流程重新生成 PDF。
2. 检查编译日志，确保无 Overfull、缺字、未定义引用等问题。
3. 对新旧 PDF 进行对比，确认除了必要的代码排版和由此引起的正常分页变化外，没有改变技术内容。
4. 重点检查第 3.4 节所有包含命令的页面，确认没有被截断、错误换行或者溢出。
5. 如果需要保持交付材料一致，请仅更新技术报告对应的 PDF、LaTeX 源及 `technical_report.zip`，同步校验相关哈希与清单。不要重新打包其他工程文件，也不要覆盖历史冻结快照。
6. 请保留原报告的备份，并列出最终修改的文件。

**六、最终交付**

请直接完成修改、编译和排版验证，不要只给出修改建议。

补充要求：本次不需要等我人工确认，**完成 LaTeX 排版修改、重新编译和验证后，直接提交并推送到 GitHub 仓库。**

具体要求：

1. 完成上一条指令中的全部修改，确保长命令的自动换行不再显示 `↪`，且不改变命令语义。
2. 重新编译技术报告，检查 PDF 排版、代码块、页边距、编译警告以及新旧报告的技术内容一致性。
3. 如果需要同步更新 `delivery/technical_report.zip`，请使用仓库已有的打包和校验流程，同时更新对应的 manifest、SHA-256 和说明文档。不要重打其他无关交付包。
4. 所有相关检查通过后，执行 `git add`、`git commit` 和 `git push`，推送到当前仓库的远程分支。如果当前工作分支为 `main`，则推送至 `origin/main`。
5. 提交信息建议使用：`docs: 优化技术报告代码块换行与排版`
6. **仅提交本次任务涉及的文件**，不要覆盖、删除或提交其他人未完成的修改，不要使用 `git push --force`。
7. 如果发现远程分支有新提交，先安全同步并检查冲突；无法安全合并时停止推送并说明原因，不得强行覆盖。
8. 最后验证本地与远程提交一致、工作区状态正常。

**本次授权你直接完成修改、验证、commit 和 push，不需要中途向我确认。**

完成后汇报最终 PDF 路径、页数、修改文件、编译与校验结果，以及 Git commit SHA 和推送结果。

### 模型回答（2026-11-02 21:08）

我会先检查仓库状态、正式 LaTeX 源和编译流程，只调整代码块排版；完成整篇检查和交付校验后，仅提交本次相关文件并安全推送。

我会使用 PDF 技能验证新旧报告的内容与页面显示。

<details><summary>工具调用 6 次</summary>

- `exec` `text(await tools.exec_command({cmd:"git status --short; git branch --show-current; Get-Content AGENTS.md; Get-Content README.md; Get-Content`
- `exec` `text(await tools.exec_command({cmd:"Get-Content docs/project_overview.md,docs/technical_rules.md,tasks/task_board.md,project_log/actual_prog`
- `exec` `text(await tools.exec_command({cmd:"Get-ChildItem -Force | Select-Object Name; git log -5 --oneline; git remote -v; git ls-files '*final_rep`
- `exec` `text(await tools.exec_command({cmd:"git fetch origin; git status -sb; git worktree list; Get-ChildItem E:/amd_fpga_2026_backups,E:/amd_fpga_`
- `exec` `text(await tools.exec_command({cmd:"Get-ChildItem E:/amd_fpga_2026_integration/report -ErrorAction SilentlyContinue; Get-Content docs/tech_r`
- `exec` `text(await tools.write_stdin({session_id:7191,chars:"",yield_time_ms:1000,max_output_tokens:2000})); text(await tools.exec_command({cmd:"Get`

</details>

### 模型回答（2026-11-02 21:09）

当前工作区已有 5 个文件的未提交改动，我会保留并排除它们。用户指定的报告目录和 ZIP 在本地尚不存在；远程 `main` 有更新，我正在核对是否包含正式报告，再安全同步。

<details><summary>工具调用 5 次</summary>

- `exec` `text(await tools.write_stdin({session_id:7191,chars:"",yield_time_ms:1000,max_output_tokens:2500})); text(await tools.exec_command({cmd:"git`
- `exec` `text(await tools.exec_command({cmd:"git diff --stat HEAD origin/main; git diff --stat; git ls-tree -r --name-only origin/main report/technic`
- `exec` `text(await tools.write_stdin({session_id:60287,chars:"",yield_time_ms:1000,max_output_tokens:3500})); `
- `exec` `text(ALL_TOOLS.filter(x=>/create_worktree|list_artifacts/.test(x.name))); text(await tools.exec_command({cmd:"git show origin/main:AGENTS.md`
- `exec` `text(await tools.exec_command({cmd:"git clone --shared --no-checkout E:/amd_fpga_2026 E:/amd_fpga_2026_backups/report_layout_20261102; git -`

</details>

### 模型回答（2026-11-02 21:18）

已确认远程最新版包含 85 页报告，正式 LaTeX 源保存在 `delivery/technical_report.zip` 中。由于本地分支与远程已分叉，且工作区有他人改动，我会在基于最新 `origin/main` 的隔离检出中完成修复和推送，保留原工作区。

<details><summary>工具调用 6 次</summary>

- `exec` `text(await tools.exec_command({cmd:"node C:/Users/xiong/.codex/plugins/cache/openai-primary-runtime/pdf/26.1026.10807/skills/pdf/container_t`
- `exec` `text(await tools.exec_command({cmd:"@'\nimport zipfile,pathlib,shutil\nz=zipfile.ZipFile('delivery/technical_report.zip'); dest=pathlib.Path`
- `exec` `text(await tools.exec_command({cmd:"Get-ChildItem C:/Users/xiong,E:/amd_fpga_2026_backups -Filter tectonic.exe -Recurse -ErrorAction Silentl`
- `exec` `text(await tools.exec_command({cmd:"@'\nimport pymupdf as f,pathlib,re\nr=pathlib.Path('report/technical/amd_fpga_2026_latex_final/amd_fpga_`
- `exec` `text(await tools.write_stdin({session_id:80661,chars:"",yield_time_ms:1000,max_output_tokens:1300})); text(await tools.exec_command({cmd:"Ge`
- `exec` `text(await tools.exec_command({cmd:"rg -n -i 'tectonic(.exe|/|\\\\)|tectonic.*exe' delivery/snapshot_and_report_check.json build/metadata/re`

</details>

### 模型回答（2026-11-02 21:20）

已定位原因：所有代码块共用 `fvextra` 的 `codeblock` 环境，启用了任意位置换行，`↪` 来自默认续行标记。源码中的命令本身完整，无需改动。

我会统一取消续行标记，让命令优先在空格处换行，并调整代码区宽度与字距，尽量保持原字号和页数。当前还在定位可用的 Tectonic 编译器。

<details><summary>工具调用 6 次</summary>

- `exec` `text(await tools.exec_command({cmd:"@'\nfrom pathlib import Path\np=Path('report/technical/amd_fpga_2026_latex_final/amd_fpga_2026_report/pr`
- `exec` `text(await tools.exec_command({cmd:"wsl -d Ubuntu -- sh -c 'command -v tectonic; command -v xelatex; ls /mnt/c/wenjian/toolchain/tectonic/ 2`
- `exec` `text(await tools.exec_command({cmd:"$asset = (Invoke-RestMethod https://api.github.com/repos/tectonic-typesetting/tectonic/releases/tags/tec`
- `exec` `text(await tools.write_stdin({session_id:54264,chars:"",yield_time_ms:1000,max_output_tokens:1200})); text(await tools.exec_command({cmd:"Ge`
- `exec` `text(await tools.exec_command({cmd:"Get-ChildItem report/technical/amd_fpga_2026_latex_final/amd_fpga_2026_report/validation -Directory | So`
- `exec` `text(await tools.exec_command({cmd:"Get-ChildItem report/technical/amd_fpga_2026_latex_final/amd_fpga_2026_report/validation -Recurse -File `

</details>

### 模型回答（2026-11-02 21:22）

已完成统一配置修改：保留原代码字号，仅略微压缩字距、减少左右留白，并取消续行符号。正式证据核对已通过，编译正在首次下载所需的 TeX 包；完成后会检查全篇内容一致性和代码块页面。

<details><summary>工具调用 9 次</summary>

- `exec` `text(await tools.write_stdin({session_id:54264,chars:"",yield_time_ms:1000,max_output_tokens:1500})); text(await tools.exec_command({cmd:"Ge`
- `exec` `text(await tools.exec_command({cmd:"Get-ChildItem C:/Users/xiong/AppData/Local/TectonicProject -Recurse -Force | Select-Object -First 16 Ful`
- `exec` `text(await tools.exec_command({cmd:"Get-ChildItem C:/Users/xiong/AppData/Local/TectonicProject -File -Recurse | Measure-Object -Property Len`
- `exec` `text(await tools.apply_patch("*** Begin Patch\n*** Add File: E:/amd_fpga_2026_backups/report_layout_20261102/build/local/check_report_layout`
- `exec` `text(await tools.write_stdin({session_id:54264,chars:"",yield_time_ms:1000,max_output_tokens:1500})); text(await tools.exec_command({cmd:"Ge`
- `exec` `text(await tools.exec_command({cmd:"python -c \"import pymupdf,pathlib; p=pathlib.Path('build/local/report_layout_backup'); d=pymupdf.open(p`
- `exec` `text(await tools.write_stdin({session_id:54264,chars:"",yield_time_ms:1000,max_output_tokens:1800})); text(await tools.exec_command({cmd:"Ge`
- `exec` `text(await tools.exec_command({cmd:"python -c \"import pymupdf,collections; d=pymupdf.open('build/local/report_layout_backup/final_report.pd`
- `exec` `text(await tools.write_stdin({session_id:54264,chars:"",yield_time_ms:1000,max_output_tokens:1500})); text(await tools.exec_command({cmd:"py`

</details>

### 模型回答（2026-11-02 21:24）

TeX 包仍在下载，缓存持续增长，目前未收到编译错误。已准备好逐条命令比对、全文比对和代码文字边界检查；后续会据此验证换行没有改变命令，也没有引入裁切或溢出。

<details><summary>工具调用 8 次</summary>

- `exec` `text(await tools.exec_command({cmd:"python -X utf8 -c \"import pymupdf; d=pymupdf.open('build/local/report_layout_backup/final_report.pdf');`
- `exec` `text(await tools.exec_command({cmd:"python -X utf8 -c \"from pathlib import Path; p=Path('build/local/check_report_layout.py'); t=p.read_tex`
- `exec` `text(await tools.apply_patch("*** Begin Patch\n*** Update File: E:/amd_fpga_2026_backups/report_layout_20261102/build/local/check_report_lay`
- `exec` `text(await tools.write_stdin({session_id:54264,chars:"",yield_time_ms:1000,max_output_tokens:1600})); text(await tools.exec_command({cmd:"Ge`
- `exec` `text(await tools.apply_patch("*** Begin Patch\n*** Add File: E:/amd_fpga_2026_backups/report_layout_20261102/build/local/repack_report_layou`
- `exec` `text(await tools.write_stdin({session_id:54264,chars:"",yield_time_ms:1000,max_output_tokens:1800})); text(await tools.exec_command({cmd:"Ge`
- `exec` `text(await tools.exec_command({cmd:"rg -n -A 2 -B 2 'Missing character|undefined references|multiply defined|Overfull|Font Warning|fontspec `
- `exec` `text(await tools.exec_command({cmd:"wsl -d Ubuntu -- ls /usr/share/fonts/truetype/dejavu/; Get-ChildItem C:/Windows/Fonts -Filter '*Deja*'; `

</details>

### 模型回答（2026-11-02 21:27）

首次编译被检查脚本拦下：本机缺少原报告使用的 DejaVu Sans Mono，编译器回退后造成箭头和框线缺字。我会补齐原字体依赖后重编，再继续排版验证。

<details><summary>工具调用 7 次</summary>

- `exec` `text(await tools.exec_command({cmd:"$fontDir = \"$env:LOCALAPPDATA/Microsoft/Windows/Fonts\"; New-Item -ItemType Directory -Force $fontDir |`
- `exec` `text(await tools.write_stdin({session_id:63093,chars:"",yield_time_ms:1000,max_output_tokens:1500})); `
- `exec` `text(await tools.exec_command({cmd:"python -X utf8 build/local/check_report_layout.py; Get-ChildItem report/technical/amd_fpga_2026_latex_fi`
- `exec` `text(await tools.exec_command({cmd:"@'\nimport pymupdf,re,difflib\nfrom pathlib import Path\np=Path('report/technical/amd_fpga_2026_latex_fi`
- `exec` `text(await tools.write_stdin({session_id:19620,chars:"",yield_time_ms:1000,max_output_tokens:1800})); text(await tools.exec_command({cmd:"@'`
- `exec` `const base="E:/amd_fpga_2026_backups/report_layout_20261102/build/local/report_layout_check/"; for(const n of [0,1,2,3])image((await tools.v`
- `exec` `text(await tools.exec_command({cmd:"@'\nimport pymupdf,re,difflib\nfrom pathlib import Path\na=pymupdf.open('build/local/report_layout_backu`

</details>

### 模型回答（2026-11-02 21:29）

重编通过，报告仍为 **85 页**。第 3.4 节指定命令已完整显示在一行；全篇 46 处旧续行标记已消除，代码文字边界检查未发现溢出。

新旧全文去除空白、旧换行标记、页码及重复续表表头后逐字一致，图片像素也一致。已查看全部含代码页面和第 3.4 节页面，接下来仅重打技术报告包、更新校验记录，再提交推送。

<details><summary>工具调用 7 次</summary>

- `exec` `text(await tools.apply_patch("*** Begin Patch\n*** Update File: E:/amd_fpga_2026_backups/report_layout_20261102/build/local/check_report_lay`
- `exec` `text(await tools.write_stdin({session_id:15377,chars:"",yield_time_ms:1000,max_output_tokens:1800})); text(await tools.exec_command({cmd:"Ge`
- `exec` `text(await tools.exec_command({cmd:"Get-Content C:/Users/xiong/AppData/Local/Temp/opencode/delivery_check_4xrfry7w/cold_firmware.log -Tail 2`
- `exec` `text(await tools.exec_command({cmd:"Get-ChildItem C:/,E:/ -Directory | Where-Object Name -Match 'tool|riscv|xpack|wenjian|msys'; wsl -d Ubun`
- `exec` `text(await tools.exec_command({cmd:"@'\nfrom pathlib import Path\nimport json,zipfile,hashlib,shutil,subprocess\nr=Path('.').resolve(); m=js`
- `exec` `text(await tools.exec_command({cmd:"@'\nimport pathlib,zipfile,subprocess,json,re,pymupdf\nr=pathlib.Path('.').resolve(); exe=r/'build/local`
- `exec` `text(await tools.write_stdin({session_id:51392,chars:"",yield_time_ms:1000,max_output_tokens:1200})); text(await tools.exec_command({cmd:"gi`

</details>

### 模型回答（2026-11-02 21:32）

技术报告包已单独重打，其他三个交付包及历史整仓快照的哈希保持不变。包内 LaTeX 独立编译通过，逐页文字与交付 PDF 一致；新旧编译均为 0 Overfull、0 缺字、0 未定义引用，原有 Underfull 和 Fandol 提示数量未变。

通用交付检查器另在固件重编阶段因本机缺少 RISC-V 交叉编译器停止；报告包的 CRC、逐文件哈希、PDF 和排版检查均通过。我会如实记录这一环境限制。

<details><summary>工具调用 4 次</summary>

- `exec` `text(await tools.exec_command({cmd:"@'\nfrom pathlib import Path\nimport json,shutil,hashlib\nr=Path('.'); target=r/'report/technical/valida`
- `exec` `text(await tools.exec_command({cmd:"git check-ignore -v report/technical/validation/codeblock_layout_20261102/check.json; git status --short`
- `exec` `text(await tools.exec_command({cmd:"git add -- delivery/README.md delivery/manifest.json delivery/technical_report.zip project_log/actual_pr`
- `exec` `text(await tools.exec_command({cmd:"git push origin main; git rev-parse HEAD; git ls-remote origin refs/heads/main; git status --short; git `

</details>

### 模型回答（2026-11-02 21:35）

修改已提交，正在推送到 `origin/main`。本次提交仅包含报告 PDF、技术报告 ZIP、对应清单说明和验证记录；LaTeX 正文源未改。推送后会核对远程提交 SHA 和隔离检出的工作区状态，原工作区的未完成改动继续保留。

<details><summary>工具调用 1 次</summary>

- `exec` `text(await tools.write_stdin({session_id:35787,chars:"",yield_time_ms:1000,max_output_tokens:900})); `

</details>

### 模型回答（2026-11-02 21:36）

已完成并推送至 `origin/main`。

- **仍为85页**；指定长命令已在第58页完整显示为一行，全篇续行标记已取消。
- 编译及包内独立编译通过：0 Overfull、0缺字、0未定义引用；原有其他提示数量未增加。
- 新旧技术文字与图片一致，命令内容未改；代码页面检查未发现截断、重叠或溢出。
- 仅更新技术报告包，其他交付包及历史冻结快照未改。

:codex-file-citation{path="E:/amd_fpga_2026_backups/report_layout_20261102/report/technical/amd_fpga_2026_latex_final/amd_fpga_2026_report/output/pdf/final_report.pdf" purpose="output"}

修改包括 PDF、报告 ZIP（内含 LaTeX 配置）、manifest、相关说明及验证/项目记录，共14个文件：[完整修改清单](https://github.com/HChenZ/amd_fpga_2026/commit/cfa3817799f0c8fb44a18f4f114226a229f019d3)。[验证说明](E:/amd_fpga_2026_backups/report_layout_20261102/report/technical/validation/codeblock_layout_20261102/readme.md)；[原稿备份](E:/amd_fpga_2026_backups/report_layout_20261102/build/local/report_layout_backup)。

提交：`cfa3817799f0c8fb44a18f4f114226a229f019d3`。本地隔离检出与远程 SHA 一致、工作区干净；原工作区5项未提交改动完整保留。

通用交付检查的固件重编阶段因缺少交叉编译器未通过，已如实记录；报告范围校验全部通过。

## 用户提示（2026-11-02 22:51）

请帮我整理 AMD FPGA 自主选题竞赛的最终交付材料，将**项目代码、最新版技术报告、独立 PYNQ Skill 包和一份完整 README** 打包成一个真正的 `.rar` 压缩文件。

仓库：[https://github.com/HChenZ/amd_fpga_2026](https://github.com/HChenZ/amd_fpga_2026)

**请直接完成整理、README 编写、RAR 打包、完整性校验以及 Git 提交和推送，不需要中途向我确认。**

## 一、总体要求

1. 首先检查当前 Git 仓库状态，读取 `README.md`、`project_board.md`、`report/reproduce_from_zero.md`、`delivery/README.md` 等最新说明。
2. 以当前 `main` 分支中最新的正式 PUF3 工程为准，不要直接拿旧版 ZIP 或旧整仓快照充当最新代码。
3. 只整理和复制文件，不要修改已验证的 RTL、固件、Vivado 工程、bitstream、HWH、测试结果或技术报告正文。
4. 不要自行重新运行综合、生成新的 bitstream，也不要修改已经冻结的实验结果。
5. 最终生成一个包含完整交付材料的 RAR 文件，方便直接上传竞赛平台或发给评委。
6. 所有内容必须真实、完整、可追溯；不允许编造验证结果。

## 二、压缩包目录结构

建议采用以下结构，可根据实际工程依赖作必要调整：
```css
RISC-V轻量密码加速SoC/
│
├── README.md
│
├── code/
│   ├── src/
│   ├── board/
│   ├── sim/
│   ├── ascon/
│   ├── build/
│   ├── data/
│   ├── tools/
│   ├── requirements.txt（如确有必要）
│   └── README.md
│
├── technical_report/
│   ├── final_report.pdf
│   └── latex/
│
├── skill/
│   ├── pynq-overlay-workflow/
│   └── pynq_overlay_workflow_skill.zip
│
└── SHA256SUMS.txt
```

其中：

**1. code/**

必须包含当前 PUF3 工程运行、仿真、综合、上板和复现所必需的全部代码与依赖：

- RISC-V CPU RTL
- Ascon-AEAD128 软件和硬件实现
- MMIO 加速器和 ISE 定制指令
- RO-PUF / Device DNA 密钥模块
- PYNQ 控制和通信模块
- RV32 固件及交叉编译构建脚本
- Vivado Tcl、XDC、必要 XCI/IP 配置
- PYNQ Notebook 和 Python 驱动
- 必要的测试脚本、官方 KAT 与参考向量
- 当前已验证的 candidate，包括 bit、hwh、固件及对应 manifest 和报告
- 源码复现所需的共享文件和配置

请检查实际引用关系，不要机械复制几个目录后遗漏共享依赖。

当前工程复用了旧目录内的部分 IP 和固件支持文件，这些必要依赖必须保留。

历史独立项目、废弃版本、临时缓存、无关实验和旧的重复 ZIP 不要混入当前工程。确实需要保留的历史内容应单独标注，不得冒充当前 PUF3。

**2. technical_report/**

使用当前仓库最新版的技术报告，不能使用排版修改前的旧 PDF。

当前正式 PDF 路径：

`report/technical/amd_fpga_2026_latex_final/amd_fpga_2026_report/output/pdf/final_report.pdf`

将其复制为 `technical_report/final_report.pdf`。

同时从最新版 `delivery/technical_report.zip` 提取对应的可编辑 LaTeX 源码和图件，放入 `technical_report/latex/`。

检查 PDF 和 LaTeX 是否属于同一版本，保留完整的编译依赖说明。

不要重新编写技术报告，也不要改变现有数据。

**3. skill/**

包含完整的独立 `pynq-overlay-workflow` Skill：

- SKILL.md
- scripts/tools
- references
- examples
- tests
- 必要说明及许可证

同时附上最新的 `pynq_overlay_workflow_skill.zip`，方便评委独立安装。

Skill 必须保持独立使用能力，不要为打包而修改其 API、测试或原始验证记录。

## 三、编写新的总 README.md

请为压缩包根目录**重新编写一份适合比赛评委阅读的中文 README**。

不要直接复制 GitHub 仓库原 README，也不要写成过长的开发日志。

README 至少包含：

1. **作品简介**：作品名称、参赛赛道、FPGA 平台及核心功能。
2. **系统架构**：RV32 五级流水 CPU、Ascon 软件/MMIO/ISE 三路径、PYNQ PS/PL 协同、RO-PUF/DNA 通路。
3. **主要创新点**：RISC-V 定制指令密码加速、PYNQ 软硬件协同与通用 Skill、RO-PUF 器件绑定密钥原型。
4. **目录结构**：解释压缩包中各文件夹的用途。
5. **开发环境**：Vivado、Python、Icarus、RISC-V GCC、PYNQ 和目标 FPGA 型号。
6. **快速使用方法**：分别说明如何查看代码、运行主机验证、构建固件、生成 Vivado 工程、加载已有 bitstream、使用 Jupyter Notebook。
7. **性能与验证结果**：引用现有技术报告及对应 JSON，明确区分主机仿真、板级实测与历史结果。
8. **Skill 使用方法**：说明如何独立安装及使用。
9. **复现说明**：提供准确的文件路径和可执行命令。
10. **已知限制**：说明 PT/AD 长度上限、PUF 可靠性未验收、RO 计数器时序未签核及其他未完成项目。

特别注意：

- README 要让第一次接触项目的评委也能找到入口。
- 不能只写“运行相关脚本”，应尽量给出实际路径和操作命令。
- 因为源码被整理到 `code/` 子目录，必须检查相对路径；如原脚本必须从仓库根目录运行，请恢复原工程目录层级或者明确提供正确操作方法，不能让 README 中的命令失效。
- 不要声称已经完成干净环境下的 Vivado 到实板全流程复现。
- 不要混用历史 PL-only 和当前 PUF3 性能数据。

## 四、RAR 压缩要求

最终输出：

`delivery/RISC-V轻量密码加速SoC_最终交付.rar`

要求：

1. 必须生成真正的 **RAR 格式**，不能把 ZIP 或 7z 文件修改扩展名伪装成 RAR。
2. 先检测本机是否安装 WinRAR 或 `rar.exe`，优先使用 WinRAR 命令行进行打包。
3. 如果本机没有能够创建 RAR 的工具，请先检查可用的合法工具与安装方法；不能成功创建时明确报告原因，不得生成假 RAR。
4. 压缩包中必须只有一个顶层项目目录，避免解压后文件散落。
5. 使用 UTF-8 兼容的文件名，确保 Windows 中文路径正常。
6. 排除 `.git/`、`.venv/`、`__pycache__/`、Vivado 临时缓存、无关日志、个人路径、令牌、密码、代理配置和其他敏感信息。
7. 不要将现有整个 `delivery/` 递归放入新 RAR，避免压缩包嵌套和体积膨胀。
8. 保留复现所必需的 RTL、IP、约束、构建脚本、数据及已验证候选工件。

## 五、打包后校验

请不要只检查 RAR 文件是否存在。需要完成：

1. 使用 WinRAR/rar 的测试命令检查压缩包完整性。
2. 将 RAR 解压到独立临时目录，检查实际文件结构。
3. 对关键文件建立 SHA-256 清单，确认打包前后字节一致。
4. 验证 `final_report.pdf` 与当前仓库正式 PDF 一致。
5. 验证 candidate 的 bit、hwh、固件及 manifest 与仓库一致。
6. 验证 Skill 完整性及其 ZIP 的哈希。
7. 检查 README 引用的路径在解压目录中真实存在。
8. 如条件允许，在解压目录执行不修改源码的静态检查或轻量测试。
9. 记录 RAR 文件大小、总文件数、SHA-256 和检查结果。
10. 如果验证失败，修复打包问题后重新打包，不得将失败结果报告为通过。

特别注意：打包完整性验证不等于重新完成了 FPGA 实板验证，不能把两者混淆。

## 六、Git 提交与推送

完成所有必要检查后：

1. 只提交此次新增或修改的交付材料、README、manifest 和必要的打包说明。
2. 不修改无关项目文件，不覆盖队友尚未提交的更改。
3. 直接执行 `git commit` 和 `git push`，提交到当前远程分支。
4. 提交信息使用中文：`交付：整理代码、技术报告与Skill并打包RAR`
5. 如果 RAR 文件超过 GitHub 普通 Git 的单文件限制，不要强行推送，也不要未经检查改用 Git LFS。应保留本地完整 RAR，提交可推送的说明与校验清单，并明确告知我完整文件的保存位置及未推送原因。
6. 如果远程有新提交，先安全同步；不得使用 force push。

## 七、最终向我汇报

完成后请给出：

- RAR 的绝对保存路径
- RAR 文件大小
- 压缩包目录树
- 主要包含哪些代码与报告
- README 的内容结构
- 文件数量及 SHA-256
- RAR 测试、解压测试与关键哈希校验结果
- 是否发现缺失依赖、过时路径或旧版材料
- Git commit SHA
- push 是否成功

请直接执行，尽量一次完成，不需要反复询问我。

### 模型回答（2026-11-02 22:52）

我会先核对最新 `main`、当前交付说明和本机 RAR 工具，再按实际依赖整理 PUF3 代码、最新版报告和独立 Skill。打包后会实际测试、解压并核对哈希，只提交本次交付材料。

<details><summary>工具调用 6 次</summary>

- `exec` `text(await tools.exec_command({cmd:"Get-Location; git status -sb; git log -1 --oneline; git fetch origin; git status -sb; Get-Command rar,Wi`
- `exec` `text(await tools.exec_command({cmd:"Get-Content README.md,project_board.md,report/reproduce_from_zero.md,delivery/README.md; Get-Content too`
- `exec` `text(await tools.web__run({search_query:[{q:"site.rarlab.com download RAR Linux x64 command line Windows WinRAR"}],response_length:"short"})`
- `exec` `text(await tools.exec_command({cmd:"git ls-files src board sim ascon build data tools skill; Get-Content sim/ascon/support.py -First 170; Ge`
- `exec` `text(await tools.exec_command({cmd:"New-Item -ItemType Directory -Force build/local/rar_tool | Out-Null; Invoke-WebRequest https://www.rarla`
- `exec` `text(await tools.exec_command({cmd:"rg -n 'Coe_File|\\.coe|\\.v|\\.xdc' board/vivado_zynq7000_xc7z020_ascon/riscv_vivado_project/riscv_vivad`

</details>

### 模型回答（2026-11-02 22:54）

最新 `main` 已包含上次修正后的85页报告。依赖检查确认，PUF3 构建仍需要旧目录名下的两项 XCI、共享固件和 RO 约束；这些会按原层级保留。

本机未找到 WinRAR/`rar.exe`，已从 [RARLAB 官方页面](https://www.rarlab.com/download.htm)获取 RAR 7.23 命令行工具，将生成真正的 RAR 文件。历史独立工程和旧整仓 ZIP 不会放入本次包。

<details><summary>工具调用 7 次</summary>

- `exec` `text(await tools.exec_command({cmd:"@'\nimport json,pathlib\nr=pathlib.Path('.')\nfor name in ['data/ascon/provenance.json','data/ascon/deri`
- `exec` `text(await tools.exec_command({cmd:"rg -n 'results/|key_lifecycle|sw_timing|\\.json|board_' src/pynq -g 'test_*.py' | Select-Object -First 3`
- `exec` `text(await tools.exec_command({cmd:"Get-Content src/pynq/test_host_api.py | Select-Object -Skip 105 -First 50; Get-Content data/ascon/proven`
- `exec` `text(await tools.apply_patch("*** Begin Patch\n*** Add File: E:/amd_fpga_2026_backups/report_layout_20261102/delivery/final_readme.md\n+# RI`
- `exec` `text(await tools.apply_patch("*** Begin Patch\n*** Add File: E:/amd_fpga_2026_backups/report_layout_20261102/tools/package_final_rar.py\n+\"`
- `exec` `text(await tools.exec_command({cmd:"python -B -X utf8 tools/package_final_rar.py --wsl-rar /mnt/e/amd_fpga_2026_backups/report_layout_202611`
- `exec` `text(await tools.write_stdin({session_id:70968,chars:"",yield_time_ms:1000,max_output_tokens:1800})); text(await tools.exec_command({cmd:"Ge`

</details>

### 模型回答（2026-11-02 23:01）

RAR 已生成，大小约6.70 MiB，包含367个文件，且只有一个顶层项目目录。

已通过 RAR 完整性测试、独立解压、全部文件哈希比对、源码身份与 Icarus 展开检查。解压后主机单测和独立 Skill 测试也通过；报告 PDF、candidate 工件及原报告均保持字节一致。正在补齐交付入口和校验记录，随后提交推送。

<details><summary>工具调用 3 次</summary>

- `exec` `text(await tools.exec_command({cmd:"@'\nimport json,pathlib\nm=json.loads(pathlib.Path('delivery/final_rar_manifest.json').read_text(encodin`
- `exec` `text(await tools.apply_patch("*** Begin Patch\n*** Update File: E:/amd_fpga_2026_backups/report_layout_20261102/tools/package_final_rar.py\n`
- `exec` `text(await tools.exec_command({cmd:"@'\nfrom pathlib import Path\nimport json,hashlib,subprocess\nr=Path('.');m=json.loads((r/'delivery/fina`

</details>

### 模型回答（2026-11-02 23:05）

最终检查通过：未发现缺失的当前构建依赖，最新报告与配套 LaTeX 一致，独立 Skill ZIP 也已按当前源码重新装配。README 已明确 `code/` 的工程根路径、`ASCON_REPO` 设置，以及不含 `.git` 时原脚本的运行方法。

压缩包为7,025,851字节，低于普通 Git 单文件限制；现在提交并推送，原工作区的未完成修改保持不动。

<details><summary>工具调用 2 次</summary>

- `exec` `const c=await tools.exec_command({cmd:"git commit -m '交付：整理代码、技术报告与Skill并打包RAR'","workdir":"E:/amd_fpga_2026_backups/report_layout_20261102"`
- `exec` `text(await tools.write_stdin({session_id:13409,chars:"",yield_time_ms:1000,max_output_tokens:700})); text(await tools.exec_command({cmd:"git`

</details>

### 模型回答（2026-11-02 23:06）

已完成整理、校验、提交并推送至 `origin/main`。

[下载最终 RAR](E:/amd_fpga_2026_backups/report_layout_20261102/delivery/RISC-V轻量密码加速SoC_最终交付.rar)

- **绝对路径**：`E:\amd_fpga_2026_backups\report_layout_20261102\delivery\RISC-V轻量密码加速SoC_最终交付.rar`
- **格式**：真正的 RAR5
- **大小**：7,025,851字节，约6.70 MiB
- **文件数**：367
- **SHA-256**：

```text
e216016471330cf3f4c2ab33cd2465e3c7a069389ee82e6fd15b6a8056e1f4da
```

```text
RISC-V轻量密码加速SoC/
├── README.md、LICENSE
├── delivery_manifest.json
├── SHA256SUMS.txt、verify_checksums.py
├── code/
│   └── src、board、sim、ascon、build、data、tools、report/design
├── technical_report/
│   ├── final_report.pdf（最新版85页）
│   └── latex/
└── skill/
    ├── pynq-overlay-workflow/
    └── pynq_overlay_workflow_skill.zip
```

包含当前 PUF3 源码、必要共享 IP/固件/约束、已验证 candidate、配套报告和独立 Skill。新中文 README 覆盖作品、架构、创新点、环境、实际命令、性能证据、Skill 用法及已知限制。

RAR 测试、实际解压、全部文件哈希、PDF/candidate/Skill 一致性及 README 链接检查均通过；Icarus 展开通过，主机单测61项通过，Skill 为61 passed、3项可选测试 skipped。

未发现缺失的当前构建依赖；已说明旧路径、旧包和 Git 元数据限制。未修改冻结源码、工件或报告正文，未重新运行综合或实板验证。[详细校验记录](E:/amd_fpga_2026_backups/report_layout_20261102/delivery/final_rar_readme.md)。

提交：`d5a985b4f5c3196a0cc3ab2f9e60e954bab942c9`。推送成功，本地隔离检出与远程 SHA 一致、工作区干净；原工作区5项未提交改动完整保留。
