HChenZ/amd_fpga_2026/report/llm_collab/sessions/20261102_codex_91b9f9d0.md

# ### 你要做的事情 请在仓库里查找并优先复用这些现有素材（如存在）： - 中文

- 工具：codex；模型：openai；会话：`01a19b8e-d61e-7152-9e0a-448791b9f9d0`
- 开始：2026-11-02 17:20；用户提示 3 条；工具调用 22 次

## 用户提示（2026-11-02 17:20）

### 你要做的事情

请在仓库里查找并优先复用这些现有素材（如存在）：

- 中文海报：\`report/poster/ascon_soc_poster.png\`
- 英文海报：\`report/poster/ascon_soc_poster_en.png\`
- 系统架构相关图
- 技术报告中的系统总体框图
- 开发板实物照片（如果仓库里有实拍图就优先用实拍图）
- 如有 PYNQ / Jupyter 运行界面截图，也可选取合适区域作为小图展示

请你**重新排版制作一张新的“作品全貌图”**，而不是简单复制原海报。\
最终图要更适合报名系统中的“作品全貌图”用途：**简洁、直观、信息集中、容易看懂**。

---

### 3. 最终图片要求

请生成 **1 张 PNG 图片**，要求：

- 尺寸建议：**1600×900** 或 **1920×1080**
- 横版，16:9
- 文件尽量控制在报名系统可接受范围内（通常 10MB 内）
- 风格：简洁、科技感、比赛展示风格
- 中文为主
- 适合当“作品全貌图”，不要做成论文页，也不要做成密密麻麻的长海报

---

### 4. 建议布局

请按类似下面的结构组织：

#### 顶部标题区

主标题：\
**RISC-V 轻量密码加速 SoC**

副标题：\
**基于 AMD Zynq-7000 FPGA 的软硬件协同设计**

可以加一行小字：\
**面向嵌入式数据安全场景**

---

#### 左侧或中左：实物/平台展示

放一张开发板实物图（如果仓库里有），并标注：

- **硬件平台：AMD Zynq-7000（XC7Z020）开发板**
- **基于现成开发板完成设计与验证，无自制 PCB**

如果没有高质量实拍图，可以从现有海报或报告素材中提取合适图片，但不要用无关图片替代。

---

#### 中间：系统全貌 / 架构图

放系统总体框图或重绘后的简化架构图，清晰展示：

- RV32 五级流水 RISC-V CPU
- Ascon-AEAD128
- 三种实现路径：SW / MMIO / ISE
- PYNQ / Jupyter 交互
- RO-PUF / Device DNA 密钥通路
- 板级运行验证

这一部分应当是全图核心。

---

#### 右侧：创新点 / 关键词

用 3 个模块或 3 个标签突出：

1. **RISC-V 定制指令密码加速**
2. **PYNQ 软硬件协同与通用 Skill**
3. **RO-PUF 器件绑定密钥原型**

可以配简短解释，每条 1 行即可，不要太长。

---

#### 底部：关键结果

请提炼少量最重要、最可靠的数据，建议放成 4～6 个小块：

- **SW / MMIO / ISE 三模式实现**
- **三模式容量内 KAT：各 289/289 通过**
- **MMIO 加密加速比：15.969×**
- **ISE 加密加速比：5.613×**
- **PUF 会话内重建：5/5**
- **板级实测验证完成**

这里的数据要与当前仓库和最终技术报告一致，不要使用过时数字。

## 用户提示（2026-11-02 17:20）

### 你要做的事情

请在仓库里查找并优先复用这些现有素材（如存在）：

- 中文海报：\`report/poster/ascon_soc_poster.png\`
- 英文海报：\`report/poster/ascon_soc_poster_en.png\`
- 系统架构相关图
- 技术报告中的系统总体框图
- 开发板实物照片（如果仓库里有实拍图就优先用实拍图）
- 如有 PYNQ / Jupyter 运行界面截图，也可选取合适区域作为小图展示

请你**重新排版制作一张新的“作品全貌图”**，而不是简单复制原海报。\
最终图要更适合报名系统中的“作品全貌图”用途：**简洁、直观、信息集中、容易看懂**。

---

### 3. 最终图片要求

请生成 **1 张 PNG 图片**，要求：

- 尺寸建议：**1600×900** 或 **1920×1080**
- 横版，16:9
- 文件尽量控制在报名系统可接受范围内（通常 10MB 内）
- 风格：简洁、科技感、比赛展示风格
- 中文为主
- 适合当“作品全貌图”，不要做成论文页，也不要做成密密麻麻的长海报

---

### 4. 建议布局

请按类似下面的结构组织：

#### 顶部标题区

主标题：\
**RISC-V 轻量密码加速 SoC**

副标题：\
**基于 AMD Zynq-7000 FPGA 的软硬件协同设计**

可以加一行小字：\
**面向嵌入式数据安全场景**

---

#### 左侧或中左：实物/平台展示

放一张开发板实物图（如果仓库里有），并标注：

- **硬件平台：AMD Zynq-7000（XC7Z020）开发板**
- **基于现成开发板完成设计与验证，无自制 PCB**

如果没有高质量实拍图，可以从现有海报或报告素材中提取合适图片，但不要用无关图片替代。

---

#### 中间：系统全貌 / 架构图

放系统总体框图或重绘后的简化架构图，清晰展示：

- RV32 五级流水 RISC-V CPU
- Ascon-AEAD128
- 三种实现路径：SW / MMIO / ISE
- PYNQ / Jupyter 交互
- RO-PUF / Device DNA 密钥通路
- 板级运行验证

这一部分应当是全图核心。

---

#### 右侧：创新点 / 关键词

用 3 个模块或 3 个标签突出：

1. **RISC-V 定制指令密码加速**
2. **PYNQ 软硬件协同与通用 Skill**
3. **RO-PUF 器件绑定密钥原型**

可以配简短解释，每条 1 行即可，不要太长。

---

#### 底部：关键结果

请提炼少量最重要、最可靠的数据，建议放成 4～6 个小块：

- **SW / MMIO / ISE 三模式实现**
- **三模式容量内 KAT：各 289/289 通过**
- **MMIO 加密加速比：15.969×**
- **ISE 加密加速比：5.613×**
- **PUF 会话内重建：5/5**
- **板级实测验证完成**

这里的数据要与当前仓库和最终技术报告一致，不要使用过时数字。6. 设计风格要求

请尽量做到：

- 简洁大方
- 适合比赛申报
- 科技感，但不要太花哨
- 不要堆太多小字
- 尽量减少长段落
- 颜色可参考 AMD / FPGA / 科技蓝紫风格，但不要过暗
- 整体可读性优先8. 输出要求

  请完成以下工作：
  1. 先检查仓库中可用的图片和图表素材 &#x20;
  2. 选择合适素材重新排版 &#x20;
  3. 生成 1 张最终版 **作品全貌图 PNG** &#x20;
  4. 同时给出你使用了哪些素材、最终文字内容是什么 &#x20;
  5. 如果你认为某个素材不够清晰，可以重绘简化架构图，但必须保持内容真实
  如果仓库内现有素材足够，请优先复用，不要无故重做全部内容。

### 模型回答（2026-11-02 17:22）

我会先核对仓库素材和最终报告中的数据，再重新排成一张横版作品全貌图。架构图会明确区分已验证的 PYNQ 主线与独立 PUF 原型，避免造成已集成的误解。

<details><summary>工具调用 4 次</summary>

- `exec` `text(await tools.exec_command({cmd:"Get-Location; git status --short; Get-Content AGENTS.md; Get-Content README.md; Get-Content docs/project`
- `exec` `text(await tools.exec_command({cmd:"rg --files report; rg --files -g '*.png' -g '*.jpg' -g '*.jpeg' -g '*.svg' -g '*.webp' -g '!board/**' -g`
- `exec` `const r=await Promise.allSettled([ tools.exec_command({cmd:"Get-Content report/readme.md; Get-Content docs/tech_report/report.md -TotalCount`
- `exec` `text(await tools.exec_command({cmd:"rg -n '15\\.969|5\\.613|21862|21,862|PUF3|127/128' docs/tech_report -g '*.tex' -g '*.md' -g '*.html'; rg`

</details>

### 模型回答（2026-11-02 17:23）

已找到开发板实拍、双语海报和 Jupyter 截图。最新海报与 PUF3 原始记录支持 15.969×、5.613× 和会话内重建 5/5；报告 Markdown 仍保留旧版 PYNQ 数据，我会继续核对提交版 PDF，并在图中注明数据版本与测量条件。

<details><summary>工具调用 1 次</summary>

- `exec` `text(await tools.exec_command({cmd:"Get-Content C:/Users/xiong/.codex/plugins/cache/openai-primary-runtime/pdf/26.1026.10807/skills/pdf/SKIL`

</details>

### 模型回答（2026-11-02 17:24）

我会用 PDF 技能核对提交版报告。版面采用浅色蓝紫配色：左侧实拍，中间简化架构，右侧三项特点，底部六项结果；保留短消息容量与 PUF 会话验证边界。

<details><summary>工具调用 7 次</summary>

- `exec` `text(await tools.exec_command({cmd:"python -m pip install pypdf --quiet; Get-ChildItem docs/tech_report/figs -Name | Select-Object -First 30`
- `exec` `text(await tools.exec_command({cmd:"@'\nfrom pypdf import PdfReader\nfrom pathlib import Path\nfor p in Path('docs/tech_report').glob('*.pdf`
- `exec` `text(await tools.exec_command({cmd:"python -m pip install pymupdf --quiet; @'\nfrom pypdf import PdfReader\nr=PdfReader('docs/tech_report/技术`
- `exec` `text(await tools.write_stdin({session_id:70585,chars:"",yield_time_ms:1000,max_output_tokens:1000})); text(await tools.exec_command({cmd:"Ne`
- `exec` `text(await tools.exec_command({cmd:"@'\nimport fitz\nfrom pathlib import Path\np=fitz.open('docs/tech_report/技术报告_提交版.pdf')\nfor i in (1,3):`
- `exec` `const results=await Promise.allSettled([tools.view_image({path:"E:\\amd_fpga_2026\\build\\tmp\\project_overview_20261102\\report_page_2.png"`
- `exec` `text(await tools.apply_patch("*** Begin Patch\n*** Add File: E:/amd_fpga_2026/build/tmp/project_overview_20261102/render_overview.py\n+from `

</details>

### 模型回答（2026-11-02 17:28）

核对发现提交版 PDF 也保留了更早的性能数据，因此无法声称现有材料已全部一致。新图采用 10 月 31 日 PUF3 原始记录和最新海报的数据，并注明 HWKEY 关闭、CPU 周期口径；版本差异会记入说明文件，供最终归档时核对。

<details><summary>工具调用 4 次</summary>

- `exec` `const r=await tools.view_image({path:"E:\\amd_fpga_2026\\report\\overview\\ascon_soc_overview.png"});image(r.image_url); `
- `exec` `text(await tools.exec_command({cmd:"@'\nfrom PIL import Image\nim=Image.open('image/pynq/PixPin_2026-10-30_22-46-53.png')\nprint(im.size)\ni`
- `exec` `image((await tools.view_image({path:"E:\\amd_fpga_2026\\build\\tmp\\project_overview_20261102\\screen_crop.png"})).image_url); `
- `exec` `text(await tools.apply_patch("*** Begin Patch\n*** Update File: E:/amd_fpga_2026/build/tmp/project_overview_20261102/render_overview.py\n@@\`

</details>

### 模型回答（2026-11-02 17:30）

全貌图已生成，尺寸为 1920×1080，文件约 0.80 MB。实拍、架构和六项结果已完成视觉检查；正在补齐素材出处与完整文字清单，并同步项目记录。

<details><summary>工具调用 3 次</summary>

- `exec` `text(await tools.exec_command({cmd:"@'\nfrom pathlib import Path\nimport json\nr=Path('.')\nv=json.loads((r/'build/tmp/project_overview_2026`
- `exec` `text(await tools.apply_patch("*** Begin Patch\n*** Update File: E:/amd_fpga_2026/project_log/actual_progress.md\n@@\n-PDF用pypdf6.14.2（实际版本以环`
- `exec` `text(await tools.apply_patch("*** Begin Patch\n*** Update File: E:/amd_fpga_2026/build/tmp/project_overview_20261102/render_overview.py\n@@\`

</details>

### 模型回答（2026-11-02 17:34）

已完成：[下载作品全貌图 PNG](E:/amd_fpga_2026/report/overview/ascon_soc_overview.png)，**1920×1080，约 0.79 MB**。

作品全貌图

复用了开发板实拍、Jupyter 截图及现有架构内容，重新排版；素材出处与全部最终文字见[制作说明](E:/amd_fpga_2026/report/overview/readme.md)。

数据已按最新 PUF3 原始记录核验。**现有报告仍含历史数据，尚未全部统一**，差异已写入说明。未自动提交或推送。

## 用户提示（2026-11-02 18:01）

把图片和readme提交到仓库。

### 模型回答（2026-11-02 18:02）

我会检查工作区，只提交这次的全貌图 PNG 和 readme，提交说明使用中文。

<details><summary>工具调用 3 次</summary>

- `exec` `text(await tools.exec_command({cmd:"git status --short; git branch --show-current; git diff -- report/overview/readme.md; Get-ChildItem repo`
- `exec` `text(await tools.exec_command({cmd:"git add -- report/overview/ascon_soc_overview.png report/overview/readme.md",workdir:"E:\\amd_fpga_2026"`
- `exec` `text(await tools.exec_command({cmd:"git commit -m \"文档：新增报名作品全貌图及素材说明\" -- report/overview/ascon_soc_overview.png report/overview/readme.md"`

</details>

### 模型回答（2026-11-02 18:02）

已提交，提交号：`7fb616b`（文档：新增报名作品全貌图及素材说明）。

仅包含 PNG 和 readme 两个文件，其他工作区改动保留。尚未推送远端。
