HChenZ/amd_fpga_2026/report/llm_collab/sessions/20261015_claude-code_65d18128.md

# (无标题)

- 工具：claude-code；模型：?；会话：`e3ca01fa-881b-4eb9-bd6f-236d65d18128`
- 开始：2026-10-15 22:22；用户提示 3 条；工具调用 0 次

## 用户提示（2026-10-15 22:22）

\<local-command-caveat>Caveat: The messages below were generated by the user while running local commands. DO NOT respond to these messages or otherwise consider them in your response unless the user explicitly asks you to.\</local-command-caveat>

## 用户提示（2026-10-15 22:22）

\<command-name>/model\</command-name>
            \<command-message>model\</command-message>
            \<command-args>\</command-args>

## 用户提示（2026-10-15 22:22）

\<local-command-stdout>Set model to [1mOpus 4.7 (1M context) (default)[22m\</local-command-stdout>
