HChenZ/amd_fpga_2026/report/llm_collab/sessions/20261016_codex_ccae3539.md

# (无标题)

- 工具：codex；模型：openai；会话：`01a14251-cbd3-7b51-ab6c-e5e0ccae3539`
- 开始：2026-10-16 09:26；用户提示 2 条；工具调用 0 次

## 用户提示（2026-10-16 09:26）

\<command-name>/model\</command-name>
            \<command-message>model\</command-message>
            \<command-args>\</command-args>

## 用户提示（2026-10-16 09:26）

\<local-command-stdout>Set model to [1mOpus 4.7 (1M context) (default)[22m\</local-command-stdout>
