HChenZ/amd_fpga_2026/report/llm_collab/sessions/20261018_opencode_ygtd7kip.md

# 完成 PYNQ 主机端并行任务文件要求

- 工具：opencode；模型：gpt-6.1-sol；会话：`ses_eb10cc776ffdnAbk0xygTd7kiP`
- 开始：2026-10-18 20:18；用户提示 3 条；工具调用 76 次

## 用户提示（2026-10-18 20:18）

请你读取这个文件，完成里面的任务

<details><summary>工具调用 1 次</summary>

- `shell` `git status --short`

</details>

<details><summary>工具调用 1 次</summary>

- `read` `tasks/parallel_task_a_pynq_host.md`

</details>

<details><summary>工具调用 1 次</summary>

- `read` `AGENTS.md`

</details>

### 模型回答（2026-10-18 20:18）

我会按任务卡 A 的边界执行：只新增 `src/pynq/` 文件，并在开发日志末尾追加记录；保留现有未提交改动，不启动 Vivado。周期数据会明确标注为仿真来源，不作为板级实测。

<details><summary>工具调用 1 次</summary>

- `shell` `Get-Content README.md, docs/project_overview.md, docs/technical_rules.md, tasks/task_board.md, project_log/actual_progress.md, project_log/l`

</details>

<details><summary>工具调用 10 次</summary>

- `read` `README.md`
- `read` `docs/project_overview.md`
- `read` `docs/technical_rules.md`
- `read` `tasks/task_board.md`
- `read` `project_log/actual_progress.md`
- `read` `docs/interfaces.md`
- `read` `docs/agent_workflow.md`
- `read` `src`
- `read` `ascon/python`
- `read` `sim/ascon/test_harness.py`

</details>

<details><summary>工具调用 8 次</summary>

- `read` `sim/ascon/support.py`
- `read` `data/ascon/provenance.json`
- `read` `src/readme.md`
- `read` `project_log/development_log.md`
- `read` `data/ascon/results/key_lifecycle/sw_timing_acb_sw.json`
- `read` `data/ascon/results/key_lifecycle/hw_timing_acb_hw.json`
- `read` `data/ascon/results/key_lifecycle/ise_timing_acb_ise.json`
- `glob` `src`

</details>

<details><summary>工具调用 1 次</summary>

- `grep` `data/ascon/results/key_lifecycle`

</details>

<details><summary>工具调用 1 次</summary>

- `shell` `python -c "import json,pathlib,sys; print(sys.version); p=pathlib.Path('data/ascon/results/key_lifecycle'); [(print(n, json.loads((p/n).read`

</details>

<details><summary>工具调用 5 次</summary>

- `shell` `py -0p`
- `grep` `data/ascon/results/key_lifecycle/sw_timing_acb_sw.log`
- `read` `ascon/pyascon/ascon.py`
- `read` `project_log/lessons_learned.md`
- `shell` `Get-Content -Encoding utf8 project_log/development_log.md -Tail 18`

</details>

<details><summary>工具调用 1 次</summary>

- `shell` `python -c "from pathlib import Path; p=Path('data/ascon/results/key_lifecycle'); [(print(n),print('\n'.join((p/n).read_text(encoding='utf-8'`

</details>

### 模型回答（2026-10-18 20:19）

已核实两点：任务卡中的 `ascon/python/` 实际为 `ascon/pyascon/`，锁定参考在 `sim/ascon/reference/pyascon/`；周期 JSON 不含计数值，数值位于同名 `.log`。API 将只为已测的“16B、无 AD 加密”填入该周期数据，其余输入返回 `not_measured`，避免误用占位值。

<details><summary>工具调用 1 次</summary>

- `patch` 

</details>

<details><summary>工具调用 3 次</summary>

- `shell` `python src/pynq/golden_checker.py`
- `shell` `uv python find 3.11 --offline`
- `read` `src/firmware/ascon_rv32/main.c`

</details>

<details><summary>工具调用 1 次</summary>

- `patch` 

</details>

<details><summary>工具调用 3 次</summary>

- `shell` `& 'C:\Users\HXZ\AppData\Roaming\uv\python\cpython-3.11-windows-x86_64-none\python.exe' src/pynq/test_host_api.py`
- `shell` `& 'C:\Users\HXZ\AppData\Roaming\uv\python\cpython-3.11-windows-x86_64-none\python.exe' --version`
- `shell` `& 'C:\Users\HXZ\AppData\Roaming\uv\python\cpython-3.11-windows-x86_64-none\python.exe' src/pynq/golden_checker.py`

</details>

<details><summary>工具调用 1 次</summary>

- `shell` `python -c "from pathlib import Path; p=Path('project_log/development_log.md'); print(len(p.read_text(encoding='utf-8').splitlines()))"`

</details>

<details><summary>工具调用 1 次</summary>

- `read` `project_log/development_log.md`

</details>

### 模型回答（2026-10-18 20:23）

无板验收已通过：Python 3.11.16 下全量 KAT 为 **1089 PASS / 0 FAIL**，篡改拒绝 **4290 次**；另有 **17 项测试通过**，覆盖长度检查、超时、总线错误、故障注入和 notebook 顺序执行。接下来补齐使用说明与交接记录，板级协议和硬件后端仍明确标为待完成。

<details><summary>工具调用 1 次</summary>

- `patch` 

</details>

<details><summary>工具调用 4 次</summary>

- `shell` `& 'C:\Users\HXZ\AppData\Roaming\uv\python\cpython-3.11-windows-x86_64-none\python.exe' src/pynq/test_host_api.py`
- `shell` `git diff --check -- src/pynq project_log/development_log.md`
- `shell` `git status --short -- src/pynq project_log/development_log.md`
- `shell` `python -c "from pathlib import Path; import ast,json; p=Path('src/pynq'); files=sorted(p.glob('*')); [(ast.parse(f.read_text(encoding='utf-8`

</details>

### 模型回答（2026-10-18 20:24）

已完成任务卡 A（Y03/Y04 无板部分，owner TBD）。

- 新增 `src/pynq/`：Host API、golden checker、notebook、说明及测试。
- Python 3.11.16 验收：**1089 KAT 全通过、4290 次篡改拒绝、17 项测试通过**。
- 周期明确标注 `simulated`，未测场景返回 `None`。
- 已在开发日志末尾追加记录，未启动 Vivado、未 commit/push。

用法与证据见 `src/pynq/readme.md`。板级后端尚未实现，下一步需先完成 Y01 协议和 Y02 overlay。

## 用户提示（2026-10-18 20:28）

继续完成下一步

<details><summary>工具调用 5 次</summary>

- `shell` `git status --short`
- `read` `tasks/task_board.md`
- `read` `docs/ascon_board_checklist.md`
- `read` `docs/interfaces.md`
- `read` `src/pynq/readme.md`

</details>

### 模型回答（2026-10-18 20:29）

下一步是 **Y01：PS/PL 通信协议设计**。当前记录仍未确认板型，不能直接配置 overlay 或写死寄存器地址。

请提供开发板型号、PCB 版本及 PYNQ 镜像版本；如果尚无实板，我可以先完成**不绑定板型的协议草案和模拟通信测试**。你希望按哪种情况继续？

## 用户提示（2026-10-18 20:31）

你先完成不绑定版型的吧

<details><summary>工具调用 1 次</summary>

- `shell` `git status --short`

</details>

### 模型回答（2026-10-18 20:31）

我会先完成板型无关的 Y01 子集：协议草案、可接入现有 Host API 的模拟通信后端，以及超时、旧响应、认证失败等测试。所有内容会标为 draft/simulated，不写死地址，也不改 RTL 或启动 Vivado。

<details><summary>工具调用 7 次</summary>

- `read` `src/pynq/ascon_host_api.py`
- `read` `src/pynq/readme.md`
- `read` `src/pynq/test_host_api.py`
- `read` `docs/interfaces.md`
- `read` `project_log/development_log.md`
- `read` `tasks/parallel_task_a_pynq_host.md`
- `read` `docs/agent_workflow.md`

</details>

<details><summary>工具调用 1 次</summary>

- `patch` 

</details>

<details><summary>工具调用 1 次</summary>

- `patch` 

</details>

<details><summary>工具调用 2 次</summary>

- `shell` `& 'C:\Users\HXZ\AppData\Roaming\uv\python\cpython-3.11-windows-x86_64-none\python.exe' src/pynq/test_mailbox.py`
- `shell` `& 'C:\Users\HXZ\AppData\Roaming\uv\python\cpython-3.11-windows-x86_64-none\python.exe' src/pynq/golden_checker.py --backend mailbox`

</details>

### 模型回答（2026-10-18 20:35）

模拟通信链路已跑通：经 mailbox 编解码和完成/ACK 流程，全量 **1089 KAT 通过、4290 次篡改被拒绝**；新增 **24 项协议测试通过**。超时或响应身份不匹配后，通道会禁止复用，必须显式恢复，不自动重试加密。目前是在进程内模拟，不代表真实 AXI、缓存一致性或固件已实现。

<details><summary>工具调用 1 次</summary>

- `patch` 

</details>

<details><summary>工具调用 5 次</summary>

- `shell` `& 'C:\Users\HXZ\AppData\Roaming\uv\python\cpython-3.11-windows-x86_64-none\python.exe' src/pynq/golden_checker.py --backend mailbox --mode s`
- `shell` `& 'C:\Users\HXZ\AppData\Roaming\uv\python\cpython-3.11-windows-x86_64-none\python.exe' src/pynq/golden_checker.py --backend mailbox --mode h`
- `shell` `& 'C:\Users\HXZ\AppData\Roaming\uv\python\cpython-3.11-windows-x86_64-none\python.exe' src/pynq/golden_checker.py --backend mailbox --mode i`
- `shell` `& 'C:\Users\HXZ\AppData\Roaming\uv\python\cpython-3.11-windows-x86_64-none\python.exe' src/pynq/test_host_api.py`
- `shell` `& 'C:\Users\HXZ\AppData\Roaming\uv\python\cpython-3.11-windows-x86_64-none\python.exe' src/pynq/test_mailbox.py`

</details>

<details><summary>工具调用 3 次</summary>

- `shell` `& 'C:\Users\HXZ\AppData\Roaming\uv\python\cpython-3.11-windows-x86_64-none\python.exe' src/pynq/golden_checker.py --backend mailbox --inject`
- `shell` `& 'C:\Users\HXZ\AppData\Roaming\uv\python\cpython-3.11-windows-x86_64-none\python.exe' src/pynq/golden_checker.py --backend mailbox --inject`
- `shell` `& 'C:\Users\HXZ\AppData\Roaming\uv\python\cpython-3.11-windows-x86_64-none\python.exe' -c "from src.pynq.ascon_host_api import AsconHost; fr`

</details>

<details><summary>工具调用 1 次</summary>

- `patch` 

</details>

<details><summary>工具调用 4 次</summary>

- `shell` `& 'C:\Users\HXZ\AppData\Roaming\uv\python\cpython-3.11-windows-x86_64-none\python.exe' -m unittest discover -s src/pynq -p 'test_*.py' -v`
- `shell` `git diff --check -- src/pynq project_log/development_log.md`
- `shell` `python -c "from pathlib import Path; import ast; files=[p for p in Path('src/pynq').iterdir() if p.is_file()]; [ast.parse(p.read_text(encodi`
- `shell` `git status --short -- src/pynq project_log/development_log.md`

</details>

### 模型回答（2026-10-18 20:38）

已完成 **Y01 板型无关子集**（owner TBD）：

- 协议草案：`src/pynq/mailbox_protocol.md`
- 新增消息编解码、模拟通信后端及测试，接入现有 Host API，调用方式不变。
- Python 3.11.16：**41 项测试通过**；三个模拟 mode 各 **1089 KAT 通过、4290 次篡改拒绝**。
- 已补充用法、验证命令和开发日志。

协议仍为 **draft**；真实 AXI、缓存一致性、固件加载和实板尚未验证。下一步是草案审查后绑定板型，实现物理传输。未启动 Vivado，未 commit/push。
