HChenZ/amd_fpga_2026/report/llm_collab/sessions/20261018_opencode_z6payu1i.md

# Finishing dcache fix checklist doc

- 工具：opencode；模型：gpt-6.1-sol；会话：`ses_eb2c5dd10ffeF50exfZ6pAYu1i`
- 开始：2026-10-18 12:16；用户提示 7 条；工具调用 325 次

## 用户提示（2026-10-18 12:16）

please finish this markdown file

<details><summary>工具调用 1 次</summary>

- `read` `C:\wenjian\game\FPGA2026\ours\amd_fpga_2026\docs\dcache_fix_checklist_en.md`

</details>

<details><summary>工具调用 2 次</summary>

- `glob` `docs/dcache*`
- `shell` `git status --short; git log --oneline -5`

</details>

<details><summary>工具调用 1 次</summary>

- `shell` `git diff --stat src/rtl/dcache.v; git diff src/rtl/dcache.v | Select-Object -First 300`

</details>

<details><summary>工具调用 1 次</summary>

- `shell` `git diff src/rtl/dcache.v | Select-Object -Skip 300`

</details>

<details><summary>工具调用 1 次</summary>

- `grep` `src/rtl`

</details>

<details><summary>工具调用 1 次</summary>

- `read` `C:\wenjian\game\FPGA2026\ours\amd_fpga_2026\src\rtl\bus_interconnect.v`

</details>

<details><summary>工具调用 1 次</summary>

- `read` `C:\wenjian\game\FPGA2026\ours\amd_fpga_2026\src\rtl\dcache.v`

</details>

<details><summary>工具调用 1 次</summary>

- `shell` `Test-Path data/ascon/results/key_lifecycle/sw_dcache_pipe2.json, build/local/strategy_sweep_log/dcache_head_screen.log, build/reports/dcache`

</details>

### 模型回答（2026-10-18 12:17）

Before adding anything, I checked the document against the RTL. Section 1 gets the root cause partly wrong, so I'm fixing that as well as adding the missing sections.

<details><summary>工具调用 1 次</summary>

- `edit` `C:\wenjian\game\FPGA2026\ours\amd_fpga_2026\docs\dcache_fix_checklist_en.md`

</details>

### 模型回答（2026-10-18 12:18）

Now add the remaining sections after the evidence list.

<details><summary>工具调用 1 次</summary>

- `edit` `C:\wenjian\game\FPGA2026\ours\amd_fpga_2026\docs\dcache_fix_checklist_en.md`

</details>

### 模型回答（2026-10-18 12:18）

I finished `docs/dcache_fix_checklist_en.md`. Checking it against the RTL showed the original section 1 got the deadlock cause wrong, so I fixed that too. I only edited the document. No RTL was changed and no simulation or Vivado runs were done.

**Correction to section 1:** the hang has nothing to do with the bus handshake. In `src/rtl/bus_interconnect.v`, the peripherals (UART, CLINT, GPIO and the rest) answer reads one cycle later with no "data valid" signal at all. That signal (`cpu_rdata_valid`) is only raised for cacheable memory reads. So after the first peripheral read at boot, nothing ever clears `mmio_read_wait_r` and the CPU stalls forever. That's also why no UART characters appear.

What that changes in the advice:
- **Old fix (a) won't work.** It gated on bus ready signals (`arready`/`awready`), but peripheral reads never use that bus. I replaced it with an option that adds a peripheral "data valid" to the interconnect. That would be an interface change and would need every mode re-run.
- **Fix (b), restoring the fixed wait, needs one more cycle than before.** The new MISS_CAPTURE state sends the request one cycle later, so the data arrives at T+3. Copying back the old 2-cycle wait would read the data a cycle too early.
- **More signals have the same bug.** Besides `hit`, the next-state choice and all the bus request registers use the live `cacheable` value during MISS_CAPTURE. By then the address may already belong to the next instruction, so all of these should use values latched at capture time.
- **Performance cost:** every store now also passes through MISS_CAPTURE and stalls the CPU for an extra cycle. The checklist asks for this to be measured.

**New sections:**
- **6. Fix order:** step by step, with only one Vivado run on the project at a time and no timing work until all regressions pass.
- **7. Acceptance criteria:** a checklist (regressions, matching test-vector output, cycle counts, timing and resource reports, the duplicate-module check, log updates).
- **8. Do not:** a list of rules.
- **9. Handoff report format:** what to report back, following the project's `AGENTS.md`.
- **10. Open items:** what's still unresolved or `not_measured`.

All evidence paths listed in section 5 exist. I didn't update `project_log/actual_progress.md` for this doc edit; tell me if you want an entry added.

## 用户提示（2026-10-18 12:22）

请你看完这个文档，按照文档安装AMD ROSS，并将之前列出的清单问题进行修复

<details><summary>工具调用 1 次</summary>

- `read` `C:\wenjian\game\FPGA2026\ours\amd_fpga_2026\docs\dcache_fix_plan_for_opencode.md`

</details>

<details><summary>工具调用 1 次</summary>

- `grep` `(?i)ross`

</details>

<details><summary>工具调用 1 次</summary>

- `read` `C:\wenjian\game\FPGA2026\ours\amd_fpga_2026\docs\ross_and_engineering_skills_evaluation.md`

</details>

<details><summary>工具调用 1 次</summary>

- `execute` 

</details>

<details><summary>工具调用 2 次</summary>

- `skill` 
- `shell` `Get-ChildItem -Path $env:USERPROFILE\Downloads, $env:USERPROFILE\.config\opencode, $env:USERPROFILE\.opencode -Recurse -Depth 2 -ErrorAction`

</details>

<details><summary>工具调用 1 次</summary>

- `shell` `Get-ChildItem C:\Users\HXZ\.agents\skills -Name; Get-ChildItem C:\Users\HXZ\.config\opencode -ErrorAction SilentlyContinue -Name; Get-ChildI`

</details>

<details><summary>工具调用 1 次</summary>

- `shell` `Get-Content C:\Users\HXZ\.config\opencode\opencode.json; Get-ChildItem C:\ruanjian\2025.2 -Name -ErrorAction SilentlyContinue; Test-Path C:/`

</details>

<details><summary>工具调用 1 次</summary>

- `shell` `Get-CimInstance Win32_Process -Filter "Name like 'vivado-mcp%' or Name like 'vivado%'" | Select-Object ProcessId,ParentProcessId,ExecutableP`

</details>

<details><summary>工具调用 1 次</summary>

- `webfetch` 

</details>

<details><summary>工具调用 1 次</summary>

- `shell` `& C:\wenjian\tool\vivado-mcp-server-windows-amd64-2026.9.1.exe --help 2>&1 | Select-Object -First 80; Get-ChildItem C:\wenjian\tool -Name`

</details>

<details><summary>工具调用 1 次</summary>

- `skill` 

</details>

<details><summary>工具调用 1 次</summary>

- `webfetch` 

</details>

<details><summary>工具调用 1 次</summary>

- `shell` `opencode mcp add vivado --global --env VIVADO_PATH=C:/ruanjian/2025.2/Vivado/bin/vivado.bat -- C:/wenjian/tool/vivado-mcp-server-windows-amd`

</details>

### 模型回答（2026-10-18 12:25）

No `opencode` CLI on PATH, so I'll add the server to the global config by hand.

<details><summary>工具调用 1 次</summary>

- `edit` `C:\Users\HXZ\.config\opencode\opencode.json`

</details>

<details><summary>工具调用 1 次</summary>

- `shell` `python -c "import json;d=json.load(open(r'C:\Users\HXZ\.config\opencode\opencode.json'));print(json.dumps(d['mcp']))"; & C:\wenjian\tool\viv`

</details>

### 模型回答（2026-10-18 12:26）

Ross MCP (vivado server 2026.9.1) is now connected. Next, the gates and the fix. Let me read the screen script and runner.

<details><summary>工具调用 2 次</summary>

- `read` `C:\wenjian\game\FPGA2026\ours\amd_fpga_2026\build\screen_dcache_donttouch.sh`
- `read` `C:\wenjian\game\FPGA2026\ours\amd_fpga_2026\build\build_dcache_pipe.tcl`

</details>

### 模型回答（2026-10-18 12:26）

Gate 4.1: baseline screen with the committed dcache (does not touch the working tree).

<details><summary>工具调用 1 次</summary>

- `shell` `bash build/screen_dcache_donttouch.sh head 2>&1 | Select-Object -Last 15`

</details>

<details><summary>工具调用 1 次</summary>

- `shell` `Get-Command bash -All | Select-Object Source; Test-Path "C:\Program Files\Git\bin\bash.exe"; Get-Command iverilog, vvp -ErrorAction Silently`

</details>

<details><summary>工具调用 1 次</summary>

- `shell` `Get-ChildItem C:\, D:\, E:\ -Filter bash.exe -Recurse -Depth 4 -ErrorAction SilentlyContinue | Select-Object -First 10 FullName; Get-Command`

</details>

<details><summary>工具调用 1 次</summary>

- `shell` `$env:PATH = "C:\wenjian\.vscode\iverilog\bin;" + $env:PATH; & C:\ruanjian\Git\bin\bash.exe -lc "cd /c/wenjian/game/FPGA2026/ours/amd_fpga_20`

</details>
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
