HChenZ/amd_fpga_2026/image/pynq/l3-00.png

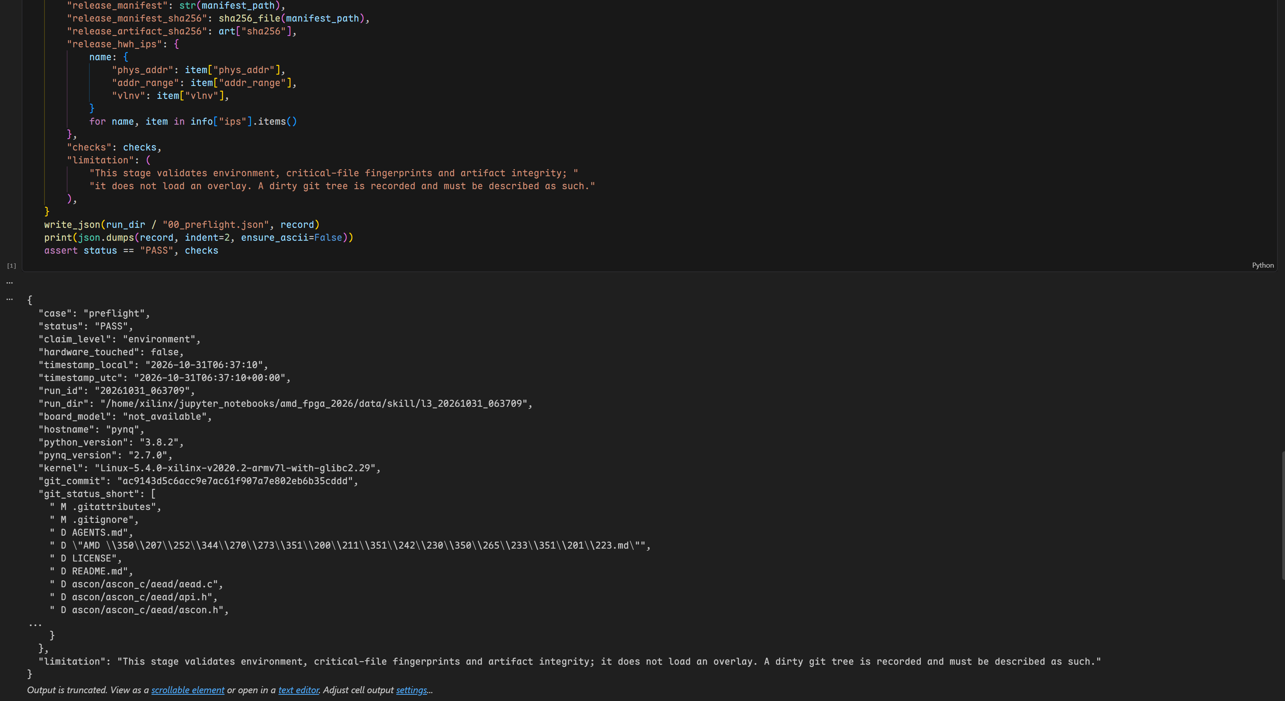
image/pynq/l3-00.png
