HChenZ/amd_fpga_2026/image/pynq/l3-10.png

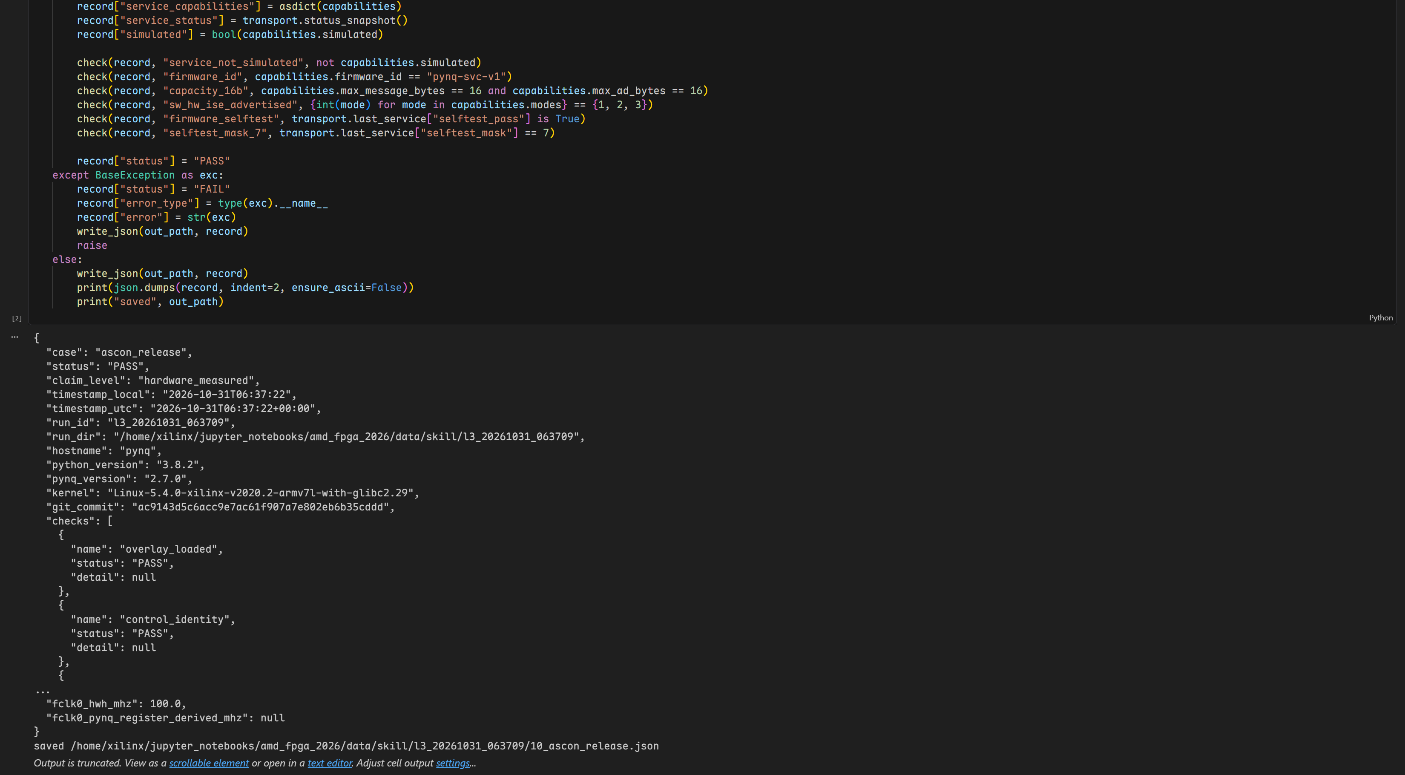
image/pynq/l3-10.png
