HChenZ/amd_fpga_2026/image/pynq/PixPin_2026-10-30_22-46-53.png

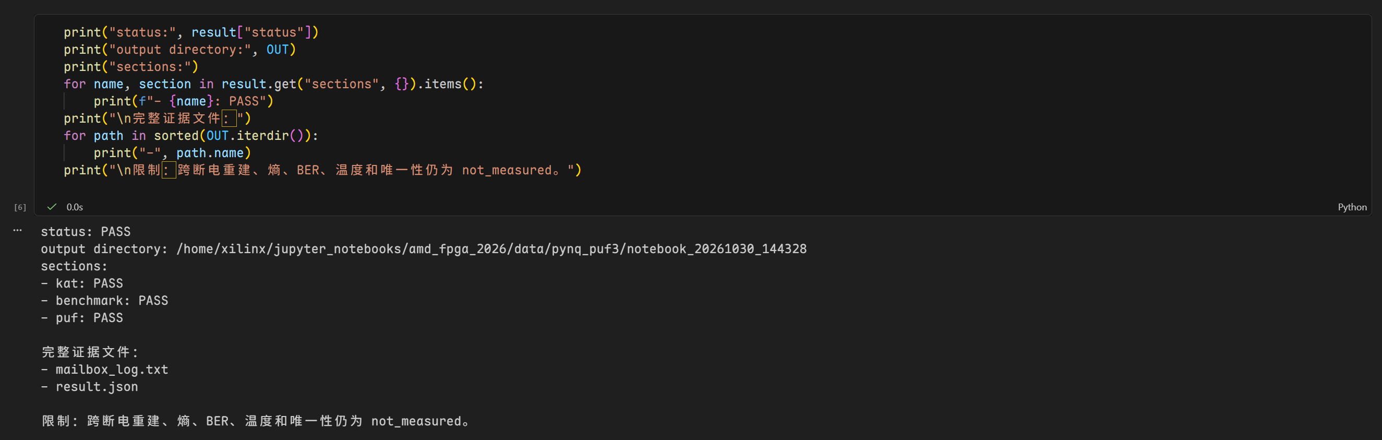
image/pynq/PixPin_2026-10-30_22-46-53.png
