HChenZ/amd_fpga_2026/report/overview/ascon_soc_overview.png

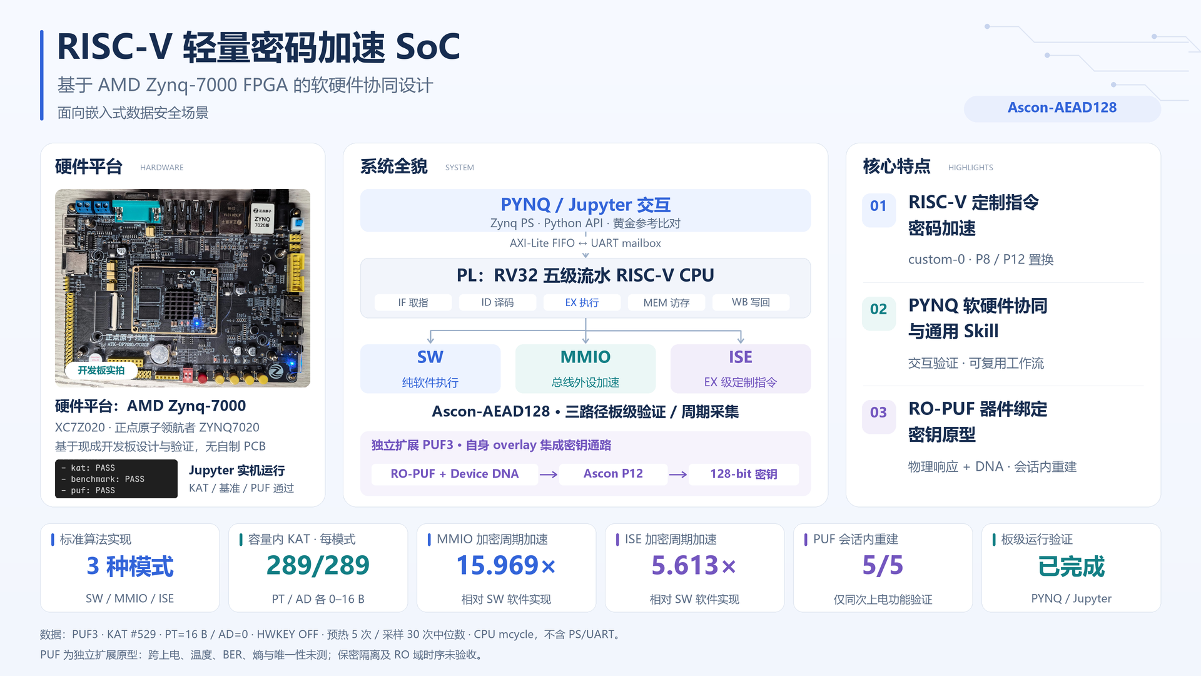
report/overview/ascon_soc_overview.png
