HChenZ/amd_fpga_2026/report/poster/ascon_soc_poster.png

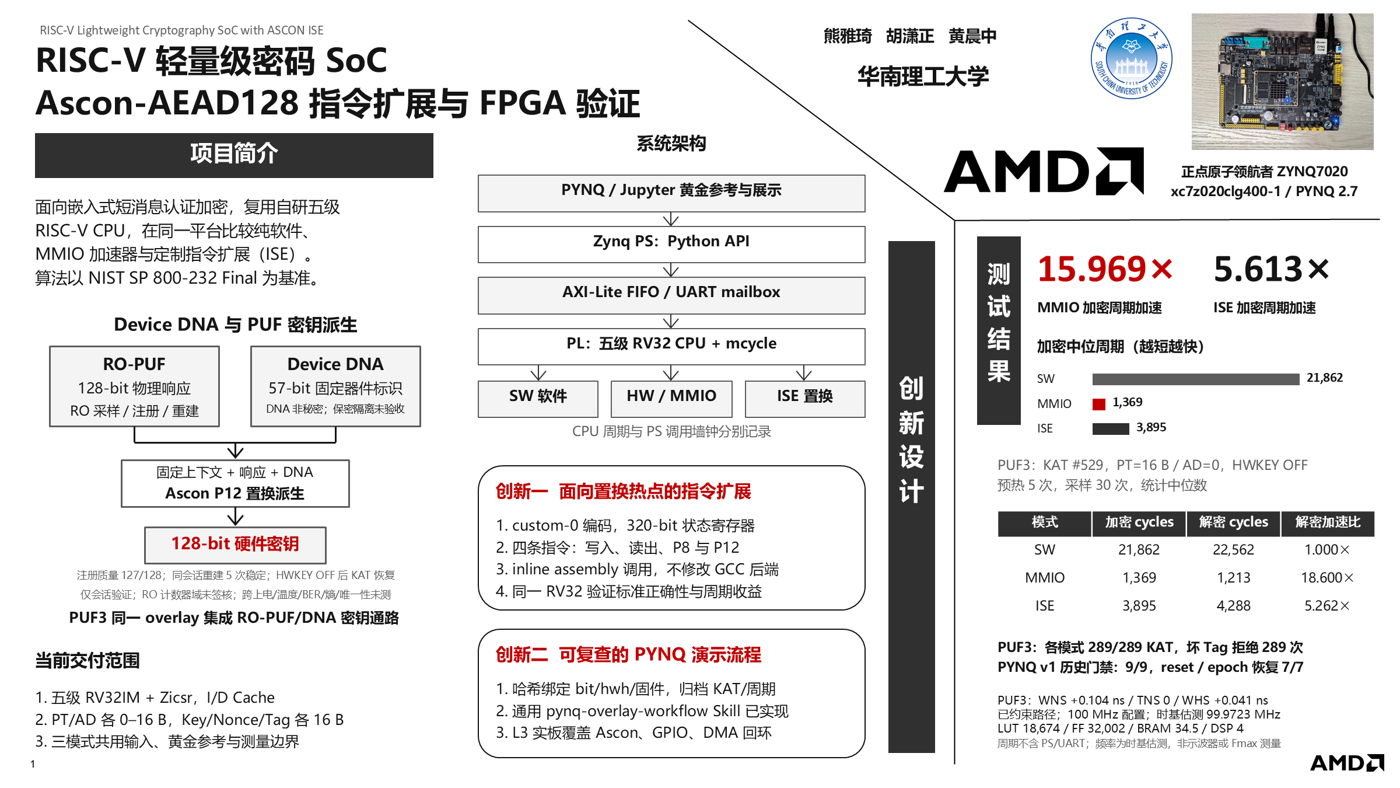
report/poster/ascon_soc_poster.png
