HChenZ/amd_fpga_2026/archive/history/skill/ab_eval_pynq/results/l2_20261030_deepseek-flash/results_holdout_t5.csv

task | arm | rep | scenario | outcome | why | canary | uses_skill_lib | exit
t5_bram | placebo | rep01 | aligned_word | pass |  | pynq-style-notes | False | exit=0
t5_bram | placebo | rep01 | unaligned_rmw | pass |  | pynq-style-notes | False | exit=0
t5_bram | placebo | rep01 | odd_length | pass |  | pynq-style-notes | False | exit=0
t5_bram | placebo | rep01 | hierarchical_32k | pass |  | pynq-style-notes | False | exit=0
t5_bram | placebo | rep01 | past_the_end | pass |  | pynq-style-notes | False | exit=0
t5_bram | placebo | rep01 | read_past_the_end | pass |  | pynq-style-notes | False | exit=0
t5_bram | placebo | rep01 | sequence | pass |  | pynq-style-notes | False | exit=0
t5_bram | placebo | rep02 | aligned_word | pass |  | pynq-style-notes | False | exit=0
t5_bram | placebo | rep02 | unaligned_rmw | pass |  | pynq-style-notes | False | exit=0
t5_bram | placebo | rep02 | odd_length | pass |  | pynq-style-notes | False | exit=0
t5_bram | placebo | rep02 | hierarchical_32k | pass |  | pynq-style-notes | False | exit=0
t5_bram | placebo | rep02 | past_the_end | pass |  | pynq-style-notes | False | exit=0
t5_bram | placebo | rep02 | read_past_the_end | pass |  | pynq-style-notes | False | exit=0
t5_bram | placebo | rep02 | sequence | pass |  | pynq-style-notes | False | exit=0
t5_bram | placebo | rep03 | aligned_word | pass |  | pynq-style-notes | False | exit=0
t5_bram | placebo | rep03 | unaligned_rmw | pass |  | pynq-style-notes | False | exit=0
t5_bram | placebo | rep03 | odd_length | pass |  | pynq-style-notes | False | exit=0
t5_bram | placebo | rep03 | hierarchical_32k | pass |  | pynq-style-notes | False | exit=0
t5_bram | placebo | rep03 | past_the_end | pass |  | pynq-style-notes | False | exit=0
t5_bram | placebo | rep03 | read_past_the_end | pass |  | pynq-style-notes | False | exit=0
t5_bram | placebo | rep03 | sequence | pass |  | pynq-style-notes | False | exit=0
t5_bram | placebo | rep04 | aligned_word | fail | RuntimeError: overlay 中找不到 VLNV 为 xilinx.com:ip:axi_bram_ctrl:4.1 的 IP | pynq-style-notes | False | exit=0
t5_bram | placebo | rep04 | unaligned_rmw | fail | RuntimeError: overlay 中找不到 VLNV 为 xilinx.com:ip:axi_bram_ctrl:4.1 的 IP | pynq-style-notes | False | exit=0
t5_bram | placebo | rep04 | odd_length | fail | RuntimeError: overlay 中找不到 VLNV 为 xilinx.com:ip:axi_bram_ctrl:4.1 的 IP | pynq-style-notes | False | exit=0
t5_bram | placebo | rep04 | hierarchical_32k | fail | RuntimeError: overlay 中找不到 VLNV 为 xilinx.com:ip:axi_bram_ctrl:4.1 的 IP | pynq-style-notes | False | exit=0
t5_bram | placebo | rep04 | past_the_end | fail | RuntimeError: overlay 中找不到 VLNV 为 xilinx.com:ip:axi_bram_ctrl:4.1 的 IP | pynq-style-notes | False | exit=0
t5_bram | placebo | rep04 | read_past_the_end | fail | RuntimeError: overlay 中找不到 VLNV 为 xilinx.com:ip:axi_bram_ctrl:4.1 的 IP | pynq-style-notes | False | exit=0
t5_bram | placebo | rep04 | sequence | fail | RuntimeError: overlay 中找不到 VLNV 为 xilinx.com:ip:axi_bram_ctrl:4.1 的 IP | pynq-style-notes | False | exit=0
t5_bram | placebo | rep05 | aligned_word | pass |  | pynq-style-notes | False | exit=0
t5_bram | placebo | rep05 | unaligned_rmw | pass |  | pynq-style-notes | False | exit=0
t5_bram | placebo | rep05 | odd_length | pass |  | pynq-style-notes | False | exit=0
t5_bram | placebo | rep05 | hierarchical_32k | pass |  | pynq-style-notes | False | exit=0
t5_bram | placebo | rep05 | past_the_end | pass |  | pynq-style-notes | False | exit=0
t5_bram | placebo | rep05 | read_past_the_end | pass |  | pynq-style-notes | False | exit=0
t5_bram | placebo | rep05 | sequence | pass |  | pynq-style-notes | False | exit=0
t5_bram | with | rep01 | aligned_word | pass |  | pynq-overlay-workflow | False | exit=0
t5_bram | with | rep01 | unaligned_rmw | pass |  | pynq-overlay-workflow | False | exit=0
t5_bram | with | rep01 | odd_length | pass |  | pynq-overlay-workflow | False | exit=0
t5_bram | with | rep01 | hierarchical_32k | pass |  | pynq-overlay-workflow | False | exit=0
t5_bram | with | rep01 | past_the_end | pass |  | pynq-overlay-workflow | False | exit=0
t5_bram | with | rep01 | read_past_the_end | pass |  | pynq-overlay-workflow | False | exit=0
t5_bram | with | rep01 | sequence | pass |  | pynq-overlay-workflow | False | exit=0
t5_bram | with | rep02 | aligned_word | pass |  | pynq-overlay-workflow | False | exit=0
t5_bram | with | rep02 | unaligned_rmw | pass |  | pynq-overlay-workflow | False | exit=0
t5_bram | with | rep02 | odd_length | pass |  | pynq-overlay-workflow | False | exit=0
t5_bram | with | rep02 | hierarchical_32k | pass |  | pynq-overlay-workflow | False | exit=0
t5_bram | with | rep02 | past_the_end | pass |  | pynq-overlay-workflow | False | exit=0
t5_bram | with | rep02 | read_past_the_end | pass |  | pynq-overlay-workflow | False | exit=0
t5_bram | with | rep02 | sequence | pass |  | pynq-overlay-workflow | False | exit=0
t5_bram | with | rep03 | aligned_word | pass |  | pynq-overlay-workflow | False | exit=0
t5_bram | with | rep03 | unaligned_rmw | pass |  | pynq-overlay-workflow | False | exit=0
t5_bram | with | rep03 | odd_length | pass |  | pynq-overlay-workflow | False | exit=0
t5_bram | with | rep03 | hierarchical_32k | pass |  | pynq-overlay-workflow | False | exit=0
t5_bram | with | rep03 | past_the_end | pass |  | pynq-overlay-workflow | False | exit=0
t5_bram | with | rep03 | read_past_the_end | pass |  | pynq-overlay-workflow | False | exit=0
t5_bram | with | rep03 | sequence | pass |  | pynq-overlay-workflow | False | exit=0
t5_bram | with | rep04 | aligned_word | pass |  | pynq-overlay-workflow | False | exit=0
t5_bram | with | rep04 | unaligned_rmw | pass |  | pynq-overlay-workflow | False | exit=0
t5_bram | with | rep04 | odd_length | pass |  | pynq-overlay-workflow | False | exit=0
t5_bram | with | rep04 | hierarchical_32k | pass |  | pynq-overlay-workflow | False | exit=0
t5_bram | with | rep04 | past_the_end | pass |  | pynq-overlay-workflow | False | exit=0
t5_bram | with | rep04 | read_past_the_end | pass |  | pynq-overlay-workflow | False | exit=0
t5_bram | with | rep04 | sequence | pass |  | pynq-overlay-workflow | False | exit=0
t5_bram | with | rep05 | aligned_word | pass |  | pynq-overlay-workflow | False | exit=0
t5_bram | with | rep05 | unaligned_rmw | pass |  | pynq-overlay-workflow | False | exit=0
t5_bram | with | rep05 | odd_length | pass |  | pynq-overlay-workflow | False | exit=0
t5_bram | with | rep05 | hierarchical_32k | pass |  | pynq-overlay-workflow | False | exit=0
t5_bram | with | rep05 | past_the_end | pass |  | pynq-overlay-workflow | False | exit=0
t5_bram | with | rep05 | read_past_the_end | pass |  | pynq-overlay-workflow | False | exit=0
t5_bram | with | rep05 | sequence | pass |  | pynq-overlay-workflow | False | exit=0
t5_bram | without | rep01 | aligned_word | pass |  |  | False | exit=0
t5_bram | without | rep01 | unaligned_rmw | pass |  |  | False | exit=0
t5_bram | without | rep01 | odd_length | pass |  |  | False | exit=0
t5_bram | without | rep01 | hierarchical_32k | pass |  |  | False | exit=0
t5_bram | without | rep01 | past_the_end | pass |  |  | False | exit=0
t5_bram | without | rep01 | read_past_the_end | pass |  |  | False | exit=0
t5_bram | without | rep01 | sequence | pass |  |  | False | exit=0
t5_bram | without | rep02 | aligned_word | pass |  |  | False | exit=0
t5_bram | without | rep02 | unaligned_rmw | pass |  |  | False | exit=0
t5_bram | without | rep02 | odd_length | pass |  |  | False | exit=0
t5_bram | without | rep02 | hierarchical_32k | pass |  |  | False | exit=0
t5_bram | without | rep02 | past_the_end | pass |  |  | False | exit=0
t5_bram | without | rep02 | read_past_the_end | pass |  |  | False | exit=0
t5_bram | without | rep02 | sequence | pass |  |  | False | exit=0
t5_bram | without | rep03 | aligned_word | fail | RuntimeError: overlay 中找不到 VLNV 为 xilinx.com:ip:axi_bram_ctrl:4.1 的 AXI BRAM 控制器 |  | False | exit=0
t5_bram | without | rep03 | unaligned_rmw | fail | RuntimeError: overlay 中找不到 VLNV 为 xilinx.com:ip:axi_bram_ctrl:4.1 的 AXI BRAM 控制器 |  | False | exit=0
t5_bram | without | rep03 | odd_length | fail | RuntimeError: overlay 中找不到 VLNV 为 xilinx.com:ip:axi_bram_ctrl:4.1 的 AXI BRAM 控制器 |  | False | exit=0
t5_bram | without | rep03 | hierarchical_32k | fail | RuntimeError: overlay 中找不到 VLNV 为 xilinx.com:ip:axi_bram_ctrl:4.1 的 AXI BRAM 控制器 |  | False | exit=0
t5_bram | without | rep03 | past_the_end | fail | RuntimeError: overlay 中找不到 VLNV 为 xilinx.com:ip:axi_bram_ctrl:4.1 的 AXI BRAM 控制器 |  | False | exit=0
t5_bram | without | rep03 | read_past_the_end | fail | RuntimeError: overlay 中找不到 VLNV 为 xilinx.com:ip:axi_bram_ctrl:4.1 的 AXI BRAM 控制器 |  | False | exit=0
t5_bram | without | rep03 | sequence | fail | RuntimeError: overlay 中找不到 VLNV 为 xilinx.com:ip:axi_bram_ctrl:4.1 的 AXI BRAM 控制器 |  | False | exit=0
t5_bram | without | rep04 | aligned_word | pass |  |  | False | exit=0
t5_bram | without | rep04 | unaligned_rmw | pass |  |  | False | exit=0
t5_bram | without | rep04 | odd_length | pass |  |  | False | exit=0
t5_bram | without | rep04 | hierarchical_32k | pass |  |  | False | exit=0
t5_bram | without | rep04 | past_the_end | pass |  |  | False | exit=0
t5_bram | without | rep04 | read_past_the_end | pass |  |  | False | exit=0
t5_bram | without | rep04 | sequence | pass |  |  | False | exit=0
t5_bram | without | rep05 | aligned_word | pass |  |  | False | exit=0
t5_bram | without | rep05 | unaligned_rmw | pass |  |  | False | exit=0
t5_bram | without | rep05 | odd_length | pass |  |  | False | exit=0
t5_bram | without | rep05 | hierarchical_32k | pass |  |  | False | exit=0
t5_bram | without | rep05 | past_the_end | pass |  |  | False | exit=0
t5_bram | without | rep05 | read_past_the_end | pass |  |  | False | exit=0
t5_bram | without | rep05 | sequence | pass |  |  | False | exit=0
