HChenZ/amd_fpga_2026/archive/history/skill/ab_eval_pynq/results/l2_20261030_deepseek-flash/results_t2_t4.csv

task | arm | rep | scenario | outcome | why | canary | uses_skill_lib | exit
t2_hls | placebo | rep01 | basic | pass |  | pynq-style-notes | False | exit=0
t2_hls | placebo | rep01 | back_to_back | pass |  | pynq-style-notes | False | exit=0
t2_hls | placebo | rep01 | stale_done | pass |  | pynq-style-notes | False | exit=0
t2_hls | placebo | rep01 | addr_high_word_dirty | pass |  | pynq-style-notes | False | exit=0
t2_hls | placebo | rep01 | never_done | pass | timeout raised | pynq-style-notes | False | exit=0
t2_hls | placebo | rep01 | single_element | pass |  | pynq-style-notes | False | exit=0
t2_hls | placebo | rep02 | basic | pass |  | pynq-style-notes | False | exit=0
t2_hls | placebo | rep02 | back_to_back | pass |  | pynq-style-notes | False | exit=0
t2_hls | placebo | rep02 | stale_done | pass |  | pynq-style-notes | False | exit=0
t2_hls | placebo | rep02 | addr_high_word_dirty | pass |  | pynq-style-notes | False | exit=0
t2_hls | placebo | rep02 | never_done | pass | timeout raised | pynq-style-notes | False | exit=0
t2_hls | placebo | rep02 | single_element | pass |  | pynq-style-notes | False | exit=0
t2_hls | placebo | rep03 | basic | pass |  | pynq-style-notes | False | exit=0
t2_hls | placebo | rep03 | back_to_back | pass |  | pynq-style-notes | False | exit=0
t2_hls | placebo | rep03 | stale_done | pass |  | pynq-style-notes | False | exit=0
t2_hls | placebo | rep03 | addr_high_word_dirty | pass |  | pynq-style-notes | False | exit=0
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
t4_diagnose | without | rep05 | Q6 | fail | missing concept ['(?i)(clear.?on.?read|COR|读清|读后清|read.{0,10}clear)'] |  | False | exit=0
t4_diagnose | without | rep05 | Q7 | pass |  |  | False | exit=0
t4_diagnose | without | rep05 | Q8 | pass |  |  | False | exit=0
