HChenZ/amd_fpga_2026/project_log/actual_progress.md

# 实际进度

## 2026-11-02 — D12 报告补 AMD ROSS 使用心得，全部内容打包为单个 ZIP（owner TBD）

- 用户要求在技术报告结尾加上对 AMD ROSS 的心得体会，并把所有内容打包成一个 ZIP；经确认 ZIP 范围为“仓库快照，去掉 delivery 重复包”，完成后提交推送（不 force）。入场 HEAD 5f509e8、工作区干净。
- 报告：第四部分末尾新增 §4.3「AMD ROSS 使用心得」，放在“心得体会”之后、参考文献之前。表 4-1 列八项实际用途：10-17 接入评估（官方下载 BIG-IP 错误 19，not_measured）、10-18 以 stdio 将 vivado-mcp-server 2026.9.1 接入 OpenCode（Vivado 2025.2）、D-cache 修复后 lint 2 条 WARNING 与 HEAD 相同、fix_r1 DCP 副本导出 156 端点（93/48/11/4）、双策略实现 exit0 3895.571 s（+0.001/+0.007 ns）、DSP 打包实测（AREG/BREG=1，仅 1 个 PREG，MREG 0）、PUF v2 方法学 TIMING-6/7/17 处置、PUF3 工程 sim_ise_screenshot 1502/0。随后四点体会：价值（对话内闭环、全量端点、长任务托管）、版本边界（2026.1 基线与各 Skill 最低版本，linterCsvFile 不支持）、MCP 注意事项（命令去重 SKIPPED、批命令中途失败、execute 可写工程、并行会话抢工程、无 amd-doc-search）、团队裁决（案例一否决降频，ROSS 不替代验证）。
- 出处逐条核对：archive/history/docs/ross_usage_experience.md、ross_and_engineering_skills_evaluation.md、timing_acb_validation.md，project_log V07/V08/V09 条目与 lessons L68/L85/L87/L88/L91/L93，development_log 10-31 ISE 截图条目；不含新测量。§2.5.1 加交叉引用，参考文献补第 11 条（Xilinx/ross-ai-assistant，审阅提交 2cdc9eef，MIT）。
- 编译 build_20261102_194053：85 页，evidence/PDF 检查 194/194，日志无 Overfull，PDF 全页扫描无版心外文字；新节与表 4-1 逐页目视复核。
- 整仓快照：从本提交（含本条记录）的 Git 树逐 blob 取原字节生成 delivery/amd_fpga_2026_repo_snapshot.zip，排除 delivery/ 目录（快照不能包含自身），另附 snapshot_manifest.json（提交号、逐文件 SHA-256 与来源）和 snapshot_readme.md（范围、排除项、Git 依赖步骤说明）。按 git archive 试算约 88 MB，低于 GitHub 100 MB 单文件上限。
- 排除前逐成员核对 delivery/ 四个包是否真与仓库重复（按 LF/CRLF 等价比较，比对本提交树、124f5c7 树及已跟踪 ZIP 归档的成员）：PUF3 源码、历史源码、Skill 三包的成员都能在本提交或 124f5c7 中找到相同内容，其中 PUF3 包 35 个、历史包 28 个是此后更新过的说明文档与维护脚本（docs/ 旧路径、readme、.gitignore、AGENTS.md、project_board.md、tools/ 三个脚本、export_sessions.py）的 124f5c7 旧版，无 RTL/固件/约束，快照收录其当前版本；此外只余 package_delivery.py 按模板生成的 README.md、pytest.ini、source_package.md 与 source_manifest.json；技术报告包的 latex/ 编辑源被 .gitignore 排除，其中 18 个文件在仓库别处没有相同内容。因此快照另把重打后报告包的 latex/ 按原路径放到 report/technical/amd_fpga_2026_latex_final/amd_fpga_2026_report/（D11 干净检出复核用的也是这一放法），报告包内 PDF 与已跟踪 PDF 同字节、不重复放。
- 报告包随之按 package_delivery.py 同一规则重打。两个 ZIP 的 SHA-256、大小与复验结果记在随后只改 delivery/ 的交付提交（delivery/manifest.json、delivery/README.md、delivery/snapshot_and_report_check.json），保证快照内容等于最终仓库去掉 delivery/、再加报告 LaTeX 源。
- 快照不含 .git。解压后可直接运行源集身份与 elaboration、固件重编译、PUF3 协同仿真与原件恢复，恢复原件后再运行 pytest、报告核对与重建（不先恢复时 pytest 中 test_host_api.py 的 test_cycle_sources 因缺原始记录失败）；sim/ascon 的主机/RTL 校验链用 Git 记录来源（support.py 的 Report 读取 HEAD，run_rtl_regression.py 另读 origin/main 并对照 HEAD，run_key_rtl.py、run_tail_equivalence.py 读取历史提交 c37ecae），须在完整 Git 克隆中运行。试跑时快照说明只写了 run_rtl_regression.py，解压目录中 prepare_rtl_vectors.py 报 not a git repository 才发现范围更大，说明已逐项改正。两部分复跑（快照解压目录、本提交的干净 worktree）结果记在 delivery/snapshot_and_report_check.json。
- 快照试做时发现跨平台缺陷：候选 manifest 的源 hash 取自 Windows CRLF 工作副本，而 Git blob 与 Linux 检出为 LF；tools/verify_puf3_sources.py 与报告 review_evidence.py 只容忍“文件 CRLF、记录 LF”一个方向，按 blob 原字节打包的快照（等同 Linux 检出）报 49 项源不匹配。两处改为 LF/CRLF 双向等价比较（记录的 hash 不变），修正后主仓库（CRLF）与 LF 快照均 status=PASS、elaboration exit0，review_evidence 均 194/194。delivery/puf3_project.zip 仍是 124f5c7 快照，内含旧的单向比较版本。
- 未做：未重跑 Vivado 与实板；D05、PUF/RO 未签核边界不变。接口变化：verify_puf3_sources.py 对 LF 检出不再误报，输出格式不变。

## 2026-11-02 — D11 技术报告图件修正、仓库路径对齐与复现章节完善（owner TBD）

- 用户给出图 2-1/2-2/2-4 三张截图：去掉图 2-1 标注旁白底分割；修正图 2-2 连线穿框与文字压线；图 2-4 斜线改为竖直/水平；并按新仓库结构更新报告路径、重点完善复现内容。入场 HEAD 864520d、工作区干净；LaTeX 编辑树先备份到本机 build/local/report_puf3_review/before_figfix_20261102_170615.zip。
- 图件：图 2-1 旋转标注去白底、放到竖线外侧，AXI/BRAM 竖线移出 soc_top 框线，BRAM 与 Ascon 两路在总线右端分开接入，控制窗口虚线改为直落 cpu_core；图 2-2 控制分发分左右两组、ex_stall_req 从 EX 上沿引出，重定向/训练、操作数旁路、GPR 写回各走独立通道，分支点加圆点，仅保留三处必要的正交跨越；图 2-4 扇出改为竖直分配线、汇聚线止于首尾两路、握手虚线留出竖直段、状态机改为两条正交回路。同类问题顺带修正图 2-3（斜线与压线标注）、2-7/2-9/2-13（白底压线标注）、2-14（旧 run_tests.py 改为 sim/ 脚本）、3-3（-0.118 压零线），以及图 2-4/2-5 说明中的 Markdown 反引号残留。
- 路径：正文与附录 30 余处按当前仓库更新——docs/ 文档改指 report/design/ 或 archive/history/docs/，旧 v1 验证/交接、keys_rv32、sim/board、sim/pynq、ab_eval_pynq 改指 archive/history/，照片改为 report/technical/figs/board_photo.jpg（与图 3-1 内嵌 JPEG 字节一致），ascon_ise.v 更正为 src/rtl/ascon/；不随 Git 跟踪的 data/ascon/results、build/reports、build/local 原件统一注明 archive/evidence/raw_records_20261102.zip 与 tools/restore_records.py，本地 PL-only bitstream 注明未入库。
- §3.4 复现说明重写为七节（仓库结构与原始记录、环境与版本、离线验证、比特流构建、上板运行、交付包与报告复核、复现边界），新增表 3-17～3-20；命令全部改为显式 --report/--output 新目录，删去已隔离的 sim/board、sim/pynq 命令，判据逐项对照脚本源码与既有记录（56/7/5 身份、28,661/0、23,965/0、RTL PASS 与 4/0、22 条 custom-0、54 步协同仿真、build.tcl 门禁与打印、package.py 复查项、Notebook 时钟/KAT/基准/PUF 判据）。镜像来源与 SHA-256 位置取自 archive/history 旧 v1 交接 §B/§C。
- 干净检出复跑：git worktree（864520d，无忽略文件）中于中文 Windows 11（Python 3.13.9、MinGW-w64 GCC 8.1.0、Icarus 14.0 devel、xPack GCC 15.2.0）按 §3.4.3 执行：源集身份 PASS 且 elaboration exit0；固件 BIN/COE 与 candidate 逐字节一致；协同仿真 54 步 PASS、自动锁定反例检出；RTL 回归 PASS、反例 4/0；host 28,661/0、失败契约 23,965/0；restore_records 恢复 2420 件后 pytest 122 passed/3 skipped。test_harness.py 首次 3 个 error（子进程 GBK 错误信息解码失败），设置 PYTHONUTF8=1 后 5 项 OK；首轮复跑曾因服务重启在协同仿真中断，按记录续跑。机器记录 build/metadata/offline_reproduce_check.json（路径已脱敏）。
- 编译：build_review.py（Tectonic 0.15.0）首轮发现表 2-14 后三行被推出页面——longtable 重置 \@colroom 后，图 2-10/2-11 两张浮动图被叠到同一页顶部；在图 2-10 前加 \Needspace{300pt} 使其就地排放后消除，另补 3 处长路径断行点消除 Overfull \hbox。最终 build_20261102_191808：83 页，evidence/PDF 检查 194/194，日志无 Overfull，PDF 全页扫描无版心外文字。性能/资源/时序数值与原件不变。
- 报告复核脚本：把打包后的 latex/ 放进干净检出运行 review_evidence.py 时，3 项“ISE screenshot source”因 .tcl/.wcfg 被 autocrlf 检出为 CRLF 而失败（Linux 检出则 4 个 .v 会因记录为 CRLF 而失败）。改为与同脚本 RTL 输入核对一致的 LF/CRLF 等价比较后，主仓库与干净检出均 194/194；只改比较方式，记录的 hash 与原件不变。
- 同步：report/reproduce_from_zero.md 增补 Windows 原生运行与 PYTHONUTF8 说明、镜像来源及“已有离线复跑记录”一节；report/technical/README.md、report/readme.md、LaTeX readme（构建命令改为 report/technical 路径）与任务看板 D11 更新。
- 交付：用户选择只重打技术报告包并授权提交推送（不 force）。先提交 9433ff1（PDF、文档、记录），再按 package_delivery.py 同一内容规则单独重建 delivery/technical_report.zip（62 件，4054378 B，SHA-256 d35fa273…），manifest 只更新该项并另记 source_revision 9433ff1；其余三包保持 124f5c7 快照。
  复验：verify_delivery.py 按新 manifest 四包全部 PASS（host61、Skill61/3 skip、固件 BIN 857df29c… 一致、elaboration、报告 83 页）；包内 LaTeX 独立编译 exit0、83 页、无 Overfull；打包 PDF 与跟踪 PDF 字节一致；干净检出 review_evidence 194/194。记录 build/metadata/report_repack_check.json，01:20 的 source_delivery_check.json 保留原样。
- 未做：未重跑 Vivado 综合/实现与实板；D05 与 PUF/RO 未签核边界不变。另记：赛题要求文件名纯英文，根目录“AMD 自主选题赛道.md”不符合，本轮未改名。接口变化：无。

## 2026-11-02 — D10 全部 Markdown 渲染检查与修正（owner TBD）

- 用户要求检查所有 md 文档、保证渲染正确后重新上传。范围为 231 个已跟踪 .md：维护文档、archive/history 137 个、协作会话 21 个与索引。入场 HEAD 51f4365，工作区干净。
- 方法：临时 venv 安装 cmarkgfm（GitHub 同款 cmark-gfm），逐文件渲染并按源码行检查：贴中文标点的粗体失效、表格单元格（含行内代码）中的 `|` 拆列丢字、表格后紧跟的行被吞成表格行、表头与分隔行列数不等、成对单个 `~` 变删除线、被剥除的 `<tag>`、裸 URL 吞掉中文标点、未闭合代码围栏、`*` 通配符变斜体、数学公式。先用 GitHub `/markdown` API 验证判定与 GitHub 一致；数学按 API 结果收紧（闭合 `$` 后接字母不成公式，PowerShell 的 `$var` 不受影响）。
- 维护文档（只改标记、不改文字）：README 3 处与复现指南 3 处“标签：”粗体；设计基线与邮箱协议 4 行表格中的 `||` 转义；actual_progress、lessons_learned、task_board 的删除线、通配符斜体、`<install>`/`<ver>`、裸 URL 与 3 处被吞进表格的结论行（前加空行）；另把 2 个已隔离文件的旧链接改指 archive/history。
- archive/history 16 个文件：2 张因分隔行列数不等而不渲染的表、表格内管道符、粗体、删除线、斜体、1 处缺失的闭合反引号，2 个公式中会被 Markdown 吃掉的 `\,\|\,`/`\|` 改为等价的 `\mathbin{\Vert}`/`\Vert`。
- 两处历史结构损坏：key_subsystem.md 自首次提交 ad38eda 起 printf 里的 `\n` 被写成真实换行，列表与代码围栏错位，第 301 行后整篇变成代码，恢复为 `\n`；timing_route_tests_20261024.md 的 §9.2 标题在 adcd9ee 被误插一段证据清单（编辑工具匹配到同名补丁的第一次出现），同样 5 行已在证据块中，恢复 8e51bee 的标题并删除重复。
- 协作会话：按“修生成器”处理 export_sessions.py（code_span/md_safe：工具调用摘要放进行内代码；正文代码外，含 GitHub 会剥除标签的段落整段转义标签，可成对的单个 `~` 转义，贴中文标点失效的 `**` 改 `<strong>`，作者写的原始 HTML 块不动）。源库在 10-30 后继续增长，重导出无法复现原范围，所以用同一函数处理 raw_records_20261102.zip 中的逐字节原件一次生成仓库副本。逐行审计只有 3922 个反引号、91 个 `\<`、7 个 `\~`、4 处 `**`→`<strong>`，撤销后与原件逐行一致。index.md 说明与导出器生成文字一致；restore_records.py 不再恢复已入库会话（否则遇不同字节拒绝覆盖而退出）。
- 换行：archive/history 为 -text，工作区此前残留 CRLF 而 Git 状态缓存未显示，编辑后会整文件改换行；已把修改文件恢复为与 HEAD 相同的 LF。20_part2.md 与 1 个会话在 HEAD 中本就含 CRLF，保持原样。
- 验证：cmark-gfm 复扫 231 个文件 E 类缺陷 0（余 3 条为 `__file__`、`__udivdi3`、`_rep__0` 字面量误报）；GitHub API 渲染 17 个代表文件（README、复现指南、协议、基线、本次三份日志与任务板、report 与会话索引、2 个修复的历史文档、campaign、4 个会话含最大的 3 个）0 缺陷；pytest -q -p no:cacheprovider 122 passed/3 skipped；tools/restore_records.py exit0（恢复 20 个本机忽略的 data/build 副本）；相对链接 181 个，损坏 2 个（目标为 .gitignore 中的本机文件）。
- 未改：上游第三方 README（pyascon、riscv-tests、ascon-c）按原作者的 setext 标题、缩进代码与 `*` 脚注渲染；中文硬换行在 GitHub 显示为空格属写法风格，未全量重排；交付 ZIP 未重打包。接口变化：无。

## 2026-11-02 — D09 仓库结构对齐赛题推荐目录（owner TBD）

- 用户给出当前README目录树与赛题3.3.5.4推荐结构截图，要求report/对齐“设计报告 + 大模型协作记录”。经确认：docs/整体并入report/；llm_collab移回report/且会话原文入库；README补目录对照；完成后正常commit/push。入场工作区干净、HEAD c300ba9。
- 移动（git rename，保留历史）：docs/tech_report/ → report/technical/（含本地忽略的LaTeX编辑树与旧ZIP，层级深度不变），其余15个docs/*.md → report/design/，docs/reproduce_from_zero.md → report/reproduce_from_zero.md，archive/history/report/llm_collab/ → report/llm_collab/。顶层docs/与archive/history/report/已不存在。
- 21个会话原文先与archive/evidence/raw_records_20261102.zip逐字节比对（diff 0），并做密钥/口令/邮箱模式扫描（0命中）后入库；.gitignore去掉两条sessions忽略规则，LaTeX编辑树/旧ZIP的忽略与PDF例外改到report/technical/，忽略结果与移动前一致。
- 引用：脚本只改“映射后目标真实存在”的路径（链接按新旧相对位置重算，正文仓库相对路径按前缀替换），38个文件78行仅路径变化；另把9个指向已隔离文件的docs/链接改到archive/history/docs/。project_log、archive、report/technical/validation生成记录和delivery ZIP保持原字节，旧路径按历史时点解读。
- tools/package_delivery.py改为读取report/design/*.md、report/reproduce_from_zero.md和report/technical/下报告源；pytest.ini与包内pytest.ini的norecursedirs由docs改为report。README新增推荐结构对照表；report/readme.md、report/design/readme.md、report/technical/README.md、project_board.md、AGENTS.md、delivery/README.md补说明。
- 验证：Python3.13.9；pytest -q -p no:cacheprovider 122 passed/3 skipped（exit0，与D08一致）；py_compile package_delivery.py exit0；报告源路径存在性检查通过；相对链接178个，损坏13→4（余4个为移动前已失效且目标不在docs/，未改）。
- 未做：未重新打包delivery四个ZIP（包内仍为旧docs/路径，已在delivery/README.md注明）；未重跑Vivado/板测/报告编译。接口变化：仅文档与打包脚本路径。下一接收任务：D05/D06不变，owner TBD。

## 2026-11-02 — D08 README目录说明与从零复现入口（owner TBD）

- 用户要求参考仓库README的目录说明，并按所给图片风格补一份从零复现文件。入场main工作区干净、HEAD957256f；本轮仅文档，不改程序或重新装配交付。
- 查阅phantom-drive的README“仓库结构”组织（<https://github.com/Freebird415/phantom-drive>，访问2026-11-02），只参考目录职责和快速导航形式，不把该项目的技术/成员/来源关系移植到本项目。
- README新增当前布局目录树、共享依赖提醒、克隆与复现入口；新增docs/reproduce_from_zero.md，分清现成candidate、从源码重建和四ZIP校验三种目标。
  指南覆盖工具/Windows与WSL、身份检查、Final host、独立RTL、真实RV32固件/协同仿真、Vivado2025.2、RO分析、候选备份和Notebook新副本；不照搬图片中的历史恢复入口。
- 明确输出写到新的build/local目录，不覆盖冻结build/metadata/、候选、已执行Notebook和旧板测；发布脚本只在独立克隆中备份candidate后运行；新bit须绑定新板测，不能回用旧PASS。
- 同步project_board.md、docs/readme.md和D08任务导航；现有四ZIP、manifest、PDF、RTL/固件、锁定参考与原始记录保持原字节，新增指南未暗装入旧交付包。
- 验证：Python3.13.9；5份入口/指南文档44个相对链接、18处命令脚本路径有效，8个argparse CLI的--help均exit0；tools/verify_puf3_sources.py --compile输出到新build/local目录，exit0，56项源/7项构建支持匹配、五工件MATCH。
  python -B -m pytest -q -p no:cacheprovider：122 passed/3 skipped，exit0；1132个程序/工件/数据/交付保护对象hash全部不变，git diff --check exit0。记录build/local/reproduction_docs_check_20261102/doc_check.json及同目录日志。
- 未运行新的Vivado综合/实现、PUF3功能协同仿真或实板，不将D05、RO域与PUF可靠性改成通过。D08仅文档完成，接口变化无，阻塞无；下一接收D05独立硬件端到端实做与D06材料审阅，owner TBD。
- 文档准备阶段停在未提交工作区；随后用户明确要求“直接推送”，授权提交这8份文档及任务/活动记录。发布前再次fetch、核验44个链接及1132个保护对象不变，正常提交推送，不force push；远端同步以Git main引用为准。仍未重打包，不改原始验收状态。

## 2026-11-02 — D07 最终四包固化与独立复验完成（owner TBD）

- 源码/整理提交124f5c7后生成四个独立ZIP：PUF3源码263件（1959558 B）、历史源码1484件（30305437 B）、独立Skill28件（59655 B）、技术报告62件（3982718 B）；每包均含逐文件hash，最终ZIP SHA-256见delivery/manifest.json。
- tools/verify_delivery.py对这一次正式ZIP完整复验exit0：CRC/成员hash与编号扫描通过；host61、Skill61 passed/3可选skip、固件重编译BIN857df29c…一致、elaboration和56项输入/7项候选支持检查全部通过。未把bit/DCP/波形/旧证据ZIP装进源码附件。
- 在仓库外创建124f5c7的临时干净工作树，确认忽略的host结果副本与LaTeX编辑树不存在，重新运行package_delivery.py与verify_delivery.py均exit0。
  四包成员集合相同，除checkout LF/CRLF外内容差异0；现成五工件仍完全匹配。该临时工作树只删除本轮创建的6个文件后正常移除，无force，不影响其他worktree。
- 技术报告ZIP的LaTeX在独立解包目录用Tectonic再编译exit0，仍77页，关键性能数字及编号检查通过；未替换已冻结交付PDF。字体绝对路径/fontconfig、lineno编码、Underfull与PDF版本警告保留，不宣称跨平台逐位复现。
- 完整机器结果在build/metadata/source_delivery_check.json；10个原始工具输出/编译记录存archive/evidence/source_delivery_checks_20261102.zip，CRC/成员SHA通过。
- D07可定位源码的分包/导航/验证已完成，当前提交随后按用户授权正常推送，远端状态以Git引用为准；D06人工材料审阅/上传、D05硬件端到端、网页原件补交和所有PUF未测边界不因此关闭。

## 2026-11-02 — D07 源码隔离与三类独立交付准备（owner TBD）

- 最新用户授权：工程当前PUF3及依赖、独立历史源码分别压缩，另交付独立Skill与技术报告；不以旧证据包作附件，但仓库保留源码和原始资料，允许正常commit/push。
- 入场保留文档审计、报告编辑树和并行记录，备份于本机opencode临时目录；181bafd保存说明层工作，ec60326正常合并origin/main，保留队友最新双语PUF3海报；未force push或丢弃他人修改。
- 当前board只保留PUF3、实际共享IP来源及板卡资料；独立历史board/src/sim/build/Skill验证工具隔离到archive/history。
  当前PYNQ公共库、pynq_svc/ascon_hw_rv32固件支持、Ascon参考/向量和build共享hook保留。当前RTL、固件算法、已执行PUF3 Notebook与candidate未改。
- 原始报告/日志/高级实验/恢复/会话等压缩归档，旧展开提交包去重。对ec60326的4915个路径/3632种Git blob做内容回查，当前树或归档均有对应内容（文本允许LF/CRLF等价）；额外保存未覆盖的72种旧字节变体。
  所有归档CRC与显式成员SHA-256校验通过，索引见archive/evidence/index.json；原标识/第三方许可与真实原件不伪造清除。
- README→project_board→当前源码/构建/Notebook/历史/原件/Skill/交付导航已建立。当前维护内容与交付源码中的指定内部编号已清理，CPU只描述RV32五级流水线，不新增独占原创声明。
- 报告仅调整CPU架构措辞并重新编译：build_20261102_002644，编译/证据/PDF检查均exit0，77页，PDF SHA-256 8cd1493eb9125950d6ea813984fd9c302be2c55cd0b1337774ed12ca9300aae4。
  新编译记录归档，原始测量不改；报告源和图件单独ZIP，四张Vivado截图不散放入库。
- 验证（Python3.13.9、pytest8.4.2、Icarus14.0 devel、xPack GCC15.2.0）：tools/verify_puf3_sources.py --compile exit0，56项候选生产输入、7项构建支持hash与5个现成工件匹配；共享hook/两个XCI路径检查通过。
  仓库pytest为122 passed/3 skipped，exit0；源码包仓库外解压后主机61项、独立Skill61 passed/3工程实物可选项skip、固件重编译与elaboration均exit0；BIN完全匹配原candidate的857df29c…。
- 初包曾漏带build共享hook，现已修打包源清单并增加专门依赖门禁，不能以elaboration代替Vivado输入核验。最终ZIP须在源码提交后重新生成/复核，以delivery/manifest.json为准；tools/verify_delivery.py为可复验入口。
- 例外：历史日志记录的report/project_explainer.html在当前工作区、Git和现有备份中均未找到，不声称已入库/已扫描；需原制作会话补交原件，不重造网页冒充保留。
- 接口变化：无硬件/固件ABI变化，仅仓库导航/归档/打包工具。未新跑Vivado实现、实板、完整历史工程复现或PUF可靠性，D05与原宽范围门禁不因解包测试转done。
  下一接收D07最终清单固化与推送、D06人工材料审核/上传；网页补交待原制作会话，owner TBD。

## 2026-11-01 — 说明层按版本分责收口，不强行修改 PUF3/旧程序（owner TBD）

- 用户授权仅更新说明：明确旧入口与当前现状，不把全部程序强制改成PUF3。未改脚本、RTL、固件、
  已执行Notebook、SKILL.md、原始板测、已发布manifest/PDF/ZIP/冻结指针，未commit/push。
- 新增 `docs/version_entrypoints.md` 及目录导航，修正README/AGENTS/board/src/build/data/sim旧当前状态；
  逐工程区分主演示、旧v1、PUF-only、PL-only、原baseline、独立DMA/PUF v2/MIN及Skill。
  明示共享firmware/IP依赖必须保留，旧CPU runner缺keys/BUFG、v1 CLI不兼容PQF3仍是未修程序问题。
- 历史评审/时序/交接/任务卡只加适用范围，保留原文与成败；旧报告/旧final ZIP不用作当前稿。
  包内快照、锁定参考与实验固定材料不为文案同步重写。更新/补充125份说明，范围见documentation_scope_20261101.json。
- PUF3 readme按实际固件纠正Y01K末8B为now_mcycle，按现有Notebook纠正FULL_KAT默认及不存在的CLI参数说明；
  看板只澄清已有证据、目标版本和冻结已生成，不新增验收PASS。
- 现有脚本刷新派生C组sha256清单/D02输入hash：build_evidence PASS52、D02 64/64、报告/PDF核对194/194（temp输出）。
  assemble --check-only PASS，拟装配268件（新增文档引用）；**未写新包**，旧指针仍18:38的267件/2a0f0304…，旧包未回写。
- 615个保护对象hash全部未变，程序diff0；61个新增相对链接有效，旧ZIP hash与指针一致。
  明细 `build/metadata/documentation_scope_20261101.json`。并行新增讲解网页/日志已保留，不纳入本轮程序变更。
- 后续要交付新说明快照时再独立核对/装配/冻结；本轮停在可审查工作区。

## 2026-11-01 — 项目全链路讲解网页（owner TBD）

- 用户要求制作通俗、严谨、详细的项目讲解网页，重点覆盖密码模块接入、PYNQ 工作方式及 CPU→密码→软件展示全链路。
  新增单文件离线页面 `report/project_explainer.html`（无外部依赖），内容只整理仓库现有源码、构建脚本、实现报告、
  最终报告与 `data/pynq_puf3/notebook_20261031_114512/result.json`，不新增任何测量；按“实板/仿真/实现报告/源码事实/
  推算/背景知识/未测”逐项标注证据类别，PUF3 为主演示，PYNQ v1 与 PL-only 只作历史对照，版本表述按 `docs/version_entrypoints.md`。
- 页面内嵌 JS 版 Ascon-AEAD128 演示（BigInt，与 RTL/固件同构）：本机 Node v24.15.0 从页面抽取库，对锁定
  `data/ascon/kat/asconaead128.txt` 执行加密 1089/1089、解密 1089/1089、Tag/密文篡改拒绝 2145/2145、0 错，exit 0。
  浏览器实测（本地 http.server 加载）各交互组件可运行、控制台无错误。该实现仅用于讲解，不是板上实现或证据。
- 文中标为“推算”的量级（如 #529 一次 ISE 加密动态 73 条 custom-0、置换约占 ISE 周期 1%、P8/P12 在 EX 约 13/17 拍、
  往返 176 B 理论线路 0.28 ms）均按源码/RTL 计算，未实测分项，不能当作板测结论。
- 未修改 RTL、固件、Notebook、manifest、证据包或报告；未运行 Vivado、未上板、未 commit/push。

## 2026-11-01 — 全部工程版本与 PUF3 入口一致性审计（owner TBD）

- 用户要求列清全部版本、历史用途和本次不用的版本，并检查脚本是否对应 PUF3。本轮未改生产程序/RTL/固件/Notebook/
  已发布 manifest，未新板测、未运行 Vivado、未重新打包、未 commit/push。保留原有未提交改动与新出现的 project_explainer.html。
- 交付 `docs/version_inventory_20261101.md`、`build/metadata/version_alignment_20261101.json`：枚举 board 12 目录
  （11 工程家族 + 1 资料目录）、固件 9 目录、Git 5 个 XPR 与本机 ASCON.xpr、六个本地分支、报告/证据/源码 ZIP；
  扫描 493 个跟踪/明确未跟踪脚本，逐个列路径、hash、分类和版本引用。排除包重复副本、LLM 会话、第三方恢复固件与锁定 reference。
- 当前 PUF3 五个工件、56 个选定生产输入、固件 build.json 的 12 个输入、10-31 板测 bit/hwh/manifest 绑定均匹配；
  D02 64/64、报告/PDF 核对 194/194（输出到 temp）、assemble --check-only PASS 267，当前 ZIP 与冻结指针一致。
- 全 70 项 candidate source 只有 Notebook 不同：追到 dd0dc25 的 CRLF 原件，当前代码仅 FULL_KAT False→True，
  加执行输出/元数据变动；这是测试版本演进，不改构建 manifest 来假装一致。
- 用临时输出复现源列表的 elaboration（不运行 vvp）：默认 run_cpu_regression 源集 exit 4，缺 BUFG/puf_key/key_mmio；
  pynq-p0、PUF3 专用源集、当前 ISE TB、旧 MMIO TB 均 exit 0。v1 BridgeRegs 对 PQF3 模拟寄存器明确拒绝，
  Notebook 的 PUF3 身份子类接受；不能仅改 --release 路径就把 v1 CLI 变成 PUF3。
- 发现未收口入口：src/pynq 的 board_demo/benchmark/error_gate 仍默认 v1，Skill L3 Ascon 也有意测 v1；
  src/rtl/soc_top.v 是自动锁钥旧版，PUF3 依赖 board 下两个变体；evidence/README.md 仍推荐旧 build_report.py；
  README 表格/board/readme/src 与 data readme 等仍有旧状态，之前“全部入口已更新”的结论过满。
- 四个旧报告 ZIP 全部不是当前 PDF，最近的 amd_fpga_2026_report.zip 也有 fig_2_9.tex 不同；18:38 证据包才是当前提交包。
- 另纠正 P0 审计的全仓表述：CPU-DMA 实验已有真实 CPU 的 SW1089/ISE1089/HW289、vendor XSim 7418/7418，
  均为独立 DMA 版本离线结果（board NOT_RUN），不能套给当前 PUF3。已补正 P0 复核文档及看板说明。

## 2026-11-01 — P0 未验收项按现有证据复核与答复纠正（owner TBD）

- 用户要求结合当前数据重新核对。此前把 11 个非 done 任务近似说成未验证，尤其“缺 I04 随机/边界/复位/seed、
  没有中断验证、没有板卡 revision/频率记录”等说法不准确，已纠正。逐项证据见
  `docs/p0_evidence_review_20261101.md`；本轮只读现有结果/源码，不运行硬件或仿真流程。
- I04：`permutation_cases.json` 为 seed 0x800232、6 定向/边界 + 16 伪随机状态，P8/P12 各 22 次；
  当前 XSim 原始日志 ISE 1502/0，summary 中 8 个源/配置/向量哈希与工作区完全一致。
- I03/I05/C03：PUF3 候选 56 个选定生产输入 raw/LF 哈希全部一致、行为协同仿真 54 步 PASS，
  固件构建 7 步 exit 0、静态 custom-0=22；10-31 板测 PASS、simulated=false、三模式各 289+289，
  bit/hwh/manifest 三项绑定通过。当前 RV32 实现与容量内板测不是未验证。
- V01/I05：现有真实 CPU+CLINT 六场景均接受中断并执行 handler/mret，Cache 四 seed 差分与独立事务已验证；
  10-28 regression=15 PASS/0 FAIL/0 BLOCKED/1 NOT_RUN。ISA 为 49 PASS/ma_data 1 FAIL，不是没跑。
  老 ACB 生命周期 MMIO 13212/0、ISE 1502/0、EX 11/0、单元 5/5，但若干当前源码哈希已改变，不能外推为最新全套重跑。
- B03：10-27 冻结记录已有底板 V3.9/核心板 2V5；10-31 PUF3 有 mcycle/PS 时基估测 99.9723 MHz，
  “尚无示波器/Fmax 测量”不能说成“没有任何频率核验”。完整芯片丝印/速度等级、真实 IO 延迟仍未闭合。
- 真正剩余：原 baseline 独立复现/原 FreeRTOS 与 bootloader 构建依赖，完整保留编码/特权异常/RV64/
  ISE 抢占上下文恢复/ISE-disabled 配置、全 1089 目标 KAT；PUF3 完整错误门禁、RO 计数器域与跨上电/PVT 等。
  V10 是文件留存检查未收口，不是功能未测；V04 冻结留档已生成，不等于整个 P0 验收。
- 看板补复核说明，不自动提升旧任务状态；未改 RTL、报告 PDF、原始证据或打包快照，未 commit/push。

## 2026-11-01 — 证据包重装与冻结清单（owner TBD）

- 顺序执行（Python 3.13.9）：`build_evidence.py` PASS 52；`check_benchmark_tables.py` 64/64；`assemble.py --check-only` PASS 267；
  `assemble.py` exit 0 → `submission/evidence_20261101_20261101_183826/`，267 文件，9.0 MB，ZIP SHA-256
  `2a0f0304e975dd14ca3d53989cac78e000f7584aa8303ed6e5f82fe1500dffec`（比 18:17 版多项目简介）。
  独立解包 267/267 一致、0 清单外；PDF=构建记录，52 报告源与 98 证据输入齐全；包内简介/视频脚本/计划与仓库一致。
- 提交 `92159b9`：入口文档更新、`final_report.pdf` 入库、证据包目录；LaTeX 源、截图 PNG、ISE 截图数据/脚本、两个旧 Overleaf ZIP
  保持未跟踪（196 个未入库文件）。
- `freeze_manifest.py` exit 0：冻结源码 `92159b9eb2b368814f86fef0030bd95b71613896`；源码包 `submission/source_92159b9.zip`
  4881 文件、132.8 MB、SHA-256 `0ade4e665743d94d0e3fd173197eb5e34b5ccc3db3b289f3fdba2a22031d95eb`（不入库），CRC 通过，
  报告工程中只含 PDF、不含截图；清单记录报告构建/PDF 哈希/板测主采样与未入库文件列表。冻结时未推送。
- V04 仍 in_progress（P0 未验收项不变）；视频实机录制、PPT 与上传待项目方。

## 2026-11-01 — 入口文档按最终报告/PUF3 10-31 统一，PDF 入库，证据包重装（owner TBD）

- 用户要求：未更新的都更新，内容不过时、数据对应；截图不单独提交；PDF 入库；重新打包并提交。
  经确认：ISE 截图仿真数据/脚本与报告 figs 截图 PNG 都不单独入库，证据包作为完整快照仍包含；Git 继续提交包目录。
- 扫描旧口径（23342/16.221/WNS+0.034/14269、10-29/10-30 板测路径、latex/main.pdf、“PUF 不混入 overlay”）后更新：
  `AGENTS.md`（交付安排与规则 13 加 11-01 PUF3 主演示说明）、`README.md`（状态入口、data 目录、旧计划标注）、
  `docs/project_intro_20261101.md`（重写为 PUF3：21862/1369/3895、15.969×/5.613×、解密 22562/1213/4288、
  18.600×/5.262×、LUT18674/FF32002、WNS+0.104、PUF 127/128 与边界）、`docs/project_overview.md`、`docs/architecture.md`、
  `docs/technical_rules.md`、`tasks/milestones.md`（11-04 作废说明）、`report/readme.md`、
  `report/demo_video_script.md`（整篇改为 PUF3 主演示：身份 PQF3/pynq-svc-puf3、时钟 99.9723、289/289、性能表 4 位小数
  cycles/B、PUF 密钥通路段替换原错误恢复段；v1 9/9 降为可选历史对照段）、PUF3 board readme（10-31 板测）、
  `docs/tech_report/README.md`（旧 Markdown 流水线标注作废）、`docs/current_status_20261029.md`（标为快照）、看板/计划。
  带日期的验证/交接/评审记录与执行过的 Notebook 不改（后者 PUF3 版被报告构建锁定哈希）。改动文件均不在报告构建锁定输入内。
- `check_benchmark_tables.py` 新增配套材料检查：简介、视频脚本、README 必须含由原始数据重算的关键数字，64/64；
  临时把简介 1369 改 1370 后 exit 1，try/finally 恢复哈希一致。简介放回证据包。
- `freeze_manifest.py` 改为只要求已跟踪文件无改动，记录未跟踪（不入库的截图/LaTeX 源）数量与列表，并记录 PDF 是否入库。
- 18:17 的证据包被取代（保留）；新包与冻结结果见下一条。

## 2026-11-01 — 最终报告 PDF 装入证据包（owner TBD）

- 用户确认最终 PDF 已制作完成。核实：`output/pdf/final_report.pdf`（17:47，2430237 B，SHA-256 `603c625a…4825`）
  即报告构建 `build_20261101_174743`（PASS）的产物，与 `build/local/report_puf3_review/build_20261101_174743/main.pdf`
  同字节；之后无新构建，报告源未再改动。
- 顺序执行（Python 3.13.9）：`build_evidence.py` PASS 52 件；`check_benchmark_tables.py` 43/43；`assemble.py --check-only`
  PASS；`assemble.py` exit 0 → `submission/evidence_20261101_20261101_181751/` 与同名 ZIP，266 文件，9.0 MB，
  ZIP SHA-256 `01000e5c2665c638002c95d030a8c73170ca0af3ba12b6cfd19aede41a7a8a53`；`current_evidence.json` 已指向，
  并记录报告构建、PDF 哈希与板测主采样 `data/pynq_puf3/notebook_20261031_114512/result.json`。
- 独立解包：266/266 哈希一致、0 个清单外文件；包内 PDF 哈希 = 构建记录，PyMuPDF 打开 77 页，含 21862/15.969；
  构建记录的 52 个报告源与 98 个证据输入全部在包内且哈希一致；旧 report.md 与过时的项目简介不在包内。
  Git 跟踪 263 件，3 件历史 PL-only `build/local` 报告按 .gitignore 排除（与以往一致），PDF 未被忽略。
- 修正 `--check-only` 预估文件数多算 1（把根 sha256sums 计入），重跑显示 266。
- 未做：冻结清单与源码包（需报告工程入库、工作区干净）；项目简介仍待更新；未 push。

## 2026-11-01 — 合并 ae7a270/c05782d；装配/D02/冻结改指最终 LaTeX 报告与 10-31 板测（owner TBD）

- 用户指出：最终报告引用 `data/pynq_puf3/notebook_20261031_114512/result.json`，而 assemble.py 仍固定 10-30 目录。
  核实属实，且问题更大：证据包收录的是旧 `report.md`/`latex/main.pdf`，最终报告是独立 LaTeX 工程
  `docs/tech_report/amd_fpga_2026_latex_final/amd_fpga_2026_report/`（未入库，仍在修改），主表已改为 PUF3；
  10-31 的 D02 15/15 核对的是旧报告，对最终报告无效；10-31 的三个证据包与冻结清单作废（保留未删）。
- 10-31 数据核实为真实重测：PYNQ v1 benchmark/错误门禁 identity 时间 10-31 11:20/11:28、源码 `ac9143d`，
  release 哈希绑定、`simulated=false`，周期与 10-29 相同；PUF3 10-31 11:45 PASS，bit/hwh/manifest 绑定 candidate，
  三模式 289/289；报告表中 21862/1369/3895、15.969×/5.613×、解密 18.600×/5.262× 与原始数组重算一致。
- 合并：工作区已有另一会话的 `merge --no-commit origin/main c05782d`（冲突以远端为准）。按用户指示原样提交为
  `17d6c51`，未带入其后未暂存的日志/看板改动与未跟踪的报告工程。c05782d 删除 10-30 三次 PUF3 运行（含首次
  62.5 MHz 失败），ae7a270 移走 10-29 主线目录；按用户“以最新一版为主”不恢复，均可从 Git 历史取回。
  远端优先合并丢掉了本文件中 10-31 的 D02/V04 条目，已在下方按原文恢复并标注作废。
- 脚本：`build_evidence.py` 集中维护 `REPORT_DIR`/`REPORT_PDF`/`BENCH`/`GATE`/`PUF3_RUN`（10-31）；C-4/C-5 改收
  已执行的 `src/pynq/pynq_board_{demo,error_gate}.ipynb`（引用 10-31 目录），C 组标为 PYNQ v1 历史对照；重跑 PASS 52 件。
  `check_benchmark_tables.py` 重写为对最终 LaTeX：表 1-1、表 3-13/3-14、摘要、PUF3 资源/时序、PDF 文本、报告引用的
  PUF3 目录必须等于 `PUF3_RUN`，43/43 exit 0；隔离反例（1369→1370、报告追加 10-30 引用）均 exit 1。
  `assemble.py` 新增报告门禁：最近一次 `validation/build_*/summary.json` 必须 PASS，PDF 哈希、52 个报告源、98 个证据输入
  与之一致，`pdf_check`/`evidence_check` PASS 且 `board_result` 为 PUF3_RUN，报告引用的仓库文件全部存在；
  随包收 PDF、LaTeX 源、核对脚本与构建记录、98 个证据原件、引用文件；移除旧 report.md/main.pdf/latex_project.zip/
  appendix_c_raw.md，以及口径过时的 `docs/project_intro_20261101.md`（仍写 23342/1439/3995、WNS+0.034，需队友更新）。
  新增 `--check-only`：267 文件，PASS，exit 0。临时副本上的反例（构建后改报告源、替换 PDF、打包用别的 PUF3 目录）均被拒绝。
  `freeze_manifest.py` 改为引用同一组路径，PUF3 列为主演示工件，增加证据包须绑定当前报告 PDF/PUF3_RUN 的检查，限制同步更新。
- 未生成新证据包与冻结清单：报告仍在修改，且冻结要求工作区干净（报告工程未入库）。`submission/README.md`、
  `tasks/release_plan_20261101.md` 已写明作废与重新生成顺序。未 push。

## 2026-10-31 — D02 数值核对、V04 冻结留档、源码包、证据包再装配（owner TBD；11-01 恢复：合并时被远端优先覆盖。本条 D02 15/15 针对旧 report.md，证据包与冻结清单均已作废）

- D02：新增 `docs/tech_report/evidence/check_benchmark_tables.py`（只读报告），从 warm benchmark JSON、
  `utilization.rpt`、`timing.rpt` 重算并核对 report.md 中表 3-13/3-14 的 6 行、摘要两组 SW/HW/ISE 中位、
  JSON 加速比 4 项、资源与 WNS/TNS/WHS，15/15 PASS，exit 0；故意改报告副本 1439→1440 后 exit 1。
  结果 `docs/tech_report/validation/benchmark_tables_check.json` 记录输入哈希；范围不含历史 PL-only/PUF。D02→done。
- assemble.py 新增 X-7（D02 核对）、X-8（视频脚本），并在 D02 不是 PASS 或输入已过期时拒绝装配。新包
  `submission/evidence_20261101_20261031_163056/`，122 文件，ZIP SHA-256
  `3452e05cd68d182ef5c368b10a997421173e3d444fb291ae6cf9c9f10c01a314`；独立解包 122/122 一致、0 个清单外文件。
  15:40 的包已入库，按规则保留，作为上一版；15:32 的作废包（未入库）已删除。
- V04：新增 `freeze_manifest.py`，要求工作区已提交且干净；用 git archive 生成本机源码包，核对三套工件
  sha256sums、主线 benchmark/错误门禁与 release 绑定、pynq_puf3 板测绑定、L3/DMA 绑定、D02、证据包 ZIP，
  然后写出 `submission/freeze_manifest.{md,json}`。P0 尚有未验收项，V04 保持 in_progress。
- 第一次运行 exit 1：主线 release 的 sha256sums 用的是仓库相对路径。修好后提交为 `af34e65`，在干净工作区重跑 exit 0。
  冻结源码提交 `af34e65895cebf24f066b0a7b6abe9cd14a785cb`；源码包 `submission/source_af34e65.zip`
  （4356 文件，112.3 MB，SHA-256 `d00fa6697aa4c96553393996c3a4d74a8afd2ce00c8f6b49fe6211f25458e31c`，不入库）。
  解压到仓库外后，在包内运行 Skill pytest 64 passed，D02 核对 15/15，均 exit 0。这不等于 D05 完整复现：没有重新构建 Vivado/固件，也没有上板。
  冻结时未推送（`pushed=false`）。

## 2026-11-01 — 撤销旧暂存合并并重新拉取，冲突以远端为准（D03/D06，owner TBD）

- 用户要求放弃上次暂存并重新拉取，冲突优先队友提交的新数据。先创建
  `backup/pre_remote_refresh_20261101_174818` 保留本地 HEAD 的 3 个提交，备份 215 个工作区文件和
  staged/unstaged 补丁至 `build/local/git_refresh_backup/20261101_174818/`，ZIP 逐文件读回校验通过。
- 第一次 `git merge --abort` 因 actual_progress 含未暂存的新记录而拒绝；已有完整备份后暂时还原四份
  日志/看板的工作区增量，成功撤销旧合并。随后 fetch 到 `c05782d510a2c1936b3bb7c45a943ef76cc6bd02`，
  执行 `git pull --no-rebase --no-commit -X theirs origin main`，冲突按远端解决，无未合并文件。
  远端删除旧/失败 PUF3 测试文件的改动按用户授权保留，不从本地备份恢复这些数据。
- 仅恢复不冲突的本地报告/仿真活动记录和看板增量；actual_progress 只插回独立新增的 141 行记录，
  没有恢复被远端冲突策略替换的旧 D02 段。报告、图片、用户后续排版、仿真配置等 198 个受保护文件 SHA-256 未变。
- 验证：`data/pynq/`、`data/pynq_puf3/` 与三个板测 Notebook 对 origin/main 的 diff 为空；无冲突路径；
  PUF3 最新 result 为 PASS/simulated=false，SHA-256 仍为 `958bc66099137c9e7b258d6fee438de911b138d6baf1d4f3559bf7c14d4b3554`。
  结果见备份目录 `refresh_result.json`。未重测板卡或更改数据，未改 RTL/接口。
- 当前是本次新拉取的待提交合并，Git 暂存区为新的合并结果，未 commit/push。本地 3 个提交保留，
  D03/D06 仍按既有终审/核包状态处理；最终提交动作由用户决定。

## 2026-11-01 — D03 图 2-9 连线不再插入框内（owner TBD）

- 用户指出图 2-9 黑线插入框内。原因：PS→MAILBOX 实线在 x=-6.6 下行，而 pynq_mbox.v 框横跨约 -7.7～-4.1，
  线穿过框和文字后再折向左边；pynq-svc-puf3→Ascon 的竖线在 x=6.2，距 Ascon 框右边仅 0.1 cm，像插进框角。
- 只改 `figs/fig_2_9.tex` 连线：实线改为从上方进入 MAILBOX 框顶边左段，link_flush 虚线进入框顶边右段，二者不交叉；
  服务固件→Ascon 改为竖直短箭头进入 Ascon 框顶边。框、文字与说明框未改。
- 单图预编译无 Overfull，渲染确认所有箭头止于框边；`build_review.py` exit 0，194/194 PASS，PDF 77 页，图在印刷页码 23，
  各图排放决定不变。PDF SHA-256 `603c625a8e8f3c1271d9d96f1d4982e15ded676de9262c4ef3813111124e4825`，
  记录 `validation/build_20261101_174743/`。构建与同时进行的重新拉取（上条）相邻；报告目录未被 Git 跟踪，
  事后核对 fig_2_9.tex、preamble.tex 与发布 PDF 哈希均完好。交接 ZIP 未重建，未 commit/push。

## 2026-11-01 — D03 第一部分压缩为 2 页（owner TBD）

- 用户澄清：压缩 1.5、1.6 与图 1-1，使其与 1.4 同在第 3 页。撤回上两轮的 `\Needspace{470pt}`/`{310pt}`（恢复 85pt）。
- `chapters/ch02.tex`：1.5 第 4 条改为一行（“……墙钟与 PUF 门禁构成可复核演示链，旧版证据分列。”）；1.6 正文由 4 行
  压到 3 行，保留六个阶段，删去“11 月 1 日”和 PUF3 未执行的“错误恢复”，引号改为“”。`figs/fig_1_1.tex`：框内行距
  1.05、行间距 1.72/1.55 cm，字号不变；“HWKEY 开关与 KAT 恢复”改为“HWKEY 开关/KAT 恢复”使各框均为三行。
- `preamble.tex`：图题与说明先排入盒子实测高度（`\captionof` 仅执行一次），以 `\pagegoal-\pagetotal-\pagedepth-\intextsep`
  判断，替代原 3.2 行距 + 1 行的保守估计（图 1-1 原被缩到 70% 且下方仍余约 33pt）。图 1-1 现缩放约 92%；
  3-4/3-5 缩放由约 87%/80% 变为约 98%/91%；其余图的原位/浮动决定不变，逐页渲染无溢出。
- `build_review.py` exit 0，194/194 PASS，无 Overfull；PDF 78→77 页，第 3 页含 1.4–1.6 与图 1-1。
  PDF SHA-256 见 `validation/build_20261101_010857/summary.json`。交接 ZIP 未重建，未 commit/push。

## 2026-11-01 — D03 1.5、1.6 与图 1-1 同页（owner TBD）

- 用户要求 1.5 与 1.6 放在一起：`chapters/ch02.tex` 在 1.5 标题前改为 `\Needspace{470pt}`（1.5+1.6+图约 460pt），
  三者一起位于第 4 页；第 3 页在 1.4 后约留半页空白，为用户接受的代价。
- `build_review.py` exit 0，194/194 PASS，PDF 78 页，渲染复核第 3/4/5 页。PDF SHA-256
  `692794de1012e9ba937dc3ef57640f0af5bfc38e691634d36ed76d4626c9aa00`，记录 `validation/build_20261101_004724/`。
  交接 ZIP 未重建，未 commit/push。

## 2026-11-01 — D03 1.6 与图 1-1 同页（owner TBD）

- 用户指出图 1-1 仍与 1.6 正文分页。核实指定 `output/pdf/final_report.pdf` 已是最新构建（封面新名称、78 页），
  图 1-1 未动是因为第一部分末页只剩约 128pt、图需约 194pt（须缩到约 57%，低于 62% 下限）。
- 用户在三种方案中选择“1.6 整节移到第 4 页”：`chapters/ch02.tex` 在 1.6 标题前改为 `\Needspace{310pt}`，
  空间不足时标题、正文和图整体换页；第 3 页在 1.5 后留约 1/3 页空白，为用户接受的代价。
- 首次构建核对通过，但发布时 PDF 被阅读器占用（WinError 32），脚本按设计停止、未覆盖；解锁后重跑
  `build_review.py` exit 0，194/194 PASS，PDF 78 页，第 4 页含 1.6 与图 1-1（原尺寸）。
  PDF SHA-256 `0a95263be6504cfd8eae14f94c5a147c3b9780dacc2d7ea1e3174cf24b5cc890`，记录 `validation/build_20261101_004133/`。
  交接 ZIP 未重建，未 commit/push。

## 2026-11-01 — D03 报告作品名称与报告类型（owner TBD）

- 用户确定作品名称为“RISC-V轻量密码加速SoC”，报告类型去掉“竞赛”。改 `cover.tex` 作品名称与报告类型
  （“技术报告”）、`main.tex` 的 `\title`、`preamble.tex` 的 PDF 标题元数据；报告内仅这三处使用旧名称，正文描述未改。
- `build_review.py` exit 0，194/194 PASS；PDF 78 页，标题元数据为新名称，封面渲染复核。
  PDF SHA-256 `e40afc62fbc96c55a42abe8531b5e71a0f7337df5b4a2aec89f1198d429bb7f8`，记录 `validation/build_20261101_002257/`。
  交接 ZIP 未重建，未 commit/push。

## 2026-11-01 — D03 图 2-14 连线不再穿过框（owner TBD）

- 用户指出图 2-14 右侧连线与“当前 pynq_svc_puf”框重合。原因：该框文字自动换成 4 行、框高超出预设，
  而连线写死从框底引出、在 y=-5.2 横走，正好穿过框内文字。
- 只改 `figs/fig_2_11.tex`：连线改为从框右侧引出，沿右侧空白通道下行再绕到 RV32 CPU 底部，不依赖框高；
  框内文字改为“当前 / pynq_svc_puf / SW / MMIO / ISE / + PUF”四行，按词断行，文字与含义不变。
- 单图预编译无 Overfull；`build_review.py` exit 0，194/194 PASS；PDF 仍 78 页，图在 PDF 第 35 页（印刷页码 31），
  渲染复核无交叠。PDF SHA-256 `d17b058db077b0ce805697ff278cd6dbc652c8dddfc2f86035062f612b24e140`，
  记录 `validation/build_20261101_001522/`。交接 ZIP 未重建，未 commit/push。

## 2026-11-01 — D03 报告插图就近排版（owner TBD）

- 用户反馈图与正文分得太开，并给出此前认可的规则截图。原因：所有插图用 `[H]`，放不下就整体跳到下页、
  本页留白（原 PDF 第 9/14/25/30/47/49 页等）。改为按当前页剩余版面排放：放得下原位；差一点等比缩小
  （不小于 62%）留在本页；仍放不下则浮到下一页顶部、本页由后文补满；已有待排图时后续图一并浮动保持顺序。
- 改动仅限 `docs/tech_report/amd_fpga_2026_latex_final/amd_fpga_2026_report/`：`preamble.tex`
  （`\placefigure`、浮动页顶对齐、longtable 换页时放置待排浮动图的补丁）；`chapters/ch04.tex` 图 3-3 改用同一宏
  并删除两处 `\FloatBarrier`；ch03/ch04/app02 中“标题后紧跟长表”的 10 处 Needspace 85→150pt（含 3.3.5）。
  正文文字、数据、图件内容均未改。
- 发现并修复：长表跨页时 longtable 自带输出例程不放待排浮动图，图 2-10/2-11/2-12 被推后两页；补丁后
  均在所属小节旁。2.3.3.11、3.3.5 标题落在页底而表在下页的问题已消除。
- Python 3.13.9 / Tectonic 0.15.0：`build_review.py` exit 0，194/194 PASS，四张原图像素与各出现一次通过，
  无 Overfull/未解析引用/缺字。PDF 81→78 页，SHA-256 `d1941ebbe7fdcd866656b3f90d9fa30d9439ed7e2c3dd07adf7401c02a922b39`，
  记录 `validation/build_20261031_235755/`、`validation/layout_check.json`；正文 6–66 页逐页渲染复核。
- 已知余项：图 1-1 因第一部分已无空间、被第二部分换页推出，单独位于第 8 页顶部；第 51 页因表 3-11 首行
  不能拆分底部约 24% 留白。交接 ZIP 未重建；D03 仍待队友终审，未 commit/push。

## 2026-10-31 — D03 补入资源利用率和 ISE 实际截图（owner TBD）

- 用户提供 `Report Utilization.png` 与 `Wave.png`，核对与父目录同名原文件一致，按原字节复制为报告
  `figs/vivado_utilization.png`、`figs/vivado_ise_waveform.png`，分别替换图 3-2、3-5 占位；现有四张工程截图各出现一次。
- 资源图的 top/LUT/FF/BRAM/DSP 与 PUF3 实现报告一致。ISE 图注限定实际可见的 P8 start=380 ns、done=495 ns；
  说明 Objects 末态 1502/0 与 Wave 150 ns 光标值的区别，以及控制台 get_waves 缺 patterns 的查询错误，
  不把局部图外的 ack/cancel/P12 当作截图已展示。附录增加同日 ISE 自检日志、源哈希和 1502/0 证据。
- Python 3.13.9 / Tectonic 0.15.0：`build_review.py` exit 0，核对 194/194 PASS，四张原图像素及各一次嵌入通过，
  无 Overfull/页边界溢出/未解析引用；新增图的 PDF 文件页 46、52 已视觉复核。
- 指定 final_report.pdf 为 81 页，SHA-256 `ddc915c0a57faee46a50187036ed39f4362dcbd20c36f3886d94f47711403a7c`。
  同步交接 ZIP，69 文件读回哈希一致，ZIP SHA-256 `6f76d92ff434378ddb3f35a9bba2186d813424a8349971c14eacdeb0407fa44b`。
  工程截图缺项已补齐，D03 保持队友终审状态，D06 仍需重新装配比赛证据包；本次仅报告工作，未修改硬件或 commit/push。

## 2026-10-31 — D03/I04 配置 PUF3 工程的 ISE 截图仿真（owner TBD）

- 用户要求配置现有工程后自行截图。在 `build/local/pynq_puf3/vivado/pynq_puf3.xpr` 新建并激活
  `sim_ise_screenshot`，top=`tb_key_ise`；设计 top 仍为 `pynq_puf3_wrapper`，part=`xc7z020clg400-1`。
  原 XPR 备份在 `build/local/pynq_puf3/ise_screenshot_backup/20261031_224938/`。
- 新增 `sim/ascon/configure_ise_screenshot.tcl`、`run_ise_screenshot.tcl`、
  `ise_screenshot_view.wcfg`、`check_ise_screenshot.py` 与 `ise_screenshot_readme.md`。
  使用原 TB、原置换向量和原 ISE RTL；运行前自动安置向量，记录 15 个重点信号，保存 WDB/VCD/WCFG，
  加入 P8/P12 start/done/ack 与 cancel 标记，50 us 有界运行。
- 验证（Vivado/XSim 2025.2，Python 3.13.9）：编译、展开、真实运行 exit 0；
  `SUMMARY ISE checks=1502 errors=0`，37390 ns 正常 finish。最终关闭增量编译后全量重新编译验证 PASS；
  `python -X utf8 sim/ascon/check_ise_screenshot.py` exit 0，从 VCD 重读 1502/0 及握手边沿。
  日志/源哈希/波形哈希在 `data/ascon/results/ise_screenshot_20261031/`，波形在
  `build/local/pynq_puf3/ise_screenshot/`。sources_1/constrs_1 文件条目和 candidate bit/hwh/manifest 哈希均未变。
- 原生 Vivado GUI 已打开并保留已完成仿真，当前视图 `ise_screenshot_view.wcfg`；推荐截图范围
  300–1800 ns，取消场景 36650–37100 ns。资源图仍从同工程的 implemented design 读取。
- 边界：这是 ISE 单元行为仿真，不是整机/时序/CDC/实板复验；没有改 DUT、TB、接口或重跑实现。
  BD protoinst 可视化提示“无 pynq_puf3 实例”保留，原因是仿真 top 为单元 TB。D03 仍待用户截图与终审，
  I04 的完整验收边界不变。未 commit/push，Vivado 保持打开供用户操作。

## 2026-10-31 — D03 删除重复实现截图并说明补图入口（owner TBD）

- 用户指出 Implemented Design 被放了两次；删除第三部分的重复插图，改为引用图 2-11，第三部分图号顺延。
  缺图现为图 3-2（PUF3 资源利用率）、图 3-5（ISE 仿真波形）；只调整文档，无硬件/接口改动。
- 查实当前工程 `build/local/pynq_puf3/vivado/pynq_puf3.xpr`，资源入口是 Open Implemented Design →
  Reports → Report Utilization；当前 sim_1 top=top_pynq，未挂 ISE TB，build/data 未找到 WDB。
  可用 TB 为 `sim/ascon/tb_key_ise.v`，EX hold 交互为 `tb_key_execute.v`；说明写入报告 readme。
- Tectonic 0.15.0 构建 exit 0，核对增加“每张截图恰出现一次”，176/176 PASS、无 Overfull；交接 ZIP 同步重建，
  66 文件读回哈希通过。最新 PDF 80 页，SHA-256 `09ef4bde0e9306b585385e90926d6d8d140df0877bfc6135c1856b5a1fa1fdb3`；
  ZIP SHA-256 `1ef847b0aa2274ec389079f3396c6da50e7d5da1fce8d4137d3687869f5e0639`，取代下条的本轮上一版交接产物。
  D03 继续待队友终审/补图；未 commit/push。

## 2026-10-31 — D01/D02/D03 队友 LaTeX 终稿按 PUF3 核对（owner TBD）

- 用户指定最终演示对象为 PUF3，要求将两张实际 Vivado 截图加入
  `docs/tech_report/amd_fpga_2026_latex_final/amd_fpga_2026_report/output/pdf/final_report.pdf`。
  以该独立交付目录的 `chapters/*.tex`、`figs/*.tex` 为维护源，保留封面/页眉/版心/五部分结构；
  原 ZIP 保留，修改前副本在 `build/local/report_puf3_review/before_review.zip`。
- 按用户补充要求 `git fetch origin`，远端更新到 `c385a9d`，本地有 3 个未推送提交，故
  `git merge --no-commit --no-ff origin/main` 纳入更新；actual_progress 顶部冲突同时保留双方条目并标记解决。
  没有创建合并提交、没有 push；Git 仍处于待提交合并状态。新增 10-31 板测与 Notebook 来自远端，不是本轮重测。
- 主证据改为 `data/pynq_puf3/notebook_20261031_114512/result.json`，与 candidate 的 bit/hwh/manifest
  哈希一致。摘要、主表、图内数字、身份/源集/构建/上板说明统一到 PUF3：加密 21862/1369/3895、
  解密 22562/1213/4288 cycles；PS 墙钟改用当天摘要；mcycle/PS 时基估测 99.9723 MHz。
  LUT/FF=18674/32002、WNS/WHS=+0.104/+0.041，明确 RO 计数器域未签核、DRC 与 methodology 分开。
- 两张 PNG 原字节入 figs；图 2-10 为 Block Design，图 2-11/3-2 复用 Implemented Design。
  附录 C 由 `review_evidence.py` 从原件生成；旧 release 9/9 错误门禁、全长度周期统计与历史 PL-only
  保留原归属。PUF3 quality=127、连续 5 次重建/HWKEY 恢复通过不升级为跨上电或安全性验收。
- 源码复核纠正“驱动结束显式清零”：当前 `pynq_svc/ascon_modes.c` HW 路径没有发 ZEROIZE；
  `pynq_svc_puf/main.c` 响应后清 rxbuf/txbuf 位于计时外，不能等同硬件状态或 PUF helper/key 清零。
  本轮只改报告与核对工具，没有改 RTL/固件/工件/ABI，也没有重跑 Vivado、仿真或实板。
- 验证：Python 3.13.9、Tectonic 0.15.0；本目录 `build_review.py`、`review_evidence.py --pdf ...`
  exit 0，证据/正文/PDF 174/174；隔离副本将表 3-13 的 1369 改成 1370，核对器 exit 1 正确检出。
  PDF 截图像素与原 PNG 一致；无未解析引用/缺字，布局越界检查通过；详情见该目录 validation/。
- 最终 PDF 81 页，SHA-256 `d777912b656d74b136c525a1e190a7180bb417120383d169052abdd04555a8e2`。
  同目录 `output/amd_fpga_2026_report_puf3_review.zip` 为 LaTeX 源/原图/摘录/验证记录/PDF 交接包，
  66 个文件逐项读回哈希一致，ZIP SHA-256 `3337e58334980707cce200c967de9579de0704eb1c5b49cd1c8f387343c4e2fb`；
  这不是包含全工程的 D06 最终比赛包。
- 未补：图 3-3 的 PUF3 资源界面、图 3-6 的真实 ISE 波形、完整丝印等现场材料；完整 PUF3 错误门禁、
  RO 签核、跨上电/PVT/熵/BER/唯一性、小时级与 D05 不升级为完成。D03 待队友终审，D06 须用本稿和
  新板测重新装配证据包/冻结清单；`submission/current_evidence.json` 的旧包不包含本次报告更新。

## 2026-10-31 — PYNQ demo Notebook 全量 KAT 说明同步（owner TBD）

- 用户将 `src/pynq/pynq_board_demo.ipynb` 的 `RUN_FULL_KAT` 设为 `True` 后在板上执行；
  内嵌输出显示 SW/HW/ISE 三模式均为 `289/289` KAT 通过、`289/289` 错误 Tag 拒绝，
  run 时间为 `2026-10-31T11:04:58`。
- 同步修改该 Notebook 第 1 节标题和说明，以及末尾使用说明：明确当前运行容量内全部
  289 组 KAT，并保留改回 `False` 时每模式运行 6 个代表用例的快速回归方式。未修改
  `board_demo.run()`、release、RTL、固件、benchmark 参数或已保存执行输出。
- 验证：Notebook JSON 解析 PASS；`python -B src/pynq/test_board_benchmark.py` 为
  5 tests / OK / exit 0；该 Notebook 的 `git diff --check` exit 0。超过 16-byte 的
  800 组仍为 `NOT_RUN`。下一接收：按需将板端 `notebook_20261031_110458` 证据目录
  归档回仓库，owner TBD。
## 2026-10-31 — Skill 独立下载复核与 gen 文档漏洞修复（owner TBD）

- 复核：`git archive` 导出 `skill/pynq-overlay-workflow` 到仓库外，60 passed/3 skipped（仅依赖本仓库板卡文件的用例按设计跳过），Skill 内无仓库路径。发现：照 SKILL.md 运行 `gen` 生成的测试骨架报 ImportError（生成代码导入 `pynq_skill`，文档未说明路径；板上同样缺包）。
- 修复：`gen` 默认把 `pynq_skill` 复制进输出目录（自包含），`--no-vendor` 时打印可用的 PYTHONPATH；SKILL.md 第 7 节补生成/运行/上板步骤。测试改为不设 PYTHONPATH、在无关工作目录运行生成骨架，并新增 `--no-vendor` 用例。
- 验证：仓库内 64 passed；仓库外复制 61 passed/3 skipped，生成 vadd 骨架 14 passed/1 skipped，板上式导入正常；变异 16/16。只改 CLI/文档/测试，未改 L3 实板验证过的 loader/regmap/DMA/golden。

## 2026-10-31 — 最终候选证据包装配（owner TBD）

- 用户确认 Skill gen 修复完成后复验（Python 3.13.9）：`pytest skill/pynq-overlay-workflow/tests -q` 64 passed，
  exit 0；`skill_mutation_check.py` 16/16 killed，exit 0；`skill/ab_eval_pynq/harness/tests` 7 passed，exit 0。
- `python -X utf8 docs/tech_report/evidence/assemble.py` exit 0：`submission/evidence_20261101_20261031_154020/`
  与同名 ZIP，119 文件，26.0 MB，ZIP SHA-256 `c507447e86ca819f2c29e8fcec9146a5e915ba35a328a4c58d8ca78e9737b0fa`；
  独立解包 119/119 哈希一致、0 个清单外文件，除包自带 README 外与工作区文件一致。`current_evidence.json` 已指向此包。
- 15:32 的包含 Skill 中间版本，已作废但保留未删；10-29 包同样保留。
- 包内报告 PDF/Overleaf ZIP 为 14:30 构建版；如果报告再改，需要重建 PDF 后再装配一次。Skill 修复与本次改动均未 commit/push。

## 2026-10-31 — 证据包重新装配；看板与提交计划更新（owner TBD）

- `docs/tech_report/evidence/assemble.py`：在原 C-1～C-12 外新增 X-1～X-6（pynq_puf3 候选/实现报告、
  10-30 实板 Notebook 结果、`pynq-overlay-workflow` Skill 本体、L2 结果、L3 session、DMA 候选与 S04 示例），
  另加 `tasks/task_board.md`；包内生成 `extra_manifest.md`。装配前门禁：两个 candidate 的 sha256sums、
  pynq_puf3 结果 PASS/`simulated=false`/bit·hwh·manifest 绑定/三模式 289+289、L3 summary 全 PASS、
  L3 DMA 绑定 candidate 哈希、L3 绑定的 L2 文件哈希。未改 `build_evidence.py`，报告附录 C 不变。
- 首次运行 exit 1：L2 `README.md` 与 L3 绑定哈希不一致。查明 L3 绑定的是 `1a44b92` 版本，`63b39f9`
  只把“板级效果 not_measured”改为 L3 状态说明。门禁改为：工作区不一致时须在 Git 历史中找到被绑定
  版本才放行，并写入 `extra_manifest.md` 的“绑定说明”。
- 结果：`submission/evidence_20261101_20261031_153258/` 与同名 ZIP，119 文件，ZIP SHA-256
  `de445908f14b4e1f7301e0a1143eac27394a28bd913cdf45e8681e1c7e701c9d`，26.0 MB；独立解包后 119/119
  哈希一致，0 个清单外文件。`current_evidence.json` 已指向新包；10-29 包保留未删。
- 已知问题：装配时（15:31–15:33）`skill/pynq-overlay-workflow/` 下的 `SKILL.md`、`scripts/pynq_skill_cli.py`、
  `tests/test_regmap.py` 正被他人修改，尚未提交；包内 `SKILL.md` 是中间版本，和当前文件哈希已经不一致。
  我没有动这些改动。报告终稿和这几份 Skill 改动都定稿后，必须再运行一次 assemble.py，新包才能作为最终提交包。
- `tasks/release_plan_20261101.md`：补 pynq_puf3 与 Skill 两行，执行表加 10-31 状态，Skill 决策改为
  `pynq-overlay-workflow`。`tasks/task_board.md`：D03/D06→in_progress，D06 日期按 10-29 授权改 11-01；
  P05 维持原状态（RO 域时序与跨上电未闭合），补 10-31 注。未硬件重测。

## 2026-10-31 — D04 演示视频脚本（脚本完成，实机未录，owner TBD）

- 基于最新 2026-10-29 PYNQ 实板证据新增 `report/demo_video_script.md`：
  5 分 20 秒主版时间轴、中文旁白、逐镜画面与字幕、3 分钟压缩版、可选 PUF
  独立原型段、录制清单和事实卡。
- 主性能叙事固定为同一轮 KAT #529、PT=16 B、AD=0、预热 5 次和 30 次采样的
  `mcycle`：SW/HW/ISE 加密 23,342/1,439/3,995 cycles，16.221×/5.843×；
  解密 24,005/1,388/4,385 cycles，17.295×/5.474×。明确 PS wall time
  不参与加速比，容量与 PUF 原型边界保留。
- D04 由 todo 改为 in_progress；仅有脚本与分镜，真实板级视频、最终视频哈希
  索引和 D04 验收仍未完成。未改 RTL、固件、测试数据、release 或接口。

## 2026-10-31 — S04 报告采集收口；S05 README 补齐（owner TBD）

- S04：`pynq_skill/report.py` 新增可配置指标 schema（`load_schema`/`collect_metrics`/`resolve_path`，来源 utilization/timing/json，汇总 count/sum/min/max/mean/all_true）、`tool_report` 证据级别、估算必须写 basis、缺失一律 `not_measured`、必需缺失 CLI exit 1；`references/report_schema.md`、`examples/report_schema.dma_loopback.json`。
- 非 Ascon 数据示例：AXI DMA 回环 Vivado 报告 + L3 `30_non_ascon_dma.json` → `data/skill/s04_report_dma_loopback/`（16 指标，1 个 not_measured：板上吞吐量未采集）。
- 验证：`python -m pytest skill/pynq-overlay-workflow/tests -q` 63 passed/0 skipped；`skill_mutation_check.py` 16/16 exit0；`skill/ab_eval_pynq/harness/tests` 7 passed。L2/L3 验证对象仍为 `7bc1abf`；S04 新增部分仅离线验证，未重跑 L2/L3。
- S05：`skill/readme.md` 补依赖/输入输出/步骤/判据/失效条件/平台/来源、L1–L3 验证案例表、陌生使用者复现（HChenZ 未参与编写，git 作者记录佐证）。看板 S04→done；S05 经用户确认→done。

## 2026-10-31 — L3 四段实板 PASS；S01–S03 收口（owner TBD）

- 最新 session `data/skill/l3_20261031_063709/`：preflight、Ascon、GPIO、DMA 和
  summary 均 PASS；汇总 claim 为 `hardware_measured`，0 problems。递归统计 59 个
  PASS、1 个 NOT_APPLICABLE、0 FAIL/ERROR/MISSING。
- DMA 使用候选工件 `890add35…/27bcceca…`，8/9/16/64/256 B 与连续 16 B
  回环数据均一致；超限在启动前拒绝，mutation 被检出，DMA 最终 halted。
  `short_output`/`missing_tlast` 标记 `not_tested`，需要专用可恢复故障源。
- 因此三层验证中的 L3 功能段完成，S01/S02/S03 可标 done。S04 仍缺非 Ascon
  performance/report collector 实例；S05 仍缺陌生使用者复现、executed Notebook/
  SHA-256 证据清单及最终材料收口。全 S01–S05 尚不能标全部完成。

## 2026-10-31 — 非 Ascon AXI DMA 回环 overlay（离线门禁通过；后续板测见顶部）

## 2026-10-31 — LLM 协作记录入库、Ross 心得、未跟踪文件清理（owner TBD）

- 核实技术报告 2.5.4 的统计：`report/llm_collab/index.md` 与 `sessions/` 下的 21 个文件一致，其中 13 个是工程会话，共 76 条提示、2635 次工具调用；此前整个目录都未纳入 git。按用户决定省略 1 条与工程无关的用户提示原文，保留轮次与计数，并在 `export_sessions.py` 中用 `OMIT_PROMPTS` 记录这条规则；报告 2.5.4 改为“四项处理”。报告重新构建通过（`docs/tech_report/validation/build_20261031_142948/`，verify_report PASS，76 页）。本地 commit `cc39c9d`（llm_collab、report/readme、`docs/ross_usage_experience.md`），未 push；报告源改动随 `docs/tech_report/` 保持未跟踪。
- 新增 `docs/ross_usage_experience.md`：依据 project_log 与已有验证文档整理，不含新测量。
- 标准清理删除 95 个未跟踪路径（831 个文件，191.7 MB）：0 字节的 `ps_clock_registers.log`、已被 `current_evidence.json` 取代的 `submission/evidence_..._233348` 及其 zip、30 次旧报告构建记录（只保留最新一次）、`figbuild/`、过期的 `latex.zip`、`latex/main.log`，以及 `data/advanced` 中没有被 readme、清单或脚本引用的中间重跑目录、10 个重复的 `ring_ack_*` 和 puf_min 扫掠的 DCP（`sweep*.tsv` 与 rpt 保留）。`current_candidates.json` 列出的路径和当前证据包都还在。未跟踪文件从 2621 个降到约 1820 个。
- 误删一项后已补救：`data/advanced/puf_min/impl_20261030_115206/` 被 `src/rtl/puf_min/readme.md` 引用，原目录里只有 context.txt，已无法恢复。已从 `board/.../puf_min/work/` 中原样复制同一次 OOC 综合的 utilization 报告和 runme.log，并写入说明与 SHA-256。
- `.gitignore` 新增报告构建的临时文件 `figbuild/`、`latex/main.log`。
- 按用户要求，把扩展实验的源码、文本证据、技术报告源、当前证据包目录以及 10-29 的规则文档改动提交并推送。以下不入库，只留在本机：`data/advanced` 的 DCP、exe、xsim.ini；除两个当前候选以外的 bit，以及已作废的 PUF v2 bit（其哈希保留在 manifest 中）；`latex/main.pdf`、`latex_project.zip`；`submission/*.zip` 和旧的 `submission/evidence/`。规则写在 `.gitignore` 中，ZIP 的重新生成方法写在 `submission/README.md`。提交前已做密钥扫描，命中 0 条。

## 2026-10-31 — 非 Ascon AXI DMA 回环 overlay（Skill L3 工件；离线门禁通过，board NOT_RUN，owner TBD）

- 按用户要求只做 DMA、不做 GPIO：新增 `board/vivado_zynq7000_xc7z020_axi_dma_loopback/`（build.tcl、package.py、readme、candidate）。PS7 GP0→互连→`axi_dma_0/S_AXI_LITE`（0x40400000/64K）；MM2S/S2MM→互连→HP0（64 位）；AXI DMA 7.1 simple 模式（SG=0、32 位、无 DRE、length width 14）；`M_AXIS_MM2S` 直连 `S_AXIS_S2MM`（hwh 证实 TLAST 同网）；全部 FCLK0，`proc_sys_reset` 分 interconnect/peripheral 复位；无中断。
- 板卡相关：FCLK0 按 pynq_puf3 已验证的修正固定 IOPLL FBDIV 30、分频 10×1（ACT 99.999999）；PS7 DDR 参数按厂家 base（MT41J256M16 RE-125、32 位，1 GiB），使 DMA 的 HP0 窗口为 0x0–0x3FFFFFFF。第一次构建用 IP 默认 512 MiB 窗口，打包前 hwh 检查发现，作废未发布（`build/local/axi_dma_loopback/vivado_ddr512m`）；build.tcl 已加两个 DMA 地址空间的窗口回读门禁。
- 结果（Vivado 2025.2，Performance_ExploreWithRemap + 布线后 phys_opt）：WNS +1.736/WHS +0.025，无无时钟/无约束端点，DRC 0，无 Netlist 29-160，全部布通；2436 LUT/3333 FF/2 BRAM。bit `890add35…`、hwh `27bcceca…` 同名，`manifest.json` 由 Skill 的 `artifacts.write_manifest` 生成并经 `check_artifacts` 复核；`package.py` 核对 hwh 参数、回环/TLAST、HP0 窗口、FCLK0，并用 Skill 的 `parse_hwh`/`config_from_hwh`（max 16383、对齐 4）确认 L1 兼容；`pynq_skill_cli.py hwh --contract axi_dma_simple` 显示契约与 hwh 寄存器一致。
- L3 Notebook 已接入该工件：`l3_30_dma.ipynb` 默认使用仓库 `candidate/`，新增
  manifest part/VLNV/simple/双通道/TLAST/HP0、运行时基址、manifest SHA-256 和
  TX/RX buffer HP0 窗口检查；`l3_00_preflight.ipynb` 也把 DMA 源和候选工件纳入
  关键文件哈希。artifact CLI、HWH 解析、DMA config 与 5 个 Notebook AST 均通过；
  板上 DMA 仍 `not_run`。
- 该工件后续已在 session `l3_20261031_063709` 完成功能板测；DMA 吞吐仍未测，
  无行为仿真（Xilinx AXI DMA IP 未做 XSim），`short_output`/`missing_tlast`
  仍需专用故障源。

## 2026-10-31 — L3 最新 session：preflight/Ascon/GPIO PASS，DMA 阻塞（owner TBD）

- 最新 session `data/skill/l3_20261031_030131/`：`00_preflight.json`、`10_ascon_release.json`
  和 `20_non_ascon_gpio.json` 均 PASS；Ascon 与 GPIO 的 claim 为 `hardware_measured`，
  `simulated=false`。
- GPIO 选择 `leds_gpio`，3-bit、`C_ALL_OUTPUTS=1`；DATA 写入/读回
  `0/7/5/2` 全部一致，原 DATA 恢复为 0，错误 contract 被拒绝。TRI 按该配置
  标为 `NOT_APPLICABLE`。
- `30_non_ascon_dma.json` 为 `NOT_RUN`，原因是没有非 Ascon DMA 回环工件；
  `40_summary.json` 为 FAIL，唯一 problem 是 `30_non_ascon_dma status=NOT_RUN`。
  该 session 的预检哈希与随后更新的 `l3_00/l3_30/l3_40` 已不一致，因此当前 L3
  不能标完成；最终取证必须用当前代码创建新 session 重跑。

## 2026-10-31 — L3 实板 preflight/Ascon PASS，GPIO 方向读回失败（owner TBD）

- 新 session `data/skill/l3_20261031_023742/`：`00_preflight.json` PASS，关键依赖和
  L2 归档哈希齐全；`10_ascon_release.json` PASS，`claim_level=hardware_measured`，
  正式 release、control/mailbox ID、服务握手、`simulated=false`、自检 mask 7 通过。
- GPIO C 首次在写入 `GPIO_TRI` 后读回 `0xFFFFFFFF`，但原始参数确认
  `leds_gpio` 是 `C_ALL_OUTPUTS=1`：方向由硬件固定为输出，TRI 不是该配置下的测试
  oracle。测试的 `finally` 已恢复原值。Notebook 已改为对 all-output GPIO 跳过 TRI
  编程、直接验证 `GPIO_DATA`，同时保留 all-input 过滤、候选参数和失败详情；
  板上复测 NOT_RUN。
- DMA D 仍缺非 Ascon 回环工件，未执行。L3 不能标完成。

## 2026-10-30 ~ 10-31 — pynq-overlay-workflow Skill L2 受控实验 + 留出任务（`simulated`，owner TBD）

- 根据 L2 归档完成 L3 方案局部调整：预检新增五个 Notebook、`src/pynq` 实际依赖、
  `pynq_skill` 脚本树和 L2 归档文件的 SHA-256；DMA 增加 9-byte 奇数长度、16-byte
  连续重复及超过 `max_transfer` 的启动前拒绝测试。`short_output` 与缺失 TLAST 明确
  `not_tested`，不在正式回路上制造挂死。汇总要求绑定 `l2_evidence`，并保持 L2 为
  `simulated`、不能补证因果或泛化。5 个 Notebook JSON/AST 与 diff 检查通过；
  Skill 工具 47/47、假 PYNQ API 7/7。新逻辑尚未上板，旧
  `l3_20261030_163953` 预检因缺少新字段需重跑。
- 用户授权按 `skill/ab_eval_pynq/README.md` 执行 L2（Agent 层 A/B/安慰剂）。模型 `deepseek/deepseek-flash`，
  4 题（T1 overlay、T2 HLS、T3 DMA、T4 诊断）× `with`/`without`/`placebo` × 5 次 = **60 次 `opencode run`**，
  另加 T1×placebo 修复仪器后复跑 5 次，共 65 次，`65/65 exit=0`，无 hang。试验目录在仓库外
  `C:\Nebula\HChenZ\Projects\ab_trials\{run1,run2,run1_fix_t1_placebo,run3}`，seed 20261030，`allow_shell=false`。
- L1 复核（Python 3.14.0）：`pytest skill/pynq-overlay-workflow/tests -q` 47 passed；`skill_mutation_check.py`
  13/13 killed；判分器 good/naive 区分度 T1 6/6·3/6、T2 6/6·0/6、T3 6/6·3/6、T4 8/8·0/8。
- 配置生效性冒烟：agent=`trial`、模型=deepseek-flash、shell 被拒（模型报 `NO-SHELL`）、`/api/skill` 证明
  Skill 已注册可加载、canary 写入成功。
- 修正一个设计缺陷：模型能加载 Skill 但在真实任务里**不主动加载**（首轮 canary 缺失），`with` 组会退化成
  `without`。按用户决定在三组 `PROMPT.md` 末尾追加**同一句**中性提示（`make_trials.py:PROMPT_SUFFIX`），
  组间仍只差 Skill 文件与权限规则；修订已写进 `skill/ab_eval_pynq/README.md` 第 2 节。
- 主结果（场景通过率，`simulated`，修复仪器后，主指标 T1–T3，n=15/组）：`with` **1.000（15/15）**、
  `without` 0.833、`placebo` 0.844；`with` vs `without` +0.167，p=0.0425，δ=+0.33（显著）；
  `with` vs `placebo` +0.156，p=0.2248，δ=+0.20（**未达显著**）；`placebo` vs `without` p=1.0。
  T3 单独 `with` vs `without` p=0.0476、δ=+0.80；T1 ceiling（`with` 1.000 vs `without` 0.933，p=1.0）。
  T4（文字诊断，次指标）`with` 1.000 / `without` 0.900 / `placebo` 0.825，`with` vs `placebo` p=0.0079、δ=+1.00
  （区分点 Q6 clear-on-read，规则较粗，不算主结论）。T1–T4 探索性合并（n=20/组）`with` vs `without` p=0.0014、
  `with` vs `placebo` p=0.0030。
- 天花板：T2（HLS）三组全部 30/30 场景通过，对该模型无区分度，稀释了合并效应量（δ +0.50→+0.33）。
- canary（次指标）：`with` 20/20、`placebo` 20/20、`without` 0/20；`pynq_skill` 辅助库引用 0/60。
- 仪器缺口与修正：首轮 `fake_pynq` 缺 `pynq.Bitstream`（真实 PYNQ 2.7 有，且 `Overlay` 继承它）、
  `hierarchy_dict`、`device`，`t1_overlay/placebo/rep04` 的正确写法被 `ImportError` 判 0 分。已补齐并让
  `Overlay` 继承 `Bitstream`，新增 `harness/tests/test_fake_pynq_api.py`（7 例）钉住 API。重判旧批次只有该
  试验 0.000→1.000；旧 placebo 合并均值 0.683→0.783、`with` vs `placebo` p 0.0867→0.2105（**越修越不显著**，
  照实记录）。T1 的 placebo 随后重跑 5 次（0.900）作为最终数据。
- 留出任务：先做 `t5_gpio`，发现与 Skill 自带的 `examples/axi_gpio.contract.json`（写着 `GPIO_TRI ... 1 = input`）
  撞车后作废；改用 `t5_bram`（AXI BRAM：字节读-改-写、窗口容量、连续调用），假 PYNQ 新增 `Bram` 模型与
  `span` 路由，自检 good 7/7、naive 3/7。正式跑 15 次（`run3`，15/15 exit=0）：`with` 1.000、`without` 0.800、
  `placebo` 0.800，`with` vs `without` **p=1.0**、δ=+0.20 → **主实验差异未复现**；差异来自 2 个试验把
  `ip_dict` 键名写成 `vlnv`（正确是 `type`），属真实错误而非仪器缺口，10 个非 `with` 试验中 8 个满分。
- 判读边界：按预注册规则不能宣称"提升来自 Skill 的技术内容"（`with` vs `placebo` 不显著），也不能宣称
  已泛化到新任务（留出任务未复现）。板级效果 `not_measured`。

## 2026-10-31 — L3 Notebook 配置项注释与文件名同步（board NOT_RUN，owner TBD）

- 按用户要求，五个 L3 Notebook 已统一固定仓库绝对路径为
  `/home/xilinx/jupyter_notebooks/amd_fpga_2026`，移除 `ASCON_REPO` 与父目录搜索；
  路径不存在时直接给出固定路径断言。README 同步说明“换路径需统一修改五个 Notebook”，
  不再把环境变量作为入口。JSON/AST 与 `git diff --check` 通过，板上 NOT_RUN。
- 用户从 `skill/ab_eval_pynq/test_board/` 直接启动时，`find_repo()` 只检查当前目录与
  两级父目录，未覆盖仓库根目录位于第四级的情况，实际报
  `RuntimeError: repository not found; set ASCON_REPO`。五个 Notebook 已改为遍历全部
  父目录，并让异常列出实际搜索路径；从该子目录实测可解析到仓库根目录，JSON/AST
  与 `git diff --check` 通过。未上板，不能据此判断 PYNQ 环境。
- 在 `skill/ab_eval_pynq/test_board/` 五个 Notebook 中，为自动采集字段、可选环境变量、
  安全开关、缺失工件占位和刻意故障值逐项添加行内注释；明确 `None`/空列表不是待手工
  填写的常量，`outputs=[]` 和 `execution_count=null` 也会在 Jupyter 实际运行时生成。
- 按用户当前文件名同步 `l3_20_gpio.ipynb`、`l3_30_dma.ipynb` 的 README 和进度引用；
  JSON 结果文件名仍保持 `20_non_ascon_gpio.json`、`30_non_ascon_dma.json`，避免改变
  已定义的证据 schema。
- 验证：5 个 Notebook JSON 可解析、全部代码单元 Python AST 通过、`git diff --check`
  exit 0。未加载 PYNQ，未产生板级数据，未改 RTL/固件/release；未 commit/push。

## 2026-10-30 — PYNQ Skill L3 上板 Notebook 入口就绪（board NOT_RUN，owner TBD）

- 新增 `skill/ab_eval_pynq/test_board/`：预检、Ascon release、非 Ascon AXI GPIO、
  非 Ascon AXI DMA 回环和结果汇总五个 Notebook；所有执行入口均为 `.ipynb`。
  原始结果统一写入 `data/skill/l3_<时间>/`，由 `data/skill/l3_current_session.json`
  关联同一 session。
- `l3_00_preflight.ipynb` 冻结 Skill/release/manifest 哈希，并用篡改 manifest 证明下载前
  hash gate 有效；`l3_10_ascon_release.ipynb` 使用通用 artifact/overlay 检查和真实服务握手；
  `l3_20_gpio.ipynb` 使用 PYNQ BaseOverlay LED GPIO 和 contract/RegisterMap，
  原状态在 `finally` 中恢复。
- 非 Ascon DMA bit/hwh 当前未准备。`l3_30_dma.ipynb` 已包含有界 DMA、
  sentinel、实际长度、golden 和 mutation 检查；缺少显式 `L3_DMA_BIT` +
  `L3_DMA_MANIFEST` 时会保存 `NOT_RUN` 并非零退出，不能误报 L3 PASS。
- 验证：5 个 Notebook JSON 可解析、全部代码单元 Python AST 通过；D 盘 Python 3.14
  在显式工作区临时目录下运行既有 Skill 测试 **47 passed**，变异检查
  **13/13 killed**。汇总逻辑在临时 session 中验证了 DMA 缺失时
  `PARTIAL/FAIL`、补齐 DMA 后 `PASS` 三种路径。本机无 `nbformat`，未执行
  `nbformat.validate`；未加载 PYNQ、未生成实板 L3 数据，L2 运行未触碰。
- PYNQ 2.7 的 `Clocks.fclk0_mhz` 只作为寄存器派生观察值记录，不作为硬失败；
  HWH 设计值仍要求 100 MHz，真实频率沿用 Vivado、mcycle 或独立测量证据。
- 文档：`skill/ab_eval_pynq/test_board/readme.md` 给出板端 Jupyter 顺序执行、
  `nbconvert` 无界面运行、DMA 工件接口和完整/部分 L3 判定；`data/skill/readme.md`
  规定 `hardware_measured`/`simulated`/`not_measured` 口径。未 commit/push。

## 2026-10-30 — pynq_puf3 完整容量内 KAT 实板通过（提交 7544921，owner TBD）

- 证据：[result.json](../data/pynq_puf3/notebook_20261030_144328/result.json)、
  [mailbox_log.txt](../data/pynq_puf3/notebook_20261030_144328/mailbox_log.txt)、
  [Notebook](../src/pynq_puf3/pynq_puf3_board_test.ipynb)。Notebook `FULL_KAT=True`，
  status `PASS`、exit code `0`；环境为 PYNQ 2.7.0 / Python 3.8.2。
- 三模式均通过 289/289 容量内 KAT，并各拒绝 289/289 个坏 Tag。30 次 firmware
  `mcycle` benchmark（预热 5 次，排除 PS/UART）中位数为 SW enc/dec
  `21862/22562`、HW `1369/1213`、ISE `3895/4288` cycles；相对 SW 的中位数
  加速比为 HW `15.969x/18.600x`、ISE `5.613x/5.262x`。
- FCLK0 由 HWH/SLCR 推算 `99.999999 MHz`，mcycle 独立实测 `99.9971 MHz`；
  PYNQ 2.7 的 `150 MHz` 显示值使用错误的 50 MHz 参考假设，不作为实际频率证据。
- PUF v1 单次上电流程通过：enroll quality `127`，5 次 reconstruct 稳定，caller key
  在 PUF key 下被拒绝，reconstruct 后密文一致，关闭 HWKEY 后标准 KAT 恢复。
  该证据不覆盖跨电源周期、温度/BER/熵/唯一性；项目 KAT 总数为 289 组，
  `timing_signoff_ro_domain=false`，
  不宣称 PUF 稳定性、安全启动或最终 P2 验收。

## 2026-10-30 — pynq_puf3 首次板上功能测试通过（in-session，owner TBD）

- 证据：`data/pynq_puf3/notebook_20261030_131920/result.json`、同目录 `mailbox_log.txt`；Notebook 总状态 `PASS`、exit code `0`。candidate bit/hwh 与 manifest 一致：bit `769ed24c…`、hwh `4a0e7b95…`。
- 时钟与身份：SLCR 推算 FCLK0 `99.999999 MHz`，mcycle 实测 `99.9882 MHz`；PQF3 控制 ID 正确；固件 `pynq-svc-puf3`，启动自检 mask `0x7`，SW/HW/ISE 均为真实硬件路径。
- KAT 与基准：SW/HW/ISE 各通过 6 个代表性 KAT，错误 Tag 各正确拒绝 6 次；KAT #529 预热 5 次、重复 30 次。相对 SW 的中位数加速比为 HW encrypt `15.969x`、decrypt `18.6x`，ISE encrypt `5.613x`、decrypt `5.262x`。
- PUF：enroll quality `127`；5 次 reconstruct 稳定且 helper 一致；HWKEY 打开后 caller key 被拒绝、PUF key 往返成功；reconstruct 后密文一致；HWKEY 关闭后标准 KAT 恢复。
- 边界：这是单次上电会话内的功能通过，不是完整 PUF 验收。benchmark 使用编号 #529
  的测试向量，不代表 KAT 总数；PUF3 已覆盖项目定义的全部 289 个 KAT 用例。
  跨电源周期重建、温度/BER/熵/唯一性仍为 `not_measured`；RO 振荡环计数器域仍未完成时序签核
  （`timing_signoff_ro_domain=false`）。不得据此宣称安全启动完成。

## 2026-10-30 — pynq_puf3 板测 'unexpected PUF frame' 定位与修复（board 待复测，owner TBD）

- 证据 `data/pynq_puf3/notebook_20261030_123118/`（队友 27f24bb）：bit/hwh 哈希一致，FCLK0 寄存器推算 99.999999 MHz（FBDIV 30、分频 10×1，PYNQ 读数 150 按 50 MHz 参考），ID PQF3；失败 `BackendProtocolError('unexpected PUF frame')`，`final_snapshot.tx_bytes=0`、`service=null`、`rx_bytes=296`，`mailbox_log.txt` 恰好截止于 banner "puf: Y01P/"。
- 根因：失败发生在 `hello()`，PS 一个字节都还没发出（tx_bytes=0），也没有收到 Y01S；固件开机 banner 文本 `puf: Y01P/Y01K`（`src/firmware/pynq_svc_puf/main.c`）里的 "Y01K" 被 `Puf3FrameDecoder` 当成 112B Y01K 帧，吞掉其后文本和 Y01S，等待 S 时收到 K → 报错。不是 PLL/时钟、bit/hwh 或固件 PUF 处理问题；KAT/基准/PUF 未执行，不能据此判定功能失败。cosim 未发现是因为 TB 按期望魔数跳过文本；模型测试的 banner 不含 "Y01K"。
- 修复（只改 Notebook 驱动单元，bit/固件不变）：Y01K 只在有未完成 PUF 命令时识别（`expect_k=(cmd,seq)`），且帧头 version/flags/cmd/seq 须与命令一致，否则按文本跳过 1 字节；`puf_command` 设置并在 finally 清除 `expect_k`。清空 Notebook 中上次失败运行的输出（证据保留在 data 目录）。重新打包（bit `769ed24c…`、hwh `4a0e7b95…` 不变，manifest 源哈希更新）。
- 验证：临时离线脚本执行 Notebook 第 2–4 单元，模型 banner 改为与固件一致后，修复前复现同一错误（3/6，`unexpected PUF frame`）；修复后 8/8：含 banner 回放 hello 通过、待命中文本 "Y01K" 被跳过、错 seq 不被接受、完整流程 PASS（推算 100.000/实测 ≈99.99 MHz）、错 PLL 拒绝下载、分频 4×4 与实测 62.5 判失败、HWKEY 未生效判失败。板上复测 NOT_RUN。

## 2026-10-30 — pynq_puf3 FCLK0 修正（板上 93.75 MHz 问题；离线门禁通过，board NOT_RUN，owner TBD）

- 队友板测：`pynq.Clocks.fclk0_mhz` = 93.75，身份检查失败，未产生 KAT/基准/PUF 结果。根因：PYNQ 只按 hwh 写 FCLK0 分频（4×4），IO PLL 沿用启动镜像（33.333333×30 = 1000 MHz，与厂家 base BD FCLK1 142.857=1000/7、FCLK3 200=1000/5 一致），真实 FCLK0 = 62.5 MHz；原版 PYNQ 2.7 `_ClocksZynq.DEFAULT_SRC_CLK_MHZ = 50.0`（v2.7.0 `pynq/ps.py`），所以显示 50×30/16 = 93.75。PYNQ 发布版和 pynq_puf 的 hwh 同为 FBDIV 48、4×4，同样受影响（未改，属其他目录）。
- 修正：`build.tcl` 固定 `PCW_OVERRIDE_BASIC_CLOCK=1`、IOPLL FBDIV 30、FCLK0 10×1（Vivado 读回 ACT 99.999999），门禁目标仍为 100 MHz；固件 Y01K 末 8B 改为发帧时刻 mcycle。队友已在 e92e782/ff7360d 把 PS 驱动与板测合并为单文件 `src/pynq_puf3/pynq_puf3_board_test.ipynb`（删除了 `src/pynq/pynq_puf3.py`、`test_pynq_puf3.py` 与 `board_test.py`）；本次先快进到 ff7360d，再把修正移植进该 Notebook：驱动单元增加 `now_mcycle`/`host_monotonic`、`measure_cpu_clock_mhz`、SLCR 推算 `fclk0_from_registers`、`hwh_ps_clock`；`run_board_test` 下载前核对 IO PLL FBDIV=30（不符则拒绝下载），下载后用 hwh 晶振推算 FCLK0 须为 100±0.5，并用 mcycle 对 PS 单调时钟实测（`CLOCK_INTERVAL_S`=3 s）须为 100±1 %；原版 PYNQ 读数（修正后将显示 150）只记录。
- 验证：固件重编 exit 0；cosim normal 54 步 PASS + autolock 反例检出；修正前在原模块上的模型测试 15/15（含 62.5/93.75 复现、旧 hwh 被新测试判失败）；移植后用临时离线脚本直接执行 Notebook 第 2–4 单元（伪 pynq + SLCR/邮箱/固件模型，未提交）6/6：正常路径 PASS（推算 100.000、实测 99.997、PYNQ 读数 150），IO PLL FBDIV 48 拒绝下载、分频 4×4 判 62.5 失败、实测 62.5 失败、HWKEY 未生效失败；`test_pynq_transport.py` 14/14。Vivado 从头构建 `build.tcl`（impl_1 ExtraTimingOpt+布线后 phys_opt）一次通过：WNS +0.104/WHS +0.041，ro_clk +24.822/+0.115，DRC 0，RO 1280；PL 结果与第一版相同；ro_corner_sta 数值不变（计数器仍未签核）。重新打包：bit `769ed24c…`，hwh FBDIV 30/分频 10×1。会话汇总里 18 条 Critical Warning 是工程解析 `ascon_word.v` 时的 HDL 9-1206（文件类型改为 SystemVerilog 之前）和 methodology 汇总，综合 0 critical、DRC 门禁 0。
- 第一版候选 `56b3bc45…` 作废（板上实际 62.5 MHz）。

## 2026-10-30 — pynq_puf3：三模式 SW/MMIO/ISE + PUF v1 单一 bitstream（离线门禁通过，board NOT_RUN，owner TBD）

- 用户授权方案2。根因：`src/rtl/soc_top.v` 在 `key_valid` 时无条件锁存 `key_hw_sel`，导致 MMIO 改用 PUF 密钥、官方 KAT 失败（这正是 PYNQ release 钉住 `rtl_p0` 的原因）。在独立目录 `board/vivado_zynq7000_xc7z020_pynq_puf3/` 修复，共享 `src/rtl`、release、pynq_puf、JTAG 工程均未改。
- RTL 变体（只在 `board/.../pynq_puf3/rtl/`）：`soc_top.v` 改为 `key_hw_sel = hwkey_on & key_have`；`key_mmio.v` 增加 CTRL[3] HWKEY_ON / CTRL[4] HWKEY_OFF（复位关闭，OFF 优先）以及 STATUS[6] key_hw_sel / STATUS[7] hwkey_on。固件 `src/firmware/pynq_svc_puf/`：复制 pynq_svc main.c，增加 Y01P/Y01K（STATUS/ENROLL/RECONSTRUCT/HWKEY_ON/HWKEY_OFF）；固件 ID `pynq-svc-puf3`；开机自检和 Y01E 前先关 HWKEY；HWKEY_ON 遇到 fallback、mismatch 或未 enroll 时拒绝。PS 驱动已迁移到 `src/pynq_puf3/pynq_puf3.py`（PQF3 身份、Y01K 分帧、`puf_command`），发布版 `pynq_transport.py` 未改。
- 验证（Icarus 14、riscv-none-elf-gcc 15.2.0、Python 3.14、Vivado 2025.2）：
  - `src/firmware/pynq_svc_puf/build.py` exit 0：text 47376 B，custom-0 共 22 条（p12×1、p8×4），`puf_handle_request` 已链接。
  - `sim/pynq_puf3/run.py` exit 0：normal 用例 54 步全部 PASS，覆盖开机/Y01E 自检 mask=7、36 个三模式 KAT、PUF 降级拒绝 HWKEY → enroll → reconstruct → HWKEY 打开后 HW 对官方密文返回 AUTH_FAILED、SW/ISE 不受影响 → HWKEY 关闭后 HW KAT 恢复 → BAD_CMD → 重新握手后 HWKEY 自动关闭。mutant_autolock 用例（原 `src/rtl` 自动锁定）开机 mask=0x05、TB 非零退出，证明是 RTL 改动修复了问题。
  - `src/pynq_puf3/test_pynq_puf3.py` 12/12 PASS（含 board_test 判定逻辑在模型上的正反例）；`test_pynq_transport.py` 回归 14/14 PASS。
  - Vivado：第一次 `build.tcl`（RefinePlacement，未开布线后 phys_opt）WNS −0.123，被门禁拦下、未出 bit。同一网表 4 个策略（均开布线后 phys_opt）：ExtraTimingOpt +0.104/WHS +0.041（选用）、RefinePlacement +0.025、Explore +0.016、NetDelay_low −0.244。违例都在 CPU 前递路径。`finalize_run.tcl impl_2` 结果 DRC 0、无 Netlist 29-160、1280 个 RO LUT 全部分配到 pblock（soft，物理在区域内 440 个）；资源 18674 LUT / 32002 FF / 34.5 BRAM / 4 DSP；HWH ID 0x33465150、地址 0x40000000/0x40001000、FCLK0 100 MHz。`package.py` 复查门禁、cosim、固件哈希、`.mif`=COE 后写出 `candidate/`。
- 按 pynq_puf 提交 5eb64a5 迁移时序签核：`pynq_puf3_timing.xdc` 与该提交逐字节一致，候选实现中已经生效，bit 不变（sha256 56b3bc45…）；迁入 `ro_corner_sta.tcl`（逐字节快照），在 impl_2 post-route dcp 上运行 exit 0；`build.tcl` 改为打开 post-route dcp 后 write_bitstream；`package.py` 增加 ro_sta checkpoint 一致性检查、签核分块与 pblock 说明，重新打包 PASS。三块签核状态：clk_fpga_0 WNS +0.104/WHS +0.041 已签核；ro_clk WNS +24.822/WHS +0.115、ro_clk→clk +3.742/+0.216、clk→ro_clk +6.994/+0.428 已签核；振荡环计数器未签核（Slow 角环周期 3.473 ns/288 MHz，setup −0.478、hold −0.552；Fast 角 1.194 ns/837 MHz，setup −0.598、hold −0.427），需要改 PUF RTL。
- 未完成/边界：板测 NOT_RUN（`src/pynq_puf3/board_test.py` 分四段：身份、KAT、基准、PUF）。三模式加速比必须在本 bit 上重测，不能沿用 release 的 16.2×/5.8×。RO 计数器域未签核（5120 个无时钟引脚、15360 个无约束引脚、256 个组合环、TIMING-17 共 1000 条）。helper 易失、仅证明会话内可重复，DNA/REF 可读，HWKEY 只是固件策略。`build.tcl` 新默认配方未从头重跑。
- 新增 `src/pynq_puf3/pynq_puf3_board_test.ipynb`，用于在 PYNQ Jupyter 中调用同一 `board_test.py` 并保存完整结果；未新增或复制测试逻辑。

## 2026-10-29 21:40 — V03 实板错误/恢复门禁 9/9 PASS

owner TBD。用户在 PYNQ 2.7.0 / Python 3.8.2 上从头执行
`pynq_board_error_gate.ipynb`，结果归档于 `data/pynq/error_gate_20261029_134023/`。
同 release bit/hwh/firmware SHA、`pynq-svc-v1`、`simulated=false`、`selftest_mask=7`。

- 9/9 checks PASS，`reset_count=7` 与预期一致，epoch 从 1 连续推进到 8。
- 17B PT 与 17B AD 均由真实板端返回 `LENGTH`；随后 reset、epoch 变化并通过三模式 KAT。
- 60B 半帧在 0.25s 内无响应；reset 后恢复。
- 完整 96B 请求提交后使用已过期 deadline，触发 `BackendTimeoutError`；reset 后恢复。
- 重复 request_id 首次 `OK`、重复请求 `INTERNAL`；错误 epoch 返回 `INTERNAL`。
- 连续 5 帧不读响应真实触发 RX FIFO overflow；reset 后恢复。
- 每模式连续执行 50 次加密+50 次解密，全部匹配 KAT。cycles 均近似确定：
  SW decrypt median 24,005（max 24,039）、HW decrypt 1,388（max 1,486）、
  ISE decrypt 4,385（max 4,467）。
- 当前 PS/PL ABI 为 AXI-Lite FIFO + RV32 UART uncached MMIO，无共享 cacheable buffer；
  缓存可见性按架构记录为 `NOT_APPLICABLE`，不是跳过失败。
- 已执行 `pynq_board_error_gate.ipynb` 本体也已归档，3 个代码单元均有执行计数和输出。
- 文件 SHA-256 与完整检查表见 `board/vivado_zynq7000_xc7z020_pynq/validation_20261029.md`。
- Y03、Y05、V03 改为 done。下一接收 V04 core freeze regression、B03 实物/频率证据和
  D02 数据表，owner TBD。

## 2026-10-29 — V03 错误/恢复门禁永久入口就绪（板级待运行）

owner TBD。新增 `src/pynq/board_error_gate.py`、`pynq_board_error_gate.ipynb` 和
`test_board_error_gate.py`，用于关闭 V03 尚缺的板级错误/恢复场景。未改 RTL、固件、
bit/hwh、release 或协议语义。

- 覆盖：17B plaintext、17B AD、半帧、真实 transport deadline、重复 request_id、
  错误 epoch、RX FIFO overflow，以及每模式 50 次合法加解密往返。
- 每类故障后执行 SoC reset、确认 epoch 改变，并重跑 SW/HW/ISE 的固定官方 KAT。
- 17B 用例只发送 48-byte header，不压入不可信 body：固件可在读完 header 后返回
  `LENGTH`，随后 reset 清 FIFO；避免测试因固件不再消费 body 而卡在提交阶段。
- Y01 使用 AXI-Lite FIFO + RV32 UART uncached MMIO，没有共享可缓存 buffer，报告中
  将 cache visibility 标为 `NOT_APPLICABLE` 并附架构理由，而不是伪造 shared-BRAM 测试。
- 离线验证：`python -B src/pynq/test_board_error_gate.py` → 6 tests / OK / exit0；
  Python 3.8 AST、Notebook 4 个代码单元解析 PASS；CLI `--help` exit0；
  失败注入确认 JSON 仍写盘且 CLI exit1；`git diff --check` exit0。
- 该时点尚未取得上述场景的真实板级结果，V03/Y05/V04 为 in_progress/todo；
  后续板端结果见本文件上方 21:40 条目。
- 板端反馈首次执行生成的 `.log` 为空。根因是 harness 成功路径只返回 JSON、没有 stdout
  print，而 Notebook 的日志来自 stdout/stderr 重定向。现已在每个 check 输出
  START/PASS/FAIL，并在开头/结尾输出 run 参数、最终状态、check 数与 reset 数；
  离线测试增至 7 项，重新执行板端后 log 不应再为空。

## 2026-10-29 21:09 — PYNQ Notebook 与 30 次 warm benchmark 实板通过

owner TBD。用户在领航者 ZYNQ7020 上从头执行 `pynq_board_demo.ipynb`，并将结果下载到
`data/pynq/notebook_20261029_130920/`。环境为 PYNQ 2.7.0 / Python 3.8.2 /
Linux 5.4.0-xilinx-v2020.2 armv7l；板端 Git commit `ac9143d`，release source commit
`86dc10f`，bit/hwh SHA 与正式发布一致，服务为 `pynq-svc-v1`、`simulated=false`、
`selftest_mask=7`。

- Notebook smoke：SW/HW/ISE 各 6/6 容量内 KAT、6/6 错误 Tag 拒绝，整体 PASS。
- Warm benchmark：固定锁定官方 KAT `#529`（PT=16B、AD=0），每模式预热 5 次后各采集
  30 次加密和 30 次解密；全部 CT/tag/PT 匹配、`simulated=false`、`mcycle>0`。
- `mcycle` scope 为 RV32 固件 AEAD 调用边界，不含 PS/UART。30 次原始 cycles 在各档
  完全一致，非单次外推。中位结果：

| mode | enc cycles | enc cpb | enc speedup | dec cycles | dec cpb | dec speedup |
|---|---:|---:|---:|---:|---:|---:|
| SW | 23,342 | 1,458.875 | 1.000× | 24,005 | 1,500.312 | 1.000× |
| HW | 1,439 | 89.938 | 16.221× | 1,388 | 86.750 | 17.295× |
| ISE | 3,995 | 249.688 | 5.843× | 4,385 | 274.062 | 5.474× |

POST-run 校验独立确认 raw cycles 数组长度均为 30、全部正整数且各档唯一值只有一个；
smoke JSON、benchmark JSON 均在加载后断言 PASS。证据文件 SHA-256 已记录在
`board/vivado_zynq7000_xc7z020_pynq/validation_20261029.md`。

- Y04 改为 done。Y05 的自动 benchmark/JSON 子项通过，但依赖 V03 的超容量、
  半帧超时恢复、重复请求压力和缓存可见性门禁仍未闭环，因此 Y05 保持 in_progress。
- 未验证：已执行 `.ipynb` 本体/截图尚未归档，独立 FCLK 测量、重复上电稳定性和
  完整错误恢复场景仍为 `NOT_RUN/not_measured`。下一接收 V03/V04/D02，owner TBD。

## 2026-10-29 — PYNQ 永久 warm benchmark 与 Notebook 测试入口

owner TBD。实板 smoke 已在当前 release 上再次通过：SW/HW/ISE 各 6/6 KAT、6/6 错误 Tag
拒绝，`release_hashes.log` 六个文件全部 `OK`。用户明确说明坏 Tag 恢复此前已通过，本轮
不再重复。10-29 数据目录仍为未提交证据，保留原样。

- 新增 `src/pynq/board_benchmark.py`：默认固定锁定官方 KAT `#529`（PT=16 bytes、AD=0），
  每模式预热 5 次，再各采集 30 次加密和解密。每次调用均比对 KAT、拒绝模拟标志并检查
  `mcycle > 0`；JSON 保留原始 cycles、PS wall time、min/median/P95/max 和相对 SW 加速比。
  measurement scope 明确为固件 AEAD 调用边界，不包含 PS/UART。
- `board_demo.py` 抽出 `prepare_hardware()`，KAT 与 benchmark 共用 release hash/profile/
  Overlay/ID/boot 握手入口，不修改 RTL、固件、bit/hwh 或地址。
- 更新 `pynq_board_demo.ipynb`：`Restart Kernel and Run All Cells` 依次执行 smoke KAT 和
  warm benchmark，每个结果仅在 PASS 后写入新建的 `data/pynq/notebook_<时间>/`；支持
  `ASCON_REPO`，并使用 `nbconvert` 从头执行路线，不再依赖 `/tmp` Python 脚本。
- 新增 `test_board_benchmark.py`。实际命令与结果：
  `python -B src/pynq/test_board_benchmark.py` → 5 tests / OK / exit 0；
  Python 3.8 AST 解析三个 Python 文件 PASS；
  Notebook JSON 及 4 个代码单元 Python 3.8 AST PASS；
  `python -B src/pynq/board_benchmark.py --help` → exit 0；`git diff --check` → exit 0。
  既有 PYNQ 回归同时复跑 PASS：transport 14/14、mailbox 24/24、navigator 8/8、
  host API 17/17。
- 板端首次尝试 Notebook 时，root Jupyter 的 `Path.home()` 为 `/root`，与终端
  `~` 指向 `/home/xilinx` 不同，路径断言在加载 Overlay 前失败。Notebook 默认路径
  已改为板端绝对路径 `/home/xilinx/jupyter_notebooks/amd_fpga_2026`，仍允许
  `ASCON_REPO` 覆盖；板级 benchmark 尚未执行。
- 未验证：真实 PYNQ Notebook 顺序执行、warm benchmark、PS wall time、完整错误/恢复门禁。
  因此 Y04/Y05 只从 todo 改为 in_progress，不宣称完成。下一接收：在板上执行 Notebook 或
  permanent CLI，并把结果保存在 `data/pynq/notebook_<时间>/`，owner TBD。

## 2026-10-28 23:58 — PYNQ 实板三模式容量内 KAT 通过

owner TBD。正点原子领航者 ZYNQ7020 通过厂家 PYNQ 2.7.0 / Python 3.8.2 启动，网络地址为
`192.168.2.99`；PYNQ overlay 已加载，MMIO ID 检查通过。板端证据已归档至
`data/pynq/board_20261028/`：
`pynq_board_full.json`、`pynq_board_full.log`、`pynq_board_20261028.log`、
`pynq_board_result.json` 和 `identity.txt`。

完整容量内板端测试使用 release bit/hwh/firmware，对应 `identity.txt` 中的
Git `ac9143d5c6acc9e7ac61f907a7e802eb6b35cddd`、bit SHA-256
`6e7f93203519269e1509f4ece1ee76b93c25c8254fe0f8ae9c942314a197d30d`、
hwh SHA-256 `3ebd26408504ed6181a1eac1f31a79ab0e5449c0f0d4d8f76f53fa6332067581`。
服务报告为 `firmware_id=pynq-svc-v1`、`simulated=false`、`selftest_mask=7`、
`max_message_bytes=16`、`max_ad_bytes=16`、`board_validation=PASS`。

实板结果：

| 模式 | 加密 KAT | 错误 Tag 拒绝 | 周期证据 |
|---|---:|---:|---|
| SW | 289/289 | 289/289 | 每次调用前后读取 64-bit `mcycle` |
| HW | 289/289 | 289/289 | 每次调用前后读取 64-bit `mcycle` |
| ISE | 289/289 | 289/289 | 每次调用前后读取 64-bit `mcycle` |

该结果证明真实 PYNQ → AXI-Lite → RV32 服务固件 → SW/HW/ISE → Ascon 输出链路的
289 组项目 KAT 已通过。Host reference 的其他扩展/负向统计若单独保留，必须与项目
KAT 总数分开标注；不能把它们写成额外的板端 KAT。当前证据尚不
覆盖 Notebook 从头执行、长时间连续请求、重复断电上电稳定性、真实 FCLK 独立测量及完整
错误/超时/缓存一致性门禁。PYNQ 实板结果不能替代 baseline FreeRTOS 固件验收或 PUF
跨上电稳定性验收。

## 2026-10-27 23:48 阶段 4 板级通过 — PUF 密钥子系统 enroll + reconstruct 全链路成功

owner TBD。v3 固件（先等 idle 再发 START）烧录后，串口**全部通过**（原始日志已归档：`data/ascon/results/board/uart_20261027_keys3.txt`，
原始字节 `xcom_raw_20261027_keys3.XDat`）：

```
STATUS boot   : 00000001 busy=1 enrolled=0 done=0 quality=0
STATUS idle   : 0000003a busy=0 enrolled=0 done=1 quality=0
STATUS enrol  : 00008026 quality=128
DNA    : 008968143982d0b8
REF    : 58abef60 2834c32c fab29602 8816bf92
MASK   : ffffffff ffffffff ffffffff ffffffff
DITHER : 00000000 00000000 00000000 00000000
RAW    : 58abef60 2834c32c fab29602 8816bf92
STATUS recon: 00008026 quality=128
PASS key subsystem: enroll + reconstruct stable
DONE
```

**状态字解码**：
- `0x0000003A` = ready+mismatch+fallback+done → 上电自动 reconstruct 在无 helper
  （INIT_MASK=0）时**按设计降级**，不是错误。
- `0x00008026` = ready+enrolled+done，`quality=128`；enroll 与 reconstruct 两次读数完全相同，
  `mismatch=0`、`fallback=0` → 重建密钥与注册一致。
- `REF == RAW` → 本次 enroll 的对比结果与回读完全自洽；REF 的 1 个数 59/128 = 46.1%，
  接近理想 50%，**排除"比对器系统性偏一边"**（此前担心的 bias 不成立）。
- `DITHER=0` / `MASK=全 1` / `quality=128`：M=5 个窗口逐位一致，无抖动位。

**能写进材料的结论**（精确口径）：
- 256 路 RO-PUF + 57 位 Device DNA 的密钥子系统在 XC7Z020 实板上完成 enroll → reconstruct
  闭环，quality 128/128，密钥未出现在任何 CPU 可读地址。
- 无 helper 时的降级路径（mismatch+fallback）与设计一致。

**不能写/未验证**：
- **跨上电稳定性未验证**：helper 存在易失寄存器里，掉电即失效，每次上电都重新 enroll，
  所以"同一密钥跨上电可重建"这件事还没测过。需要先把 REF/MASK 持久化（BRAM 保留域或 PS 侧
  Flash/文件）再做多次上电对比。
- 温压/老化稳定性、误码率统计、唯一性（多板互比）均 `not_measured`。
- RO 采样域仍未纳入 STA（`no_clock 10930`），"PUF 时序已签核"不成立。
- `DITHER=0` 只能说明"本次 5 窗口无翻转"，不能外推为"永不翻转"；上次会话的 RAW 第 0 字为
  `58bbef60`（与本次差 1 bit），但那次读数是抢跑残值，不能作为跨会话不稳定的证据。

## 2026-10-27 阶段 4 第二次板上实测 — 硬件握手已修，固件与上电 reconstruct 抢跑（软件已修，待第三次烧录）

owner TBD。烧录 v2（新 RTL + 新固件）后串口日志关键行：

```
STATUS boot   : 00000001 busy=1 enrolled=0 done=0 quality=0
STATUS pre-enr: 00000001 busy=1          ← 上电自动 reconstruct 还在跑
STATUS enrol  : 00000023                 ← busy=1 且 done=1：done 属于 boot 那次操作
FAIL enroll not marked / FAIL quality=0  ← 读到的是"进行中"的残值
REF : 00000000 ...                       ← enroll 还没写完 ref
STATUS pre-rec: 00007f05 busy=1 enrolled=1 quality=127   ← 排队的那次 enroll 真的跑完了
STATUS recon  : 00007f26 busy=0 enrolled=1 done=1 quality=127  ← mismatch=0 fallback=0
FAIL                                     ← 汇总行，来自前面两条误判
```

- **结论 1（硬件）**：握手修复生效。v1 会直接超时；v2 里 `STATUS pre-enr busy=1` 说明 START 被**排队**
  而不是丢弃，随后 enroll 完成（`quality=127`，与首测一致），reconstruct 也完成
  （`0x7f26` = ready+enrolled+done，`mismatch=0`、`fallback=0`）。
- **结论 2（软件）**：固件与上电自动 reconstruct 抢跑。它没等 `busy` 落下就写 CLEAR+START，
  `wait_done()` 抓到的是 boot 那次操作的 done，于是把 enroll 的中途状态当成结果打印，
  连带 REF/MASK/DITHER/RAW 都是半写值。**不是"没匹配上"，mismatch 位自始至终是 0。**
- **固件修改（v3）**：新增 `wait_idle()`（每个操作前等 busy=0，含上电那次）、`start_op()`
  （CLEAR→START 后确认 busy 抬起或已完成，证明本次 START 被受理）、超时放宽到
  `TIMEOUT_LOOPS=800000` / `TIMEOUT_IDLE=400000`、新增 `WARN ref==0 (comparator biased)`
  告警（若 REF 仍全 0 则说明 128 位比对系统性偏一边、熵为零）。text 3019→3470 B。
- **镜像**：`ascon_keys.coe` sha256 `edd66d37…`，blk_mem_gen OOC 重生成，`.mif` 第 4 行核对
  `58818193`（v2 为 `3C818193`）。
- **流程约束（新发现）**：`write_mem_info` 对纯 `blk_mem_gen` 工程报
  `This design does not have any processors or XPM Libraries`，因此**不能**用 `updatemem`
  只换 BRAM 内容；改固件必须重跑 synth→impl→bitstream。已实测确认，不再尝试。
- **未验证**：v3 固件的板上行为（待第 3 次烧录）；REF 是否真的有熵，要等 v3 在 idle 之后读才有可能判断。

## 2026-10-27 阶段 4 修正 — 板上 reconstruct 超时的握手加固（仿真已验，板级待复测）

owner TBD。现象：板上 `ascon_keys` 首次烧录，enroll 成功（quality=127/128、DNA 可读、REF==RAW、
MASK 只屏蔽 2 位且与 DITHER 对应），但紧接着 `CTRL=0x4`→`CTRL=0x1` 的 **reconstruct 永远等不到 done**，
`FAIL reconstruct timeout`；按 PL RESET 重跑结果完全相同（确定性）。

- **定位到的两个脆弱点**（仿真 6 次连续操作不复现，属硬件才暴露的一类）：
  1. `key_mmio` 在 `key_busy=1` 时写 START 会**静默丢弃**（`if (wdata[0] && !key_busy)`），
     上层无从得知，只能超时；
  2. `ro_puf_core` 的 ro_clk 域 FSM 没有任何超时兜底：一旦卡在中间态（跨域计数在真实器件上
     可能因异步计数/亚稳态停滞），`done_tgl` 永不翻转，整条链路挂死。
- **修改（3 处）**：
  - `src/rtl/keys/ro_puf_core.v`：`req_event` 改为**权威重启**（任何状态收到请求都从起振重来）；
    新增 24-bit 采样看门狗 `WD_RO = M*(WINDOW+2*DWELL+8)+32*DWELL`，超时强制收尾并翻转 `done_tgl`。
  - `src/rtl/keys/key_mmio.v`：START 改为**排队**（忙时置 `start_pend`，空闲补发；模式在请求时刻快照；
    CLEAR 取消排队；ENROLL/RECONSTRUCT 模式不再被 CLEAR 覆盖）。
  - `src/firmware/keys_rv32/main.c`：每次操作前后打印 STATUS（含 busy/enrolled/done/quality），
    reconstruct 超时后 **重试一次**，并在 CLEAR→START 之间加空拍。text 2474→3019 B。
- **验证（仿真，全部实跑 PASS）**：`tb_puf_key`（原回归）、`tb_key_mmio`（原回归）、
  新增 `tb_puf_key_reuse`（单实例 6 次连续 op：boot-recon → enroll → recon ×4 全部 done）、
  新增 `tb_ro_reuse`（5 次正常 + 忙中请求合并 + 背靠背合并 + **force 卡死窗口验证看门狗出 valid**）。
  工程侧 `synth_design -rtl` **elaboration PASS**（49 个源文件）。
- **镜像**：`ascon_keys.coe` 重新生成为 sha256 `77c11ab0…`（与旧版差 **724 个字**），
  blk_mem_gen OOC 重生成后 `.mif` 第 4 行已核对匹配（`3C818193`，旧版 `1A818193`）。
- **未验证**：板上行为（需第 4 次烧录）；若下次仍超时，新固件会打印 `STATUS at rec`：
  **busy=1 → 卡在内部（查 DNA/KDF）；busy=0 → START 仍被吞（查 key_mmio）**，可直接定位。

## 2026-10-27 阶段 4 — PUF/密钥子系统纳入上板工程（RTL 已集成，板级待跑）

owner TBD。本轮改 `src/rtl`（两处集成补丁）+ 工程配置 + 新固件/COE；未 commit 前已验证 elaboration 与 IP 重生成。

- **RTL 集成**：对 f88e178 的 `src/rtl` 应用两个补丁（`git apply` 均干净）——
  `ascon/ascon_mmio.v` 加 `key_hw/key_hw_sel`（锁定后 CPU 写 KEY0..3 被丢弃；`run_key` 取硬件密钥）；
  `soc_top.v` 实例化 `puf_key`(u_puf_key) / `key_mmio`(u_key_mmio)，`ro_clk = clk/4` 过 BUFG，
  复位后等 `0xFFFF` 拍自动尝试一次 reconstruct，`key_valid_p` 到来即锁定 `key_hw_sel`。
  集成后源集哈希：`src/rtl/*.v`(31) **2a83bec0…**（原 `a323df37…`，只有 soc_top 变）、
  `src/rtl/keys/*.v`(5) **be9507ef…**、`src/rtl/ascon/*.v`(9) **96fe170d…**。
  ⚠ 三份已签核 bitstream 对应的是 **PUF 之前**的源集，不能从现在的工作区重现同一字节；其哈希已冻结在
  `docs/freeze_checkpoint_20261027.md`。
- **固件**：`src/firmware/keys_rv32` 构建成功（text 2474 B / 620 words）→ `ascon_keys.coe`
  sha256 `bebed9437961d774…`；`.mif` 第 3 字指纹 **1197**（sw=A197、ise=2197+1E018193、hw=2197+81018193、keys=1197）。
- **工程**：`riscv_vivado_project` 加入 5 个 keys 源（源文件 43→49）、`build/keys_ro_pblock.xdc`（约束 1→2）、
  `Coe_File = ascon_keys.coe`、`impl_1` 的 `STEPS.OPT_DESIGN.TCL.PRE = build/keys_ro_allow_loops.tcl`（RO 环豁免）、
  `include_dirs` 增加 `src/rtl/keys`；`synth_design -rtl` **elaboration PASS**；
  blk_mem_gen OOC 重生成完成（mif 19:17:42、dcp 19:19:27、`__synthesis_is_complete__`）。
- **预期指标**（依据同 RTL+补丁的 `build/reports/keys_sta_20261025_mmio2`）：WNS **+0.023 ns**、TNS 0、
  0 失败端点、WHS +0.022、LUT **17123**、FF **28498**、BRAM 34.5、DRC **0 条 LUTLP-1**（钩子生效）、布线 0 错；
  最差路径仍在 CPU（`mem_wb → if_stage/pc CE`），不在密钥子系统内。
- **串口预期**：`=== KEY SUBSYSTEM SELF-TEST ===` → `STATUS boot/enrol（含 quality）` → `DNA` →
  `REF/MASK/DITHER/RAW` 各 4 字 → `STATUS recon` → 通过时 `PASS key subsystem: enroll + reconstruct stable` + `DONE`。
  已知失败条件：`FAIL enroll timeout` / `FAIL quality=0`（RO 未工作）/ `FAIL puf mismatch` / `FAIL dna-only fallback`。
- **未验证**：板上任何一项（用户将烧第 4 个 bitstream）；DNA 位序（`SHIFT_SKIP`）需与 Vivado 读到的 Device DNA 比对；
  enroll 得到的 REF/MASK 需回填 `KEY_INIT_REF/KEY_INIT_MASK` 才能免去每次上电 enroll；P02 稳定性/纠错未测；
  本阶段 bitstream **不替代**已冻结的三套（P0 演示仍用 sw/ise/hw）。

## 2026-10-26 — 首次上板：软件版 Ascon 板级 KAT 6/6 PASS（100 MHz，WNS +0.087 ns）

owner TBD；本轮由用户在 Vivado GUI 手工建工程/综合/实现/烧录，我在旁核验报告与日志。未改 RTL/XDC。

- **工程**：`board/vivado_zynq7000_xc7z020_ascon/first_time/`（手工新建，非 baseline 副本；XPR=`first_time.xpr`，
  srcs=`riscv_vivado_project.srcs`）。Vivado 2025.2，part `xc7z020clg400-1`，top `top_pl_bram`。
- **源**：`f88e178` 的 `src/rtl/*.v`(31) + `src/rtl/ascon/*.v`(8，排除 `*_tb.v`)，**不含 keys/PUF**；
  旧 baseline `imports/rtl` 快照已重命名为 `rtl_baseline_snapshot_do_not_add`、未入工程。
- **约束**：baseline `const.xdc` 原样（U18 50 MHz、N16 复位低有效、T19/J15 USB-UART、H15/L15 LED、L14/K16 KEY）。
- **IP**：`clk_wiz_0`(PLL 50→100 MHz, RESET_TYPE=ACTIVE_HIGH)、`axi_bram_ctrl_0`(AXI4/32b/32768)、
  `blk_mem_gen_0`(32×32768, byte write, COE=`ascon_sw.coe` sha256 `3dcd59a0…`)。
- **综合**（Vivado Synthesis Defaults）：LUT 12214 / FF 15945 / RAMB18 5（BRAM 为 OOC 黑盒）/ DSP 4，
  **CRITICAL WARNING 0**（195 warning 为历史噪音）。报告：`first_time.runs/synth_1/top_pl_bram_utilization_synth.rpt`。
- **实现**（`Performance_ExploreWithRemap`）：**WNS +0.087 / TNS 0 / 失败端点 0 / WHS +0.021**，
  布线 24610/24610 全通、0 routing error，DRC 0 Error/0 Critical（仅 1 条 RTSTAT-10 提示）；
  placed LUT 12426 / FF 16156 / RAMB36 32 + RAMB18 5 = 34.5 / DSP 4。
  最差路径 `u_ascon_mmio/…/FSM_sequential_state_reg[3]/C → p12_in_reg[215]/D`，与 10-24 签核同一条。
- **bitstream**：4,045,687 B，sha256 `f4233827e3005e115bb30e31e64a75a4487f9dfdd9efe2946d9c924b8ffb5c2e`
  （已存档 `build/local/board_bitstream/top_pl_bram_sw.bit`，生成物不入 git）。
- **板级链路**：ATK-U18 下载器（FT232H，需装 Vivado 自带 cable driver）+ CH340 **COM7**，
  115200 8N1 无流控，底板 P5 短接 **3–5 / 4–6**（PL 串口），JTAG 下载（非 QSPI）。
- **板级结果（ascon_sw）**：banner → **KAT 6/6 PASS**（empty/1B/16B/16B+AD/17B/32B）+ **tamper reject PASS**
  → warm benchmark：enc16B **20806 cyc**/4495 inst/CPI 4.62、enc32B 25787/5600/4.59、
  dec16B 21360/4722/4.51、dec32B 26444/5857/4.51 → `===DONE===`。
- **与 2026-10-15 仿真基线的差异（+23.5% cycles、+7.6% inst、+14.6% CPI）暂不归因**：
  ①今天用 xpack GCC 15.2.0，10-15 仿真用 WSL GCC 13.2（text 39124 vs 38852 B 印证二进制不同）；
  ②10-15 之后 RTL 落了 B(dcache store buffer)/C(mult 寄存器化)/D(中断判决拆拍)；
  ③仿真是 `sim/ascon` 的简化 AXI BRAM 模型，板上是真 `axi_bram_ctrl`。
  已用同 RTL + 同编译器重跑 sw 仿真做对照（证据目录 `build/local/verify_teammate/build/local/board_cmp`）。
- **对照结论（同 RTL f88e178 + 同编译器 xpack GCC 15.2.0）**：仿真 enc16B **17353 cyc / 4493 inst / CPI 3.86**、
  enc32B 21515/5604/3.83、dec16B 17847/4730/3.77、dec32B 22094/5865/3.76，KAT 6/6 PASS。
  **指令数与板上逐项一致（4495 vs 4493、5600 vs 5604、4722 vs 4730、5857 vs 5865，差 ≤8 条）**，
  → 之前的 +7.6% inst 差额确认为**编译器版本差异**（GCC 13.2 → 15.2），不是算法或固件差异。
  剩余 **cycles 一致地高 +19.7~19.9%，折算 CPI +0.76/指令**（3.86→4.62），四个操作同比例
  → 归因为**存储子系统延迟**：板上走真实 `axi_bram_ctrl_0`，仿真是 `sim/ascon` 的简化 AXI BRAM 模型；
  具体到 icache/dcache miss/refill 的拍数差，需加 miss 计数器才能定量（V01 细化项）。
  因此：C04/I07 里记录的 16840 / 21018 / 17226 / 21461 是**仿真值**，板上实测比之高约 20%，
  报告必须分列，不能混用；板上三套之间的加速比仍以板上同条件测量为准。
- **ISE 版板上结果（第二轮，23:21）**：COE 换 `ascon_ise.coe`（sha256 `7ef0b829…`），OOC 重生成后
  `.mif` 第 3 字由 `A197` 变 `2197`（确认镜像切换，见 23:03:36 时间戳）；实现仍
  **WNS +0.087 / TNS 0 / 0 失败端点 / WHS +0.021**、24610/24610 全布通、DRC 0 Error，
  资源 FF 15945 / LUT 11266 与 sw 版**逐位相同** → 换 COE 未动逻辑。
  bitstream `f85eb1a63284059f5dbc785aa791d81c9a6f558a27843c2767d2414909144392`（4,045,687 B，
  与 sw 版差 31,505 字节）。
  串口：KAT empty/1B/16B/16B+AD + **dec round PASS** + **tamper PASS**，
  **warm 16B 加密 ISE cycles = 2570**（= 160.6 cpb）。
  → **板级加速比 20806 / 2570 = 8.10×**（同板同条件，20806 为第一轮软件版实测）。
  2570 与 `docs/cpu_pipeline_flow.md` 记的 ISE 2559 拍同量级；10-15 仿真的 1880 是旧 RTL/旧编译器口径，不可直接与板上相减。
- **ISE 版仿真对照（同 RTL f88e178 + 同编译器 15.2.0）**：仿真 **2496 cyc**（KAT 6/6 PASS），板级 **2570**，
  **仅差 +3.0%（+74 拍）**。与软件版对照（17353 → 20806，**+19.9%**）相比差异极大。
  → 说明板上那部分额外开销**与访存密度成正比**：ISE 把置换搬进硬件后指令数/访存大幅减少，
  对存储延迟不敏感；这也解释了为什么 **板上加速比 8.10× 反而高于同编译器仿真比 6.95×**
  （17353/2496）——软件版被存储延迟拖得更多。报告里应写这个解释，而不是把两者混为一谈。
- **同 RTL/同编译器口径汇总**：仿真 sw 17353 → ise 2496（6.95×）；板上 sw 20806 → ise 2570（**8.10×**）。
- **MMIO 版板上结果（第三轮，2026-10-27 18:56）**：COE 换 `ascon_hw.coe`（sha256 `3e464c48…`）；IP 重生成后
  `.mif` 第 3 字 `2197` + **第 4 字 `81018193`**（hw 独有指纹，ise 版是 `1E018193` —— **只看第 3 字会与 ise 混淆**，
  本轮新增的判据）。实现仍 **WNS +0.087 / TNS 0 / 0 失败端点 / WHS +0.021**、24610/24610 全布通、
  DRC 0 Error；placed LUT 12426 / FF 16156 / RAMB36 32；bitstream
  `2f6f24692533941f902deb812cd7a61192a722b20d3f8536e466e46e4579c544`（与另两份互不相同）。
  串口：KAT empty/1B/16B/16B+AD + dec roundtrip + tamper reject + **len reject**（16B 上限）全 PASS；
  **crypto latency 103 cyc / full MMIO 688 cyc**。
  同 RTL 同编译器仿真为 99 / 670 → 板上 **+4.0% / +2.7%**，与 ISE 的 +3.0% 同一量级（都是访存少的版本），
  再次印证「板上额外开销 ∝ 访存密度」。
- **板上三套齐全（warm 16B 加密，同板同 100 MHz）**：
  软件 **20806 cyc（1.0×）** → **MMIO 688 cyc 端到端（30.2×；裸 crypto 103 cyc ≈ 202×）** →
  ISE **2570 cyc（8.10×）**。三份 bitstream sha256：sw `f4233827…` / ise `f85eb1a6…` / hw `2f6f2469…`
  （均存于 `build/local/board_bitstream/`，不入 git）。
  日志注意：本版串口开头有约 2 行乱码（开串口瞬间的帧错），banner 之后全部干净，不影响判据，原始日志按原样保留。
- **未做**：三套统一脚本化的板上 benchmark（当前是各固件自打印）、IO delay 约束、PS/PYNQ、PS 端到端、
  ISA 回归板上抽样。

## 2026-10-26 — 独立核验：队友 preboard 提交 / PUF 子系统 / 余量口径纠正（+0.087 而非 +0.039）

owner TBD；只读核验 + 文档改正，未改 RTL、未 commit/push。核验环境：Vivado 未启动；
Icarus 14.0 (devel)、riscv-none-elf-gcc 15.2.0、Python 3.14；队友代码用 `git archive origin/main`
导出到 `build/local/verify_teammate/` 后独立跑，不动本工作区。

- **余量口径定为 +0.087 ns。** `+0.039` 是 `run_prod_arm.tcl mode=hook`（生产策略 + 强制复制钩子）
  实验臂的数字，2026-10-25 01:10 的结论原文即「复制步骤**不进流程**，当前 100 MHz 最好成绩 =
  生产策略 + C + D = **+0.087 ns**」。无钩子生产流程已有 6 个臂逐位相同：`prod_ctl`、`pr_ctl`、
  `pr_ctl2`、`pr_mfonly`、`pr_selprops`、`pr_physopt_only`（另有 `r2_ctl`/`r2_popt`）。
  故：无密钥子系统 **+0.087**；PUF 集成 +0.051（RO 压成 1 LUT）/ +0.058（256×5 原语 RO）；
  PUF + key_mmio **+0.023**（`build/reports/keys_sta_20261025_mmio2/`，10-26 14:01）。
  本文件 2026-10-25 板卡段落的「按 +0.039 ns 记」与 `docs/key_subsystem.md` §5 的
  「不含密钥子系统 +0.039」两处已就地改正。
- **队友提交**：`origin/main = 4268b1f`（68fafc8 Navigator 交接 20 文件；4268b1f D-Cache TB 修订 +
  中断验证 + 公共记录）。本地 main 落后 2 个 commit；`git merge-tree --write-tree HEAD origin/main`
  试合并无冲突（本工作区 keys/PUF 为未跟踪新文件，不与之相交）。
- **独立复现（全部真跑）**：
  - `run_tests.py --mode smoke`：**6 PASS / 0 FAIL / 0 BLOCKED / 9 NOT_RUN，exit 0**。
  - `run_targeted_validation.py --mode interrupt`：6 个 RV32 场景 PASS，3 个负向门禁
    （NO_TIMER / BROKEN_MRET / 临时副本绕过 guard）均按预期 exit 1，overall PASS。
  - `--mode dcache` 全量：26 条命令结果与队友声明一致（legacy 臂按设计 exit 1；修订 TB、
    独立契约 TB、4 种子 trace 均 PASS）。本次在我机器上因 `pre_store_buffer_trace_1234567.txt`
    未落盘而整体判 FAIL；单独重跑该命令可正常产出 1.47 MB 文件 → 判为脚本未检查 `$fopen`
    返回值的偶发缺陷（建议加固），不影响 TB 结论。
  - **COE**：`build_firmware.py` 出 sw/hw/ise 三套；其中 ise / sw 的 `.coe` 与我按 hex 独立生成的
    `.coe` **逐字节相同**（sha256 `7ef0b829…` / `3dcd59a0…`，各 32770 行）。
- **「D-Cache 修好」的准确表述是 TB_STALE，不是 RTL 修复**：4268b1f 不含任何 `src/rtl` 变更；
  旧 TB 的 4 项 FAIL 源于 MISS_CAPTURE 拆拍后固定拍数假设过期，修订 TB 与独立 scoreboard 在
  改前/改后两版 RTL 上均 PASS，原 FAIL/exit1 证据保留。
- **PUF 侧**（仍为未跟踪工作区文件，未进任何分支）：`src/rtl/keys/` 5 模块、`sim/keys/` 6 TB、
  `docs/key_subsystem.md`、2 个集成补丁、`build/keys_ro_pblock.xdc`、`build/build_keys_sta.tcl`。
  复跑 `bash sim/keys/run_key_tests.sh`：**tb_puf_key PASS、tb_key_mmio PASS**（REF/MASK 可回读、
  reconstruct 一致、CLEAR 生效、窗口不暴露 key）。`git apply --check` 两个补丁在 f88e178 上干净。
  缺口不变：DNA 位序需上板对齐、enroll 结果需经 MMIO/ILA 搬出、P02 稳定性未测、未上板未集成。
- **未验证**：完整 regression（在跑）、板级任何一项、PS7/PYNQ 链路、ASCON 独立工程的 STA/DRC。

## 2026-10-25 — 扇出复制第二轮 12 臂：`sel_*` 一根都拆不出来；+0.184 定性为「布线解换盆」

owner TBD；未改 `src/rtl`、`board/`、XDC（全部变体是 `build/local/tests_20261025/` 下的副本），未 commit/push。
工具 Vivado 2025.2，part `xc7z020clg400-1`，top `top_pl_bram`，策略 `Performance_ExploreWithRemap`，核心 10 ns。

- **页面 R1 提的那个实验做完了：单根/双根定点复制也拆不出来。** 12 个臂（单根 / 2 根 / 4 根 /
  属性写网 / 属性写单元 / `MAX_FANOUT`=16 与 128 / 加 `AggressiveExplore` / 不写属性）**一律副本 51 → 51、
  FF 17187 → 17187**，日志一律 `Identified N candidate nets` + `Optimized 0 net. Created 0 new instance.`
  → `-force_replication_on_nets` 只是把网塞进候选清单，是否实例化由 Phase 2 判据决定，判据一致拒绝。
  对照：同一位置对 `u_crypto_aead/state[3]`（fo=628）则真的把扇出从 628 降到 25。
- **上一轮的 +0.184 与复制无关，是"定向扰动布线解"**（8 次逐位相同：R1 的 2 次 + 本轮 6 次）。
  机制用排除法钉死：两臂 **post-place 检查点 32579 个原语的 `NAME→LOC` 逐行 diff 为空**，
  布线后只有 **35 个单元**不同，净表（副本/FF/LUT）完全相同 → 收益只能来自布线解。
- **四味消融**：属性不是必需（`r2_noprop` 不写任何属性仍 +0.184）；**选点必需**
  （`r2_tiny` 点一根 fo=3 的无关小网 → +0.073，比对照还差）；连调两次不叠加（`r2_x2` 仍 +0.184）；
  **临时过约束逼 phys_opt 干活没用**（`r2_tight`：核心 9 ns 跑 AggressiveExplore，phys_opt 确实动手
  —— Fanout 相位 TNS +57.529、新增 13 单元 —— 但恢复 10 ns 后只有 **+0.057**，且 LUT +87 / FF +48）。
- **新墙换人了**：+0.184 网表的最差是 `sel_ex_mem_rs1_o_reg → if_id/pred_target_o_reg[12]/D`，
  13 级 / logic 3.520 / net 5.808，其中 **8 级是 `u_mem_wb/captured_addr_reg[*]_i_1/CO` 的 32 位增量链**
  （X57Y33→Y39 竖向，每级 0.114 ns），末端 `dcache_cpu_addr[29]` 一根网 0.988 ns；
  `sel_*` 自己的 171 扇出网只占 0.955 ns。
- **`-force_replication_on_nets` 不能用在 post-route**（preflight 实测：
  `ERROR: [Vivado_Tcl 4-265] ... not supported yet for post-route physical synthesis`），
  只能在 `PHYS_OPT_DESIGN.TCL.POST` 用。

验证命令（全部真跑，退出码 0）：
```bash
bash build/timing_tests/run_batchR2.sh      # 8 臂，14:17→14:40
bash build/timing_tests/run_batchR2C.sh     # 4 臂（r2_tight 重跑一次，见下）
python build/timing_tests/collect_r2.py     # 汇总
```
证据：`build/reports/tests_20261025/<tag>/result.txt`、`build/local/tests_20261025/logs/<tag>.log`、
`build/reports/tests_20261025/_place_cmp/*.txt`（32579 行 LOC 快照）、
`build/timing_tests/logs/preflight.log`；分析写进 `docs/timing_route_replication_r2.md`。

**返工记录**：r2_tight 第一版用 `set_property PERIOD` 改时钟 → `ERROR: [Common 17-107] Cannot change
read-only property 'PERIOD'`，臂在 phys_opt 前就退出（14:47），改成重新 `create_clock` 后重跑成功（15:31）。
另有一次 `run_batchR2.sh` 起跑后才发现钩子被拷进 run 目录会断掉 `r2_lib.tcl` 的相对 source，
杀掉重落后才正式跑（14:17 那次）。

**未验证**：+0.184 的机制只有排除法证据（没有布线器 criticality 的直证）；换 RTL 后是否仍成立（`r2_tiny`
已证明不是"必然变好"）；`docs/freeze_checkpoint_20261018.md` §2 全套功能回归未跑；8 级 CARRY4 增量链的
RTL 改法未做。**下一接收任务**：`sel_*` 复制到此结案，转 13 级路径的进位链结构性改法（owner TBD）。

## 2026-10-25 — 板卡确认（正点原子领航者 ZYNQ7020）；密钥子系统 RTL 落地并仿真通过

owner TBD；HEAD `f88e178`。未改 `src/rtl` 既有文件（新增 `src/rtl/keys/` 与两个补丁），
未综合、未上板，未 commit/push。

- **板卡身份确认**（资料盘 `3_开发板原理图和硬件相关文件/NAVIGATOR_ZYNQ_IO.xdc`）：
  正点原子 领航者 ZYNQ7020，`sys_clk`=**U18 50 MHz**、`sys_rst_n`=**N16 低有效**、
  USB-UART=**T19/J15**、`led[1:0]`=**H15/L15**、`key[1:0]`=**L14/K16**，与仓库 `const.xdc`
  **逐引脚一致**，`RESET_ACTIVE_LOW=1` 默认匹配 → 引脚不用改，50 MHz + MMCM ×2 = 100 MHz
  与 STA 前提一致，B03 的“板型未知”风险解除。资料盘另有《领航者 ZYNQ 之 PYNQ 开发指南 V3.2》
  → P1 的 PYNQ 路线可行。
- **时序现状**：`805b01a` 的 +0.039 是「生产策略 + 强制复制钩子」实验臂的数字（复制已否决、不进流程）；
  生产流程（无钩子）按 **+0.087 ns** 记（6 个无钩子臂逐位相同，见 2026-10-26 核验条目）；
  最差路径已变成 `u_crypto_aead FSM → p12_in`（1 级逻辑、9.29 ns 走线）。
- **密钥子系统**（用户决策：PUF+DNA 组合 / 内部直连 CPU 不可读 / 多数表决+片内 helper / 100 MHz）：
  新增 `src/rtl/keys/{device_dna,ro_unit,ro_puf_core,puf_key}.v`、
  `sim/keys/{tb_puf_key,tb_dna_min,DNA_PORT_sim}.v`、`sim/keys/run_puf_key.sh`。
  仿真 5 项全 PASS：DNA 读出正确、enroll/reconstruct key 一致、无 helper 正确降级、
  DNA-only 确定性、helper 被破坏时 fallback key == DNA-only key。
- **集成补丁**（`git apply --check` 均通过）：`key_subsystem_ascon_mmio_hwkey.patch`
  （加 `key_hw/key_hw_sel`，锁定后 CPU 写 KEY 被丢弃）、`key_subsystem_soc_top_inst.patch`
  （上电自动生成一次、key 就绪即锁定）。patched 源 + keys 全 SoC **elaborate 干净**。
- **风险/未完成**：① DNA 位序需上板与 Vivado Device DNA 比对一次（`SHIFT_SKIP`）；
  ② enroll 的 ref/mask 目前只能靠 ILA 读出（缺 MMIO 状态口）；
  ③ 约 +1.8k LUT / +6k FF，在 +0.039 ns 余量下必然要重跑 STA（RO 独立 pblock 或慢时钟域），
  否则演示走 80 MHz。
- 文档：[key_subsystem](../docs/key_subsystem.md)。
- 顺带修正 draft 的两个真实缺陷：`device_dna` 在 IDLE 每拍清零 `dna`（上层取不到值）、
  SHIFT 相位未对齐（加 `SHIFT_SKIP` 参数）；`puf_key` 里 `ref` 是 SystemVerilog 保留字，
  改名 `h_ref`。
- **追加（14:40–15:30）①RO 独立 pblock + 慢时钟域，③100 MHz 实测**：重写 `ro_puf_core`
  为「RO 自身当时钟计数 + ro_clk(25 MHz = clk/4, BUFG) 控制域 + req/done 翻转握手」；
  新增 `build/keys_ro_pblock.xdc`（pb_ro_puf，X60Y115:X113Y149）与 `build/build_keys_sta.tcl`。
  集成 STA（生产策略，`build/reports/keys_sta_20261025/`）：
  **WNS +0.051 / TNS 0 / 0 失败端点 / WHS +0.035**，LUT 13924(+446)、FF 22088(+4901)、
  BRAM 34.5(−4)；最差路径仍是 CPU 的 `id_ex→dcache/captured_wdata`，**不在密钥子系统中**。
  落点核查：u_puf 下 7275 个叶子单元 **全部**落在 pb_ro_puf（X56..113 / Y102..149），
  CPU 被压到 X27..96 / Y0..92，两者物理不相交。
- 顺带记录一个**真实设计缺陷**（草稿 `../IO/ro_puf_top.v` 同样存在）：用系统时钟去数 RO 上升沿
  在硬件上测不出频率（RO 150~300 MHz 快于采样时钟，直接混叠），已改为 RO 驱动计数器时钟、
  窗口结束停计数后取静态快照。另有 `device_dna` 在 IDLE 每拍清零 `dna`（上层取不到值）与
  SHIFT 相位未对齐（新增 `SHIFT_SKIP`）；`puf_key` 里 `ref` 是 SV 保留字，改名 `h_ref`。
- **追加（15:30–15:50）RO 原语化 + 复测**：DRC 发现第一版用 `assign` 链搭的 5 级环被综合
  压成 **1 个 LUT**（`1 LUT cells form a combinatorial loop`），`STAGES` 参数失效、部分 RO 被吞。
  改为显式 `LUT2(NAND, INIT=0010)` + 4×`LUT1(INV, INIT=01)`，每级 DONT_TOUCH；
  复测（`build/reports/keys_sta_20261025_r2/`）：**WNS +0.058 / TNS 0 / 0 失败 / WHS +0.020**，
  LUT 14802(+1324)、FF 22094(+4907)。DRC 变为 `5 LUT cells form a combinatorial loop`，
  报告覆盖 `g_ro[0..255]` 共 **256 根**（stdout 只打印 101 条是打印上限）。
  最差路径仍是 CPU `id_ex → dcache`，密钥子系统不在关键路径上。
- **追加（15:50–16:00）复现 + RO 结构定量核实**：第三次独立 run（`keys_sta_20261025_clean/`）
  WNS 仍为 **+0.058 / 0 / 0**，与 r2 逐位一致 → 结果可复现。
  钩子脚本 `build/keys_ro_allow_loops.tcl` 修正后实测 **ro_lut_cells=1280、nets_tagged=1280**
  （= 256 RO × 5 LUT），定量证明每根 RO 都是 5 级环、无合并。
  两个踩坑点：ALLOW_COMBINATORIAL_LOOPS 不能写在 XDC（综合前 net 不存在）；
  也不能用层次名过滤（综合后 `u_puf` 被打平，必须按引脚找 net）。
  已归档的 clean run 用的是旧钩子，所以 DRC 报告里仍有 256 条 LUTLP-1（预期、可容忍），
  下一次 build 会带上新钩子。
- **追加（16:00–16:20）key_mmio 落地**：新增 `src/rtl/keys/key_mmio.v`（挂在 Ascon 窗口 0x80 段，
  `ascon_addr_sel` 32..52，共 21 个字：STATUS/CTRL/DNA_LO/DNA_HI/QUALITY/REF×4/MASK×4/DITHER×4/RAW×4），
  `puf_key` 增加 `helper_ref_o/helper_mask_o` 输出；`soc_top` 用 `ascon_rdata = ascon_rdata_core | key_rdata`
  合并（不改共享的 `bus_interconnect.v`）。**窗口不暴露 key**。
  新增 `sim/keys/tb_key_mmio.v` 与 `sim/keys/run_key_tests.sh`，两套测试均 PASS：
  `tb_puf_key PASS`、`tb_key_mmio PASS`（窗口外读 0 / enroll→ready·enrolled·done·quality=89 /
  DNA_LO·HI 正确 / REF·MASK 回读一致且可用位非空 / reconstruct key 与 enroll 一致 / CLEAR 生效）。
- **钩子生效**：`RO_ALLOW_LOOPS: ro_lut_cells=1280 nets_tagged=1280`，DRC 里 **LUTLP-1 归零**
  （之前 256 条）。
- **key_mmio 集成 STA 已完成**（`keys_sta_mmio2`，生产策略）：
  **WNS +0.023 / TNS 0 / 0 失败端点 / WHS +0.022 / 布线错误 0**；
  LUT 17123(+3645)、FF 28498(+11311)、BRAM 34.5；最差路径是 CPU `mem_wb → pc CE`，不在密钥子系统里。
  DRC LUTLP-1 **归零**（钩子 `ro_lut_cells=1280 nets_tagged=1280` 生效）。
  代价：相比不含 key_mmio 的 +0.058，加了 21 字 MMIO 窗口后 WNS −0.035 ns；如余量吃紧可砍
  DITHER/RAW 回读或把 N_RO 降到 128。
  首轮 `keys_sta_mmio` 在布线中途进程消失（无 ERROR 行、无 result.txt），已用新 tag 重跑并完成。
- **新增自检固件 `src/firmware/keys_rv32/`**（main.c + 复用 crt0/uart/libc/ld，620 words）：
  enroll → 打印 STATUS/DNA/REF/MASK/DITHER/RAW → reconstruct → 判定 PASS。
  `bash src/firmware/keys_rv32/build.sh` 编译通过（text 2474 B）。
  新增 SoC 级 TB `sim/keys/tb_keys_fw.v` + `sim/keys/run_keys_fw.sh`（KEY_WINDOW=256 提速，
  `KEY_SIM_DNA` 注入 DNA），跑真固件结果：
  `===DONE[RESULT] tb_keys_fw PASS (framing_err=0)`，输出 STATUS boot=0000003a、
  enrol=00008026(quality=128)、DNA=000123456789abcd、recon=00008026、REF/RAW=75df75df 循环。
- **两处 RTL 修正（仿真暴露的真问题）**：
  1. `key_mmio` 的 mismatch/fallback 原为粘滞位，CLEAR 后会被 puf_key 的旧电平立刻重新置位
     → 改为**实时透传**（puf_key 每次 start 自清），只有 ready/done 仍粘滞。
     修正后 enroll 的 STATUS 从 `0000803e`（mism|fb 误置）变成 `00008026`。
  2. `soc_top` 增加参数 `KEY_SIM_DNA`（默认 0，仅仿真注入；硬件走 DNA_PORT 原语），
     否则 SoC 级仿真里 DNA 恒为 0，看不出位序问题。
- **注意**：仿真里 REF/RAW 是 `75df75df` 循环、DITHER=0、quality=128，这是 RO 行为模型的产物，
  不能当 PUF 质量证据；已写进 `docs/key_subsystem.md` §6 已知限制。
- **最终集成 STA（`keys_sta_final`，含 key_mmio + 固件验证过的 RTL，生产策略）**：
  **WNS +0.168 / TNS 0 / 0 失败端点 / WHS +0.015 / 布线错误 0 / LUTLP-1 = 0**；
  LUT 17022、FF 28543、BRAM 34.5；最差路径回到 CPU 内部 `id_ex_u/rs1_o→func_sel_o`。
  同配置的前一次 run（`keys_sta_mmio2`）是 +0.023，差的 0.145 ns 纯属布局差异 →
  **今后报 WNS 必须带 run 名字，不能说"设计已经到 +0.168"**。
- 余量仍仅 +0.058 ns（0.6%）；80 MHz 按周期差算术 ≈ +2.56 ns（cycles/加速比不变）。

## 2026-10-20 — V11 时序余量取证：P&R 空间关闭，建议降频；上板清单成文

owner TBD；基线 `3c6f134`（工作区 clean）。未改 RTL/XDC/XCI/COE，未 commit/push，未上板。

- **余量取证**：4 个 P&R 变体（同一 post-opt netlist，隔离目录）并行实测，
  WNS 分别 +0.008（无 pblock/ExtraTimingOpt）、+0.020（3-region pblock/ExtraPostPlacementOpt）、
  +0.001、+0.001（紧 pblock 两版）；TNS 0、失败端点 0。加上此前 33 策略扫掠与
  V09 修复，**P&R 侧余量空间判定关闭**，最佳 +0.020 ns 不构成可用余量。
- **根因修正**：不是单条坏路径。`acb_remap_routed.dcp` 实测 slack 分布
  <0.1 ns 55 条、<0.3 ns 334 条、<0.5 ns 1058 条、<1.0 ns 3731 条；
  4 个变体各自的最差路径互不相同（`id_ex sel_*_o → if_id CE / dcache DIADI`、
  `ex_mem → dcache lru`、`pc → icache tag → csr → ISE state CE`），
  说明这是一道整体 Fmax 墙（≈100.1 MHz），单点 RTL 断链只能防翻负、不能加余量。
- **布局实测**：`u_cpu_core` 分布 X32..106 / Y0..113，`u_dcache` 单模块跨 111 行，
  全设计仅 22% LUT；但 pblock 紧约束并未改善（+0.001），故布局不是解。
- **建议**：上板频率定 80 MHz；同一已布线网表只改时钟周期实测 WNS：
  90 MHz +0.965、80 MHz +2.340、75 MHz +3.165（折算到最终网表 ≈ +1.11/+2.48/+3.31），
  WHS 恒 +0.023；cycles/cpb/加速比不变。保 100 MHz 则只做 ISE CE 断链防翻负。
  任何上板版本必须重新 STA（PS7/IO/时钟源全变）。
- **文档**：[时序余量方案](../docs/timing_margin_plan.md)、[上板分步清单](../docs/board_bringup_plan.md)；
  新增脚本 `build/sweep_margin_phys.tcl`、`build/probe_timing_wall.tcl`、`build/probe_geometry{,2}.tcl`；
  证据 `build/reports/margin_20261020/*/`、`build/local/margin_20261020/`。
- **未完成**：降频后的实测 STA（需改 XCI，待用户决定）；L1 RTL 断链（属 RTL owner）；
  B02/B03/B04/V01/V03/Y01\~Y05/S01\~S05 状态不变。
- 首轮脚本用 `get_timing_paths -pulse_width` 取 WPWS 抛错（2025.2 无该选项），
  发生在写 result.txt 之前；RPT 正常，数字取自 `route_timing.rpt`，脚本已修正。

### 追加：砍 dcache 评估 + 架构改动方案（用户询问）

- 导出 14164 条 slack<2.0 ns 路径逐条分类（`build/probe_path_classes.tcl` →
  `build/local/margin_20261020/paths_lt_2p0.csv`）：
  `id_ex_u` 最差 **−0.140**（647 条 <0.5 ns）、`u_if_stage` −0.071（358）、
  `u_dcache` −0.071（308）、`u_icache` +0.074（124）、`u_ex_stage`/`u_ascon_ise` +0.133（206/198）、
  `u_ascon_mmio` +0.108（1670 条 <1.0 ns）。最差 10 条中 9 条从 `id_ex_u` 的旁路选择寄存器出发。
- **砍 dcache 结论：时序收益 0**（所有 dcache 相关路径消失后剩余 WNS 仍 −0.140，最差路径在
  id_ex 内部），性能为负（load 命中 1 拍 → AXI 读 ≥4 拍，且软件基线掉得比 ISE 多，
  会虚增加速比）。不做。
- 收益模型：单模块 +1.5 ns → 只有 id_ex 能到 −0.071；dcache+id_ex +0.089；再加 if_stage +0.108；
  全部模块才 +1.281 → **要 +1.0 ns 必须多模块协同**。
- 方案与门禁：[cpu_timing_architecture_plan.md](../docs/cpu_timing_architecture_plan.md)
  （B `bus_addr_r` CE 断链、C store buffer 一级、E ISE cancel 移出 CE 锥——均 0 周期；
  A id_ex 旁路网提前寄存、D if 控制、F mmio 内部拆拍）。估算 2.5 天 + 全套回归，与 10-27 冻结冲突。
- 并行免费尝试：`build/synth_margin_variants.tcl`（flatten full + PerformanceOptimized /
  AlternateRoutability / rebuilt+AlternateRoutability，实现统一 ExploreWithRemap），
  结果 `build/reports/synth_margin_20261020/<tag>/`；**已跑完**：
  `flat_perf`（full+PerformanceOptimized）**WNS +0.034** / TNS 0 / 0 失败；
  `flat_alt` −0.470（561 失败）；`rebuilt_alt` −0.008（3 失败）。综合选项不是解，
  但 flatten=full 可与方案 A 一起带。

### 追加 2：B + E 补丁落地并验证等价（用户指示“先做 B+C+E”）

- 补丁（可直接 `git apply`，未改 `src/rtl`）：`build/patches/timing_B_dcache_bus_addr_ce.patch`
  （dcache `bus_addr_r` 使能改为 `cache_access_fire`，去掉 cacheable 12 位比较与地址依赖）、
  `build/patches/timing_E_ascon_ise_cancel_ce.patch`（`cancel` 移出 320 位 `state` 使能，
  改为 `cancel_d` 延迟一拍物理清零 + `{cancel,cancel_d}` 读掩码，写入优先于清零）。
- 等价性（`build/check_bce_patches.sh`，控制组=当前 `src/rtl`，打补丁=隔离副本）：
  ise PASS/2496、ise+HOLD_ISE PASS/2496、ise+RESET_ISE PASS/2496、
  ise 安全套件 **402 checks PASS/0 failed**、hw PASS（99/670 cyc）、
  sw PASS（17353/21515/17847/22094 cyc）——**六种场景逐项一致，周期数完全相同**。
- 说明文档：[timing_bce_patches.md](../docs/timing_bce_patches.md)。
- STA（ExploreWithRemap，打补丁 RTL）已提交后台运行，结果待补；
  预期 WNS 仍在 −0.14/+0.01 量级（#1 在 id_ex CE 锥，B/E 碰不到）。
- C（store buffer）本轮未做：它解的是 #3/#4（−0.047/−0.019），需处理 back-to-back store、
  store→load 字节转发、fill 端口冲突，风险高于收益，排在方案 A 之后。

### 追加 3：B/E 判定净负，A1 落地（2026-10-20 22:50）

- **B/E 不落地**。功能/周期全等价，但 STA 实测：`e_only`（仅 ISE cancel −0.273 ns / 137 失败端点）、
  `e2`（dcache CE + 修正版 cancel，−0.643 ns / 649 失败端点），对照 control +0.007。
  原因：WNS 对网表扰动有 ±0.7 ns 敏感度，这两处只重排使能、不减逻辑深度。
- **A1 落地**（`build/patches/timing_A1_ex_stage_alignment_narrow.patch`）：
  `src/rtl/ex_stage.v` 非对齐判定改用 3 位部分和（`(a+b)[2:0] == (a[2:0]+b[2:0])[2:0]`），
  把 32 位地址加法器从 `trap → flush → ID/EX 使能` 锥里摘出。
  实测 **WNS +0.016 / TNS 0 / 0 失败端点 / WHS +0.012 / LUT 11821(+3)**；
  最差类由 13 级/8 CARRY4/logic 3.564 ns 变为 9\~10 级/1\~2 CARRY4/logic \~1.93 ns。
  功能与周期六场景逐项一致（ise/stall/reset 2496、安全 402/0、hw PASS、sw 17353/21515/17847/22094）。
- **100 MHz 天花板**：A1 + 4 个 floorplan/directive 变体 = +0.003 / +0.022 / −0.041 / −0.297，
  最优 **+0.022**（A1 + pblock X50Y0:X113Y99）。最差路径始终是 `pc → icache tag → CE`
  （logic ~2 ns、route ~7.6 ns 占 78%）。不改流水结构，100 MHz 余量就到 +0.02 量级为止。
- 下一步二选一：`icache` tag 打一拍（+1 取指周期，需重测全部 benchmark，与 10-27 冻结冲突），
  或演示/上板定 80 MHz（同网表实测 +2.340 ns，cycles/cpb/加速比不变）。
- 证据：`build/reports/bce_timing_20261020{,_a1,_a1_pr,_b_only,_e_only,_e2}/`、
  `build/reports/margin_a1_20261020/*/`、`build/local/patches*/`。

## 2026-10-18 — V10 数据复验一致；并行恢复产物按用户决定暂保留

owner TBD。用户明确选择保留最终双策略 RPT，清理旧报告/无用 BAT/JSON/TXT 及可再生缓存，
并要求删除后重检数据。曾执行删除564个文件（17.82MiB），含312旧RPT、66中间JSON、48TXT、4BAT；
随后并行会话恢复/重生成6个路径，用户最新决定暂时保留，当前并非只剩最终报告。
必要元数据、最终DCP、生产源、KAT、ISA控制/最终候选结果未删。逐文件删除hash及231项保留hash已记录。
8项CPU新label真实重编译/仿真全部PASS，源码/有效固件bin/测试输出/周期逐项一致；
安全/5单元一致，ISA仍49 PASS+ma_data既有1 FAIL；231项保留hash均不变。
原复验脚本exit 1及FAIL JSON保留：唯一失败是删除目标重新出现的留存检查，不是数据不一致。
复验判读为数据PASS、留存DEFERRED；本任务最终清理收口blocked，等待并行任务结束再确认。
本次不改RTL/固件/XDC，不重做布局布线；旧汇总脚本增加缺报告时的明确退出提示。
详见 [V10 清理与复验](../docs/workspace_cleanup.md)。未commit/push，未上板。

## 2026-10-18 — V09 100 MHz 芯片级 STA 收敛（已核验）

owner TBD；基线 f52bc49 + 工作区 dcache/ascon_ise/ex_stage/mult 修改（另一个 AI 完成，
本 Agent 独立核验）。未 commit/push；未上板。

- **收敛结果（已核验两份最终报告 timing_acb_20261018/）**：
  Performance_ExplorePostRoutePhysOpt WNS=+0.001/TNS=0/0 失败端点/WHS=+0.031；
  Performance_ExploreWithRemap WNS=+0.007/TNS=0/0/WHS=+0.023。100 MHz STA 通过。
  此前 93 个 ISE s_reg 复位端点与 48 个乘法器端点全部消除。
- **功能回归（ACB 套件，已核验）**：sw/hw/ise 与 security、stall/reset 注入全 PASS；
  ISA 49 PASS + 1 FAIL（rv32ui_ma_data），与修改前对照组完全一致（既有失败，非本次引入）。
  周期恢复：hw 670 / ise 2496（与 HEAD 持平）。
- **余量警示**：收敛余量仅 1-7 ps，处于布局噪声量级（s_reg 路径实测跨布局摆动
  -0.05~-0.128）。双策略同为正提供一定防误证，但此后任何 RTL 改动都可能重新翻负；
  建议以此为冻结检查点，再动必须全套复验。
- **未完成**：板级 IO delay/板型/pinout（B02/B03）、PS/PYNQ（P1）、Ascon 固件镜像
  替换（COE 仍 FreeRTOS）、板上 KAT/benchmark（V01/I08/Y01）。芯片级收敛不等于上板通过。
- 证据：build/reports/timing_acb_20261018/{postroute,remap}/、
  data/ascon/results/key_lifecycle/\*_timing_acb\*.json、data/ascon/results/isa/{fix_r1_control,timing_acb}/。

## 2026-10-18 — V09 A→C→B 与双策略完成：既有 100 MHz STA 通过

owner TBD；用户要求先解除 93 个 ISE 私有复位端点，再处理乘法器 48 端点、恢复 store/MMIO 延迟。
已通过独立 fix_r1 DCP 端点导出证实基线分类 93/48/11/4（共 156），未改原 DCP/扫掠工程。
A 注册 ISE 局部 reset；C 注册乘法输入/输出、done 保持到 ack；B 仅让 load miss 走 MISS_CAPTURE。
A/C 定向 Icarus 与 XSim 测试通过，恢复的 50 项 RV32I/M 指令体全部重跑：49 PASS、ma_data FAIL；
控制快照同样失败（不支持硬件非对齐读），不隐去 exit 1 或宣称全绿。最终整机 8 项、
MMIO/ISE 生命周期及单元 5/5 全部 PASS，生产源码 hash 与当前工作区匹配。
软件、hw full MMIO、ISE 周期恢复到 HEAD 的 17353（enc16B）/670/2496，B 的性能代价已收回。
两策略同快照实现通过 Ross 完成（exit 0，3895.571秒）：PostRoute WNS=+0.001/TNS=0/WHS=+0.031；
Remap WNS=+0.007/TNS=0/WHS=+0.023，均 0 setup/hold/pulse 失败端点、0 路由错误。
**原 93 个 ISE、48 个乘法器、11 个 dcache 与 4 个其他端点类别全部归零**；未改 LRU/频率/时序例外。
40 个生产源 hash 与测试工作区一致，XDC 与 baseline 副本 hash 相同。
候选推荐 Remap（LUT11752/FF16040/BRAM38.5/DSP4）；只余 7ps，不宣称跨变更鲁棒性。
这仅是既有约束下 STA 通过：3 个输入/3 个输出仍缺 IO delay，方法学/板级电气与 DRC/实板未验收。
详见 [V09 验证](../docs/timing_acb_validation.md)。
V09 本轮范围 done；未 commit/push，未上板；完整特权/RV64/嵌套中断门禁仍未验收。
下一接收 B03/V01/I08，先做板卡与 IO/电气约束/DRC，再进行 bitstream/实板 KAT。

## 2026-10-18 — V08 dcache MISS_CAPTURE 功能修复 fix_r1 + Ross 接入 OpenCode

owner TBD；基线 f52bc49 + 工作区。按 [dcache_fix_plan_for_opencode.md](../docs/dcache_fix_plan_for_opencode.md) 执行。

- **Ross**：本机已有 vivado-mcp-server 2026.9.1；登记到 OpenCode 全局配置 `mcp.servers.vivado`
  （`--stdio`，VIVADO_PATH=2025.2），已实测连接并用于 vivado-rtl-lint。
- **dcache.v 修复**：MMIO 读改为固定延迟移位（对齐延后一拍的 bus_mmio_re）；MISS_CAPTURE
  全部改用 IDLE 拍寄存的请求类型标志，不再读活 hit/cacheable/cpu_re_i；总线请求一律单拍脉冲
  （原 bus_mem_re_r 在 FILL 期间保持高，会让互连排队第二个伪读突发）。接口不变。
- **功能门禁全 PASS**：HEAD 对照筛选、wt 筛选、sw/hw/ise、hw/ise --security（123/0、402/0）、
  单元 4/4、ise --stall/--reset；Ross lint 2 条 WARNING 与 HEAD 完全相同。
- **周期代价（同工具链对 HEAD）**：sw +0.3%，hw full MMIO 670→717（+7.0%），ise 2496→2550（+2.2%）。
- **时序（ExplorePostRoutePhysOpt）**：WNS=-0.128/TNS=-11.213/156 端点，WHS=0.005，路由无错误。
  **门禁 4.4（WNS≥-0.078）未过，100 MHz timing not met**。最差 20 条路径无 dcache，
  新最差为 pc_reg→ascon_ise s_reg/R（复位/冲刷扇出，布线占 80%）。证据见
  [清单 §11](../docs/dcache_fix_checklist_en.md)。
- 未 commit/push；未上板。下一步：ISE s_reg 复位扇出路径；可选只让 load miss 走 MISS_CAPTURE。

## 2026-10-18 — V08 全量 33 策略扫掠完成 + dcache 流水线评估

owner TBD；基线 f52bc49。用户授权补测"其余全部策略"并评估另一个 AI 的 dcache 优化。

- **策略扫掠**：四批共 35 个 run（33 个 2025.2 标准流程策略 + 2 个回退重复已剔除），
  全部 exit 0。最优 **Performance_ExploreWithRemap WNS=-0.118/TNS=-1.008/22 端点**，
  超过此前最优 ExplorePostRoutePhysOpt（-0.177）。33 策略完整排名与分析见
  [ascon_strategy_sweep.md](../docs/ascon_strategy_sweep.md)。
  高级实现流程（Vivado Advanced Implementation 2025）在 xc7z020 上不支持（12-25131
  静默回退），其 4 个独有策略批处理不可测，已记录。
- **dcache 流水线版（另一个 AI）**：独立实测（Performance_ExplorePostRoutePhysOpt）
  MISS_CAPTURE 版 WNS=-0.055/TNS=-1.122/40 端点（三版最佳，DONT_TOUCH 版 -0.078）。
  但功能回归 sw 模式 TIMEOUT：CPU 在 t=275、pc=0x100083f0 死锁（MMIO 读等待依赖
  bus_rdata_valid_i 而 bus_mmio_re_r 仅 1 拍脉冲，握手永不完成）。HEAD 原版 PASS 对照。
  两版均功能不可用；修复方案交付另一个 AI：[dcache_fix_plan_for_opencode.md](../docs/dcache_fix_plan_for_opencode.md)
  + [英文清单](../docs/dcache_fix_checklist_en.md)。遗留同名 module 实验文件已移入
  src/rtl/dcache_experiments/（Vivado 同名模块静默选文件的坑）。
- **收敛预期**：新 RTL（修复后）-0.055 + ExploreWithRemap 相对提升 ~0.059 →
  ≈+0.004 ns，100 MHz 极可能收敛；待功能修复后实测。
- 100 MHz timing not met 保持；上板门禁 B02/B03/V01/I08/Y01 不变。未 commit/push。

## 2026-10-18 — V08 实现策略扫掠（Strategy Sweep）

owner TBD；基线 f52bc49，本机 DESKTOP-5H4M0DR（V06 两轮在 xyq 机上）。用户授权
全量 10 策略扫掠并记录数据与分析；未改任何 RTL/XDC/XCI/COE，未 commit/push。

- 本机 Vivado 2025.2 原缺 Zynq-7000 器件库（open_project 报 part 不可用）；用户经
  "Add Design Tools or Devices 2025.2"（C:/ruanjian/.xinstall/2025.2/xsetup.exe）
  补装 Zynq-7000 后 `get_parts xc7z020clg400-1` 通过。
- 新脚本 build/sweep_strategy_timing.tcl（隔离工程、共享 synth、按最终步骤分组
  3 路×6 jobs 并行波、TSV 断点续跑）+ build/aggregate_strategy_sweep.py（.rpt 解析
  交叉核对）。多次中断续跑，最终 exit 0、SWEEP COMPLETE、10/10 策略完成、无真实 ERROR。
- 结果：最优 **Performance_ExplorePostRoutePhysOpt WNS=-0.177/TNS=-2.968/31 失败端点**，
  其次 Performance_Explore -0.273、NetDelay_high -0.325；最差 Default -0.942。
  与本机重跑的 Default/ExplorePostRoute 与 V06 xyq 机逐位一致（跨机可复现）。
- 结论：10 个内置策略无一收敛 100 MHz；策略空间已关闭，剩余 0.177 ns 属 CPU
  id_ex→dcache CE/DIADI 地址计算路径（路由主导），转入 RTL 修复。
  详见 [策略扫掠分析](../docs/ascon_strategy_sweep.md)，数据在 data/ascon/results/strategy_sweep_20261017/。
- 流程与踩坑沉淀为 skill vivado-strategy-sweep；报告在 build/reports/strategy_sweep_20261017/。
- 上板门禁不变：100 MHz timing not met，B02/B03/V01/I08/Y01 仍待接收。

## 2026-10-17 — V07 Ross/工程Skills评估与有限审查

owner TBD；先完成稳定检查点`2b48a8a730267787b399fe06304ae5e2b53ff203`并推送，草稿
[PR4](https://github.com/HChenZ/amd_fpga_2026/pull/4)明确100 MHz未收敛、未上板；原工作区保留。
Ross官方Windows Server下载遇AMD会话错误19，本机未安装/配置，MCP timing/utilization均not_measured。
文档核实2026.1完整测试基线及各Skill版本差异；当前2025.2/Tcl保留，未升级或启动网络控制服务。

只安装Matt Pocock code-review/diagnosing-bugs/tdd/pr四项，固定提交、无插件重复；12文件hash一致，
本机Codex skills/list四项enabled、0 errors。按code-review做只读双轴审查：需求0项，规范1项P2
（缺失/部分实现快照可能误判匹配）。修复证据门禁，5项测试PASS，独立复核关闭该发现。
新最终源码清单119文件，六组CPU输入和实现RTL未变，无需重跑长仿真或Vivado。

评估与优先级见[工具报告](../docs/ross_and_engineering_skills_evaluation.md)、
[双轴审查](../docs/ascon_branch_review.md)及`data/ascon/results/tool_evaluation/`。
V07评估完成不表示Ross接入或V06时序/板级门禁完成；下轮先核板型和CPU/cache剩余路径，Sweep延后。

## 2026-10-17 — V06 阶段性收尾与证据复核

owner TBD；工作区 E:/amd_fpga_2026_key_lifecycle，分支 fix/ascon-key-lifecycle。
2026-10-16的两轮实现均完整结束；本日只读复核源码/日志/报告，不重开Vivado，不做第三轮优化。
117个源码hash、所有物理报告hash、六组CPU测试输入和实现RTL快照均匹配；XDC/COE及原baseline未改。
blk_mem_gen独立副本仅有工具元数据/checksum改写，功能参数不变，双侧hash已保存。

- 最终软件/MMIO/ISE原KAT均PASS；动态密钥安全检查132/123/402项全部PASS。
  Host Final 28661项、C失败输出23965项、MMIO/ISE RTL 13212/1500项、4个CPU单测、
  4个RTL故障注入门禁与867请求逐周期等价检查均PASS。复用哈希一致证据，未重跑长测试。
- 最终Vivado2025.2、xc7z020clg400-1、top_pl_bram：WNS=-0.177ns、TNS=-2.968ns，
  31个setup失败端点；WHS=0.015ns/THS=0、WPWS=3.750ns/TPWS=0。
  LUT11636/FF15949/BRAM38.5/DSP4；23917个net fully routed，routing errors=0。
- **100 MHz timing not met**。DRC已报告95 Warning/0 Critical Warning/0 Error（部分规则达到上限），
  Methodology另23 Warning。cache地址/hold控制剩余路径、LUT派生复位、BRAM异步控制、PS7与板级IO覆盖仍需处理。
- 安全修复与时序分析可作为阶段性成果提交；V06保留in_progress，上板门禁未过。
  官方固定KAT与运行时参数边界明确，新增3组公开Key/Nonce；没有真实秘密或生成缓存纳入提交。

完整证据：[最终汇总](../data/ascon/results/key_lifecycle/final_validation_summary.json)、
[时序审查](../docs/ascon_timing_review.md)、[密钥审查](../docs/ascon_key_management.md)。
下一接收 B02/B03/V01/I08/Y01；先保存Git检查点，再进行用户授权的Ross/Skills低风险评估。

## 2026-10-16 — V06 密钥生命周期与上板前审查

owner TBD；基于最新 origin/main `c37ecae`，独立 worktree / `fix/ascon-key-lifecycle`。
用户本轮明确授权检查通过后自动 commit/push，原工作区未提交改动全部保留。

- 三套实现均已存在，不能沿用下文早期“未实现 ISE”的结论。新增 [密钥生命周期审查](../docs/ascon_key_management.md)
  与 [板卡清单](../docs/ascon_board_checklist.md)，详细结果索引为 `data/ascon/results/key_lifecycle/validation_summary.json`。
- 修复：MMIO idle CTRL[2] ZEROIZE、BUSY/失败/越界读保护、旧输出清理和尾字屏蔽；
  ISE 失败输出擦除/长度、部分密文 Tag 指针、状态清理、非法索引、完成保持；
  CPU 提前译码遗漏的 custom 操作数旁路/load-use；软件 C 本地敏感对象擦除。
- 固定官方 KAT 不变；3组公开动态 Key/Nonce、27个长度组合由锁定 Final C/Python 交叉核对。
  MMIO 只跑其中21例（AD/消息各<=16字节），不宣称多块接口。
- Host Final 28,661 PASS/0 FAIL，production C raw failure 23,965 PASS/0 FAIL；
  独立 RTL 全源集 Final KAT/置换/认证与故障注入通过。MMIO 13,212、ISE 1,500项检查通过；
  baseline bypass/regfile/EX ALU 与新增 execute cancel/hold 单测通过。
- CPU 软件/MMIO/ISE 的最终 KAT、安全测试和周期结果由上述 JSON/原始日志定稿；
  明确使用 GCC13.2/仿真50MHz，不与队友 GCC15.2 的历史数值混算。
- Vivado2025.2可运行，原始三个IP未锁定且再生成成功。独立副本综合0 errors/0 critical warnings；
  实现结果、时序、资源、DRC在最终汇总中列明。原 baseline、XCI、XDC、COE不改，579项恢复资产hash通过。
- 真实板型未知、未烧录；FreeRTOS COE未换为Ascon固件，PS/PL/PYNQ尚未建立。
  ISE完整抢占上下文、全部ISA/异常/外设回归、板上测量仍未完成。清零不等于抗侧信道/物理提取。

最终补记：三套CPU原KAT全部PASS；新增安全检查软件132/132、MMIO123/123、ISE402/402，
ISE含下游hold跨完成和计算中reset重启。16B warm加密仿真周期：软件18348、MMIO完整往返664
（START→轮询完成100）、ISE2559；软件32B enc22817，dec16B18886/32B23388。
六个最终源码loadable binary与已测镜像逐字节一致，ISE反汇编有实际custom-0编码。
Vivado布线完成exit0，但100MHz WNS=-1.641ns、TNS=-607.794ns（1971失败端点），
LUT11683/FF15960/BRAM38.5/DSP4；DRC已报告95项Warning、无Error（部分规则达到报告上限），
存在PS7缺失、BRAM/复位与IO delay覆盖告警。故V06保留in_progress，上板门禁未通过。
已完成的安全修复与仿真可审查，时序收敛/实板功能不可标完成。

下一接收 B02/B03/V01/I08/Y01，owner TBD。历史与中间失败保留，不把综合或仿真冒充上板。

## 2026-10-15 — Ascon-AEAD128 软件版在自研 RV32IM CPU 上运行并测得软件性能

owner TBD；用户授权"调用已有 C 代码库完成软件版、测试保证处理器可用、测软件性能"。
未改任何现有 RTL/TB/KAT/脚本；新增固件与仿真平台，全部落在约定目录。

- 新增 src/firmware/ascon_rv32/：crt0.S、riscv.ld（ORIGIN=0x10000000 对齐复位 PC）、
  main.c（`#include` 锁定生产 ascon/ascon_c/aead/aead.c）、uart.c/h、libc_min.c、
  bin2vhex.py、build.sh。工具链 riscv-none-elf-gcc 15.2.0，
  `-march=rv32im_zicsr -mabi=ilp32 -O2 -ffreestanding -nostdlib -lgcc`；
  64 位软件基线因此需要 libgcc(__udivdi3/__lshrdi3 等)。镜像 code=38852 B、data=0、bss=0。
- 新增 sim/ascon/axi_slave_bram.v（AXI4 行为 BRAM：4 拍 WRAP 读 + 单拍写 + $readmemh）
  与 tb_ascon_sw.v（soc_top @50MHz + BRAM + UART monitor 解码 txd、检测 DONE/FAIL 标记）。
  入口 sim/ascon/run_ascon_sw.sh 一次完成 交叉编译→iverilog 编译→vvp 运行。
- 实测（Icarus 14.0 devel / vvp，退出码 0）：6 组官方 KAT（empty/1B/16B/16B+AD/17B/32B）
  加解密全 PASS，tag 篡改拒绝 PASS；CPU RTL(soc_top) 确实执行 ISE 无关的纯软件 Ascon。
- 软件性能（warm，模拟实测，非上板）：enc 16B=16840 cyc(1052.5 cpb)、enc 32B=21018(656.8)、
  dec 16B=17226(1076.6)、dec 32B=21461(670.7)；CPI≈3.9~4.0。mcycle 用 CSR 0xB00/0xB80
  high-low-high 读取；指令数用 cpi_cnt MMIO(0x60000000/04)。UART@115200 主导 cycle 量
  （每字节 4340 clk），故加密/解密各运行两遍取第二遍作为 warm 测量。
- 未验证/未测：上板(B02/B03)、Vivado 综合/实现/PPA、CPU ISE、完整 1,089 KAT 的目标运行
  （仅 host 全量 + 目标 6 组代表向量 + 篡改）。cycle 为仿真实测，不是 board 实测；未改任何 RTL。

C02 目标编译/运行与 C04 CPU 级软件 benchmark 已在仿真层达成；C03 目标 KAT 为 6 组代表向量
（全量仍在 host）。板级与 ISE 仍依赖 B02/B03/V01 后续接收。

## 2026-10-15 — Ascon MMIO 加速器接入 CPU（第一次硬件优化）

owner TBD；用户授权"结合 IO 接口代码把已写好的硬件接入、做第一次优化并测试"。
复用队友 IO/ 的 ascon_mmio.v（寄存器文件+FSM+缓冲，基址 0x30000000）与已 KAT 验证的
crypto_aead.v，新写 ascon_aead_core.v（32-bit 流式接口 → 128-bit 并行 crypto_aead 的适配器）。
改了 bus_interconnect.v（新增 ascon MMIO 译码 + read_sel_q 扩 6 位）与 soc_top.v（实例化
ascon_mmio、ireq_external 并入 ascon_irq），均为 README 记录的增量接线；未动 crypto_aead.v。

- 新增 src/rtl/ascon/ascon_mmio.v（队友 IO 原件字节一致复制）、ascon_aead_core.v
  （streaming 适配器，≤16B AD/msg，超长立即 done+success=0 拒绝）。
- 新增 src/firmware/ascon_hw_rv32/（MMIO 驱动固件，code=3936 B）与 sim/ascon/run_ascon_hw.sh。
- 关键 bug：crypto_aead 的 mode=0 加密/1 解密，而 ascon_aead_core 的 encrypt=1 加密/0 解密，
  初版直连导致所有加密请求按解密执行（空消息 tag 恰好仍对，非空全错）。修 .mode(!encrypt_r)。
- 实测（Icarus 14.0/vvp，exit 0）：4 组官方 KAT(empty/1B/16B/16B+AD) 加解密 PASS、
  解密往返 PASS、tag 篡改拒绝 PASS、17B 超长拒绝 PASS——CPU 通过 MMIO 驱动硬件 Ascon 正确。
- 性能（warm，仿真实测，非上板）：16B 加密 纯 crypto 延迟 99 cycles、完整 MMIO 往返 544 cycles；
  对比纯软件 16840 cycles → crypto 核心 ~170×、端到端(含寄存器读写+轮询) ~31×。这是 ISE 前
  的第一级硬件加速，MMIO 开销(寄存器写+轮询+读回)是下一步 ISE 要压缩的部分。
- 未验证/未测：上板、Vivado 综合/PPA、>16 字节消息、真正的 CPU ISE(I02~I07)。未改 crypto_aead.v。

## 2026-10-15 — Ascon 置换 custom instruction (ISE) 完成（最后的优化）

owner TBD；用户授权"继续完成 ISE 优化并测试，这是最后的优化"。在 RV32IM 软核里加入
Ascon 置换 custom instruction（custom-0 opcode 0x0B），复用已 KAT 验证的 p12/p8 模块，
CPU 用 inline asm 跑置换、其余 AEAD 逻辑仍用 C。改了 defines.v / id_stage.v / ex_stage.v
（新增 opcode/func_sel、译码、执行与多周期 stall，仿 divider 的 ex_stall_req 机制），
未动 crypto_aead.v/p12/p8。

- 新增 src/rtl/ascon/ascon_ise.v：CPU 内 320-bit 状态寄存器 + p12/p8 握手。
  4 条指令（.insn r 0x0B, funct3, funct7=0, rd, rs1, rs2）：
  `ascon.w`(f3=0, rs1=data, rs2=word idx) 写状态字；`ascon.rd`(f3=1, rs1=idx, rd=dest) 读状态字；
  `ascon.p12`(f3=2)、`ascon.p8`(f3=3) 跑置换（多周期，perm_start 电平 + ex_stall_req=~perm_done）。
  状态字 0..9 对应 s.x[0..4] 的 32-bit 小端切片。
- 新增 src/firmware/ascon_ise_rv32/（inline asm + 完整 AEAD，code=6216 B）与 run_ascon_ise.sh。
- 关键坑：GAS `.insn r` 格式是 `opcode,funct3,funct7,rd,rs1,rs2`（funct7 在 rd 之前），
  不是 `opcode,funct3,rd,rs1,rs2`；写错会报 "bad value for funct7 field"。
- 实测（Icarus/vvp exit 0）：4 组官方 KAT(empty/1B/16B/16B+AD) 加解密 PASS、解密往返 PASS、
  tag 篡改拒绝 PASS。反汇编确认 142 条 opcode 0x0B 的 custom 指令，非静默 fallback。
- 性能（warm，仿真实测）：16B 加密 **1880 cycles**（vs 纯软件 16840 → ~9.0×，~117.5 cpb）。
  剩余开销来自状态字 load/store（每置换 20 条）与 LOADBYTES/STOREBYTES 字节搬运（未加速）。
- 未验证/未测：随机/边界/复位/连续请求的定向单元测试（I04 仅跑了 KAT 定向）；baseline 回归
  重跑（I05 只跑了 ISE 回归，未重跑软件/MMIO 全回归）；ISE-disabled 模式、中断/异常/flush
  与 ISE 交互；Vivado 综合/PPA（I08，需上板前补）。这些是 I04/I05 验收的剩余项，未标完全达标。

三级加速对比（16B 加密，均为 warm 仿真实测）：纯软件 16840 → MMIO 全卸载 544(~31×) →
ISE 置换 1880(~9×)。ISE 是 custom instruction 路径（CPU 编排、置换硬件化），MMIO 是全卸载
协处理器路径；两者互补。ISE 的编码/semantics/stall/inline-asm 落位；I03/I06/I07 已达标，
I01/I02/I04/I05 主体完成、上述未测项待补。

## 2026-10-10 — Ascon 加解密合并为统一 crypto_aead 模块

owner TBD；用户授权新建独立文件，未改现有 RTL/TB/脚本/KAT。将原独立
crypto_aead_encrypt / crypto_aead_decrypt 合并为单一 crypto_aead 模块，
用 mode(0=encrypt/1=decrypt) 选方向、共用一条状态机。关键洞察：Ascon 加
解密吸收的是同一份"明文 pad 版本"——加密直接喂输入明文，解密由 s^c 恢复
明文后吸收，故尾块 mask+0x01 逻辑可完全统一，输出恒为 s^data_in。

- 新增 src/rtl/ascon/crypto_aead.v：统一接口 clk/rst_n/start/mode/data_in/
  ad/npub/k/adlen/datalen/tag_in → data_out/tag/correct/done/busy/error。
  encrypt 输出密文+tag；decrypt 输出明文，仅 tag_in 匹配才置 correct 发布。
  17..31 长度两方向均 error 拒绝，decrypt 另保持 correct=0。
- 新增 sim/ascon/tb_crypto_aead.v：同一冻结向量同时测加解密，含逐拍
  data_out=0/correct=0 隐藏检查、tag 篡改拒绝、长度拒绝、连续调用。
- 新增 sim/ascon/prepare_crypto_vectors.py：无需 C 编译器（WSL 不可用），
  直接从锁定官方 KAT 取 289 组(PT/AD 0..16)生成 784-bit aead.mem，布局与
  既有 aead.mem 一致。
- 实测 iverilog 编译 exit0、vvp 运行 errors=0：加密 289、解密 289、篡改
  拒绝 289、长度拒绝 1470(735×2) 全 PASS；latency 空消息 34 cyc、16B 58~70
  cyc。全源集(新旧模块共存)编译 exit0、无重复 module。
- 未动 ascon_aead_2.v 及原 encrypt/decrypt，旧接口回归不受影响。合并模块
  尚未接入 CPU/ISE；Vivado/PPA/hardware cycles 仍 not_measured。

随后按用户方案 B，把 ascon_aead_2.v 的 crypto_aead_encrypt / crypto_aead_decrypt
改为实例化 crypto_aead 的薄 wrapper：端口名/方向/宽度/顺序不变，两条重复
状态机移除，底层逻辑单一来源（get_bytes 保留）。资源上，SoC 只实例化一个
crypto_aead 即可加解密复用一份，wrapper 为纯连线、综合可优化。

- 回归复验（wrapper 后）：队友 peer TB ALL PASS；加密 300 组+735 长度、解密
  310 有效+2,579 篡改+735 长度均 errors=0，数字与原 V05 一致；全源集编译
  exit0、12 模块无重复。tb_rtl_aead/decrypt 用 peer(5)+官方KAT(289)+tails(6)
  共 300 组向量（build/local/ascon_crypto/aead_full.mem）；WSL 不可用，故 peer
  ct/tag 取队友 TB 字面量、matrix 取官方 KAT 自带 expected，不重算。

下一接收：SoC 集成(I03/I05)时顶层直接实例化 crypto_aead（一个实例、mode
切换，加解密复用一份资源）；B02/B03/B04/V01 仍为在自研 CPU 运行 Ascon 前置。

## 2026-10-10 — V05/C03 功能分支提交前审查

owner TBD；用户授权在E:/amd_fpga_2026_integration将已验整合成果commit/push并创建
PR，base main；最终合并由用户确认。fetch确认main仍为0a425f9，整合分支正确。
本条记录提交前审查，不把尚未执行的push/PR写成完成；实际SHA与PR见Git历史及交付。
本轮仅更新发布审查文档/日志，RTL、TB、脚本及KAT均未改；已有PASS的源码哈希
重新核验。Encrypt所有现有实例均具名连接，无现有位置调用受追加error端口影响。
原工作区及外部备份只读核验，队友两份dirty结果不纳入；无CPU/Vivado/PYNQ改动。
提交消息feat(ascon): integrate RTL decryption and KAT validation；明确文件列表暂存，
不用git add .，不force、不推送main、不合并PR。V05/C03任务状态沿用前次实测边界。

## 2026-10-09 — V05/C03 最新main隔离整合与重新验证

owner TBD；重新fetch确认origin/main=0a425f9，独立worktree
E:/amd_fpga_2026_integration，分支feat/ascon-decrypt-kat-integration。
原E:/amd_fpga_2026保持7139a80/cleanup/remove-legacy-ascon-aead及全部28个未提交
文件。仓库外备份89文件7,636,392 bytes逐一SHA-256核验；包含队友原dirty结果。
未commit/push/创建PR/合并main；新分支不跟踪origin/main。

- 以remote为基础逐处修复，没有整文件覆盖旧本地RTL。保留队友初始化/AD、
  整块ciphertext吸收、尾块64-bit state masking/padding、P8/P12/finalization、
  full tag diff与计算tag输出；P8/P12和原队友TB逐字节未改。
- Decrypt原15端口名字/方向/宽度/顺序保持不变，无mlen/error/result新端口。
  done && correct读取接受请求的clen；认证前/失败m=0、correct=0。
  修reset/start未撤销旧认证/候选、完成后清候选；超长用correct=0拒绝。
  Encrypt追加error，所有现有具名调用兼容；整个AEAD加include guard。
- 原remote首请求busy时m/correct为X实测vvp exit1；原TBinclude+显式source编译
  exit6。首轮guard漏get_bytes编译exit2，失败全部保留，修源后重新完整回归。
- 新worktree新vector/新source：官方KAT289/289加密和解密，补充11/11；
  Encrypt311有效/控制调用、Decrypt310、篡改拒绝2,579、每方向超长拒绝735，
  全部0 FAIL；round264、P8/P12各28state比较PASS。接口具名/位置调用逐拍一致。
- 所有四个production.v编译exit0，10module无重复，全源加解密仿真exit0，
  原队友TB5组PASS。故障注入4/4，三个功能故障vvp exit1、坏向量runner exit1。
  参考全1,089 KAT gate12,936/0；软件四backend本worktree重跑28,661/0。
- 新证据rtl_integration_regression.\*、rtl_integration_harness.json、
  host_integration_validation.\*，记录0a425f9+实际dirty source/TB/scripts hashes，
  不是旧7139a80结果复用。工具版本/命令/退出码及保护说明见最新解密整合报告。
- 最终integration_review.json核验当前源码/验证源哈希、原28dirty和89备份未变，
  远程main仍0a425f9、diff --check exit0；暂存/提交/推送/PR为0。

V05整合子项done；C03 target仍in_progress，I03/I04/I05不因独立AEAD提升验收。
当前可供用户审查后commit/push功能分支并申请PR。本轮无Ascon仿真功能阻塞；
多块RTL、CPU/板级、Vivado、cycles/PPA仍未验证或not_measured。
下一接收B02/B04/V01/TBD→target KAT/mcycle→C04/I01/I02。下节保留先前本地历史。

## 2026-10-09 — V05/C03 standalone Ascon RTL 解密与生产全源集收口

owner TBD；基点7139a80，复用cleanup/remove-legacy-ascon-aead分支。
初始未提交rtl_regression.json/.log保留，新增rtl_decrypt_regression.*作为默认输出。
未commit/push/merge；CPU/Vivado/PYNQ/软件/锁定参考均未修改。

- 源码事实：crypto_aead_decrypt仍为空壳；35acd6a是C软件修复。
  本轮补齐RTL独立解密、完整tag认证与失败输出保护。encrypt新增error，
  加解密均拒绝物理总线不能承载的17..31-byte长度。
- before：permutation/encrypt/full-source compile PASS；runner因已删除legacy
  源路径exit1，保存rtl_decrypt_before.*。原encrypt实测17-byte请求正常done，
  长度probe simulation exit1，rtl_length_before.json保留真实失败。
- Icarus/vvp12.0：round264基础state比较PASS；P8/P12各22基础+6控制比较PASS；
  四个production.v全root编译exit0，10个module无重复；全源加解密仿真exit0。
- 官方RTL KAT：PT/AD各0..16的全部289组加密/解密均PASS，0失败；11组peer/尾零
  补充输入亦PASS。独立decrypt使用锁定expected C||T，不以encrypt反向自证。
  其余800官方组超出接口未运行RTL；完整1,089组C/Python reference gate
  12,936 PASS，软件四backend重跑28,661 PASS / 0 FAIL，均exit0。
- encrypt311有效调用；decrypt310有效调用、2,579篡改拒绝；加解密各735超长
  参数组合拒绝。每拍检查解密认证前m/mlen/result为0，失败当拍及之后仍为0。
  空/短/8与16边界/尾零、连续调用、busy-start忽略、reset中断/重新调用通过。
- RTL故障注入4/4：错误tag接受、错误明文、提前发布分别触发vvp exit1；
  损坏向量触发runner exit1。host harness 5/5通过。最终各入口exit0。
- 接口：rst_n同步低有效；start一拍；key/nonce/tag保持至done；显式length。
  decrypt新增c/tag/ad/clen/adlen与128-bit m/mlen/result/done/busy/error。
  完整契约、命令/版本/退出码/哈希与未测边界见
  docs/ascon_rtl_decrypt_validation.md、src/rtl/ascon/readme.md与results JSON/log。

看板：C01 done，C03 in_progress（target待验），新增V05 done；I03/I04真正ISE
保持todo。独立AEAD可以交付算法验证基础，但I05前置B02/V01和I02/I03仍未满足。
下一接收B02/B04/V01/TBD：CPU baseline与目标软件KAT/mcycle sanity，再C04/I01/I02。
阻塞：baseline/Vivado/固件依赖/板卡核验与CPU ISE未完成；当前Ascon仿真无功能阻塞。
Vivado综合/实现、CPU/板上、硬件cycles/speedup/PPA仍not_measured，多块RTL不支持。

## 2026-10-07 — 独立 RTL regression 提交收口

owner TBD；用户授权在 feat/ascon-kat-validation 创建
`test(ascon): add independent RTL regression`，不 push/merge。
审计原待提交 11 文件合计 190,057 bytes，最大 85,773 bytes；无重复大文件、缓存、
编译物或硬编码运行路径。结果中的绝对路径仅为实际命令证据，正式入口动态定位。
生产源/验证源与结果 hash 匹配，锁定来源/许可证完整；ignored pycache/vvp/so 不纳入。
暂存检查发现 Windows 报告换行问题，已修 runner 源输出为 LF 并重新生成/复验，
生产 RTL 不变。isolated PASS、旧接口 exit 2/full source exit 6 的 FAIL 原样保留，
整体 gate 未关闭；下一接收 RTL owner/TBD。

## 2026-10-07 — 同步最新 RTL 与独立回归追加

- owner TBD；用户授权 checkpoint/rebase。原 cba792c checkpoint 已无冲突 rebase 到
  origin/main `13d954f0755c2ec09290443e341cd5fb910fbf21`，新 checkpoint 为
  `a1d19dd7cd26da7d036d9b5612fb27f3cbf25680`。未 push/merge main；本地 main 未移动。
- 独立 C/Python 完整 KAT gate 重跑 12,936 PASS，队友五组 expected CT/tag 5/5
  与锁定 Final reference 一致；原始向量出处未记录，不能从 TB PASS 推断来源。
- Icarus/vvp 12.0：round/P8/P12 PASS，308 冻结基础用例及连续调用/reset/restart；
  新 isolated encryption 60 固定输入+9 控制请求 PASS（69 次 CT/tag 比较）。
  覆盖 mlen/adlen={0,1,7,8,9,15,16} 矩阵与尾零，没有伪造17-byte运行。
- 旧 AEAD isolated compile FAIL exit 2（reset/rst_n）；全部生产 .v compile FAIL
  exit 6（三个重复 module）。runner 整体 exit 1；isolated PASS 不等于可集成。
- decrypt=not_implemented。新 m/ad 各128 bits，目前能力上限各16 bytes。
  key 未锁存，须稳定到完成；busy-start 策略不一致、无效 c 位/empty 旧数据等
  观察与建议见 docs/ascon_rtl_regression_audit.md。

证据 `data/ascon/results/rtl_regression.json/.log`；新增入口及自己的 TB 在 sim/ascon。
生产 RTL 与 origin/main 相同，队友 TB 未修改。新回归/日志保留未提交，除授权
checkpoint 无新增 commit。看板仍不改；交接 RTL owner/TBD 修重复/接口后 I04 复验。
未做 Vivado/CPU/板级/PUF/PYNQ；硬件 cycles/PPA not_measured。

## 2026-10-07 — C01/C03 Final 标准与 host KAT 证据追加

本段为当前证据；下方 2026-09-21 表格保留历史快照。owner TBD。
初始 clean，main 从 ab458e5 fast-forward 到
`8c8634f80f55cff50ae1ffcaf6fb79d67e5a7a93`，含当天 `01 << (8*n)` padding 恢复。
创建 `feat/ascon-kat-validation`，本轮未 commit/push。

- C01：Final PDF、C/Python 固定 commit、许可与 18 文件哈希、独立完整上游 KAT
  已锁定；对照见 `docs/ascon_standard_baseline.md`。建议 done，待用户确认；看板未改。
- C02：现有 host C/Python AEAD 与 Final KAT 一致，WSL GCC 13.3 编译 C 通过。
  仍 in_progress：目标固件未编译/运行；C bad-tag 返回 -1 但留下明文和 mlen，
  failure contract 实测 exit 1。测试 adapter 丢弃输出不等于生产 API 已修复。
- C03：1,089 完整上游 KAT、64 补充 AEAD、308 permutation golden、16 短 tag 长度。
  四 backend 共 28,661 PASS / 0 FAIL，exit 0；harness 5 tests PASS。
  框架/host 子项完成，整体建议 in_progress，待 C02 前置与失败输出契约收口。
- reference gate 12,936 PASS；冻结数据重生成 byte-identical。真实 FAIL 与一次
  runner 共享库冲突原日志保存 `data/ascon/results/`；冲突已隔离构建并复验通过。
- 当前 RTL 已含完整 round、P8/P12 和 AEAD 草稿，09-21 的“只有 ror”是历史状态。
  本轮只记录长度推断/start 未接/输出截断/packed 数据推进/decrypt 空壳等问题，
  没有修改或仿真现有软件/RTL/CPU/Vivado；不能据此提升 Ixx 完成度。

证据：`data/ascon/provenance.json`、`results/host_validation.*`、
`results/failure_contract.*`、`results/audit_snapshot.json`；入口 `sim/ascon/readme.md`。
新增接口仅为独立 golden JSON/656-bit memory/CLI，生产接口未改。
硬件 cycles/PPA/RTL 功能 not_measured；接收 C02/C03/TBD，再 C04→I01/I02。

截至：2026-09-21，含 ZIP 恢复及 repository foundation 收口。owner 全 TBD；原 rename/生成元数据清理已在 fe66fd8；恢复资产已在 fc9147785cc4490b1673a0b86e16f337f256f122 本地提交。本文件随独立 foundation 文档提交保存；本轮未 push、未 merge main。初始审计基点仍为 e35d42f，不能将其误作当前开发分支 HEAD。

| 任务 / 范围 | 实际结果 | 证据 | 状态 / 局限 |
|---|---|---|---|
| B01 / D00 | 初始仓库审计、协作骨架已完成；现补充归档审计与结论更正 | 历史审计/恢复记录（已隔离） | done；审计不是功能验收 |
| B02 | Rebuild and verify recovered XC7Z020 CICC baseline；原始 XC7Z020 XPR、31 RTL/header、3 XCI、XDC/COE 恢复；活动文件引用闭合；Kintex 保留 | board/vivado_zynq7000_xc7z020_baseline；manifest 双哈希 | in_progress；未运行 Vivado/IP 再生成/综合/实现 |
| B03 | 原始 target xc7z020clg400-1、PLL 50→100 MHz、128 KiB BRAM 配置已知 | 原 XPR/XCI/XDC 与恢复审计 | blocked；target part 已确认，physical board model pending；revision/引脚适用性/PYNQ image 未核验 |
| B04 | CoreMark RV32/RV64、FreeRTOS应用、ISA源与构建输入共465文件的恢复记录 | archive/history中的original_cpu资产 | blocked；准确kernel/bootloader源未闭合 |
| V01 | 原始RTL top elaboration、tb_bypass7项与tb_regfile15项通过 | 归档中的original_cpu恢复验证记录 | in_progress；原宽范围验收未关闭 |
| 历史硬件输出 | ZIP 有 bitstream、综合/实现成功日志；100 MHz 下 WNS 0.056 ns；placed LUT 4806 / FF 3129 / BRAM 38.5 / DSP 4 | 精选 6 个报告/日志与 archive_inventory | historical_archive_evidence；有未设 IO delay，非本轮重建或实测 |
| RTL比较 | 当时31共有文件：14字节同、17仅换行差异；两个Ascon helper仅在仓库 | 历史RTL比较（已隔离） | 未据换行差异选择更新版本 |
| C02 | 既有 Ascon C/Python 保留 | ascon/ | in_progress；未移植或运行最终标准 KAT |
| C01/C03/C04 | 无锁定的最终标准 KAT 及板上 benchmark | 尚无相关结果 | todo；Ascon cycles/code size 均 not_measured |
| Ixx | Ascon RTL 仍只有 ror/load_bytes/store_bytes | src/rtl/ascon/ | I01-I08 todo |
| D01 / Yxx / Sxx | 当前/目标架构与待定接口已记录；PS/PYNQ/Skill 实现未开始 | docs/architecture.md、docs/interfaces.md | D01 in_progress，其余按任务表 |
| Pxx | 未开展 PUF/启动认证 | tasks/task_board.md | gated |

## 验证边界与当前阻塞

579 个恢复资产的 SHA-256 核验通过；两套 XPR/XDC、当前 RTL 与 Ascon 保持原字节。Kintex 经 git mv 归并，旧生成元数据两项已清理。文件名还原脚本成功在 ignored build/local 生成隔离工作副本；不执行原包中的安装或清理脚本。

没有运行 Vivado/Vitis、固件编译、完整 ISA、JasperGold、软件 KAT、板上测试或 PYNQ。两个模块仿真与历史 Vivado 报告分开记录。PATH 未发现相关构建工具不等于全盘无安装。

下一步：B02 重建真实 baseline；B03 核板；B04 取得准确 kernel/bootloader 来源、核验入口并适配旧测试层次；C01 锁定标准 reference/KAT。Git HEAD 缺资料用 not_in_current_repo；ZIP 已提供的资料用 available_in_archive / recovered_uncommitted，不再写成 not_available。

首次审计曾复现 top_pl_bram 缺三个 IP module 的 Icarus 报错；该历史结果保留在 repository_audit。如今 XCI 已恢复，但 XCI 不是 Icarus 可直接编译的 Verilog 模型，仍需 Vivado 生成对应产物。

foundation 收口的 579 资产分类：A source 485、B build/config input 85、C test/reference data 3、D historical evidence 6。最终 board 仅两个工程，未改 RTL、未跑 Ascon。提交准备与 Git 检查见 [收口检查](../docs/repository_foundation_closeout.md)。

## 2026-10-07 — C02 production C 认证失败输出收口

owner TBD；基线 `origin/feat/ascon-kat-validation` 的
`c34728558469f0d4e4068730801dea59e0ca2100`；分支
`fix/ascon-c-auth-failure`。本节不修改任务看板。

| 项 | 本轮真实结果 | 状态建议 |
|---|---|---|
| 原问题 | bad tag 返回 -1，但 mlen=17、buffer=原明文；原门禁 1 PASS/1 FAIL/exit 1 | 失败证据保留 |
| 扩展 raw 门禁修复前 | 15,039 PASS / 8,926 FAIL / exit 1；包括短输入保留 stale mlen | 失败证据保留 |
| production C 最小修复 | 仅 decrypt：失败清零已知候选区域并设 mlen=0；短输入仅设 mlen=0；完整 tag XOR/OR 比较保留 | host 子项关闭 |
| 修复后 raw 门禁 | 23,965 PASS / 0 FAIL / exit 0；直接读完整 buffer，检查两侧 canary | C03 软件失败输出子项 PASS |
| 四 backend host validation | 修改前后均 28,661 PASS / 0 FAIL / exit 0 | Final 固定 KAT 无回归 |
| harness/golden | 5 tests PASS / exit 0 | 错输出/假接受/hash 故障确实非零退出 |
| 加密不变 | 1,153 固定 AEAD 输入输出拼接 SHA256 修改前后一致 | encryption 无改动 |
| C01 | 锁定来源、标准、许可、KAT/hash 与软件证据已可用 | 可评审 done |
| C02 | host API 安全契约已收口；target build/port 与 B04 仍未验 | 保持 in_progress，不能 done |
| C03 | 软件验证全部 PASS；target/整体前置未验收 | 不自行 done |

实际命令、编译器/源文件哈希、前后 raw 示例、原始日志与限制见
[C API 与修复记录](../ascon/ascon_c/aead/readme.md) 和 `data/ascon/results/`。
锁定 reference、固定 expected、Python、生产 RTL/CPU/Vivado 均未修改。
目标固件、上板、cycles/PPA、buffer overlap/异常指针/超大长度与全面 timing proof
未验证或 not_measured。下一接收：C02 target/B04 → C03 target KAT → C04 real
mcycle，owner TBD；RTL integration/decrypt blocker 仍由 RTL owner 处理。

## 2026-10-20 — 100 MHz 时序工作台站点（仓库外）+ 两处证据性发现

owner TBD。用户要求：不做 RTL 优化（由用户自己动手），改为把 CPU 逐块拆解、给出当前实测标定、
把已做过的时序优化步骤连同判定放到一个可复核的网站上。站点落在仓库外
`../html/`（`C:/wenjian/game/FPGA2026/ours/html/`），**未修改 src/rtl、未改 board 工程/XDC、
未 commit**。被用户确认的口径：以 control（HEAD 3c6f134，+0.007）为“当前”，
14164 条路径 CSV 标注为 −0.136 探针快照（偏悲观 0.143 ns）。

- 新增（仓库外）：8 个静态页面 + `assets/{style.css,data_static.js,data_probe.js,app.js}`
  + `trace/`（定向程序、TB、轨迹 CSV/JSON）+ `probe/`（只读探针脚本与输出）+ `check_pages.js`。
- 新增实测（只读）：`probe/per_module_paths_detail.tcl` 打开最终 routed DCP
  （`bce_timing_control/.../top_pl_bram_postroute_physopt.dcp`），对 26 个模块与 15 个路径族
  各取最差一条，输出 slack / DATAPATH_DELAY / DATAPATH_LOGIC_DELAY / DATAPATH_NET_DELAY /
  LOGIC_LEVELS / 单元构成 → `probe/module_paths_detail.csv`。未 launch run、未改工程。
- 新增实测（仿真）：`trace/tb_trace.v` 在 soc_top @50 MHz 上跑 41 条定向指令，
  每拍采样 41 个信号（pc/有效位/stall/flush/两个 cache 状态机/多周期握手/isE）
  → `trace/trace.csv`（231 拍）。据此把逐拍流水做成可点选的 10 个场景。
- 站点数据交叉核对：模块级族条数与 `paths_lt_2p0.csv` 重算一致（id_ex 内部 315 / →dcache 289 /
  →if_id 165 / →icache 148 / pc→ise 647 / dcache→mmio 8858）。
- 发现 1（文档错误，已写入站点）：`docs/cpu_timing_architecture_plan.md` §5.0 表把
  “−0.643 / 649” 标成 B+E-v2；实测那是 `rtl_E2` 单独结果，B+E（rtl_patched）是
  −0.723 / TNS −93.442 / 502 端点。不影响“B/E 均回滚”的结论。
- 发现 2（功能/计数口径，未修）：多周期指令（mul/div）执行期间 `id_ex_inst_valid = 0`
  （trace cycle 61–63、64–97），原因是此前 icache miss 的 `flush[2]` 清零 `inst_valid`，
  而 `id_ex` 的 flush 分支不清 `pc_o/rs1_o/rs2_o`，随后 stall 分支把 0 保持。
  `cpi_cnt` 与 `probe_inst_valid` 依赖它 → 指令计数偏小、CPI 偏大，影响既有 cpb 数字口径。
  未改 RTL，仅记录；建议单独立项核（接收：RTL owner / TBD）。
- 验证：`node html/check_pages.js` 8 页脚本全部无异常；Chrome headless 渲染 8 页人工核对布局；
  轨迹与探针均在本机重跑通过（Vivado 2025.2 / Icarus 14.0 devel）。
- 未验证 / not_measured：板级 XDC（IO delay/PS7）后的时序；80 MHz 改频后的实现结果；
  上板 cycles；每类 stall 占比；p12 单独实测周期（现为按 p8 折算，站点已标注）。
- 下一接收：用户按站点 `next.html` 自选路线（A/D/C/F/R）；站点不改 RTL，只提供标定与判定依据。

## 2026-10-21 — 后端战役：控制锥复制 + 依赖驱动 floorplan + 疏松布局（夜间 33 臂）

owner TBD；起点网表 `acb_remap/top_pl_bram_opt.dcp`（HEAD `3c6f134` 生产策略 +0.007 的
post-opt 快照）。**未修改 `src/rtl`、`board/`、baseline XDC 与工程；未 commit**
（`git status` 仅新增 `build/backend_opt_20261021/`、`build/reports/backend_opt_20261021/`
与 `docs/backend_placement_campaign.md`）。用户要求：复制同义寄存器本地化控制锥、
按依赖强度摆模块、布局尽量疏松、从后端而非 RTL 找余量。

| 项 | 本轮真实结果 | 状态 |
|---|---|---|
| 实验装置 | `run_variant.tcl` + `run_wave.sh`（每臂独占目录）+ `floorplan.py` + `dep_analysis.py` + `summarize.py` + `fanout_compare.py` + `probe_*.tcl` | 可用，可复现 |
| 臂数 | 35（8 个波次，含 2 个重复对照臂） | 覆盖复制/floorplan/疏松/放置与布线 cost model |
| 最好一档 | `pl_ndh_crit200_ntr`：WNS **+0.138** / TNS 0 / 失败 0 / WHS **+0.017** / Slice LUT 11690 / Slice Reg 16042（生产参考 11752/16040）/ 0 布线错误 | 重复臂逐位相同 |
| 生产指令锚点 | `prod_place`（opt Explore/place Explore/phys_opt Explore/prout ExploreWithHoldFix）= **+0.016**，与既有 +0.007/+0.016 同级 | 说明本 harness 与生产可比 |
| 全局复制 | `rep128/256/512` = −0.074 / −0.188 / −0.295；`rep256_nofrn` 与 `ctl` **逐位相同**；`rep256_noeq` = −0.398 | 复制确实发生（9650/3989/1280/661/457 pin 网络全部跌破 256 pin），但**不推动时序墙** |
| 定向复制 | 只复制最差 N 条路径的 CE 锥（Slice Reg 仅 +9）：N=20/60/120/200 → +0.030/+0.068/−0.039/+0.074（加 NoTimingRelaxation 后 −0.154/+0.117/+0.138/+0.003） | 非单调，量级与一次布局重抽同阶 |
| floorplan | fp2 +0.007、fp3 +0.017、fpc −0.065、fp3_prod −0.061、fp3_ndh −0.228；pblock 确实被遵守（pb_cpu 仅 275/10404 单元被 phys_opt 溢出到区间外） | 生效但无稳定收益 |
| 疏松 | `place_design` 无 `-place_density`；pblock `PLACE_DENSITY` 在 2025.2 不存在（`fp3_loose` 因此失效，脚本已改 catch 保护）；`AltSpreadLogic_medium/low` = +0.002 / −0.027 | 器件 22% 占用本来就松，人为散开无益 |
| 时序墙分布 | `ctl` <0.2=179 / <0.3=319；`prod_place` 127/278；**冠军 7/44** | 唯一真实收益：接近临界端点数量下降 10 倍 |
| 最差路径构成 | `ctl` dp 9.979 / logic 2.882 / net 7.097 / lv 11 → 冠军 9.502 / 3.193 / 6.309 / lv 11 | 累计走线 −0.79 ns，逻辑 +0.31 ns |
| 未验证 / not_measured | 功能回归（`src/rtl` 未改，变换为 Vivado 等价实现变换，但未跑 KAT）；板级 XDC + PS7 在场后的时序；bitstream 与上板；80/90 MHz 改频后的实现 | 不宣称 |

结论：**纯后端手段无法把这道墙抬到 +1.0 ns**。35 个臂的 WNS 区间 −0.514 ~ +0.138，
最好一档已达 0 失败端点、0 布线错误，但只有周期的 1.4%；真正改善的是脆弱性
（<0.2 ns 端点 127→7）。要余量仍是降频（90 MHz 折算 ≈ +1.11 ns）或 RTL 深度削减。
完整表格、机制证据与复现命令见
[backend_placement_campaign.md](../docs/backend_placement_campaign.md)。
下一接收：决定是否把 `pl_ndh_crit200_ntr` 做成 baseline 工程的独立 impl 入口并跑全套回归，
或按 80/90 MHz 收口；owner TBD。

## 2026-10-21 — 布局布线可视化（真实 SITE 坐标 + 逐跳延迟）

owner TBD。用户要求：在站点里加一张能看出"当前布局布线是什么情况"的图，每个模块有对应的线，
并把每一条最坏路径画出来。站点仍在仓库外 `../html/`，**未改 src/rtl、未改工程/XDC、未 commit**。

- 新增只读探针 `html/probe/floorplan_probe.tcl`：打开 `bce_timing_control/.../top_pl_bram_postroute_physopt.dcp`，
  输出 ① 器件栅格（max_x=113 / max_y=149，BRAM 列 X0–X5、DSP 列 X0–X4）
  ② 22 个模块的 placed bbox + 质心 + 模块内 BRAM/DSP 数（`fp_modules.csv`）
  ③ 12 条最差路径 + 15 个路径族的 `full_clock_expanded` 报告（`fp_paths/*.rpt`）。
  新增 `parse_floorplan.py` 把报告里的 Location 列解析成 (x, y, 本跳 ns, 累计 ns) 的折线 → `assets/data_layout.js`。
- 新增页面 `html/layout.html`：楼层图（SVG）+ 单路径/模块分布/模块互联三种模式 + 跳数表。
- 实测发现（新）：
  1. dcache 的 8 个数据 BRAM 在 **RAMB18_X4Y0…X5Y5**（芯片最左 BRAM 列），而 dcache 逻辑在 X35–X106；
     最差路径 #1/#2/#3 的终点就是 `RAMB18_X5Y4`，最后一跳从 `SLICE_X98Y16` 横跨 93 列。
  2. `dcache.bus_addr_r → ascon_mmio MSG_BUF` 那族有一跳 **跨 90 格 / 3.09 ns**（Y22 → Y104）：
     MMIO 缓冲被放在芯片下半部，与数据通路相距 80+ 行。这条解释了 8858 条路径为何都在 7.7 ns 走线上。
  3. 最差 #1 的 11 跳全在 X64–X98 / Y4–Y20 的局部区域内绕（曼哈顿 166 格），
     说明"先在局部绕一圈、最后再横跨整块芯片"是本设计的典型形状。
- 修正一处探针自身缺陷：`LOC` 正则原先写成 `^[A-Z]+_X…`，会把 `RAMB18_X4Y2`/`DSP48_X1Y3` 全部漏掉，
  导致模块 bbox 不含 BRAM（dcache 被算成 X35..106 而不是 X4..106）。已改为 `[A-Z]+[0-9]*`。
- 验证：`node html/check_pages.js` 9 页全通过；Chrome headless 渲染 9 页人工核对；
  三种模式各截图核对（`preview_layout*.png`）。
- 未验证：路径折线是按 report_timing 的元素顺序连线，**不是布线资源的逐段走线**（Vivado 文本报告不含 PIP 级路径）；
  因此图中线段表示"逻辑单元之间的顺序与距离"，真实走线拓扑仍是 not_measured。

### 追加（同日）— 布局图支持图层开关与自动聚焦

用户要求：图不能只是"全部画出来"，要能取消一部分，让剩下的部分居中放大显示。已改为三栏：
左侧模块图层（22 个勾选框 + 只看 CPU / 只看 Ascon / 全关 预设）、中间楼层图（滚轮缩放、拖动平移、
点模块框压到该 bbox、「全屏看图」收起两侧栏）、右侧路径信息与逐跳表。
`fitView()` 按「可见模块 bbox ∪ 可见路径 bbox」计算 viewBox 并保持器件比例，所以取消图层后视图自动
缩放到剩余部分；路径图层支持多选叠加（非当前路径画虚线）。URL 参数 `?p=` / `?preset=` / `?hide=`
可复现任意视图。文件：`../html/layout.html`（未改 RTL/工程，未 commit）。

### 2026-10-21 补测 — WHS 侧 5 个 post-route 修复臂（全部空操作）

从冠军 `pl_ndh_crit200_ntr_routed.dcp` 起，只做布线后修复、不重布局（`run_holdfix.tcl`）：

| 臂 | 动作 | WNS | WHS | Δ |
|---|---|---|---|---|
| hf_explore | `-directive ExploreWithHoldFix` | +0.138 | +0.017 | 0.000 / 0.000 |
| hf_aggr | `-directive ExploreWithAggressiveHoldFix` | +0.138 | +0.017 | 0.000 / 0.000 |
| hf_aggr_both | 上 + `-aggressive_hold_fix` | +0.138 | +0.017 | 0.000 / 0.000 |
| hf_clock | `-clock_opt` | +0.138 | +0.017 | 0.000 / 0.000 |
| hf_clock_hold | `-clock_opt` + `-aggressive_hold_fix` | +0.138 | +0.017 | 0.000 / 0.000 |

结论：WHS 为正时 hold 修复指令无事可做（help 只对 "hold violators" 生效），LUT 数也不变。
hold 薄的结构原因是 Ascon 核内 0\~1 级逻辑的相邻寄存器对（数据 0.30\~0.44 ns，最差
`p12_inst/s_out_reg[315] → u_crypto_aead/s4_reg[59]`，靠 +0.271 ns 时钟偏斜撑到 +0.017）。
35 臂统计 `corr(WNS,WHS) = −0.516`，WHS ≥ +0.05 的 7 个臂 WNS 全部 ≤ −0.102（setup 违例），
官方生产也只有 +0.023/+0.031 → 建议把 hold 门限改为 "hold 失败端点 = 0 且 WHS > 0"。
证据：`build/reports/backend_opt_20261021/hf_*/`，说明见 `docs/backend_placement_campaign.md` §4.7。

### 追加（同日）— 新 run 的自动接入管线（等 campaign 结束后生效）

用户要求"等完成后接入数据"。已建成并**用同一网表自测过**（Δ 全为 ±0）：
`intake_run.sh <dcp> <tag>` = 只读探针（探针已参数化，可对任意 routed DCP 取模块 bbox + 27 条路径的逐跳 SITE）
→ `parse_floorplan.py --tag` → `assets/data_layout_<tag>.js` → `update_manifest.py`（从 campaign 的 `RESULT` 行取 WNS）。
`layout.html` 新增「对比基准」下拉：base 画灰虚线、新布局画彩线，右侧给出 slack/data/logic/route/hops/
曼哈顿/峰值单跳的 Δ 表；`experiments.html` 增加「后端 campaign（自动接入）」表。
并发保护：`intake_run.sh` 检测到 `vivado.exe` 在跑即拒绝执行（`--force` 才跳过）。
已挂后台等待器 `watch_campaign.sh 6`：等 `vivado.exe` 全部退出 + 90 s 冷却后，自动接入
`build/local/backend_opt_20261021/` 下新建的 checkpoint（日志 `html/probe/watcher.log`），最多 6 个。
当前 campaign 仍在跑（`vivado.exe` PID 40068，最新 checkpoint 11:16），故站点数字仍为 10-20 21:37 的基线。

### 2026-10-21 补测 2 — 用 pblock 把 hold 关键寄存器对拉开（2 臂）

`floorplan_hold.py`：把 `u_crypto_aead/p12_inst`（1628 cells / 646 FF）从
`u_ascon_mmio` 切出去单独一块，其余沿用冠军指令（place ExtraNetDelay_high、
crep 200、route NoTimingRelaxation）。

| 臂 | WNS | WHS | 失败端点 | 结论 |
|---|---|---|---|---|
| `hfp_split_near` | **−0.110** | **+0.032** | 73 | hold +0.015，setup −0.248 → 净亏 |
| `hfp_split`（远） | 未完成 | — | — | placer 卡在 Phase 4.1.1.2 超 30 min，已终止 |

切分后最差 hold 路径从 `p12_inst/s_out → s4`（0.381 ns）换成
`p8_inst/s_reg_reg[109]`（0.389 ns）、`nonce_r_reg[47]`（0.375 ns）等 ——
WHS 由一整群 0~1 级逻辑的寄存器对决定，不是单点。**结论：WHS 是结构量，
不建议再花时间；把 hold 门限改为"失败端点 = 0 且 WHS > 0"。**

### 追加（同日）— campaign 结束，接入两版并与基线逐跳对比

等 `vivado.exe` 全部退出后，等待器自动接入 `hfp_split_near`（12:07），随后按 `results.tsv` 的最优行补接
`pl_ndh_crit200_ntr_dup`（12:1x）。站点现有 3 个数据集（base + 2 个 run），`experiments.html` 增加 campaign 表
（58 次运行 / 36 个有 RESULT）。

- 实测对比（同类路径按「起点寄存器 + 终点模块/引脚」匹配）：
  - `pl_ndh_crit200_ntr_dup` WNS +0.138：原 #1（`w_reg_waddr_o_reg → dcache DIADI`）从 +0.007 → **+0.538**，
    逻辑级数 10→8、route 8.01→7.73、曼哈顿 166→141；`multiplier → dcache` +0.088→+0.934（级数 19→17）；
    `pc → ex_mem/CE` +0.101→+0.916。唯一倒退是 `dcache.bus_addr_r → mmio/CE` +0.525→+0.345，
    原因是**时钟偏斜**从 −0.024 恶化到 −0.252（数据路径本身 9.152→9.103 是变好的）。
  - `hfp_split_near` WNS −0.110：`sel_ex_mem_rs2 → dcache DIADI` 逻辑级数 16→7（logic 3.24→1.32），
    但 route 6.17→8.30、沙盘曼哈顿 174→53 → 净 −0.29。**曼哈顿↓ ≠ route↓**：pblock `pb_hf_rest`
    把 239 个 hop 收进一块，距离短了但绕线/拥塞变重。
- 修复两处会产出假数据的问题：① `worstN` 名次不可跨网表对比 → 改身份匹配；② 带 PBlock 列的
  `report_timing` 使旧列解析整行失败 → 改 token 解析并记录 pblock。
- 未验证：这些数字仍是芯片级 STA（无板级 XDC/PS7）；campaign 里 22 次 EXIT=1 未接入；pblock 的拥塞结论是
  由 route vs 曼哈顿的背离推出的，未用 `report_design_analysis` 的拥塞指标交叉验证。

### 2026-10-21 12:30 · 时序工作台：campaign 数据全站刷新

- 对象：`C:\wenjian\game\FPGA2026\ours\html`（仓库外，纯静态）；未改 `src/rtl`、`board/`、XDC，未 commit。
- 新跑只读探针：`probe/per_module_paths_detail.tcl -tclargs <dcp> pl_ndh_crit200_ntr_dup`（最优版 +0.138），得到 21 个模块的进来/出去最差路径；与 control 版逐模块配对（`assets/data_probe2.js`）。
- 15 个路径族按**起点寄存器 + 终点模块/引脚**身份匹配（不是 worst1/2 名次），生成 `assets/data_families_cmp.js`：**14 族变好，1 族变差**。
- 关键归因：
  - 变好：`id_ex internal` +0.285、`waddr→dcache` +0.531（级数 10→8）、`mult→dcache` +0.846、`pc→ex_mem` +0.815。
  - 变差：`dcache bus_addr_r → ascon_mmio/CE` +0.525→+0.345。数据路径 9.152→9.103（更快 0.049），**clock skew −0.024→−0.252**（DCD −1.675→−2.146）；同时 `u_crypto_aead` 进来 slack 也正好 −0.180 → 同一时钟路径改动带下两个端点。
  - `hfp_split_near`(−0.110)：`sel_ex_mem_rs2→dcache` 曼哈顿 174→53 格，route 6.17→8.30 ns → 距离↓不代表延迟↓（pblock 拥塞，未用 congestion 报告交叉验证）。
- campaign `results.tsv` 58 行重解析：**36 RESULT / 5 SMOKE(place-only，非失败) / 17 EXIT=1**（此前误报 22 次）。
- 17 次 EXIT=1 归因：**15 次为 Tcl 脚本错误**（`vspec` 的 `array set` 收到奇数元素，`run_variant.tcl:57`，启动 4 s 即退，5 份 backup 日志有相同 trace；另 10 次日志被后续成功 run 覆盖，只能判同类）；1 次 `fp3_loose` PLACE_DENSITY 非 pblock 属性（Netlist 29-177）；1 次 `hfp_split` 在 phys_opt Phase 4.1.1.2 被外部终止（无 ERROR/无 COMPLETE/无产物）。证据见 `html/probe/campaign_failures.md`。
- 站点：新增每页「数据版本条」+ `?v=20261021c` 缓存戳（解决"改动看不到"）；index/modules/paths/history/experiments/next 数据全部重算；`check_pages.js` 改为按页面真实 `<script src>` 加载（此前漏了 campaign.js/version.js，导致误报）。
- 验证：`node check_pages.js` → `ALL PAGES OK`（9 页）；截图核对 index/modules/paths/experiments/next。
- 未做：campaign 最优版的 WHS 未进 `results.tsv`（记 `not_measured`）；拥塞交叉验证未做；`src/rtl` 未动（用户自己改）。

### 2026-10-21 13:06 — 冠军网表出 bitstream（xc7z020clg400-1）

- `build/local/backend_opt_20261021/pl_ndh_crit200_ntr/pl_ndh_crit200_ntr.bit`
  （4,045,687 B，sha256 `6cff4f2f7443e68c38549ed8db2b8aed13259ba60c2d1b5adcff66c8614e4baa`），
  `.bin` 同时产出；Bitgen 自带 DRC 仅 warning，无 error。
- 出 bit 前复测 WNS +0.138 / WHS +0.017；引脚沿用 baseline `const.xdc`
  （clk=U18 假设 50 MHz、reset=N16、uart T19/J15、led H15/L15、button L14/K16）。
- **未验证**：板上任何现象（未烧录）；板型/时钟引脚未核实（`xc7z020` 是器件不是板型）；
  IO 无 delay 约束；BRAM 内是 baseline 的 `freertos_demo.coe`（8333 字），**不是 Ascon 固件**。
- 下一步（T0.2/T0.3）：`ascon_ise.hex` 32768 行 = 板级 BRAM 深度 32768 字（32×ramloop，
  32-bit 宽），可 1:1 转 COE → 换 `blk_mem_gen_0` → 重新 synth+impl → 新网表重测时序
  （+0.138 不保留）→ 再出 bit；另需板级自检固件与串口回归框架。

### 2026-10-24 16:40 · 布局布线双页 + 复制寄存器 + 时钟偏斜归因（站点）

- 起因：用户指出「布局图里看不到复制寄存器」。核查确认：`layout.html` 的 27 条路径全部来自 base run，ndh 只在对比模式里叠色；而**复制寄存器从来没有被画过**。
- 新页 `html/layout_ndh.html`：主图 = `pl_ndh_crit200_ntr_dup`，默认叠加 base 灰虚线；与 `layout.html` 双向跳转（导航栏「布局(最优版)」+ 页内按钮）。
- 新探针 `probe/replica_probe.tcl`（只读 DCP）：导出 replica 单元的 `REF_NAME/LOC/CLOCK_REGION` 与原单元坐标。结果：**base 5 个副本 / ndh 52 个副本**（ndh 的副本集中在 `*_BUF[*][31]_i_1` 这类使能译码 LUT，每个复制 2 份，覆盖 4 个 clock region）。
- base 的 5 个副本里包含 `clkout1_buf_replica` —— 即 **clk_out1 上串了两个 BUFG**（`clkout1_buf_replica → clkout1_buf`）；ndh 只剩一级。
- 时钟偏斜归因（回答用户提问，数据来自 `probe/fp_paths*/dcache_to_mmio.rpt` 的 Clock Path 段）：
  | 项 | base | ndh |
  |---|---|---|
  | BUFG(clk_out1) | 2 | 1 |
  | dcache `bus_addr_r` FF | SLICE_X81Y20 · X1Y0 | SLICE_X65Y21 · X1Y0 |
  | MMIO `MSG_BUF`（2048 FF） | SLICE_X45Y114 · **X0Y2** | SLICE_X36Y85 · **X0Y1** |
  | 全局时钟 net 到 dcache / MMIO | 1.723 / 1.699 | 1.718 / 1.466 |
  | SCD / DCD / CPR | −2.156 / −1.675 / −0.504 | −2.423 / −2.146 / −0.528 |
  | **skew** | **−0.024** | **−0.252** |
  | data path | 9.152 | 9.103 |

  → 结论：唯一倒退不是数据路径变差（快 0.049），而是 **MMIO 那 2048 个 FF 从 clock region X0Y2 搬到 X0Y1**，捕获时钟提前 0.233 ns，skew 由 −0.024 变 −0.252。同一搬动也解释了 `u_crypto_aead` 的 −0.180。
- 全站 16 条路径的 skew 分布：base −0.225…+0.052，ndh −0.252…+0.054 —— **离散步长几乎不变（0.28 vs 0.31 ns）**，变的是「哪条路径抽到下签」。所以设计的时钟树本来就带 ~0.25 ns 的落地差，WNS 只有 0.1 ns 余量时等于听天由命。
- 站点修正：Δ 列改为「本页 − 对比」；彩线恒为本页网表；路径列表标题与 Δ 表头改为动态 tag；`next.html` 的 ndh WHS 由 `not_measured` 更正为 **+0.017**（比基线 +0.023 更差）。
- 验证：`node check_pages.js` → 10 页 `ALL PAGES OK`；截图核对 layout / layout_ndh（含 ?preset=ascon）。
- 未做：`mult_to_dcache` 仍无直接探针值；拥塞交叉验证未做；RTL 未动。

### 2026-10-24 17:25 · next.html 路线实测：F（MMIO 写译码寄存化）+ R（80 MHz）

- 起因：用户要求按 `html/next.html` 的建议顺序（先 R 后 F）真跑一遍看效果。基线 `3c6f134`，
  `src/rtl/dcache.v`/`ascon_ise.v` sha256 与 2026-10-20 control 记录一致；`src/rtl`、`board/`、
  XDC 全部未改，变体都在 `build/local/tests_20261024/` 副本里。工具 Vivado 2025.2，
  part `xc7z020clg400-1`，top `top_pl_bram`。
- **F（补丁 `build/patches/timing_F_mmio_wdecode.patch`，只改 `ascon_mmio.v` +35 行，把写请求打一拍）**：
  - 100 MHz，ExploreWithRemap：WNS **+0.007 → −0.072**（TNS −1.289、**35 失败端点**），WHS +0.030，LUT +1.8%；
  - 100 MHz，ExplorePostRoutePhysOpt：WNS **+0.005 / 0 失败端点 / WHS +0.051**（对照第二策略 +0.001/2 端点）；
  - 目标族 `dcache/bus_addr_r → ascon_mmio`：**8858 → 60 条**（worst +0.525 → **+1.233**），
    MMIO 终点 <1.0 ns **1667 → 701**，全设计 slack<2.0 ns **14161 → 10245**；
  - 新墙 = A 族 `id_ex_u/sel_ex_mem_rs1_o_reg → u_dcache/valid_way*/D`（11 级 / logic 3.004 ns），
    与 next.html 预测一致 → **F 是清场，不是提余量；必须配 A**。
  - 仿真 6 场景（`build/local/tests_20261024/check_F.sh`）：7 项硬件 KAT 全 PASS、crypto latency 99 不变、
    软件 4 workload cycles 完全相同；**硬件 MMIO 全卸载 670 → 675 拍（+5）**，
    按 next.html 给 F 的"拍数不许变"门禁**不合格**。
- **R（80 MHz）关键纠正**：同一份未改 RTL，把核心约束改 12.5 ns **重跑综合+实现**只有
  **WNS +0.483**（0 失败端点、WHS +0.018）；原因是 P&R 按松约束松手——最差路径 route 9.167 ns
  （100 MHz 网表同类 ~7.6 ns），物理质量损失约 1.9 ns。站点"80 MHz +2.340 / 折算 +2.483"
  只对**已按 10 ns 布线**的网表成立。→ 正确做法：实现仍按 10 ns 过度约束，只改 MMCM 输出；
  验收用 post-route `reset_timing` + 12.5 ns 重算（`build/probe_freq_headroom.tcl`）。
  F 在 12.5 ns 下为 +0.456（比 control 的 +0.483 低 0.027，噪声带内）。
- WHS 在两种频率下都 <+0.05 门禁（+0.018~+0.051，只有 F+pr @100 MHz 的 +0.051 刚过）。
- 证据：`docs/timing_route_tests_20261024.md`、`build/reports/tests_20261024/{f_100,f_100_pr,ctl_80,f_80}/`、
  `build/local/tests_20261024/{paths_ctl.csv,paths_f100.csv,sim/*.log}`。
- 未做：C（store buffer）、A、D；板级 XDC/PS7 在场时序；MMCM 80 MHz 重生成网表 A/B；拥塞交叉验证。

### 2026-10-24 20:45 · 第二波：F+A（A 已在 RTL 里）+ F×后端配方

- 用户选定"F+A 合并测"。核实：**路线 A 描述改动已在 RTL 里**——旁路选择在 ID 段算
  （`cpu_core.v:373-386`，注释"在 ID 阶段提前计算旁路选择信号"）、ID/EX 边界寄存
  （`id_ex.v:183-186`）、EX 只用寄存位做 3 输入 mux（`bypass.v:25-40`）。
  → **F+A = F**，本波不新增 RTL 改动。
- F 之后真正的墙：`sel_*_o` 起点 1072 条 slack<2.0 路径，其中**只有 192 条压时序**
  （`dcache/valid_way0|1_reg` D 64+64 worst −0.072、`lru_reg` D 64 worst −0.063）；
  其余是 MMIO 缓冲区（worst +1.44~+1.87）。这 192 条来自 `dcache.v:471-505`
  「store 命中清另一路 / load miss 清 victim / hit 更新 LRU」必须同拍做 tag 比较，
  与 store 同拍写 BRAM 同源 → **只有 C（store buffer）或 tag 读打一拍能摘，A 摘不掉**。
- F + campaign 冠军配方（起点 F 的 post-opt dcp，脚本 `run_backend_F.tcl`）：
  - `F_pl_ndh_crit200_ntr`：WNS **−0.226** / TNS −9.028 / 102 端点 / WHS +0.015；
  - `F_pl_ndh_crit200_prod`：WNS **−0.225** / TNS −21.172 / 228 端点；
  - 对照：同配方打在未改 RTL 上是 +0.138。→ **campaign 收益不能迁移到 F**；
    可查原因：F 网表上 `crit_ce_nets` 只 13 条（最差 200 端点里 CE 网很少），
    而 F 的墙在 D 端，CE 复制打不到。
- 定向扇出复制臂（`run_selrep.tcl`，4 条 `sel_*_o` fo=172/141/172/140 + 309 条 forward 位网，
  MAX_FANOUT=8 + EQREG NO）与不做复制的 placeonly 臂**逐位相同**（−0.175 / 81 端点 / LUT 13799）；
  `probe_mf.tcl` 确认 `MAX_FANOUT=8` 写进去了但扇出仍 172、**没生成副本**——
  post-opt checkpoint 流程里 `MAX_FANOUT` 不触发复制，要复制得走
  `phys_opt_design -force_replication_on_nets`。**该臂是空实验，不作结论**。
- 顺手清理：这两臂因脚本 root 少了一层，把 `build/build/` 建进了仓库；报告已移到
  `build/reports/tests_20261024/F_pl_ndh_crit200_*`，DCP 移到 `build/local/tests_20261024/backend/`，
  仓库内无残留（`git status` 只剩新增 docs/与既有 untracked）。
- 净结论：F 不值得单独上（100 MHz 与 control 同级、80 MHz +0.456 vs +0.483、还要 +5 拍 MMIO）；
  F 的价值是暴露 C 要摘的那一族。要 100 MHz 余量只能做 C 或 tag 打拍；要立刻可交付
  用「control RTL + 10 ns 过度约束 + MMCM 80 MHz」。
- 证据：`docs/timing_route_tests_20261024.md` §7。

### 2026-10-24 21:25 · 路线 C（dcache store buffer）实测通过，0 周期

- 补丁 `build/patches/timing_C_dcache_store_buffer.patch`（只改 `src/rtl/dcache.v`，`git apply -p1` 干净）：
  ① store 当拍只进 1 项 buffer，下一拍提交；`data_way0/1` 改成真正的 SDP（Port A 只读，
  Port B 由 fill 与 buffer 提公共用，fill 优先）② valid/LRU 更新寄存一拍（`upd_*` 记录）
  ③ store→load 定向转发（`sb_valid && sb_addr == rd_addr` 按字节掩码覆盖）。
- **实现结果（Vivado 2025.2，xc7z020clg400-1，Performance_ExploreWithRemap，10 ns）**：
  | 变体 | WNS | TNS | 失败端点 | WHS | LUT | FF | BRAM |
  |---|---|---|---|---|---|---|---|
  | control（10-20 记录） | +0.007 | 0 | 0 | +0.023 | 11509 | 16040 | 38.5 |
  | **c_100（C）** | **+0.057** | 0 | **0** | +0.019 | 11476 | 16146 | **34.5** |
  | fc_100（F+C） | +0.005 | 0 | 0 | +0.013 | 11784 | 16189 | 34.5 |

  → C 是第一个既把目标族打穿、又在 100 MHz 上正收益的 RTL 改动；**F+C 不如 C 单独**（F 的 +202 LUT 纯负担）。
- **等价性两道**：① 全 SoC 6 场景（`check_C.sh`）KAT 全 PASS，cycles 与 control 完全相同
  （ise/ise_stall/ise_reset 2496、hw full MMIO **670** 与 latency 99 不变、sw 17353/21515/17847/22094 不变）；
  ② 新增 dcache 逐拍差分激励 `tb_dcache_trace.v`（伪随机 + 定向 store→load / store→store→load 同地址），
  4 个种子逐字节相同（含末尾存储器校验和）。
- **路径族证据**（`paths_c100.csv`）：`dcache/valid_way*|lru` 终点 192（control）→224（F）→**12（C）**，
  worst −0.072 → **+1.752**；`->u_dcache` 489→343（worst +0.249）；起点 `sel_*` 1218→505。
  C 之后最差单条变成 `pc_reg[5] → u_ex_mem/ex_rd_data_o_reg[0]/CE`（+0.057，9 级 logic 2.0 route 7.59），
  第二大族 `pc_reg[5] → u_ascon_ise` 649 条 worst +0.224 → **下一刀是 D（取指/stall 环），A 仍无事可做**。
- 未验证：板级；WHS +0.019 仍 <+0.05 门禁；C+campaign 冠军配方的叠加测试（21:07 启动，phy_opt 阶段长时间无输出，
  报告时未出结果 → not_measured）。
- 证据：`docs/timing_route_tests_20261024.md` §8、`build/reports/tests_20261024/{c_100,fc_100}/`、
  `build/local/tests_20261024/{rtl_C,rtl_FC,tb_dcache_trace.v,diff/}`。

### 2026-10-24 22:05 · 路线 C 落地到 src/rtl + 修掉队友 include 导致的 elaboration 失败

- `src/rtl/dcache.v` 应用 `build/patches/timing_C_dcache_store_buffer.patch`（1 项 store buffer +
  valid/LRU 更新寄存一拍 + store→load 定向转发）。落地后 sha256
  `79af461cf53545e79c294814e7f4869c341dbb745527885c0ee1755c1b5c1113`，与 `c_100` 实测那版**逐位相同**
  → WNS +0.057 / TNS 0 / 0 失败端点 / WHS +0.019 / LUT 11476 / FF 16146 / BRAM 34.5 这组数字对入库代码直接成立。
- 撤掉 `fb852b5` 在 `ascon/{ascon_mmio,ascon_ise,ascon_aead_core}.v` 顶部加的 `` `include ``：
  这三个文件无 include guard（同目录 `crypto_aead.v`/`ascon_permutation.v`/`ascon_round.v`/`ascon_word.v`
  都有），而它们同时作为独立源文件编译 → `'ascon_aead_core' has already been declared`，
  整库 elaboration 失败、回归跑不起来。撤掉后全 RTL elaboration 通过。
- 落地后回归：`build/local/tests_20261024/check_final.sh`（control = HEAD 的 dcache.v + 当前其余源
  vs 当前 `src/rtl`）6 场景，KAT 与 cycles 需逐条相同。
- 同步：main 上先提交了实测报告/补丁/报告归档（`431695b`），与 origin/main 的 `fb852b5` 做增量合并
  （`38e96fb`），已验证 5 个补丁合并后仍 `git apply --check` 干净。
- 未验证：板级 STA；C 之后 100 MHz 仍只有 +0.057 ns 芯片级余量（自定门禁 +1.0 未达），
  WHS +0.019 < +0.05 门禁。

### 2026-10-24 22:45 · 路线 D（中断可接受判决拆拍）实测 +0.087 ns 并落地

- 目标路径（C 之后整机最差 +0.057，9 级 / logic 2.0 / route 7.59）：
  `pc_reg → u_icache tag RAM → hit_way0 → icache_stall → csr_file/inter_req → flush[1] → u_ex_mem/CE`。
  根因在 `cpu_core.v` 的 `inter_accept_ready` 把 pc 衍生的 `!icache_stall` 和当拍快条件放同一个与门。
- 改法（补丁 `build/patches/timing_D_interrupt_guard_register.patch`，只改 `cpu_core.v`）：
  `inter_slow_ok = id_ex_inst_valid && !icache_stall` 只驱动一个触发器 `inter_slow_ok_q`，
  `inter_accept_ready` 当拍再与 `inter_slow_ok_q` + 全部快项（id_ex_inst_valid /
  dcache_stall / dmem_axi_stall_req / ex_stall_req / fence_i_stall）相与。`csr_file` 的一次脉冲语义未改。
- 实测（ExploreWithRemap / 10 ns）：WNS **+0.057 → +0.087**、TNS 0、0 失败端点、WHS +0.021、
  LUT 11483（+7）、FF 16156（+10）。
- **机制证据**（`paths_c100.csv` vs `paths_d100.csv`）：起点含 `pc` 的路径 **1389 → 1 条**
  （worst +0.057 → **+1.491**）；终点 `u_ascon_ise` +0.224 → +0.794；终点 `ex_rd_data_o_reg` +0.057 → +0.648。
- **D 之后新墙不再是 CPU**：`u_crypto_aead/FSM_sequential_state_reg[3] → u_crypto_aead/p12_in_reg[215]/D`
  （+0.087，**1 级逻辑**、route 9.290 = 94%）——Ascon 核心 p12_in 状态搬运的物理跨度问题。
- 等价性：全 SoC 6 场景（control = C 落地后 src/rtl，patched = C+D）KAT 全 PASS，
  cycles 逐条不变（2496 ×3、hw 99/670、sw 17353/21515/17847/22094）。
- **风险**：全部固件/单元/ISA TB 都没开中断（无 mtvec/mret/mie），所以本改动在功能上等价空操作；
  一旦启用中断必须先补定向 TB 验证"晚一拍接受"不会让 trap_pc 指向气泡。
- 落地：`src/rtl/cpu_core.v` 已应用补丁，与 `d_100` 实测所用 RTL 逐位相同。
- 当前 100 MHz 芯片级余量：**+0.087 ns**（基线 +0.007 → C +0.057 → C+D +0.087），WHS +0.021。

### 2026-10-24 23:05 · 队友提出的 RTL 纪律 skill 收入 `skill/`（只加文档，不动 RTL）

- 起因：队友 2026-10-17 指出 AI 写 Verilog 的通病（同一逻辑写出一堆等价废话、打补丁式改代码、
  电路层优化意识差、生成无必要的组合逻辑），据此形成的 skill 已落在 agent 侧
  `skills/verilog-design/rtl-design-discipline/SKILL.md`；本轮把同一份文件复制进仓库受控目录
  `skill/rtl-design-discipline/SKILL.md`（sha256 `ca5413cd…c7ed`，与 agent 侧逐字节相同，
  155 行），供队友与提交材料直接取用。
- `skill/readme.md` 改写为「已交付 / 预留」两段：写明依赖、输入输出、执行步骤、成功判据、
  失效条件、来源案例，并明确标注**非 Ascon 示例上的对照效果 not_validated**，
  据此不满足 S05 要求的「已验证效果」一项。
- 未改 `src/`、`board/`、XDC、XCI、COE，未跑仿真/综合，未 commit。
- 未验证：该 skill 是否真能降低 LUT/FF 或缩短最差路径（需要的对照实验见 readme 的
  「已验证效果」段，`not_measured`）。

### 2026-10-25 00:10 · 大扇出节点本地化复制（state[3] fo=628）+0.130 ns

- 定位（C+D 之后最差路径）：`u_crypto_aead/FSM_sequential_state_reg[3]/Q → net state[3]
  （fo=627、**单根走线 9.290 ns**）→ LUT5 → p12_in_reg[215]/D`，整条 9.870 ns、**1 级逻辑**。
  `state[3]` 是 `crypto_aead.v:99` 的 FSM 状态位，扇出到整条 datapath 的使能/选择锥。
  全局最大扇出是复位分发网 `u_ascon_mmio/rst_sync_reg[2]` fo=9757（但不在关键路径上）。
- 新脚本 `build/timing_tests/{rep_fanout.tcl,probe_fanout.tcl}`：
  从**布线后** DCP 选点（post-opt 视图看不出走线）→ opt 前给驱动设
  `EQUIVALENT_REGISTER_REMOVAL NO`（防折叠）→ place → `phys_opt_design -force_replication_on_nets`
  + `MAX_FANOUT 128` → 复制体再设 EQREG NO（不用 DONT_TOUCH，否则冻结放置）。
- 结果（同流程 optExplore+placeDefault+physAgg+routeAgg）：
  | 臂 | 复制对象 | WNS | WHS | 失败端点 | replica |
  |---|---|---|---|---|---|
  | rep_ctl | 无 | +0.003 | +0.024 | 0 | 51 |
  | **rep_ff400** | **只 state[3]** | **+0.130** | +0.013 | 0 | 60 |
  | rep_any150 | 24 根宽网 | +0.124 | +0.013 | 0 | 93 |
  | e_100 | RTL `max_fanout=64` + 生产策略 | **−0.008** | +0.028 | **1** | — |

  → **只复制一根网就 +0.127（同流程对照），复制 24 根反而略差**；
  **合成期复制（RTL 属性）是反例**：放置后复制才能把 628 个负载分给就近副本。
- 复制后 `state[*]` 从 fo≥128 清单消失；新最差 `sel_ex_mem_rs1_o_reg →
  u_ascon_ise/state_reg[182]/CE`（+0.130）与 `→ dcache/captured_wdata/CE`（+0.130），
  即下一根要拆的是 `sel_*` 那 4 条 fo≈171 的 1 位网。
- 性质：**不是 RTL 改动**（`src/rtl` 未动），是实现流程的一步；仿真无影响
  （`e_100` 的 6 场景 cycles 与对照完全相同）。
- 未验证：minfo/副本数量未扫；复制步骤尚未接进生产策略（`rep_ctl` +0.003 说明该流程本身
  比生产策略差 0.08，+0.130 不能直接当最终余量）；WHS +0.013 仍 < +0.05。
- 追加臂 `rep2_sel`（以 rep_ff400 网表为种子再复制 9 根：`pc_o[5/6]` fo=218/215、
  `func_sel_o[0]` 137、`ascon_mmio/Q[0]`、`p12_inst/Q[0]`）：WNS **+0.055**，
  比只复制一根（+0.130）差 0.075 → **复制必须停在"使能锥上的一根"，继续加反而变差**。

### 2026-10-25 01:10 · 复制步骤接入生产策略后重测：收益不复现（+0.087 → +0.039）

- 新脚本 `build/timing_tests/run_prod_rep.tcl`：仍用 `-strategy Performance_ExploreWithRemap`，
  只给 `STEPS.PHYS_OPT_DESIGN.TCL.POST` 挂一个复制钩子（放置后、布线前），策略/directive 一字不改。
- 结果（起点=当前 src/rtl，C+D 已落地）：
  | 臂 | 钩子 | WNS | 失败 | WHS | replica | 最差路径 |
  |---|---|---|---|---|---|---|
  | prod_ctl | 无 | **+0.087** | 0 | +0.021 | 51 | state[3]→p12_in_reg，9.870/net 9.290/1 级 |
  | prod_rep1 | 只复制 state[3]（fo 628） | **+0.039** | 0 | +0.020 | 60 | ex_mem/ex_rd_data_o_reg[11]→if_id/pred_target/CE，9.595/logic 3.183/11 级 |
  | prod_rep | 复制 2 根 | +0.039 | 0 | +0.020 | 60 | 同上 |
  - `prod_ctl` 逐位复现 `d_100`（+0.087，同一条最差路径）→ 新 run 流程与 run_variantF 等价。
  - 钩子确实生效：`fo=628 → after fo=25`，那根 9.29 ns 网从关键路径消失；
    但整机 −0.048：**省下的走线被 ~50 个副本 FF 的布局扰动吃掉**。
- 结论：**§10.3 的 +0.127 ns 是自定义流程上的收益，不能迁移到生产策略**；
  复制步骤**不进流程**，脚本留作工具与证据。
  **当前 100 MHz 最好成绩 = 生产策略 + C + D = +0.087 ns**（prod_ctl 与 d_100 互证）。
- 现在剩余的墙是 logic 型：11 级 / 3.183 ns logic 的 `ex_mem → if_id/pred_target/CE`、
  以及 pc→icache→id_ex CE 一族 —— 继续做扇出/复制没有边际，得动 if_id/if_stage 控制结构（D2）或 icache tag 打拍。

### 2026-10-25 01:40 · 时序工作台 v2 站点 + 生产流程复制臂矩阵（复制不可迁移；属性与 phys_opt 只在组合下有效）

**任务**：用户在夜间授权做两件事：① 等上一轮复制实验跑完后，把「新一轮工程」做成一个完整的可视化站点
（参照 `ours/html/` 的旧站，不复用其页面结构，只复用其探针数据）；② 重点放在后端（布局布线）优化，
再由布局布线的证据推出改 RTL / 改约束的建议。站点在仓库外 `ours/html_v2/`，未改 `src/rtl`、`board/`、XDC，
未 commit。

**站点**（10 页，纯静态，`file://` 直开）：
`index / wall / attribution / layout / backend / experiments / rtl / pipeline / next / method`。
数据全部由 `html_v2/build/build_data.py` 从 `build/reports/**/result.txt`、`path_csv/paths_*.csv`、
逐跳 `route_paths.rpt`、旧站探针产物（模块 bbox / 复制寄存器）重新抽取 → `data/*.js`；
`build_site.py` 把 `build/pages/*.html` 套进统一外壳；`build/check_site.py` 用无头 Chrome 逐页
dump-dom 查 JS 异常/空容器/NaN（当前 10/10 通过）。旧站探针产物被重新打包成 `data/layout.js`
（base / ndh 两个数据集 + 52 个复制单元），没有重跑那 20 分钟的探针。

**本轮新增的实现臂**（全部 `Performance_ExploreWithRemap` 全流程、核心 10 ns、RTL = 当前 `src/rtl`，
唯一差别是 `PHYS_OPT_DESIGN.TCL.POST` 钩子；脚本 `build/timing_tests/run_prod_arm.tcl` +
`hooks/rep_hook.tmpl` / `hooks/physopt_only.tmpl`，批次 `run_batchA/B/C/D.sh`）：

| 臂 | 钩子做的事 | WNS | 失败 | WHS | 复制单元 | FF |
|---|---|---|---|---|---|---|
| `pr_ctl` | 无 | **+0.087** | 0 | +0.021 | 51 | 17187 |
| `pr_ctl2` | 无（独立第二次） | +0.087 | 0 | +0.021 | 51 | 17187 |
| `pr_mfonly` | 只设 `MAX_FANOUT`，不复制 | +0.087 | 0 | +0.021 | 51 | 17187 |
| `pr_rep_state` | 按**单元名**选点 → `candidates=0`（空臂） | +0.087 | 0 | +0.021 | 51 | 17187 |
| `pr_rep2_state` | 复制 `state[3]`（60 副本） | **+0.039** | 0 | +0.020 | 60 | 17196 |
| `pr_state_b` | 同上（复跑） | **+0.039** | 0 | +0.020 | 60 | 17196 |
| `pr_rep2_sel` | 属性 + 多一次 `phys_opt_design`（0 副本） | **+0.184** | 0 | +0.021 | 51 | 17187 |
| `pr_sel_b` | 同上（复跑） | **+0.184** | 0 | +0.021 | 51 | 17187 |
| `pr_selprops` | 只设属性、**不跑**那次 phys_opt | +0.087 | 0 | +0.021 | 51 | 17187 |
| `pr_rep2_both` | state + sel 属性 + phys_opt | +0.149 | 0 | +0.023 | 80 | 17216 |
| `pr_both_b` | 同上（复跑） | +0.149 | 0 | +0.023 | 80 | 17216 |
| `pr_physopt_only` | **只多跑一次裸 `phys_opt_design`**（不设属性、不复制） | +0.087 | 0 | +0.021 | 51 | 17187 |
| `pr_physopt_b` | 同上（复跑） | +0.087 | 0 | +0.021 | 51 | 17187 |
| 协作方 `prod_ctl` / `prod_rep` / `prod_rep1` | 独立实现：对照 / 复制 state | +0.087 / **+0.039** / +0.039 | 0 | +0.020 | 51 / 60 / 60 | — |

**三条结论（全部有复现）**

1. **复制不能从自建流程迁移到生产流程。** 同一根 `u_crypto_aead/state[3]`（fo=628、单根 9.29 ns）：
   自建流程（`opt Explore / place Default / phys_opt Aggressive / route Aggressive`，对照 `rep_ctl` +0.003）
   复制后 **+0.130（+0.127）**；生产流程（对照 `pr_ctl` +0.087）复制后 **+0.039（−0.048）**。
   本站 `pr_rep2_state` 与协作方 `prod_rep` 是不同脚本/不同钩子写法，给出**逐位相同**的 +0.039、相同失败端点、
   相同 `dp/logic/net/levels`。原因：自建流程本身比生产策略低 0.084，复制修的是那条流程自己的病灶；
   生产策略的 opt 已经把布局调到"刚好合适"，再插复制会把 CPU 侧 11 级路径顶上来
   （新墙 `ex_mem/ex_rd_data_o_reg[11] → if_id/pred_target_o_reg[13]/CE`，11 级 / logic 3.183 / net 6.412）。

2. **`sel_*` 复制一个副本都不生成。** 4 条网（12 个别名，fo 172/141/172/140）设 `MAX_FANOUT 128` +
   `-force_replication_on_nets` 后副本仍 51、FF 仍 17187 —— 工具按**物理收益**决定是否复制，不是按扇出阈值。
   这条只能靠"数副本数"得到，只 WNS 会误读。

3. **唯一剩下的余量来自一个「组合动作」，而且与复制无关（2×2 消融，每格都有两次独立复现）。**

   |  | 不跑额外 phys_opt | 多跑一次 `phys_opt_design` |
   |---|---|---|
   | 不设属性 | `pr_ctl`/`pr_ctl2` **+0.087**（逐位相同） | `pr_physopt_only`/`pr_physopt_b` **+0.087**（逐位相同） |
   | 设属性（`EQREG NO`+`MAX_FANOUT 128` 于 4 条 `sel_*`） | `pr_selprops` **+0.087** | `pr_rep2_sel`/`pr_sel_b` **+0.184**（逐位相同） |

   也就是说：**属性单独是空操作、裸 pass 单独也是空操作，只有"带着 `MAX_FANOUT/EQREG` 提示要求工具重做那几条网"
   才拿到 +0.097**。它**没有生成任何副本**（副本 51、FF 17187，与对照一致），收益出现在别处：
   `state[3]` 那条 slack 从 +0.087 抬到 **+0.284**，新最差变成
   `sel_ex_mem_rs1_o_reg → if_id/pred_target_o_reg[12]/D`（13 级 / logic 3.52 / net 5.81）。
   **机制未定论**（没有 `report_design_analysis`、没有前后 placement 逐单元对比），只能当经验结果。

**新踩的坑**（已写进 `project_log/lessons_learned.md`）：
钩子 `.tcl` 花括号提前闭合（两臂 00:24:41 双退）；选点按驱动单元名而非网名（`state[3]` vs
`FSM_sequential_state_reg[3]` → `candidates=0` 空臂）；给 `vivado.bat` 传 MSYS 路径
（`Failed to create directory 'C'`，日志全丢）；`report_timing` 元素表 net 行没有 edge 字母。

**可比性**：18 个生产流程臂的 `build_context.txt` 里 `dcache.v 79af461c…` / `cpu_core.v 95d78121…` /
`crypto_aead.v 722bf1e3…` 三个 sha256 全部一致；期间 HEAD 从 `3cfbe51` 前进到 `805b01a`（协作方提交了
prod_rep 的负面结果），但 `git diff --stat 3cfbe51..805b01a -- src/ board/` 为空 —— 所以 2×2 的差异只可能来自钩子。

**站点补记**：布局页已接入第三个数据集 `pr2`（本轮 `pr_rep2_sel` 的真 routed DCP 现跑探针：
`html/probe/floorplan_probe.tcl -tclargs <dcp> pr2` → `parse_floorplan.py --tag pr2` → `data/layout.js`）。
探针顺带给出一个独立证据：`pr2` 上 `pc_to_dcache/pc_to_ex_mem/pc_to_ise` 三个路径族**一条路径都抓不到**，
与 `paths_d100.csv` 里「起点含 pc 的 1389 → 1 条」互相印证 D 的效果。

**未验证**：+0.184 的**第三遍**复现与机制归因（是否换一批 net 名字仍成立）；把该组合动作写成独立 impl 入口后的
全套功能回归（`docs/freeze_checkpoint_20261018.md` §2）；板级 XDC/PS7 下的 STA；`minfo`/副本数扫掠；
`pr2` 数据集的复制寄存器探针（未跑，故布局页该层为空）。

## 2026-10-25 — Navigator成果提交与V01定向验证

owner TBD；用户明确授权首次commit/push，后续新增测试保留本地未提交。

- 已发布20文件至feat/navigator_preboard，commit `68fafc8eca095ce8afdf203edf4aea726151dfbc`；远程main仍`f88e178`。逐文件暂存/敏感信息与生成产物核对/cached diff --check通过；没有Skill/PUF/生产RTL/baseline改动。
- D-Cache原4项FAIL分类**TB_STALE**：旧TB在36ns三项、206ns一项检查，MISS_CAPTURE实际45/215ns发总线请求。f52bc49（miss流水前）旧TB PASS；38e96fb（Store Buffer前）与当前同4 FAIL。Store Buffer前后4种子逐拍信号/最终MEMSUM完全一致。
- 新tb_dcache_contract在前后版本均PASS：578 loads、671 stores、404 reads、1616 fill beats；独立参考内存与总线顺序/掩码/回填检查，错误回填/丢写注入均exit1。没有改dcache或原TB来消除失败。
- CPU+真实CLINT的6个RV32场景均实际接受一次timer interrupt并执行一次handler/mret；覆盖I-Cache miss、DIV、外部存储停顿、D-Cache miss、branch flush/guard延后，检查mepc/mcause/mstatus、真实指令PC、恢复结果。NO_TIMER、BROKEN_MRET及临时副本绕过inter_slow_ok_q都触发exit1。生产CPU/CSR/CLINT/SoC未改。
- `python -B sim/board/run_targeted_validation.py --out build/local/preboard_targeted_final_03` PASS/exit0（45命令、5额外检查）；Icarus/vvp12 devel、GCC13.2/binutils2.42、Python3.14.3。当前smoke `build/local/preboard_followup_smoke_01/` 6 PASS/0 FAIL/9 NOT_RUN，exit0；中断有测试后在smoke标NOT_RUN、regression实际调用新套件。旧D-Cache FAIL条目及历史全回归报告保留，不宣称完整regression全绿；未重跑耗时Ascon全SoC验证。
- 局限：未验SoC CLINT MMIO路由、完整AXI/Cache一致性、嵌套/全部优先级、RV64及全部多周期抢占；V01保持in_progress。板级/PYNQ真实链路仍NOT_CONFIGURED/NOT_RUN，FPGA cycles/PPA NOT_MEASURED。
- 独立PL工程可开始配置/离线重建准备；正式下载前核实实物速度等级、板级clock/reset/UART、重建IP/COE和STA/DRC；先JTAG/LED/UART，再SW→MMIO→ISE，最后PS/PYNQ。镜像优先向厂家取得，备选锁定2.7/2020.2 BSP+sdbuild。未运行Vivado构建或下载。

证据与文件：`board/atk_navigator_7020/validation_followup.md`、`validation_evidence.json`、`next_bringup.md`、`sim/board/run_targeted_validation.py`及3个RTL/assembly测试输入。用户本轮允许后仅追加公共记录并同步V01；这些后续修改未再次commit/push。下一接收V01/B03/B02/Y01/Y02，owner TBD。

## 2026-10-25 — V01 D-Cache测试契约修订与完整回归PASS

owner TBD；分支feat/navigator_preboard，HEAD仍68fafc8，保留既有13项未提交工作，本轮未commit/push/merge。

- 独立连续两次复现原TB四项FAIL/exit1，保留修改前文件与日志。根因是IDLE接受请求后经过MISS_CAPTURE才发单拍request；旧36/206ns检查早于45/215ns合法事件。分类TB_STALE，不是生产RTL修复。
- 当时仅修订原CPU的dcache TB：8拍有界请求事件等待、独立事务队列、方向/地址/data/mask/qualifier/次数和回填检查；完成上限仍30拍。原场景/expected保留，补byte lane、连续store、跨拍stall与reset中止/失效场景；源码现已隔离。
- 修订TB在Store Buffer前与当前生产源码均PASS：116检查、13事务、18回填beat；独立事务TB保持578读/671写/404读事务/1616beat PASS；4种子逐拍差分一致。
- 修订TB的坏回填、缺读、重复读、错地址、错写data、错mask、缺写7种反例均exit1；原事务TB的坏回填/丢写和中断3种反例也全部按预期失败。历史原TB+RTL按已发布68fafc8冻结，只用于历史复现，不驱动当前正常测试的FAIL豁免。
- 按要求实际执行python -B sim/board/run_tests.py --mode smoke：6 PASS/0 FAIL/0 BLOCKED/9 NOT_RUN，exit0，16.394s。完整--mode regression：15 PASS/0 FAIL/0 BLOCKED/1 NOT_RUN，exit0，757.713s；SW/MMIO/ISE、完整Host KAT、Mailbox、COE/CPU镜像一致性、修订TB、独立事务TB与6个真实CPU+CLINT中断场景均实际运行。
- 唯一regression NOT_RUN是实板UART/Overlay；hardware cycles NOT_MEASURED。正常测试未发现未解释功能性FAIL，仍不等于全部ISA/RV64/异常/SoC/板级门禁；V01保持in_progress。生产RTL、Skill/PUF/密钥管理、原baseline、PYNQ文件未动，前后原始SHA核对PASS。

证据：build/local/dcache_tb_revision_20261025_01/final_report.json；smoke=build/local/preboard/20261025_111612_829523_smoke；regression=build/local/preboard/20261025_111629_599017_regression（targeted_baseline含历史FAIL/负向日志与VCD）。说明sim/board/dcache_tb_revision.md。建议先审核/提交本地必要测试文件后再评估合并，远程68fafc8尚不含修订，本轮没有自动提交。下一接收V01/B02/B03，owner TBD。

## 2026-10-25 — 用户授权发布preboard测试修订（owner TBD）

用户在完整回归通过后明确指示“提交并合并到main”，覆盖前轮仅留本地待审的限制。发布前再次fetch，origin/main仍f88e178、功能分支HEAD68fafc8；15项本地改动均属于前两轮已交付的测试/板级交接与公共记录。正常smoke6 PASS、完整regression15 PASS的证据与当前测试输入SHA逐项一致，受保护文件原始字节不变，未发现凭据/私人home路径/大型生成物。仅对明确列出的文件暂存，执行cached diff检查后提交；main满足快进条件，发布结果以Git提交/远程引用及本轮交付为准。V01仍为in_progress，实板NOT_RUN和既有历史FAIL/负向证据继续保留。
## 2026-10-26 — CPU 流水线现状文档（只读，未改 RTL）

- 新增 `docs/cpu_pipeline_flow.md`：当前的 5 级顺序流水线底图（层级 / 逐级职责 / 控制优先级 / 冒险 /
  存储 / 多周期 / 可改点 / 测量方法）。行号按当前 `src/rtl`（`dcache.v` 611 行含 store buffer）核对。
- 结论边界：周期数均为代码推导（标「推」）；未跑仿真、未改 RTL、未碰时序。下一步应先复现
  `docs/board_bringup_plan.md:91` 的 16840 / 664 / 2559 三个基线再谈任何改进收益。owner TBD。

## 2026-10-27 — C 线 PYNQ overlay 通道与端到端骨架（M2/M3 代码就位，未上板）

分支 `feat/pynq-overlay`（自 `bd10697` 新建），未 commit/push；owner TBD。
任务号：Y01/Y02/Y03（板级部分 B03/C 线 M1–M3）。**所有板级数字仍为 not_measured。**

- **架构决策（必须记录）**：任务书 M2 原写"AXI-Lite 控制 + 共享 BRAM"。查证冻结 RTL 后不可行：
  (a) RV32 的外设访问全在 `bus_interconnect.v` 内部译码，没有通向 PL 边界的 MMIO 出口；
  (b) `dcache.v:52` 只有 `0x100x_xxxx` 是 cacheable，且全设计没有 d-cache 失效指令，
  所以"PS 直写共享 BRAM"必然读到旧 cache 行，靠 volatile/fence 不能修。改/复制 SoC 顶层又要
  在 WNS +0.087 ns 上重新签核。→ 采用 **方案 A'**：复用 RV32 已有的 UART MMIO（0x20000000）
  当 PS↔PL 数据通道，新增 `pynq_mbox.v` 在 PL 里做"串口的另一端"；冻结 RTL 一行未改。
  代价：PS 端到端 ≈200–300 µs（估算，未测），CPU cycles（20806/688/2570）不受影响。
- 新增 RTL（4 个文件，全部是新增）：`src/rtl/pynq/pynq_ctl.v`（控制/状态 AXI-Lite）、
  `pynq_mbox.v`（TX64B/RX256B FIFO + uart_tx/uart_rx + CNT）、`pynq_soc.v`（SoC+BRAM 封装）、
  `top_pynq.v`（三块组合的单模块顶层）。AXI 口带 `X_INTERFACE_*` 属性，BD 能自动识别为 AXI4Lite。
- 新增固件 `src/firmware/pynq_svc/`：单槽邮箱服务，帧格式与 `src/pynq/mailbox_protocol.md` 一致，
  另加两个服务帧 `Y01S`（能力/自检/mcycle，64B）与 `Y01E`（PS 下发 epoch，20B）。
  SW 模式直接 `#include ascon/ascon_c/aead/aead.c`（与 host golden 同一份参考），
  ISE 模式用 custom-0 置换指令，HW 模式走 ascon_mmio，三种模式开机各跑 6 项官方 KAT 自检。
- 新增 Python：`src/pynq/pynq_transport.py`（Transport 实现：MMIO、帧解析、批量压入、
  绝对 deadline、epoch/ACK 语义）、`test_pynq_transport.py`（13 项寄存器级模型测试）、
  `make_pynq_profile.py`（.hwh → navigator profile，并调用 `validate_overlay()` 自检）。
- **钉住 RTL 源集**：工作区 `soc_top.v`/`ascon_mmio.v` 已被 PUF 补丁改过，`key_hw_sel` 在
  `key_valid` 后无条件锁存，会让 ascon_mmio 忽略 CPU 写的 KEY → HW 模式 KAT 无法复现。
  故 `board/vivado_zynq7000_xc7z020_pynq/rtl_p0/` 存放 `8a86afd` 版这两个文件
  （其余 29 个 `src/rtl/*.v` 与 `8a86afd` 逐文件 git blob 相同，已全量核对）；keys 不进工程。
- 实测（本机）：`iverilog 14.0` 桥单元测试 **PASS**；`bash sim/pynq/elab_check.sh`
  42 文件整树 elaborate **PASS**（Xilinx IP 用 `sim/pynq/ip_stubs.v` 空壳）；
  `bash src/firmware/pynq_svc/build.sh` **exit 0**，text 46104 B/bss 336 B，custom-0 共 22 条
  （`0x200b`×1、`0x300b`×4），`pynq_svc.bin`=`dba0a861…`、`pynq_svc.coe`=`d7e9382f…`；
  `python src/pynq/test_pynq_transport.py` **13/13 PASS**；
  `python src/pynq/make_pynq_profile.py --selftest` **PASS**；既有
  `test_mailbox.py`(24 tests OK)/`test_navigator.py`/`golden_checker.py --backend mailbox --mode ise`
  (KAT 1089 PASS、TAMPER 4290) 无回归。
- **未验/阻塞**：Vivado 综合/实现/bit/hwh NOT_RUN（本机另有 Vivado PID 16988 在跑 PUF 版，
  按"同时只允许一个实现"未并发）；上板 KAT/PS 端到端时间/串口时序全部 not_measured；
  M_AXI_GP0 是否在厂家 FSBL 里使能未验证（若未使能 MMIO 会读回 0xFFFFFFFF）。
- 审计附带发现：`docs/freeze_checkpoint_20261027.md` §2 的 `src/rtl/*.v` 合并哈希
  `a323df37…` 用 6 种常见口径在 `8a86afd`/`f88e178` 上都无法复现；本轮独立口径为
  `8d4589e2…`（keys 合入后 `f4ad6ab6…`）。建议补记该哈希的计算口径，否则不能当复现凭据。
- 文档：`board/vivado_zynq7000_xc7z020_pynq/readme.md`（架构/位表/地址/GUI 建工程分步/
  验收/降级阶梯/风险）、`docs/pynq_bringup_m1.md`（M1 纯 GUI 分步 + 证据清单）。
- 下一接收：M1 起板（用户执行，按 `docs/pynq_bringup_m1.md` 交 boot log/env/jupyter 证据），
  然后 M2 建工程出 bit+hwh，再 `make_pynq_profile.py` 出 profile 过 `validate_overlay`。owner TBD。

## 2026-10-27 — 板级 IO 时序签核变体（B03/I08 的 IO 门禁）

owner TBD；分支 feat/board-bringup（期间并发工作线把工作区分支切到 feat/pynq-overlay，
并在 20:04 提交 `8623ea3` 改了 `src/rtl/keys/ro_puf_core.v`、`key_mmio.v`）。本轮未 commit/push，
未改 `src/rtl`、未改 `const.xdc`、未重建/覆盖三份冻结 bitstream。

- 新增 `board/vivado_zynq7000_xc7z020_ascon/riscv_vivado_project/riscv_vivado_project.srcs/constrs_1/new/const_io.xdc`：
  7 个板级端口各给「`false_path`（与 RTL 一致的异步语义）+ 一条只用于覆盖计数的 IO delay」，
  另加两个虚拟参考时钟。`const.xdc` 原样（1 时钟 + 7 引脚 + reset false_path）。
- 关键负结果（本轮花时间最多的地方，全部带实测数字）：**"给异步 IO 编个宽松 input/output delay"
  在这块板上不可能成立**。Vivado 的 requirement 取"最小正边沿对"，只要 delay 数值 > 捕获时钟
  周期（本设计 10 ns）就为负，而负 requirement 会被当作**违反**报出来：
  变体A（参考端口 clk 20 ns、in 20/out 15）→ WNS −18.481 / TNS −5785.882 / 7972 失败；
  变体B（虚拟位时钟 8680.556）→ uart_rxd −17.623、uart_txd −27.105（req 仅 9.444/0.556）；
  变体D（8680.000，与 10 ns 网格可公度）→ uart_rxd −17.067、uart_txd −17.661（req 10.000）；
  变体E（LED 用 10 µs 虚拟时钟 + 20 ns 预算）→ led setup −13.888 / hold −18.452。
  另实测：`false_path` **不会**让 check_timing 的 `no_input_delay`/`no_output_delay` 豁免该端口
  （只加 false_path 时计数仍是 4/3），两者必须同时存在。
- 最终变体（false_path + 形式 delay）在钉住的源快照 `8623ea3` 上跑 synth+impl：
  `no_input_delay`/`no_output_delay` **4/3 → 0/0**，WNS **+0.152**、TNS 0、失败端点 **0/59513**、
  WHS +0.034，DRC **0 Error**（825 checks / 12 条 Warning 类别），TIMING-8 = 0。
  与同源同脚本、唯一差别是不加 const_io.xdc 的对照组**逐项相同**（WNS/TNS/端点数/最差路径全同），
  即可归因代价 = **0.000 ns**。
- 未达成项（不是 IO 问题，交 keys 线）：`no_clock`=10944、`unconstrained_internal_endpoints`=27312，
  100% 在 `u_soc_axi_top/u_soc_top/u_puf_key/u_puf/*`，根时钟脚 `ro_clk_div_reg[1]/Q` 被常量折叠为 HIGH
  （5824 个寄存器无时钟）；`TIMING-17` 1000 条同域；DRC `UTLZ-3` 报 `pb_ro_puf` 超容
  （CARRY4 需 1681 > 1470、Slice 需 2707 > 1470）。上述在"无 IO 约束"对照组里同样存在。
- 证据：`docs/io_timing_signoff.md`（约束推导/四种被否写法/判据/复现命令）、
  `build/reports/io_sta_20261027/{io,noio,io_clkframe,noio_rtl_bd10697}/`、
  `build/local/io_sta_20261027/`（工程副本、钉住源快照、STA 探针日志）、
  `build/{build_io_sta.tcl,collect_io_sta_results.py,collect_applied_constraints.tcl}`。
  三份冻结 bitstream 哈希复核未变：sw `f4233827…`、ise `f85eb1a6…`、hw `2f6f2469…`。
- 局限：板级真实 IO 延迟 **not_measured**（无示波器/眼图/环回抖动）；本轮不产出 bitstream，
  加约束后的布线未上板验证；`+0.152` 与 P0 的 `+0.087` 之差**不能**归因于 IO（源集不同 + P&R 波动）。
  下一接收：B03（板级 IO 实测 / PYNQ）、keys 线（RO 域 no_clock 与 pblock 超容）、owner TBD。

## 2026-10-28 — PYNQ 最终集成（Y01/Y02/Y03/Y04/V01/V04，owner TBD）

从干净main 4268b1f fetch/ff至0f5d49c，在feat/pynq-final-integration开发；另外两个worktree未动。用户本轮明确授权中文commit/merge/push。
新增自动Vivado BD/构建、真实硬件CLI/Notebook、真实CPU服务链仿真；修复UART RX bit1、ISE padding、服务帧证据位、启动握手、WSTRB/满FIFO/复位串口、畸形长度/重复ID与缓冲擦除。PYNQ使用rtl_p0软件key路径，不把main的PUF硬件key覆盖混入官方KAT。
最终P0 regression与smoke PASS，初始main runner缺PUF源的FAIL及误传参数失败均保留；bridge/host/model PASS。构建/联合仿真最终证据及发布状态见board/vivado_zynq7000_xc7z020_pynq/validation_20261028.md；板上PYNQ/网络/真实cycles NOT_RUN/NOT_MEASURED。详细接收手册handoff_20261028.md，下一任务B03/Y02/Y03/Y04实板取证，owner TBD。

本轮硬件收口：Vivado真实生成100MHz bitstream；WNS+0.034ns/TNS0/WHS+0.020ns，DRC0 Error/0 Critical（warnings及限制见报告）。最终COE生成MIF与BIN逐字节一致，官方4代表KAT×三模式36请求及半帧reset真实CPU联合仿真PASS。源码提交86dc10f13e96adbb360f1adfe0c4891ce2f8e2a7；正式发布在PYNQ工程release/，SHA256逐项复核PASS；实板仍NOT_RUN。

## 2026-11-01 — D03 AMD 模板海报完成

owner TBD。用户明确授权先拉取最新仓库、制作后 commit/push；入场 main 工作区干净，
`git pull --ff-only` exit 0，从 506e856 快进到 c05782d510a2c1936b3bb7c45a943ef76cc6bd02，无需丢弃文件。

- 交付 `report/poster/`：可编辑的一页 PPTX、2400×1350 PNG、PowerPoint COM 构建脚本、
  标准库核验脚本及检查 JSON；来源与模板 SHA-256 见该目录 readme/validation。
- 按用户模板保留 960×540 pt、AMD 标识、分区线与三栏组织，替换全部示例内容。
  用户确认学校华南理工大学，成员熊雅琦、胡潇正、黄晨中，指导老师不填；owner 不据此推断。
- 性能从 `data/pynq/notebook_20261031_112052/pynq_warm_benchmark.json` 读取，
  同目录 smoke 三模式各 289 KAT/坏 Tag；恢复来自 `data/pynq/error_gate_20261031_112812/`。
  备注包含出处、测量身份与范围，不把材料制作当成重新上板。
- 验证：PowerPoint 16.0 COM，`./report/poster/build_poster.ps1` exit 0；
  Python 3.14.3，`python -X utf8 report/poster/verify_poster.py` exit 0，31 checks PASS；
  presentations 技能的 package integrity 和 layout geometry 检查均 exit 0 / 0 finding，
  PowerPoint TextRange.BoundHeight 检查 0 overflow，整页 PNG 视觉检查通过。
- 接口变化：无。未改 RTL、固件、Vivado 或既有测量；未测试其他 Office/WPS/印刷，未重跑板测。
- D03 仅 PPT 子项完成，整体保持 in_progress；D02/D04/D05/D06 不据此变为 done。
  阻塞：海报无阻塞。下一接收：D03 其余材料审核、D06 将海报纳入最终提交包，owner TBD。

## 2026-11-01 — D03 用户更新版海报提交

owner TBD。用户明确要求再次提交更新后的 `report/poster/ascon_soc_poster.pptx`。
入场仅该 PPTX 修改；保留用户文件字节，未运行初稿构建脚本。PowerPoint 16.0 只读导出
同名 PNG，同步产物哈希和核验记录。Python 3.14.3 `python -X utf8 report/poster/verify_poster.py`
exit 0，31 checks PASS；package/layout 检查 exit 0，0 finding，文字高度检查0溢出。
接口无变化；未重新板测、未验证其他 Office/WPS/印刷。D03整体保持in_progress，
无提交阻塞；下一接收D06材料归档，owner TBD。本轮按用户授权commit/push。

## 2026-11-01 — D03 中英文两页海报与官方校徽

owner TBD。用户明确要求中英各一页、在线查找华南理工大学校徽、精简海报目录并直接提交推送。
入场main干净，基点276b4df；git fetch成功，无远端新增。以用户修订PPTX为基础复制英文页，
保留原版式和主线数据，校徽取自 https://www.scut.edu.cn/new/9017/list.htm 的高清下载原图，
获取日期2026-11-01；两页嵌入原始图像，不裁切/变色，出处写入备注与README。
交付report/poster仅保留PPTX、中文PNG、英文PNG及readme.md。初稿生成/核验脚本及5份JSON
按本轮用户授权移出Git，副本留本地build/tmp/poster_bilingual_20261101（ignored）。
验证：PowerPoint16.0渲染两页，Python3.14.3临时check_bilingual.py exit0，51项PASS，
含两页原始周期/加速比/数据表一致及官方校徽字节嵌入；package/layout检查exit0、0finding，
两页文字高度检查0溢出，两页PNG视觉复查。接口无变化；未重新板测/RTL，未验证WPS/印刷。
海报无阻塞；D03整体仍in_progress，下一接收D06材料归档（owner TBD）。

## 2026-11-01 — D03 条目编号与典型应用示意图

owner TBD。用户授权修改后直接提交，并要求今后提交标题/说明使用中文；入场main干净，基点83d33af。
中英文两页的当前交付范围、创新一、创新二按1–3、1–4、1–3编号。左侧重复实物照替换为
可编辑传感器遥测短消息认证加密应用图，展示采集、Ascon保护、接收端验证/解密和Nonce/密文/Tag，
依据docs/tech_report/report.md §1.2，明确标注概念示意、未实地部署；右上实物照和校徽保留。
更新report/poster的PPTX、两张PNG、README及任务状态；目录仍仅4个交付文件。
验证：PowerPoint16.0渲染及文字边界0溢出，Python3.14.3临时check_application.py exit0、61项PASS，
其中逐页编号顺序、可编辑应用图、实物照位置、原始周期/加速比和双语表格一致均通过；
结构/布局检查exit0、0finding，逐页PNG视觉复查。临时脚本/JSON只放ignored目录。
接口无变化，未重新板测/RTL/现场部署，未验证WPS/印刷；无阻塞，D03整体仍in_progress。
下一接收D06材料归档，owner TBD。本轮提交标题和正文使用中文。

## 2026-11-01 — D03 仅替换左侧DNA/PUF图

owner TBD。用户要求用项目DNA相关图和介绍替换左侧应用图、其他脚本不改；基点c9fff89，入场main干净。
中英文两页左图改为RO-PUF的128-bit响应与57-bit Device DNA，经固定上下文/P12派生128-bit key；
来源docs/tech_report/report.md §2.3.4、src/rtl/keys/puf_key.v及device_dna.v。
图内声明DNA非秘密、独立扩展及未验收边界，备注说明仅正常PUF参与路径、DNA-only回退不保证秘密性。
只更换PPT左图/图注并更新备注，未改既有脚本；README、两张PNG和日志同步。
验证：PowerPoint16.0渲染0文字溢出，两页视觉复查；Python3.14.3通用核验51项PASS，
专项核对157项PASS（原有图形除左图/图注外XML完全一致，master不变、新图字段正确）；
package/layout检查exit0、0finding。所有验证命令exit0。
接口无变化；未重新板测/RTL，未验证跨上电、保密隔离、RO时序或其他Office/印刷。
无阻塞，D03整体仍in_progress；下一接收D06材料归档，owner TBD。按既有授权中文提交并推送。

## 2026-11-01 — D03 双语海报更新PUF3最新数据

owner TBD。用户要求仅替换最新相关数据、其他内容不动并直接提交仓库。入场main干净，
基点033b92f；git fetch origin成功，HEAD与origin/main无差异。三张截图与
data/pynq_puf3/notebook_20261031_114512/result.json及PUF3 candidate/reports对应。
中英两页同步加密周期21,862/1,369/3,895、解密22,562/1,213/4,288及相应加速比；
大数字15.969×与5.613×，柱长按新周期更新。注明KAT529、PT16 B、AD0、HWKEY关闭、
预热5次/采样30次/中位数、CPU周期不含PS/UART。
同步LUT18,674、FF32,002、BRAM34.5、DSP4；WNS+0.104 ns、TNS0、WHS+0.041 ns只针对
已约束路径。100 MHz为配置，99.9723 MHz为mcycle/PS时基估测，非示波器或Fmax测量。
PUF3各模式289/289 KAT与289次坏Tag拒绝，质量127/128、同会话5次重建稳定、关闭HWKEY后KAT恢复；
9/9错误门禁和7/7恢复明确归属PYNQ v1历史证据。左图说明改为PUF3同一overlay集成RO-PUF/DNA，
保留RO计数器域未签核、跨上电/温度/BER/熵/唯一性未测、保密隔离未验收边界。
修改report/poster的PPTX、双PNG、README及本节/开发日志/任务字段；未改任何既有脚本、RTL、固件或原始证据。
验证：PowerPoint16.0渲染两页，文字宽高0溢出，逐页视觉复查；Python3.14.3
`python -X utf8 build/tmp/poster_puf3_data_20261101/check_data.py` exit0，503项PASS，
含原始30次样本中位数、双语表格/柱长、未修改图形XML一致、母版/布局语义/主题/图片不变、数据对象位置不变。
`inspect_presentation_package_integrity.py ... --fail-on-findings`和
`inspect_presentation_layout_geometry.py ... --expected-slide-count 2 --expected-slide-size-emu 12192000,6858000 --require-native-table-slide 1 --require-native-table-slide 2 --fail-on-findings`
均exit0、0 finding。工具位于presentations/26.1025.11240/skills/presentations/container_tools；
临时脚本/校验JSON仅留ignored目录，交付目录仍只有4个文件，PPTX SHA-256见README。
接口无变化；未重新板测、未验证其他Office/WPS/印刷，未新增PUF稳定性或安全验收结论。
无阻塞，D03仅海报子项完成、整体仍in_progress；下一接收D06材料归档，owner TBD。
按用户明确授权，使用中文提交标题/说明并推送。

## 2026-11-02 D03-CODE：报告代码块排版完成（owner TBD）

正式LaTeX统一codeblock修复，85页保持，指定命令一行，旧续行标记清除；87189字符正文比较与图片像素一致，review_evidence 194/194，无Overfull/缺字/未定义引用。仅重打技术报告包，其他包与历史冻结快照不变。完整交付校验的固件阶段缺交叉编译器未通过，不影响独立报告排版校验；接口无变化。命令/版本/退出码/备份/局限见 report/technical/validation/codeblock_layout_20261102/readme.md；下一接收D03/D06。

## 2026-11-02 D09：最终RAR交付（owner TBD）

基于main cfa3817整理当前PUF3及共享IP/固件/RO依赖、原candidate、最新85页报告和当前独立Skill，另写评委README；真正RAR5，367文件/7,025,851字节。RAR测试/解压/全部哈希/README链接/源码身份与展开通过，host61、Skill61/3可选skip。无RTL/固件/工件/报告正文变更；未运行固件重编/Vivado/实板。证据delivery/final_rar_readme.md及final_rar_manifest.json；下一接收D06平台上传。

## 2026-11-03 — D11 聊天导出与报告包说明更正（owner TBD）

按用户授权合并远端d5a985b并保留本地全貌图提交，恢复入场5份文档改动及双方日志。
report/llm_collab新增本机5份Codex项目会话，保留原21份，共26份；--tool codex --full-text导出用户提示和可见回答，工具仅摘要，当前会话截至导出时。
导出器改增量保留、支持选工具/不截断/归档会话，过滤UI上下文及隐藏推理，工具摘要打码；不改原始会话库。
直接修正technical_report.zip内两份Markdown，更新source_manifest与delivery/manifest条目，并同步版本入口。
版本/85页/归档路径/Python3.14.3/提交状态/DejaVu字体说明已更正；59个其他成员逐字节不变，未重编PDF或改技术数据。
Python3.14.3运行export_sessions.py --tool codex --full-text、ignored update_report.py/verify.py及git diff --check均exit0；
61成员哈希/CRC、四ZIP总哈希、85页PDF字节一致、26条会话索引、合成会话保留/过滤/完整性/打码校验通过。
证据report/technical/validation/readme_corrections_20261103/{readme.md,check.json,package_readme.md}。
接口无变化；其他ZIP/RAR/整仓快照保持历史，未重跑194项证据、RTL/固件/Vivado/板测，未测边界与平台上传状态不变。
本次中文提交并正常push；入场未提交内容仅恢复保留，不混入D11提交。下一接收D03/D06，owner TBD。
