HChenZ/amd_fpga_2026/report/design/risks.md

# 风险清单

更新：2026-10-29。probability / impact 是定性评估，不是实测统计。owner 全部 TBD；已观察问题明确标注。触发后更新 task_board 与 actual_progress，不隐瞒延期或失败。

## 2026-11-01 当前补充（下方旧风险表保留日期语境）

- **已观察：版本入口混淆。** PUF3 专用链已验证，但 v1 CLI 默认不兼容 PQF3，旧默认 CPU runner 缺 keys/BUFG；
  说明按 version_entrypoints.md 分责，本轮未修程序。不要执行旧报告流水线或只凭“final”ZIP 名选包。
- PUF 已进入 PUF3 主演示（仅会话内功能），R7/R8 的“未启动”不再是现状：结构/实板已有证据，
  RO 计数器时序、跨上电/PVT/BER、保密性仍未闭合。9/9 错误门禁仅属于旧 v1。
- 板卡有 V3.9/2V5 和 mcycle/PS 时基估测，完整芯片丝印/速度等级、真实 IO 延迟仍待补；不能泛称完全没测频率。
- 提交日期按 10-29 授权为 11-01；旧 R12 的 11-04 计划不再适用。Skill S01–S05 与冻结留档已有相应证据，
  原 baseline/完整矩阵/clean-clone 等仍未验收，不因缩范围变为 PASS。

## 10-29 风险表（历史记录）

| ID | 风险 | probability | impact | mitigation | trigger |
|---|---|---|---|---|---|
| R1 | 旧 Ascon 与 NIST SP 800-232 混淆 | 高：本地有 1.3.0 / draft 标记 | 极高：全部结果失效 | C01 固定 final 规范、参考提交与 KAT 哈希；逐项核对 IV/端序等；C03/V02 双路径比对 | 使用旧 Ascon-128/128a 向量；标准来源不明；KAT 任一失败 |
| R2 | 移动 Vivado 工程导致路径损坏 | 中 | 高：baseline 中断 | 原位保留 XPR/XDC/RTL；独立新配置；检查相对引用与干净重建 | 计划搬迁/改名；missing source；本机绝对路径进入脚本 |
| R3 | custom instruction 正确但软件未调用 | 中 | 高：加速结论无效 | I06 检查反汇编并保留实际 opcode 执行证据，比较强制软件与 ISE 路径 | 热点反汇编无 opcode；编译优化删调用；runtime fallback |
| R4 | benchmark 前后条件不同 | 高 | 高：不可比 | C04/I07 固定输入/编译器/频率/Cache/中断/计时边界，原始数据与环境元数据一起保存 | flags、频率或输入集不同；只有均值无原始记录 |
| R5 | ISE 使 FPGA 时序恶化 | 中 | 高：周期收益被频率抵消 | I08 同约束 post-route 比较；根据关键路径选择分级/多周期，重新测吞吐与延迟 | WNS<0、时序未收敛、Fmax 下降或资源超限 |
| R6 | PYNQ 板级身份/频率证据不完整 | 已降低：正点原子领航者 ZYNQ7020 + 厂家 PYNQ 2.7.0 已实板运行；完整 revision/丝印/独立频率仍缺 | 中：当前演示可运行，但提交证据和跨板保证不足 | B03 留档完整丝印/速度等级、SD 镜像/SHA/写卡、跳线照片和独立 FCLK；Y02 已锁定 bit/hwh hash | 只凭成功启动代替物理板核验；换板/换镜像后不重测 |
| R7 | PUF 不稳定 | 中（未启动） | P2 高，P0/P1 不应受影响 | P02 多次上电、温度/电压统计，报告 BER；P03 明确纠错与失败阈值 | 重建失败超预先声明阈值；未覆盖环境条件 |
| R8 | PUF 被综合器优化掉 | 中（未启动） | P2 高 | P01 检查综合后结构、布局与约束，并做受控实测；所有例外有依据 | RO 合并/删除；实现后无振荡；结构与预期不符 |
| R9 | PUF 占用主线时间 | 高 | 极高：错过核心交付 | Pxx gated；仅 P0/P1 全稳定且 10-21 门槛通过才启动；冻结前未完成就 deferred | 核心任务未 done 却做 PUF；影响 ISE/PYNQ 修复或 10-27 冻结 |
| R10 | 最终工程无法 clean clone 重建 | 已观察缺口 | 极高：无法验收 | IP/TB/部分固件已从 ZIP 恢复；B02/B04 补依赖并重建，D05 在 11-02 干净环境完整运行，保留依赖与哈希 | 缺 IP/固件/工具；依赖本机缓存；仅原开发机能运行 |
| R11 | 生成文件导致仓库臃肿 | 中：已有少量生成元数据 | 中：同步与发布困难 | ignore runs/cache/waveforms；保留精选报告；既有跟踪项完成复现后再清理 | runs、bitstream、cache 大量进入 diff；仓库大小异常增长 |
| R12 | 11-04 前未留材料冻结时间 | 中 | 极高：功能有了但无法提交 | 10-27 功能冻结、10-28 code freeze，10-29～11-01 材料，11-02 复现，11-03 仅材料修复 | 10-28 还新增功能；报告无原始数据；11-02 复现未做 |
| R13 | 误用 Kintex 或把历史结果当重建成功 | 初始 HEAD 缺 Zynq/IP；ZIP 已找齐并恢复 | 极高：无法直接上目标板 | B02 用恢复的真实 Zynq XPR/XCI 重建；B03 实物板级核验；不混用 legacy | 选择了 legacy 入口；IP regeneration/重定位失败；历史报告冒充本轮验证 |
| R14 | cycle/CPI 语义或 RV32 读取错误 | 中 | 高：测量失真 | C04 用 mcycle，测 high-low-high 与开销；CPI 仅统计事件，读 CSR 地址依实现 | 把 CPI 累加当 cycles；直接使用未实现 rdcycle 别名；高低字溢出 |
| R15 | 中文路径、编码或第三方来源信息影响发布 | 已观察路径与部分注释编码问题；来源待补 | 中至高 | 保留原件；C01 核对参考 provenance/license；D05/D06 检查发布文件名并给出无破坏映射 | 中文/空格路径进入新增文件；解码异常；第三方代码无来源记录 |

优先处置：R13 → R10 → R1 → R14/R4 → R6。缓解完成需以证据关单，不通过改概率标签消除风险。

恢复后具体剩余风险：FreeRTOS kernel 的精确源版本、bootloader 源不在所供 ZIP；RV32 CoreMark 入口 0x10001000 与复位 0x10000000 之间的启动链未复现；旧 ISA TB 层次及部分打包链接需适配。B04/V01 显式解决，禁止用文件数量代替可运行证据。
