HChenZ/amd_fpga_2026/archive/history/src/rtl/ascon_dma/readme.md

# Experimental multiblock Ascon DMA path

> 2026-11-01 scope: independent HW_DIRECT/mode4 RTL, not current PUF3. Multiblock capacity and PL cycles below
> are experiment facts, not PUF3 UART/ISE board capabilities. Do not add these modules to PUF3 for document uniformity.

Independent from the released 16-byte core. `ascon_aead_multiblock` uses the existing
Final round function, byte input memories and private candidate output storage.
`ascon_axis_direct` implements D01Q/D01R v2, mode 4 only, bounded packets and response
backpressure. Output plaintext is not readable until authentication succeeds.
No board acceptance is implied; see data/advanced/dma_direct for actual regression evidence.
