HChenZ/amd_fpga_2026/archive/history/board/vivado_zynq7000_xc7z020_pynq/handoff_20261028.md

# 2026-10-28 领航者7020 PYNQ 上板交接

> 2026-11-01：旧 PYNQ v1 交接快照；程序/身份/源集仍对应旧版，不是 PUF3 的当前运行步骤。
> 后续状态见 docs/version_entrypoints.md；下文当时未测项不改写为当时已通过。

> **2026-10-29 状态更新**：本文件保留 10-28 交接历史。文中“实板 NOT_RUN”等描述
> 已被后续实板结果覆盖。当前 Y01-Y05、V03 已完成；三模式容量内 KAT、Notebook、
> warm benchmark 和错误恢复证据见
> `validation_20261029.md`；当前总状态见 `docs/current_status_20261029.md`。

任务 Y01/Y02/Y03/Y04/V01/V04；owner TBD。今晚接收任务：B03 实物确认 → Y02 Overlay → Y03 三模式真实通信 → Y04 KAT/周期取证。

## A. 本次交付与边界

入口仓库 https://github.com/HChenZ/amd_fpga_2026 。开发分支 `feat/pynq-final-integration`，起点 `0f5d49c38597947dace3f1c99220deca8ef48e14`。最终源码与发布身份见 release/manifest.json 及 Git 历史（文档提交可能晚于源码提交）。

复用 AXI-Lite → UART FIFO Bridge → 自研 RV32 服务 → SW/MMIO/ISE。新增自动 BD/综合/实现 Tcl、真实硬件 CLI/Notebook、真实 CPU/固件联合仿真。修复 UART RX 非空位（bit1）、ISE 空尾 padding、mcycle hi/lo 一致读取、无界畸形长度 drain、重复 request_id、擦除缓冲、服务帧证据标志位、开机握手、WSTRB、满 FIFO 写响应及复位中止串口。

三种模式共用消息/AD 各 16 字节能力上限；超过立即拒绝。官方完整 KAT 1089 组在 host reference 检查，目标当前容量对应 289 组，不能把 host PASS 当作全部硬件 PASS。错误 Tag 不返回明文。

PYNQ 使用 rtl_p0/soc_top.v 与 rtl_p0/ascon_mmio.v；其余 CPU/Ascon 复用 main。与 main 两文件差异是 PUF/DNA/密钥窗口及硬件密钥选择：main 会锁定硬件 key 并忽略用户 key，不能直接用来做任意 key 的官方 KAT。本轮明确选择 P0 软件 key 路径；没有修改或覆盖原 PL-only/PUF 工程。最终100MHz bitstream已生成；setup/hold通过，DRC无Error/Critical，仍有警告，见validation。

验证结果最终见本目录 validation_20261028.md 与 build/reports/pynq_final_20261028。实板加载、Linux/PYNQ/Jupyter、PS7 MMIO 和真实速度全部 **NOT_RUN / NOT_MEASURED**。联合仿真使用行为 AXI 存储器，不等于 Xilinx BRAM/PS7 时序仿真。

## B. 文件与重建

从仓库根目录操作。Windows：

```powershell
git pull --ff-only origin main
git rev-parse HEAD
git status --short
wsl -d Ubuntu -- bash src/firmware/pynq_svc/build.sh
& E:/2025.2/Vivado/bin/vivado.bat -mode batch -notrace -source board/vivado_zynq7000_xc7z020_pynq/build.tcl
```

Vivado 路径改成自己的安装位置。Tcl 强制 2025.2、xc7z020clg400-1、pynq_wrapper，独立生成 `build/local/pynq_final/vivado/pynq_overlay.xpr`；GP0 两个 4KiB AXI-Lite 窗口为 0x40000000/0x40001000，FCLK0=100MHz。无需改原 XPR。BRAM=32×32768，COE 来自本次服务固件。无外接 PL IO，因此不套用 PL-only UART/LED XDC；PS 的 MIO/DDR 由厂家 SD boot 初始化。

依赖：Vivado 2025.2、WSL Ubuntu、RV32IM_Zicsr/ilp32 libgcc 可用的 RISC-V GCC、Python、Icarus/vvp。固件脚本支持 `CROSS_COMPILE=riscv64-unknown-elf-`、`RISCV_TOOLCHAIN=/path/bin`、`PYTHON=python3`。本次 GCC13.2.0。发布产物应在 `release/pynq.bit`、`pynq.hwh`、`pynq_svc.coe`、`pynq_svc.elf`、`pynq_svc.bin`，同名 bit/hwh 必须成对。不要将候选/失败构建当正式 release。

镜像已在本机 `E:\ZYNQ-7020-2.7.0\ZYNQ-7020-2.7.0.img`，大小 8,090,591,232 B；SHA256：

`a9a486753b8aa61239c745b258311b795d665f69cca0e9ee12a1127e51eb107a`

版本为厂家领航者7020移植 PYNQ 2.7.0。来源是用户提供并解压的厂家镜像；队友应从厂家资料盘 `4_Source_Code/5_PYNQ_Design/IMG/ZYNQ-7020-2.7.0.zip` 或厂家售后取得同版镜像，并对解压 img 校验此哈希。本轮未核验可公开下载 URL；镜像不纳入 Git。请在上板前传递这份现成 img 给持卡队友，不能用 PYNQ-Z2 镜像替换。旧 vendor_sources.json 的“未找到镜像”是当时快照，不覆盖本轮实际文件事实。

```powershell
Get-FileHash E:/ZYNQ-7020-2.7.0/ZYNQ-7020-2.7.0.img -Algorithm SHA256
```

板上校验发布文件：

```sh
cd ~/jupyter_notebooks/amd_fpga_2026
sha256sum -c board/vivado_zynq7000_xc7z020_pynq/release/sha256sums.txt
```

## C. 接线、写卡、启动（先核实实物）

依据仓库 vendor_sources.json 锁定的厂家《领航者ZYNQ之PYNQ开发指南 V3.2》§2.2–2.3（PDF p19–23）、底板 V3.9 原理图 p6、核心板 2V5 原理图 p3，及 docs/pynq_bringup_m1.md。厂家教程/原理图位于资料盘 `2_文档教程` / `3_开发板原理图和硬件相关文件`。若实物版本不同，先对照对应原图，不能盲套本节。

1. 拍照记录底板/核心板版本和 Zynq 完整丝印。暂定 -1；厂家示例 -2 不可当作本板速度等级。
2. 断电。使用板卡配套 12V DC 电源；核对电源标签与板上接口，不从 USB/JTAG 猜供电能力。
3. 用 ≥16GB TF 卡；Etcher 选择本节 img，核对目标卡容量/盘符，备份原卡后 Flash 并完成 Verify。写卡会清空目标卡。断电插卡。
4. 底板 P5 选择 PS 串口：按原图连接 1–3 / 2–4；不要同时桥 3–5 / 4–6。以实物编号和厂家图为准，禁止凭排针朝向猜针号。
5. 启动模式拨到厂家指南 §2.3 图中的 SD CARD；这里不猜拨码二进制值。拍照保存位置。
6. USB-UART 接电脑，设备管理器确认 COM；JTAG 下载线接对应 JTAG 接口，供备用 PL-only 下载。PYNQ Overlay 使用 Linux 加载，正常流程不需要 JTAG 覆盖 PL。
7. PS ENET0 网口接路由器/交换机，与电脑同网段。串口 115200/8N1/无流控，先打开记录，再上电。
8. 预期 U-Boot → Linux → login；完整保存串口原始日志。无输出或连续乱码就停止下一步，按 E 排查。
9. 厂家指南默认 xilinx/xilinx；以镜像实际提示为准。登录执行：

```sh
uname -a
cat /etc/issue
python3 --version
python3 -c "import pynq; print(pynq.__version__)"
ip -4 addr
lsblk
df -h
ls /sys/class/fpga_manager/
```

保存为 `env_20261028.txt`。预期 PYNQ 可 import、eth0 有 IPv4、fpga_manager 存在。DHCP 地址以 `ip` / 路由器租约为准。
10. 浏览器打开 `http://<实际IP>:9090`，按镜像登录（常见密码 xilinx）；新建 Python3 Notebook 执行 `import pynq; print(pynq.__version__)`，截图保存。静态地址只在实机证实后使用，不默认假设网络已通。

## D. 从 Overlay 到三模式 KAT

1. 板上准备代码。可通过 SSH/串口终端 clone/pull，若板子无法访问 GitHub，从电脑将此次已拉取的完整仓库目录通过 SCP 上传，保留 commit SHA 和 sha256sums 校验结果。

```sh
cd ~/jupyter_notebooks
git clone https://github.com/HChenZ/amd_fpga_2026.git
cd amd_fpga_2026
git rev-parse HEAD
sha256sum -c board/vivado_zynq7000_xc7z020_pynq/release/sha256sums.txt
```

若 release 中没有正式 bit/hwh，停止 Overlay 步骤，先看 validation 文档中的构建阻塞；不能用厂家 bit 或旧 PL-only bit 冒充。

2. Python 检查（PYNQ2.7 常用 Python3.8，本轮兼容处理不等于实机通过）：

```sh
python3 -c "import sys,pynq; print(sys.version,pynq.__version__)"
python3 -c "from src.pynq.mailbox_backend import MailboxBackend; from src.pynq.pynq_transport import PynqUartTransport; print('imports PASS')"
```

失败则停止保存 traceback。不要安装最新版 PYNQ 覆盖厂家环境。

3. 加载并核对 HWH/寄存器，在 Jupyter 的一个单元执行：

```python
from pynq import Overlay, MMIO
from pathlib import Path
release = Path('board/vivado_zynq7000_xc7z020_pynq/release').resolve()
ol = Overlay(str(release/'pynq.bit'))
print(ol.ip_dict)
assert ol.is_loaded()
ctl = ol.ip_dict['pynq_ctl_0']; mb = ol.ip_dict['pynq_mbox_0']
assert ctl['phys_addr'] == 0x40000000 and mb['phys_addr'] == 0x40001000
c = MMIO(ctl['phys_addr'],ctl['addr_range'])
b = MMIO(mb['phys_addr'],mb['addr_range'])
print(hex(c.read(8)), c.read(12), hex(b.read(0x1c)))
assert c.read(8)==0x514e5950 and c.read(12)==1 and b.read(0x1c)==0x4d424f58
```

预期两个独立 IP、正确 ID。0xffffffff、全零或访问挂起均失败，不继续写请求。保存 ip_dict、ID 和 bit SHA。MMIO 总线卡死不能由 Python deadline 抢占，必要时断电重启。

4. CLI 执行真实端到端检查（自动重新加载 Overlay、启动 RV32、等待 boot 服务帧、发送 epoch，逐模式执行加密/解密/错误 Tag）。

```sh
set -o pipefail
python3 src/pynq/board_demo.py --out pynq_board_result.json 2>&1 | tee pynq_board_20261028.log
```

默认每模式六个官方 KAT（容量内代表输入）。boot selftest 必须 mask=7；固件标识必须 pynq-svc-v1，模拟标志必须 false。每模式应有 KAT PASS、Tag reject，CT/tag 与官方 corpus 一致。任何异常/超时/错误明文/非零退出都停止，不允许自动切模拟。失败时保存 terminal log；CLI 只有全部成功才写最终 PASS JSON。

5. 完整容量内 KAT：

```sh
python3 src/pynq/board_demo.py --full-kat --out pynq_board_full.json 2>&1 | tee pynq_board_full.log
```

每模式 289 组加密与解密、289 次错误 Tag 拒绝。剩余 800 组因16B容量不执行，不能写1089组硬件PASS。Notebook 入口 `src/pynq/pynq_board_demo.ipynb`，修改第一单元 repo 路径后 Restart Kernel → Run All；不要同时运行 CLI 和 Notebook（共享单槽，无跨进程锁）。

6. JSON samples 的 cycles 来自每次 AEAD 调用前后64-bit mcycle；不包含 PS/UART wall time。只有 correctness/tag reject 通过的同输入/同温态 cycles 才能比较 SW/HW/ISE。为测 warm 值，应固定16B/PT、空AD、同一公开 KAT，重复运行并报告首轮与后续分布。计算 speedup=SW cycles / HW或ISE cycles；缺失写 NOT_MEASURED，不能从历史报告填入。FCLK 当前100MHz，频率实测仍待板端确认。

7. 保存资料到 `data/pynq/board_20261028/`（今晚实际执行者创建）：boot串口、环境、bit hash、CLI log/JSON、Notebook截图、板卡照片。提交前审查网络口令等敏感信息。

## E. 故障排查与备用

| 现象 | 操作与失败判据 |
|---|---|
| SD不能启动 | 断电核对镜像SHA、Etcher Verify、卡容量、SD启动模式及插卡；保存U-Boot首个错误；不要更改DDR参数碰运气 |
| 串口无输出/乱码 | 确认 USB-UART COM、115200 8N1、PS P5 唯一桥接、12V电源与启动模式；PL-only备用是另一串口跳线选择，不能两套同时接 |
| 无IP | 查PS网口Link灯、网线、路由器租约；串口 `ip link; ip -4 addr; ip route`；未核实静态IP时不要乱改交换网络 |
| Jupyter打不开 | 电脑先确认同网段，再 `curl -I http://<IP>:9090`；板上 `ss -lntp; systemctl --failed`；有SSH不代表9090已启动 |
| Overlay加载失败 | 保存 traceback、`dmesg \| tail -80`；核对bit/hwh同名、SHA、目标part与PYNQ版本；禁止用别的hwh配对 |
| HWH物理地址不符 | 只按同次构建HWH的ip_dict定位；build_profile/validate_overlay必须通过。地址不是CPU内部0x20000000/0x30000000 |
| AXI读取异常 | 先查ID、GP0、FCLK/复位；读挂起需板级重启。厂家FSBL配置和2025.2 hwh解析尚需实板确认 |
| FIFO数据丢失 | RXSTAT bit18溢出、CNT字节数与原始流一起记录；UART两线没有远端反压；单次最大响应80B可放256B FIFO，但启动文本必须及时排空；禁止多个进程并发 |
| RV32服务没起来 | 控制默认保持复位；Transport释放后先等boot服务帧才发epoch。检查svc COE是否烧入、boot mask=7；不可把STAT复位释放当固件ready |
| KAT错误 | 停止性能演示，保存mode/KAT号/expected/actual/源码与bitSHA；优先查源集是否误用带PUF硬件key覆盖的main SoC |
| cycles异常 | 核对64位mcycle证据、同长度/AD/模式、冷暖与编译器；不要把crypto-core计数或Python wall-time替换mcycle |
| 超时/半帧 | 不自动重试旧请求。MailboxBackend recover执行SoC复位、清链路、更换epoch；或重新运行CLI加载Overlay。固件阻塞收半帧的本地超时尚未实现，必须由主机超时后复位；不能继续往旧流追加请求 |
| 真实通信没通 | 明确记录PYNQ链路FAIL/NOT_RUN；保留host模拟展示时必须显式simulated，cycles=NOT_MEASURED；同时走下述原PL-only演示 |

PL-only备用：按 `docs/freeze_checkpoint_20261027.md`、`board/vivado_zynq7000_xc7z020_ascon/readme.md` 使用已经上板验证的三版镜像，P5切PL串口、JTAG加载、115200抓KAT与周期。冻结索引给出三份bit SHA。当前仓库历史三份bit原本只在原构建机build/local，本机检索未发现匹配文件，因此不得声称pull即可取得这三份旧bit：应由持有原文件的队友提供并核对冻结SHA，或在独立副本按冻结源/COE重建（重建属于新产物、需重新验收）。保留原始COE与板级日志；不要用现在带硬件key覆盖的源集无说明地重建任意key KAT。

## F. 晚间验收记录（执行者填写）

- 执行者/时间：TBD / 2026-10-28 23:58（Asia/Shanghai）
- 底板/核心板版本、芯片完整型号/速度级、照片：PYNQ 启动并运行；照片/完整丝印与速度级仍 NOT_RUN
- img SHA/来源、SD厂商/容量、写卡校验：PYNQ 环境已运行；img/SD 写卡证据仍 NOT_RUN
- Linux / PYNQ / Python：PASS，PYNQ 2.7.0 / Python 3.8.2
- main commit、bitstream SHA256、hwh SHA256、manifest：PASS，详见 `data/pynq/board_20261028/identity.txt`
- P5/SD模式/电源/JTAG/UART连接照片：NOT_RUN
- boot与环境原始日志：PASS，`env_20261028.txt` 与 `data/pynq/board_20261028/identity.txt`
- AXI控制ID/mailbox ID/ip_dict：PASS，Overlay 加载与 MMIO ID 检查通过
- 服务帧 firmware_id / boot_id / epoch / selftest mask：PASS，`pynq-svc-v1` / boot_id 771 / epoch 1 / mask 7
- SW KAT / decrypt / tag reject：PASS，容量内 289/289；当前 JSON 的 board_demo 结果包含加密与坏 Tag 拒绝
- MMIO KAT / decrypt / tag reject：PASS，容量内 289/289；当前 JSON 的 board_demo 结果包含加密与坏 Tag 拒绝
- ISE KAT / decrypt / tag reject：PASS，容量内 289/289；当前 JSON 的 board_demo 结果包含加密与坏 Tag 拒绝
- 容量内289组/模式、未支持800组是否明确：PASS，三模式各289/289；超容量800组 `NOT_RUN`
- 同输入warm cycles SW/HW/ISE及重复次数：已采集每次调用 `mcycle`；最终 warm benchmark/重复次数仍 NOT_MEASURED
- 加速比、PS端wall time、频率证据：mcycle 原始样本已采集；最终加速比统计、PS端 wall time 与独立频率证据仍 NOT_MEASURED
- Vivado构建WNS +0.034ns / TNS0 / WHS+0.020ns；DRC0 Error/0 Critical，warnings见validation；实板 bit/hwh/firmware SHA 见 `data/pynq/board_20261028/identity.txt`
- 失败原始日志、恢复步骤、最终结论：实板首次环境兼容问题已保留在终端日志；完整错误场景/恢复演练与最终冻结结论仍 NOT_RUN

最终硬件/固件对应源码提交：`86dc10f13e96adbb360f1adfe0c4891ce2f8e2a7`。发布目录含bit/hwh/COE/ELF/BIN、manifest与sha256sums，已在WSL逐项校验PASS。真实HWH生成profile并validate_overlay自检PASS（静态地址/哈希检查，非板上加载）。

修改文件完整清单：changed_files_20261028.txt。manifest的source_dirty=true包含打包时尚未提交的release生成文件；生产源码由source_commit与source_sha256锁定，最终Git工作区状态另在交付报告中核验。
