HChenZ/amd_fpga_2026/archive/history/docs/project_abstract.md

# 项目简介（draft v2，2026-10-27）

> 2026-11-01：本稿已被 project_intro_20261101.md 取代。下文 PL-only 数字、PUF v2失败片段和“后续完成PYNQ”
> 均保留当时语境，不可直接用于当前提交；本页“投稿定稿”也是旧稿，不代表最新 PDF。当前入口见 version_entrypoints.md。

> 依据当前仓库实测证据改写，替换队友 v1。所有数字可在 `docs/freeze_checkpoint_20261027.md`
> 与 `data/ascon/results/board/` 中追溯到原始报告或串口日志。

## 正文

本作品面向嵌入式数据安全与高效计算场景，基于 AMD Zynq-7000（XC7Z020CLG400-1，正点原子
领航者 ZYNQ7020 开发板）平台，设计并实现集成轻量级密码加速的 RISC-V 处理器 SoC，并打通了
从 RTL 仿真、官方测试向量、自动化回归到实板运行的完整链路。

处理器为自研五级流水线 RV32IM + Zicsr 软核，包含动态分支预测、指令/数据 Cache、AXI 总线，
以及 UART、GPIO、CLINT 等外设；系统由 50 MHz 外部时钟经 PLL 倍频至 100 MHz 工作，128 KiB
指令/数据存储器通过 AXI 提供。

密码部分实现符合 NIST SP 800-232 标准的 Ascon-AEAD128 认证加密，并给出三种递进的实现形态：
① 纯软件（SW）；② 存储器映射硬件加速（MMIO，CPU 仅搬运参数并轮询状态）；③ 自定义指令扩展
（ISE，把 P12/P8 置换作为 custom-0 指令并入流水线）。三者共享同一套 Ascon 状态与测试向量，
可逐字节交叉对照，用于量化"ISA 扩展"与"总线外设"两条加速路线的差异。

验证体系分四层：RTL 模块级测试（置换/AEAD、Cache 事务契约、CPU 中断抢占）、CPU 级全 SoC
仿真（三套固件 + 官方 KAT + 篡改拒绝）、基于 Icarus Verilog 的自动化回归入口（smoke 6 项、
完整 regression 13 项，一条命令产出 JSON/Markdown 报告），以及实板验证。固件与 BRAM 初值
COE 由脚本统一生成，并对 RTL、COE、bitstream、串口日志做 SHA-256 冻结与索引。

实板实测（同一块板、100 MHz、16 字节加密、warm、CSR mcycle 计数）：纯软件 20806 拍；ISE
2570 拍（8.10×）；MMIO 端到端 688 拍（30.2×），其中密码核本体仅 103 拍。三套实现的官方测试
向量、解密往返与篡改拒绝在板上全部通过。三份 bitstream 的时序均为 WNS +0.087 ns、TNS 0、失败
端点 0、DRC 无错误。

在硬件信任根方向，已完成 256 路环形振荡器（RO）物理不可克隆函数与 57 位 Device DNA 的密钥
子系统：RO 阵列独立 pblock 隔离、自时钟计数、多次采样表决与抖动位掩码，经 Ascon P12 派生
128 位密钥，密钥仅在硬件内部流动、CPU 不可读写。板上实测 enroll 质量 127/128、DNA 可读、
参考响应与本次测量一致；多次复用（enroll → reconstruct）的握手缺陷已定位并加固（忙时请求
排队 + 采样看门狗），待板级复测。

后续工作：完成 PS/PL 通信与 Python/Jupyter 交互界面（受厂家 PYNQ 镜像缺失影响，采用串口
通道降级方案并行推进）；补充板上 ISA 抽样回归与 PUF 的复位/温压稳定性统计；细化三套实现的
端到端性能对比与可复现材料。

关键词：RISC-V；Ascon-AEAD128；自定义指令扩展；MMIO 加速器；RO PUF；Zynq-7000

## 与 v1（队友稿）的差异说明

1. **补齐 MMIO 数据**：v1 只写了 SW 与 ISE 两个数字，漏掉了端到端 688 拍 / 30.2×，
   而这是三种方案对比里最能说明"外设式加速 vs ISA 式加速"取舍的一行。
2. **"初步板级测试" → 三套已全部板级闭环**：SW/ISE/MMIO 的 KAT 与 benchmark 都在板上跑过，
   不是"初步"；v1 把已完成的事写成待办，评审会低估进度。
3. **"后续将进一步完善性能对比与板级验证"** 已不成立，改为真实剩余项：PYNQ/PS-PL、板上 ISA
   抽样、PUF 稳定性统计。
4. **补充验证与可复现性**：自动化回归入口（smoke/regression）、KAT 覆盖、哈希冻结与索引，
   这是评审判断"数据可信"的关键，v1 只有一句"自动化回归测试"。
5. **补充 PUF 实际进度**：v1 只有"探索 PUF 密钥生成"，实际已完成 RTL、仿真、STA 与板上
   enroll；同时如实写明 reconstruct 复用缺陷待复测，不夸大。
6. **明确 100 MHz 与 WNS/DRC**：避免把"板子上能跑"与"时序/DRC 签核"混为一谈；同时注明
   IO 时序未签核属于已知项（正文不展开，材料中另附）。

## 注意（写进材料前需知）

- 26 组官方 KAT 在 target 上是"代表向量 + 篡改拒绝"，完整 1,089 组仍在 host 侧；不要写成"全量 KAT 板上通过"。
- MMIO 版受寄存器窗口限制仅支持 ≤16 B，正文已体现，材料中不要泛化为"任意长度"。
- PUF 的 reconstruct 目前是"缺陷已修、待复测"，不能写成"已通过"。
- IO 时序未签核（`no_input_delay`/`no_output_delay` 为已知项），WNS +0.087 ns 是芯片内部时序。
## 投稿定稿（一段话，含展望，438 裸字符 / 汉字 224 / Word 式 262）

本作品面向嵌入式数据安全场景，基于 AMD Zynq-7000（XC7Z020）平台，设计实现集成轻量级密码加速的 RISC-V 处理器 SoC。处理器采用五级流水线架构，支持 RV32IM、Zicsr 指令集，集成动态分支预测、指令与数据 Cache、AXI 总线及 UART、GPIO、CLINT 等外设，工作在 100 MHz。在此基础上，引入符合 NIST SP 800-232 的 Ascon-AEAD128 认证加密算法，设计纯软件（SW）、存储器映射硬件加速（MMIO）与自定义指令扩展（ISE）三种实现方案。已完成三者的 RTL 仿真、官方向量验证、自动化回归与镜像生成，并在领航者 Zynq-7020 开发板上完成实板运行。板级实测 16 字节加密：软件 20806 周期，ISE 2570 周期（8.10 倍），MMIO 端到端 688 周期（30.2 倍），时序余量为正、DRC 无违例。此外完成基于 256 路环形振荡器与芯片 DNA 的 PUF 密钥子系统，板上注册质量 127/128。后续将推进 PS/PL 与 Jupyter 交互展示。
