HChenZ/amd_fpga_2026/archive/history/docs/timing_route_replication_r2.md

# 扇出复制第二轮：单根/双根定点复制实测（2026-10-25）

> 2026-11-01：10-25独立对照实验记录，不是当前PUF3的复现凭据或新修改授权。
> 原成败与快照保留；当前候选见 version_entrypoints.md。

工具 Vivado 2025.2，part `xc7z020clg400-1`，top `top_pl_bram`，策略
`Performance_ExploreWithRemap`，核心约束 10.000 ns（`clk` 输入 20.000 ns，`clk_wiz_0` ×2）。
RTL 为当前 `src/rtl`（C + D 已落地，`dcache.v`/`cpu_core.v`/`crypto_aead.v` 的 sha256 见各臂
`build_context.txt`）。**实验期间 `src/rtl`、`board/`、XDC 一律未改动**，全部变体都是
`build/local/tests_20261025/<tag>/` 下的副本。owner TBD。

本轮回答的是 `html_v2/rtl.html` R1 节留下的那个问题：**上一轮对 4 根 `sel_*` 网的
`-force_replication_on_nets` 一个副本都没生成，那么"只拆 1~2 根"能不能生成副本？**

---

## 1. 结论先行

1. **一根都拆不出来，而且与选几根、选谁、属性写在哪、MAX_FANOUT 取多少、用哪个 directive 全都无关。**
   8 个臂里凡调用了 `-force_replication_on_nets` 的 6 个，副本数一律 **51 → 51**，FF 一律
   **17187 → 17187**，LUT 一律 13478；日志一字不差是
   `Identified N candidate nets for fanout optimization` → `Optimized 0 net. Created 0 new instance.`
   （N = 1 / 2 / 4）。**单根（页面建议的那个实验）同样被拒。**
2. **上一轮那个 +0.184 与复制毫无关系，它是一个"开关"效应**：只要在 `PHYS_OPT_DESIGN.TCL.POST`
   里调一次 `phys_opt_design -force_replication_on_nets` 并**点到那几根 sel 网**，WNS 就从
   **+0.087 → +0.184**（本轮 6 个臂 + R2C 2 个臂，共 8 次逐位相同）；而**裸 `phys_opt_design`
   （不带 -force 选项）仍是 +0.087**，**把同一句调用点到一根 fo=3 的无关小网上只有 +0.073**。
   收益 0.097 ns，代价 0 副本 / 0 FF / 0 LUT / 0 周期。
3. **机制定位：布局没变，变的是布线。** 两臂的 post-place 检查点里 32579 个原语的 `NAME→LOC`
   **逐行 diff 为空**；布线后只有 35 个单元不同 → +0.097 全部来自**布线解**（同一张布局、同一张净表）。
   属性（`MAX_FANOUT`/`EQREG`）经 `r2_noprop` 证明是空动作；连调两次（`r2_x2`）也不叠加。
4. **sel_\* 不是"复制能解"的墙**。+0.184 网表里新最差是
   `id_ex_u/sel_ex_mem_rs1_o_reg → u_if_id/pred_target_o_reg[12]/D`：
   **13 级逻辑、logic 3.520 ns、net 5.808 ns（62%）**，其中 8 级是 CARRY4 串起来的
   32 位地址增量链（`u_mem_wb/captured_addr_reg[*]_i_1/CO` 竖向 X57Y33→Y39），
   单根网的走线只占 0.955 ns。**复制一根 172 扇出的使能位解决不了 8 级进位链。**
5. `-force_replication_on_nets` **不允许在 post-route 阶段使用**（本轮 preflight 实测报
   `ERROR: [Vivado_Tcl 4-265] Option -force_replication_on_nets is specified but not supported yet
   for post-route physical synthesis`），所以这个杠杆只能在 `PHYS_OPT_DESIGN.TCL.POST`（放置后、布线前）用。

---
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
