HChenZ/amd_fpga_2026/docs/tech_report/figs/fig_2_1.pdf

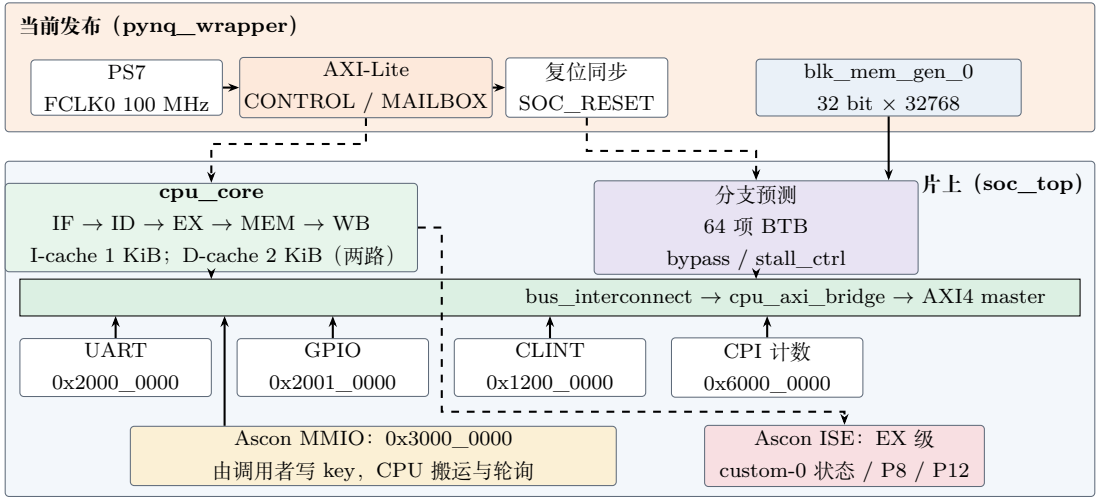
[picture p32: page 1]
当前发布（pynq_wrapper）; FCLK0 100 MHz; AXI-Lite; CONTROL / MAILBOX; 复位同步; SOC_RESET; blk_mem_gen_0; 32 bit × 32768; cpu_core; 片上（soc_top）; 分支预测; 64 项 BTB; bypass / stall_ctrl; UART; GPIO

IF → ID → EX → MEM → WB
I-cache 1 KiB；D-cache 2 KiB（两路）

bus_interconnect → cpu_axi_bridge → AXI4 master

CLINT CPI 计数 0x1200_0000 0x6000_0000

Ascon MMIO：0x3000_0000
由调用者写 key，CPU 搬运与轮询

Ascon ISE：EX 级
custom-0 状态 / P8 / P12
