HChenZ/amd_fpga_2026/docs/tech_report/figs/fig_2_11.pdf

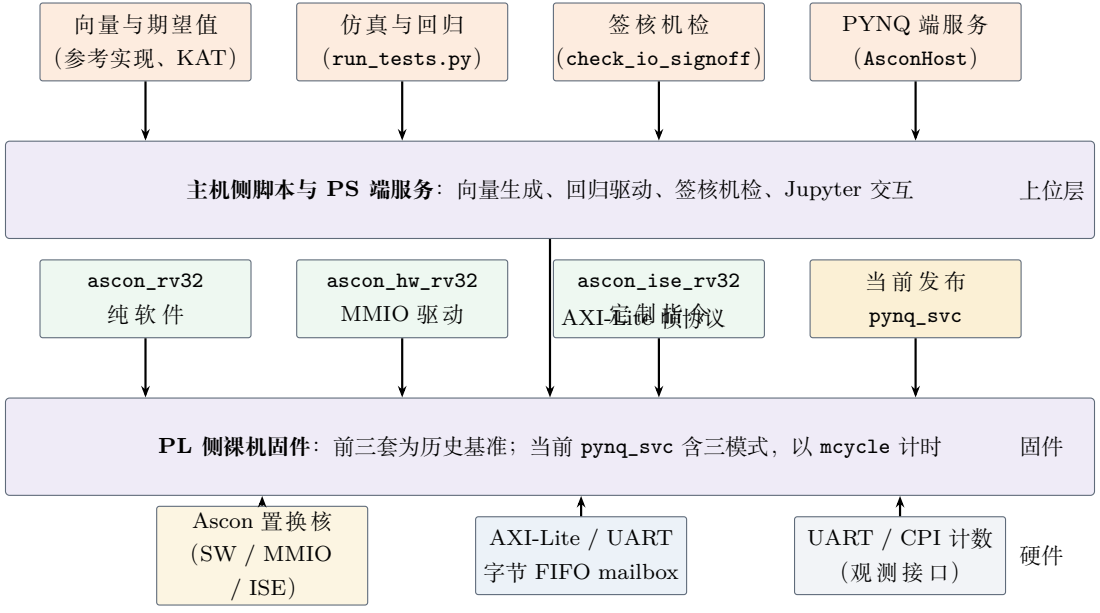
[picture p33: page 1]
向量与期望值; （参考实现、KAT）; 仿真与回归; （run_tests.py）; （check_io_signoff）; PYNQ 端服务; （AsconHost）; ascon_rv32; ascon_hw_rv32; MMIO 驱动; ascon_ise_rv32; pynq_svc; Ascon 置换核; （SW / MMIO; / ISE）; AXI-Lite 帧协议; 上位层

主机侧脚本与 PS 端服务：向量生成、回归驱动、签核机检、Jupyter 交互

PL 侧裸机固件：前三套为历史基准；当前 pynq_svc 含三模式，以 mcycle 计时

AXI-Lite / UART
字节 FIFO mailbox

UART / CPI 计数
