HChenZ/amd_fpga_2026/docs/tech_report/figs/fig_2_3.pdf

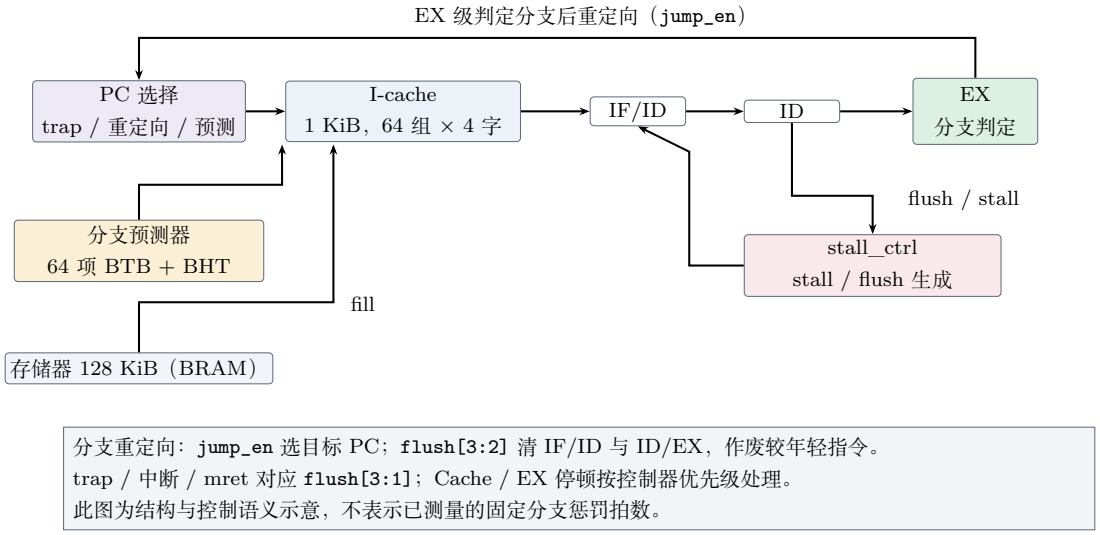
[picture p34: page 1]
I-cache; 1 KiB，64 组 × 4 字; 分支判定; 分支预测器; 64 项 BTB + BHT; fill; flush / stall; EX 级判定分支后重定向（jump_en）

trap / 重定向 / 预测

stall_ctrl
stall / flush 生成

存储器 128 KiB（BRAM）

分支重定向：jump_en 选目标 PC；flush[3:2] 清 IF/ID 与 ID/EX，作废较年轻指令。
trap / 中断 / mret 对应 flush[3:1]；Cache / EX 停顿按控制器优先级处理。
此图为结构与控制语义示意，不表示已测量的固定分支惩罚拍数。
