HChenZ/amd_fpga_2026/docs/tech_report/figs/fig_2_4.pdf

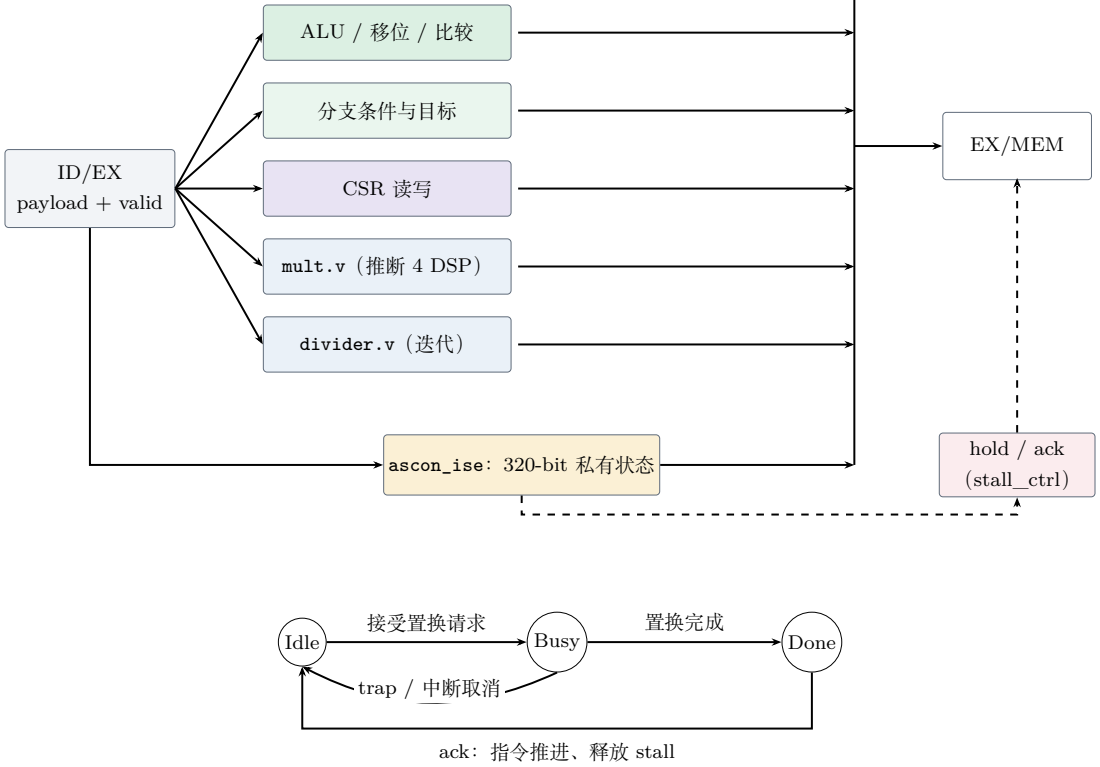
[picture p35: page 1]
payload + valid; 分支条件与目标; CSR 读写; divider.v（迭代）; ascon_ise：320-bit 私有状态; EX/MEM; hold / ack; （stall_ctrl）; Idle; Busy; Done; 接受置换请求; 置换完成; trap / 中断取消

ALU / 移位 / 比较

mult.v（推断 4 DSP）

ack：指令推进、释放 stall
