HChenZ/amd_fpga_2026/docs/tech_report/figs/fig_1_1.pdf

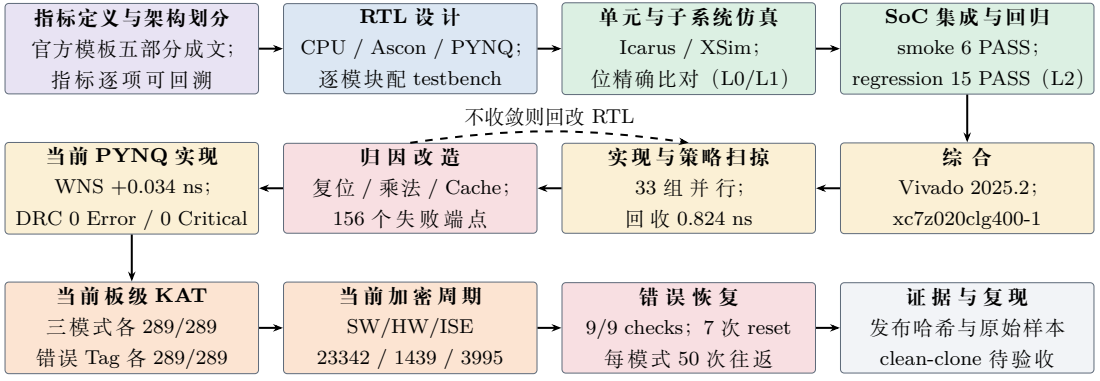
[picture p36: page 1]
指标定义与架构划分; 官方模板五部分成文；; 单元与子系统仿真; Icarus / XSim；; 位精确比对（L0/L1）; SoC 集 成 与 回 归; smoke 6 PASS；; regression 15 PASS（L2）; Vivado 2025.2；; xc7z020clg400-1; 复位 / 乘法 / Cache；; 当 前 板 级 KAT; 三模式各 289/289; 错误 Tag 各 289/289; SW/HW/ISE; 9/9 checks；7 次 reset; 每模式 50 次往返; 发布哈希与原始样本; clean-clone 待验收; 不收敛则回改 RTL

RTL 设 计
CPU / Ascon / PYNQ；
逐模块配 testbench

当前 PYNQ 实现
WNS +0.034 ns；
DRC 0 Error / 0 Critical
