HChenZ/amd_fpga_2026/docs/tech_report/figs/fig_2_8.pdf

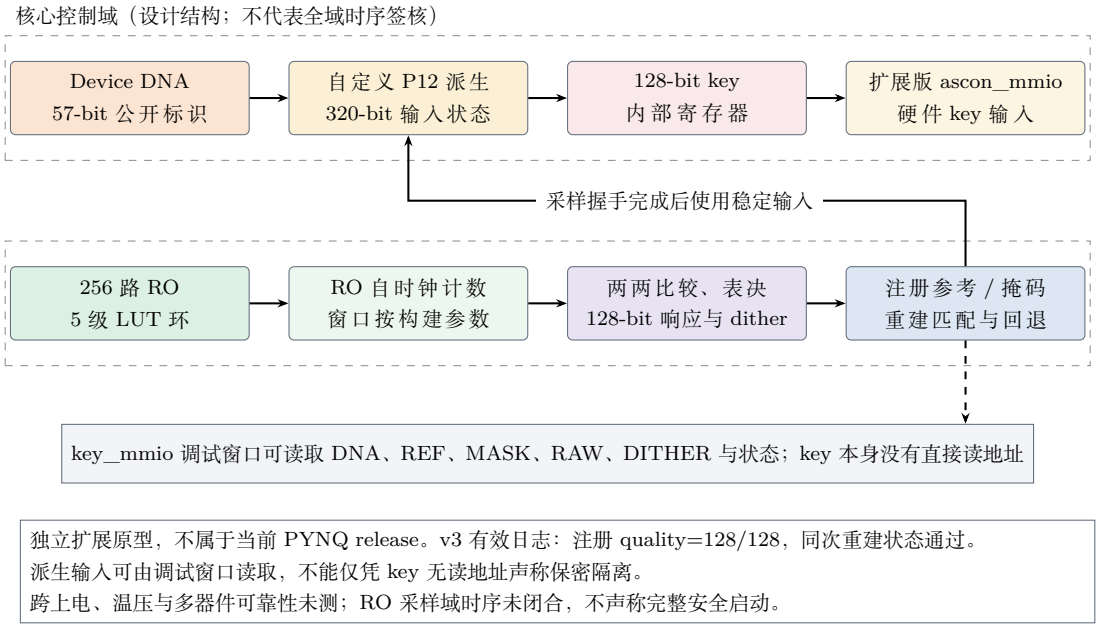
[picture p38: page 1]
Device DNA; 57-bit 公开标识; 自定义 P12 派生; 320-bit 输入状态; 128-bit key; 扩展版 ascon_mmio; 硬 件 key 输 入; 5 级 LUT 环; RO 自时钟计数; 窗口按构建参数; 注册参考 / 掩码; 重建匹配与回退; 采样握手完成后使用稳定输入

核心控制域（设计结构；不代表全域时序签核）

两两比较、表决
128-bit 响应与 dither

key_mmio 调试窗口可读取 DNA、REF、MASK、RAW、DITHER 与状态；key 本身没有直接读地址

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
