HChenZ/amd_fpga_2026/docs/tech_report/figs/fig_2_9.pdf

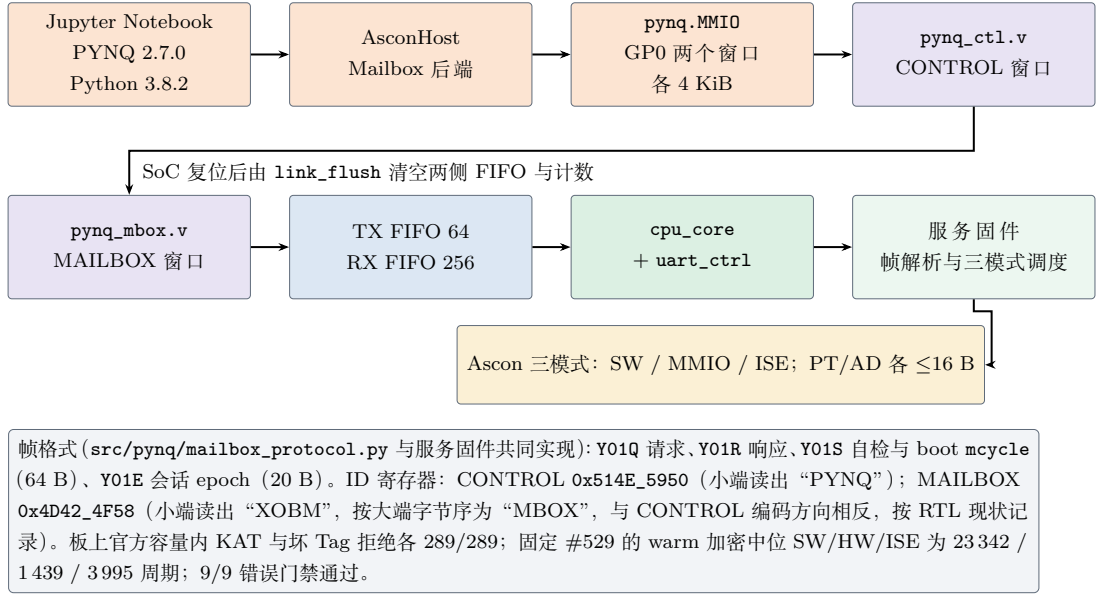
[picture p39: page 1]
Jupyter Notebook; PYNQ 2.7.0; Python 3.8.2; AsconHost; Mailbox 后端; pynq.MMIO; GP0 两个窗口; 各 4 KiB; pynq_ctl.v; CONTROL 窗口; pynq_mbox.v; MAILBOX 窗口; TX FIFO 64; RX FIFO 256; cpu_core; + uart_ctrl; 帧解析与三模式调度

SoC 复位后由 link_flush 清空两侧 FIFO 与计数

Ascon 三模式：SW / MMIO / ISE；PT/AD 各 ≤16 B

帧格式（src/pynq/mailbox_protocol.py 与服务固件共同实现）：Y01Q 请求、Y01R 响应、Y01S 自检与 boot mcycle
（64 B）、Y01E 会话 epoch（20 B）。ID 寄存器：CONTROL 0x514E_5950（小端读出“PYNQ”）；MAILBOX
0x4D42_4F58（小端读出“XOBM”，按大端字节序为“MBOX”，与 CONTROL 编码方向相反，按 RTL 现状记
录）。板上官方容量内 KAT 与坏 Tag 拒绝各 289/289；固定 #529 的 warm 加密中位 SW/HW/ISE 为 23 342 /
1 439 / 3 995 周期；9/9 错误门禁通过。
