HChenZ/amd_fpga_2026/(commit log)

2026-09-12 docs: 新增 README 文档
2026-09-16 fix: 将板卡型号更改为 xc7k325tffg676-2L
2026-09-18 feat: 新增 Python 版 Ascon 加密算法代码
2026-09-19 feat: 新增 C 语言版 Ascon 加密算法代码
2026-09-19 feat: 新增 load_bytes 模块
2026-09-20 feat: 新增 store_bytes 模块
2026-09-20 feat: 新增 ror 模块
2026-09-21 feat: 新增 round 模块
2026-09-21 chore(repo): restore XC7Z020 baseline and establish project foundation
    Restore the archived CICC1000023 XC7Z020 source configuration, preserve the Kintex-7 migration as legacy, add firmware and verification assets, and establish project documentation, task tracking, reproducibility, and repository structure. B01 complete; B02 rebuild verification remains in progress; physical XC7Z020 board identification remains pending.
2026-09-21 chore(archive): restore CICC1000023 XC7Z020 baseline assets
    Restore the original CICC1000023 XC7Z020 Vivado source configuration,
    firmware sources, verification inputs, recovery data, and selected
    historical implementation evidence.
    Historical source formatting and line endings are intentionally
    preserved for traceability. This commit does not claim a new Vivado
    rebuild, implementation, bitstream generation, or board-level
    verification.
    [archive_inventory.csv]
2026-09-21 chore(repo): establish AMD FPGA project foundation
    Establish project documentation, task tracking, development workflow,
    risk and decision records, reproducibility structure, and collaboration
    conventions for the AMD 2026 FPGA project.
    B01 is complete.
    B02 XC7Z020 baseline rebuild verification remains in progress.
    The target FPGA part is xc7z020clg400-1.
    Physical board identification and PYNQ image validation remain pending.
2026-09-25 feat: 新增 pad 模块
2026-09-25 feat: 新增 p12 和 p8 模块
2026-09-25 feat: 新增 Ascon 所需的部分常量定义
2026-09-26 fix: 修复 ascon_constants.vh 中常量定义的语法问题
2026-09-27 feat: 新增完成标志到 p12 和 p8 模块
2026-09-27 feat: 新增 crypto_aead_encrypt 模块
2026-09-27 fix: 修复了一些问题
2026-09-29 fix: 修改数据位宽
2026-09-29 fix: 修改 adlen 和 mlen 的位宽，以及字节获取模块的实现
2026-09-29 fix: 修改 ascon_aead.v 文件的编码
2026-09-29 fix:增加注释和修改pad加1位置
2026-10-06 fix:增加握手接口，给下一步主程序修正时序做准备
2026-10-07 将pad更改回去
2026-10-07 fix: 将ascon_aead重写，并完成测试全部通过，可以正常使用
2026-10-07 更改ascon_permutation的rst_n定义
2026-10-07 fix: 修改部分位宽问题，删去 get_bytes 模块
2026-10-07 测试：添加 NIST Final KAT 验证基线
2026-10-07 测试：添加独立 Ascon RTL 回归
2026-10-07 修复：完善 Ascon 解密认证失败处理
2026-10-07 文档：更新项目进度与 Ascon 验证状态
2026-10-07 清理：移除旧版 Ascon AEAD 实现
2026-10-07 fix: 在 ascon_aead_2_tb.v 中添加 ascon_aead_2.v 的引用
2026-10-08 fix:加入解码，还没进行KAT测试，但是通过tb反向数据
2026-10-10 refactor: 移除未使用的 get_bytes 模块
2026-10-10 feat: 合并文件并且经过tb验证通过，可以再次检查
2026-10-15 feat: 完成两版的优化
    [software_benchmark_sim_20261015.csv]
2026-10-15 feat: 完成ISE的实现
2026-10-17 fix(ascon): harden key lifecycle and validate pre-board timing
    Verify dynamic keys, failure-output protection, ZEROIZE and ISE pipeline interactions. Preserve all regression and implementation evidence. 100 MHz timing not met after two rounds (WNS -0.177 ns, TNS -2.968 ns); board validation remains pending.
    [ascon_mmio.v, axi_slave_bram.v, cpu_core.v, ex_stage.v, if_id.v, key_lifecycle_firmware.c, main.c]
2026-10-17 fix(verification): reject incomplete snapshots and record tooling review
    Close the code-review evidence-gate finding with five targeted tests. Record Ross download/session blocking and selected Matt Pocock skill installation/discovery. Keep RTL, firmware, constraints and implementation results unchanged; 100 MHz timing remains unmet.
    [evidence_snapshot.py]
2026-10-18 feat: 优化到时序为正
    [failing_endpoints.csv, strategy_sweep_summary.csv]
2026-10-23 fix: 添加部分模块的引用
2026-10-24 perf(timing): 100 MHz 提余量实测（C store buffer 落地路线、F 否定、80 MHz 重跑纠正）
    实测四条候补路线（Vivado 2025.2 / xc7z020clg400-1 / top_pl_bram / 10 ns），
    src/rtl、board/、XDC 均未改动，全部在 build/local 副本上跑：
    - C（dcache 1 项 store buffer + valid/LRU 更新寄存一拍 + store→load 定向转发）
    是唯一正收益且真正 0 周期的改动：WNS +0.007 → +0.057、TNS 0、0 失败端点、
    BRAM 38.5 → 34.5 tile；目标族 dcache/valid_way·lru 终点 192 → 12 条
    （worst +0.143 → +1.752）；6 场景 KAT 与全部 cycles 不变（hw full MMIO 仍 670 拍）。
    - F（MMIO 写译码寄存化）按设计生效（bu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
    [module_bbox.csv, paths_c100.csv, paths_ctl.csv, paths_f100.csv]
2026-10-24 perf(timing): 落地 C（dcache store buffer），并撤掉导致 elaboration 失败的 include
    src/rtl/dcache.v —— 应用 build/patches/timing_C_dcache_store_buffer.patch：
    1 项 store buffer（本拍只锁存 {地址,数据,字节掩码}，下一拍提交 BRAM）、
    valid/LRU 更新寄存一拍、store→load 按字节掩码定向转发；
    data_way0/1 改为真正的 SDP（Port A 只读，Port B 由 fill 与 buffer 提公共用，fill 优先）。
    实测（Vivado 2025.2 / xc7z020clg400-1 / top_pl_bram / Performance_ExploreWithRemap / 10 ns，
    与 build/reports/tests_20261024/c_100 同源）：
    - WNS +0.007 → +0.057，TNS 0，失败端点 0，WHS +0.023 → +0.019
    - LUT 11509 → 11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
2026-10-24 perf(timing): 落地 D（中断可接受判决拆拍），100 MHz 芯片级余量到 +0.087 ns
    src/rtl/cpu_core.v —— 应用 build/patches/timing_D_interrupt_guard_register.patch：
    `inter_accept_ready` 里唯一 pc 衍生的 `!icache_stall` 拆出来只驱动一个触发器
    `inter_slow_ok_q`，当拍再与全部快项（id_ex_inst_valid / dcache_stall /
    dmem_axi_stall_req / ex_stall_req / fence_i_stall）相与。csr_file 的
    “一次脉冲 + inter_req_reg 锁存”语义未改。
    要切掉的路径（C 之后整机最差，+0.057 ns / 9 级 / logic 2.0 / route 7.59）：
    pc_reg → u_icache tag RAM → hit_way0 → icache_stall
    → csr_file/inter_req → stall_ctrl 优先级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
    [paths_d100.csv]
2026-10-24 perf(timing): 大扇出节点放置后定点复制，单根 state[3]（fo=628/9.29 ns）拆开后 +0.127 ns
    问题：C+D 之后整机最差路径是一条 1 级逻辑、9.870 ns 的路径，94% 是走线：
    u_crypto_aead/FSM_sequential_state_reg[3]/Q
    → net u_crypto_aead/state[3] fo=627 route 9.290 ns (SLICE_X35Y87 → SLICE_X102Y90)
    → LUT5 → u_crypto_aead/p12_in_reg[215]/D
    state[3] 是 crypto_aead.v 的 FSM 状态位，扇出到整条 datapath 的使能/选择锥。
    全局最大扇出是复位分发网 u_ascon_mmio/rst_sync_reg[2]（fo=9757），但不在关键路径上。
    新增脚本（受控目录 build/timing_tests/）：
    - probe_fanout.tcl —— 导出全局大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
2026-10-24 perf(timing): 追加复制臂证明复制一根就够——第二轮复制 9 根反而 +0.130→+0.055
    rep2_sel 以 rep_ff400 的网表为种子，再复制 pc_o[5/6]（fo 218/215）、func_sel_o[0]（137）、
    ascon_mmio/Q[0]、p12_inst/Q[0] 等 9 根：WNS +0.055，比只复制 state[3] 的 +0.130 差 0.075。
    那些是数据/地址位而不是使能锥，复制只多出副本并扰动布局。
    结论：扇出复制要外科手术式地停在关键路径上的那根使能网，继续加反而变差。
    docs/timing_route_tests_20261024.md §10.3 增加该臂与结论；project_log 同步。
2026-10-24 perf(timing): 复制步骤接入生产策略后重测——收益不复现（+0.087 → +0.039）
    新增 build/timing_tests/run_prod_rep.tcl：仍用 -strategy Performance_ExploreWithRemap，
    只给 STEPS.PHYS_OPT_DESIGN.TCL.POST 挂复制钩子（放置后、布线前），策略/directive 一字不改。
    起点为当前 src/rtl（C+D 已落地）。
    prod_ctl 无钩子 WNS +0.087 失败 0 WHS +0.021 replica 51
    prod_rep1 只复制 state[3]（fo 628） WNS +0.039 失败 0 WHS +0.020 replica 60
    prod_rep 复制 2 根 WNS +0.039 失败 0 WHS +0.020 replica 60
    - prod_ctl 逐位复现 d_100（+0.087、同一条最差路径 9.870/net 9.290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
2026-10-25 docs(skill): 收入 rtl-design-discipline（Hardware-First RTL）到 skill/
    队友 2026-10-17 提出的通病（AI 写 Verilog 时同一逻辑写出一堆等价废话、打补丁式改代码、
    不关心综合出什么硬件、生成无必要的组合逻辑）所形成的通用 skill，逐字节复制进 skill/ 受控目录，
    供协作方与提交材料直接取用。
    - skill/rtl-design-discipline/SKILL.md：9 条纪律 + 与 Verilog Design Flow / karpathy / hls-* 的分工，
    sha256 ca5413cdc9f1298532e435a69913b4ea33740b9a63fb9a4dadb270e73badc7ed（与 agent 侧同源）
    - skill/readme.md：改为「已交付 / 预留」两段，写明依赖、输入输出、执行步骤、成功判据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
2026-10-25 test(dcache): replace stale timing checks and pass full regression
    [tb_cpu_interrupt.v, tb_dcache.v, tb_dcache_contract.v]
2026-10-27 feat(board): 三套 Ascon 镜像上板通过（KAT 6/6，8.10×/30.2×），新增上板工程与冻结索引
    板级结果（同一块领航者 ZYNQ7020，100 MHz，warm 16B 加密）：
    - 软件版 20806 cyc（1.0×）
    - ISE 版 2570 cyc（8.10×，custom-0 置换指令）
    - MMIO 版 688 cyc 端到端（30.2×，裸 crypto 103 cyc）
    三轮实现均 WNS +0.087 ns / TNS 0 / 0 失败端点 / WHS +0.021 / 0 布线错误 / DRC 0 Error；
    KAT 全 PASS（含解密往返与篡改拒绝；MMIO 另有 16B 长度拒绝）。
    本轮改动：
    - 新增 board/vivado_zynq7000_xc7z020_ascon/：独立上板工程（Vivado 2025.2，手工新建，
    源以 $PPRDIR 相对引用 src/rtl 与 src/rtl/ascon，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
    [const.xdc]
2026-10-27 feat(keys): 收入 RO-PUF/Device DNA 密钥子系统与后端时序实验工具与证据
    密钥子系统（P2 原型，仿真 PASS、未上板、未进上板工程）：
    - src/rtl/keys/：device_dna（57-bit DNA_PORT）、ro_unit（LUT2/LUT1 原语环）、
    ro_puf_core（256 RO 自时钟计数 + 25 MHz 慢时钟域 + 跨域握手 + M 次表决）、
    puf_key（enroll/reconstruct + helper + Ascon p12 KDF）、key_mmio（0x3000_0080 段 21 字窗口，不暴露 key）
    - sim/keys/：tb_puf_key / tb_key_mmio / tb_dna_min + DNA_PORT/BUFG/LUT 行为模型 + 一键脚本
    - docs/key_subsystem.md：安全模型（PUF=秘密、DNA=绑定）、寄存器映射、集成方式、
    100 MHz 集成 STA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
2026-10-27 docs(cpu): 补入 CPU 流水线现状分析与 keys 固件工程
    - docs/cpu_pipeline_flow.md：模块层级、5 拍逐拍表、stall/flush 优先级、冒险/旁路矩阵、
    存储通路定位、多周期单元、可改点清单（F/B/H/E/M/S）与测量方法；行号按当前 src/rtl 核对
    （纠正 if_id 不寄存指令、icache 双守卫、dcache 611 行等旧结论）
    - src/firmware/keys_rv32/：PUF/密钥子系统的裸机固件工程（main.c/crt0/riscv.ld/uart 等 8 文件）
    两者均为文档与固件，未改 RTL；PUF 固件尚未上板。
    [bin2vhex.py, libc_min.c, main.c, uart.c, uart.h]
2026-10-27 feat(keys): PUF/密钥子系统集成进 src/rtl 与上板工程（阶段 4，板级待验）
    RTL（对 f88e178 的 src/rtl 应用两个集成补丁，git apply 干净）：
    - ascon/ascon_mmio.v：新增 key_hw[127:0] / key_hw_sel 输入；锁定后 CPU 写 KEY0..3 一律丢弃，
    run_key 取硬件密钥（CPU 既不写也读不出这把钥匙）
    - soc_top.v：实例化 puf_key(u_puf_key) + key_mmio(u_key_mmio)；ro_clk = clk/4 经 BUFG；
    复位后 0xFFFF 拍自动尝试一次 reconstruct，key_valid 即锁定 key_hw_sel；ascon_rdata 由
    core 与密钥窗口 OR 合并
    - 集成后源集哈希：src/rtl/*.v(31) 2a83bec0…、src/rtl/keys/*.v(5) be9507ef…、src/rtl/ascon/*.v(9) 96fe17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
2026-10-27 fix(keys): 修 PUF 复用握手（忙时排队 + 采样看门狗 + 固件诊断/重试）
    板上现象：enroll 成功（quality=127/128、DNA 可读、REF==RAW），紧接着 reconstruct 永远等不到 done。
    根因（两处脆弱点，仿真 6 次连续操作不复现、硬件才暴露）：
    - key_mmio 在 busy 时写 START 静默丢弃（if (wdata[0] && !key_busy)），上层只能超时
    - ro_puf_core 的 ro_clk 域没有任何超时兜底，卡在中间态则 done_tgl 永不翻转
    修改：
    - ro_puf_core：req_event 改为权威重启（任何状态收到请求都从起振重来）；新增 24-bit
    采样看门狗 WD_RO=M*(WINDOW+2*DWELL+8)+32*DWELL，超时强制收尾
    - key_mmio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
    [key_mmio.v, main.c, ro_puf_core.v, tb_puf_key_reuse.v, tb_ro_reuse.v]
2026-10-27 fix(keys-fw): 先等 idle 再发 START，并确认 done 属于本次操作
    板上 v2 日志（新 RTL + 新固件）证明硬件握手已修：
    - STATUS pre-enr busy=1 → 上电自动 reconstruct 仍在跑
    - 随后 enroll 完成 quality=127、reconstruct 0x7f26（ready+enrolled+done，mismatch=0 fallback=0）
    但固件抢跑：没等 busy 落下就 CLEAR+START，wait_done 抓到 boot 那次的 done，
    把 enroll 的中途状态当结果打印（enrolled=0 quality=0、REF 全 0 均为半写值）。
    - 新增 wait_idle()：每个操作前等 busy=0（含上电自动 reconstruct）
    - 新增 start_op()：CLEAR→START 后确认 busy 抬起或已完成，证明本次 START 被受理
    -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
    [main.c]
2026-10-27 docs(keys): 记录 PUF 板级闭环首次通过（quality 128/128，reconstruct 一致）
    v3 固件（先等 idle 再发 START）烧录后串口全通过：
    - STATUS idle 0x3A = ready+mismatch+fallback+done（上电无 helper 时按设计降级）
    - STATUS enrol/recon 均 0x8026 = ready+enrolled+done，quality=128，mismatch=0 fallback=0
    - REF == RAW，1 的个数 59/128 = 46.1%，排除比对器系统性偏置
    - DITHER=0 / MASK 全 1：M=5 窗口逐位一致
    未验证（已写明）：跨上电稳定性（helper 在易失寄存器，每次上电重新 enroll）、
    温压/老化/唯一性 not_measured、RO 采样域未纳入 STA。
    原始串口日志待归档为 data/ascon/results/board/uar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
2026-10-27 docs(keys): 归档 PUF 板级日志（含 v2 抢跑失败段与 v3 通过段）
    原始捕获 data/ascon/results/board/uart_20261027_keys3.txt 内含两段连续日志：
    - 第 1 段（v2 固件）：STATUS pre-enr busy=1 → STATUS enrol 0x23（busy=1 且 done=1，
    done 属于上电那次 reconstruct）→ FAIL enroll not marked / quality=0 / 末行 FAIL
    - 第 2 段（v3 固件）：STATUS idle 0x3A → STATus enrol 0x8026 quality=128、REF==RAW、
    STATUS recon 0x8026、PASS + DONE
    处理：
    - xcom_raw_20261027_keys3.XDat 原样保存原始字节（首尾含 0x00、CRLF），sha256 3f851316…
    - uart_20261027_keys3.txt 为剥 NUL/规范换行后的可读文本，标注两段归属，sha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
2026-10-28 docs(keys): 冻结索引补 PUF 版镜像与实现证据（keys3）
    - bitstream top_pl_bram_keys3.bit 4,045,687 B，sha256 edaf8417d88e7b73…
    - WNS +0.152 ns / TNS 0 / 失败端点 0/59513；WHS +0.034 / THS 0
    - 最差路径 u_cpu_core/id_ex_u/sel_ex_mem_rs1_o_reg/C
    - 布线 40894/40894，routing errors 0；DRC Error 0 / Critical Warning 0（Warning 825，
    含 LUTLP-2 ×256、PDRC-153 ×256，来自 256 路 RO 有意的组合环与 pblock 放置）
    - 资源 LUT 15987 / FF 28508 / BRAM 34.5 / DSP 4
    - Methodology TIMING-17 ×1001、TIMING-23 ×257：RO 采样域仍未纳入 STA，不得声明 PUF 时序签核
2026-10-28 docs(io-sta): 收入板级 IO 时序签核变体（约束、脚本、报告文档）
    - const_io.xdc：给只有引脚没有时序语义的板级端口补 2 个虚拟参考时钟 +
    set_input_delay/set_output_delay + false_path，使 no_input_delay/no_output_delay 归零
    - build/{build_io_sta,collect_applied_constraints}.tcl、check_io_signoff.py、
    collect_io_sta_results.py、fill_signoff_doc.py：一键跑 STA 并汇总
    - docs/io_timing_signoff.md：结论与逐条依据
    注意：const_io.xdc 目前是**签核变体**，未加入 riscv_vivado_project 的 constrs_1
    （工程内 active 仍为 const.xdc + build/keys_ro_pblock.xdc），因此不影响任何已签核 bitstream。
    原始报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
2026-10-28 wip(pynq): 收入 PS/PL overlay 骨架（未上板、未综合，仅可行性排查与代码框架）
    背景：RV32 外设全内部译码、dcache 只把 0x100x_xxxx 当 cacheable、无 dcache 失效指令
    ⇒ 共享 BRAM 邮箱不可行，改采"复用 UART MMIO 当通道"。
    新增（全部未验证）：
    - src/rtl/pynq/{pynq_ctl,pynq_mbox,pynq_soc,top_pynq}.v
    - src/firmware/pynq_svc/{main.c,svc_io.c,ascon_modes.c,svc.h,build.sh,bin2coe.py}
    - src/pynq/{pynq_transport,test_pynq_transport,make_pynq_profile}.py
    - sim/pynq/{tb_pynq_bridge.v,ip_stubs.v,elab_check.sh}
    - board/vivado_zynq7000_xc7z020_pynq/（readme + P0 快照）
    - docs/pynq_bringup_m1.md
    未验证：未跑 Vivado 综合/实现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
2026-10-28 docs: 收入投稿简介定稿、开发日志与任务板更新，impl jobs 10→12
    - docs/project_abstract.md：一段话定稿（438 裸字符，含展望）与长版，附不可越界表述清单
    - project_log/development_log.md：补 PYNQ overlay 通道决策与骨架产出
    - tasks/task_board.md：任务板同步
    - riscv_vivado_project.xpr：impl_1 LaunchOptions -jobs 10 → 12（不影响 QoR）
2026-10-28 chore: 忽略 IO-STA 原始报告目录（20 MB，可由 build_io_sta.tcl 重生成，结论已入 docs/io_timing_signoff.md）
2026-10-28 feat(pynq): 完成真实服务链路、自动构建与离线验收交接
2026-10-28 build(pynq): 发布已过时序验证的Overlay和固件哈希清单
2026-10-28 docs(pynq): 补齐交付文件索引与原始字节校验约定
2026-10-28 feat: 新增环境检查输出，环境检查通过
2026-10-28 Record PYNQ board validation
2026-10-29 feat(pynq): 完成Notebook warm benchmark与实板取证
2026-10-29 feat(pynq): 完成V03错误恢复门禁
    新增永久板级错误与恢复测试入口、Notebook 及离线测试，覆盖：
    - 17-byte plaintext/AD 长度拒绝
    - 半帧与 transport deadline 超时
    - 重复 request_id 和错误 epoch
    - RX FIFO overflow
    - 每次故障后的 reset、epoch 变化及三模式 KAT 恢复
    - 每模式 50 次加解密连续请求压力
    实板结果：
    - 9/9 checks PASS
    - 7/7 次恢复成功，epoch 1 -> 8
    - SW/HW/ISE 在每次恢复后均通过 KAT
    验证：
    - test_board_error_gate.py: 7/7 PASS
    - test_pynq_transport.py: 14/14 PASS
    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
    [board_error_gate.py, test_board_error_gate.py]
2026-10-29 docs(pynq): 同步实板验收与项目状态
    - 新增当前状态总表，汇总已完成、未完成及提交前优先事项
    - 更新 README、项目概览、架构与接口文档，反映 PYNQ 实板拓扑
    - 记录 AXI-Lite/UART mailbox v1、容量、会话恢复和固件装载边界
    - 根据实板证据将 Y01、Y03、Y05、V03 标记为完成
    - 更新任务板、里程碑、风险、交接、上板计划和材料目录状态
    - 历史计划保留原文并明确历史边界，避免旧 NOT_RUN 信息误导
    - Markdown UTF-8、本地链接和 diff check 通过
2026-10-30 feat(pynq-puf): PYNQ overlay with PUF v1 self-test (100 MHz, board NOT_RUN)
    The PYNQ release build uses rtl_p0/soc_top.v without the key subsystem, so no PYNQ
    test so far exercised the PUF. This independent overlay puts the unchanged PUF v1 RTL
    (src/rtl/soc_top.v + ascon/ascon_mmio.v + keys/) and the 10-27 board-tested keys_rv32
    v3 COE behind the PS GP0 control/mailbox path. Frozen release and JTAG project untouched.
    - pynq_ctl ID 0x31554650 v1 (3-mode client refuses it); FIXED_IO/DDR exported.
    - Vivado 2025.2, xc7z020clg400-1, FCLK0 100 MHz, Performance_RefinePlacement:
    WNS +0.208 / WHS +0.016, DRC 0 Error/0 Critical, no Netlist 29-160,
    1280/1280 RO LUTs in pb_ro_puf, 18571 LUT / 32001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
    [run.py, tb_pynq_puf.v]
2026-10-30 feat(skill): 新增通用 PYNQ Skill pynq-overlay-workflow（L1 离线测试通过，待队友验证）
    五段门禁流程（工件/加载/寄存器契约/数据通路/证据）、错误定位表、标准库工具包与 47 个离线测试。agent 对照实验与实板验证 not_run。
2026-10-30 feat(skill-eval): 新增 pynq-overlay-workflow 受控对照实验工具 ab_eval_pynq
    with/without/placebo 三组隔离试验生成、假 PYNQ 隐藏场景判分、置换检验统计与变异检查。判分器自检通过；真实 agent 对照实验 not_run。
2026-10-30 feat(pynq-puf3): 三模式 SW/MMIO/ISE + PUF v1 单一 overlay（离线门禁通过，board NOT_RUN）
    - 变体 RTL（board/vivado_zynq7000_xc7z020_pynq_puf3/rtl）：key_hw_sel 不再在 key_valid
    时自动锁定，改为 key CTRL[3]/[4] HWKEY 显式开关（复位关闭）；共享 src/rtl 未改。
    - 固件 src/firmware/pynq_svc_puf：pynq_svc 三模式 + Y01P/Y01K PUF 帧，ID pynq-svc-puf3。
    - PS 驱动 src/pynq/pynq_puf3.py（PQF3 身份）；release pynq_transport.py 未改。
    - 验证：cosim 54 步 PASS，自动锁定反例 mask=0x05 被检出；模型测试 12/12；
    clk_fpga_0 WNS +0.104/WHS +0.041，ro_clk +24.822/+0.115 已签核；RO 计数器未签核
    （ro_corner_sta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
2026-10-30 docs(skill): 同步 Skill 目录说明、RTL Skill 措辞修订与 Skill 测试指导表
    skill/readme.md 增加目录一览与队友快速上手；rtl-design-discipline 去除未经验证的绝对化表述；新增 docs/skill_test_guide_20261030.md 并指向 PYNQ Skill 的验证方案。project_log 含无关进度，未纳入。
2026-10-30 feat: 新增 PYNQ 测试的 .ipynb 文件
2026-10-30 fix: 修改 PYNQ （包含 PUF）的测试代码为 Jupyter Notebook 格式
    [pynq_puf3.py]
2026-10-30 fix(pynq-puf3): FCLK0 板上实际 62.5 MHz → 固定 IO PLL 后为 100 MHz，板测加入时钟实测
    - 根因：PYNQ 只按 hwh 写 FCLK0 分频(4x4)，IO PLL 沿用启动镜像(33.333333x30=1000 MHz)，
    实际 62.5 MHz；原版 PYNQ 2.7 Clocks 按 50 MHz 参考换算才显示 93.75。
    - build.tcl：PCW_OVERRIDE_BASIC_CLOCK=1、IOPLL FBDIV 30、FCLK0 10x1（ACT 99.999999），
    从头重建：WNS +0.104 / WHS +0.041，ro_clk +24.822/+0.115，DRC 0，RO 1280；新 bit 769ed24c。
    - 固件：Y01K 末 8B 改为发帧时刻 mcycle（cosim 54 步 PASS，autolock 反例仍检出）。
    - Notebook src/pynq_puf3/pynq_puf3_board_test.ipynb：下载前核对 IO PLL FBDIV=30，
    下载后按 hwh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
    [puf_svc.c, puf_svc.h]
2026-10-30 update: 更新添加 PUF 后的上板测试数据
2026-10-30 fix(pynq-puf3): 修复板测 'unexpected PUF frame'——banner 文本 "Y01K" 被误判为 PUF 帧
    - 证据 data/pynq_puf3/notebook_20261030_123118：时钟已正确（FCLK0 推算 99.999999 MHz），
    失败在 hello()：tx_bytes=0、service=null、mailbox_log 截止于 banner "puf: Y01P/"。
    固件 banner 文本 "puf: Y01P/Y01K" 被 Puf3FrameDecoder 当作 112B Y01K 帧，吞掉 Y01S。
    - Notebook 驱动：Y01K 只在 PUF 命令待响应时识别，且 version/flags/cmd/seq 须匹配，
    否则按文本跳过；puf_command 设置/清除 expect_k。清空上次失败运行的单元输出（证据在 data/）。
    - bit/hwh/固件不变（769ed24c / 4a0e7b95）；重新打包仅更新 mani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
2026-10-30 update(pynq-puf3): 更新添加 PUF 的上板测试数据，测试已通过
2026-10-30 docs(pynq-puf3): 记录首次板上会话功能验证通过
    记录 2026-10-30 实板测试的时钟、KAT、基准测试和 PUF 结果，
    并明确完整 KAT、跨电源周期测试及 RO 时序签核仍待完成。
2026-10-30 update(pynq-puf3): 更新完整 KAT 测试数据
2026-10-30 docs: 同步 PUF3 完整 289 组 KAT 实板验证结果
    - 更新 PUF3 三模式 KAT、benchmark、时钟和 PUF 流程证据
    - 统一项目 KAT 总数为 289 组
    - 明确跨电源周期和可靠性指标仍未验证
    - 同步状态、接口、架构、任务与项目日志文档
2026-10-30 feat(skill): 新增 PYNQ L3 验证测试脚本与证据记录
    - 新增预检、Ascon release、GPIO、DMA 和汇总 Notebook
    - 记录 L3 测试 session 与原始证据
    - 明确 preflight PASS 不等于完整实板 L3 PASS
    - 更新测试说明、任务状态和验证边界
2026-10-31 test(skill): 完善 PYNQ 工作流评测与验证归档
    - 扩展 fake PYNQ API 与评测任务框架
    - 新增 BRAM holdout、自测用例及 L2 对照实验结果
    - 更新 PYNQ 测试 notebooks、README 和项目进度记录
    - 明确 simulated、holdout 与真实板卡验证边界
    [results.csv, results_all.csv, results_final.csv, results_holdout_t5.csv, results_t1_placebo_rerun.csv, results_t2_t4.csv]
2026-10-31 test(skill): 完成 L3 Ascon 与 GPIO 实板验证归档
    - 新增 2026-10-31 L3 session 证据与汇总结果
    - 更新 Ascon、GPIO、DMA、summary notebooks
    - 修正 AXI GPIO all-output 方向测试逻辑
    - 记录 Ascon/GPIO 通过及 DMA 缺少回环工件未运行
    - 同步更新 Skill 文档、项目进度与经验记录
2026-10-31 feat(skill-l3): 非 Ascon AXI DMA 回环 overlay（离线门禁通过，board NOT_RUN）
    - board/vivado_zynq7000_xc7z020_axi_dma_loopback：xc7z020clg400-1，PS7 GP0→互连→axi_dma_0
    S_AXI_LITE(0x40400000/64K)，MM2S/S2MM→互连→HP0(64 位)，AXI DMA 7.1 simple 模式
    （SG=0、32 位、无 DRE、length width 14），M_AXIS_MM2S 直连 S_AXIS_S2MM（含 TLAST），
    全部 FCLK0=100 MHz（IOPLL FBDIV 30、分频 10x1，与板卡启动镜像一致），无中断。
    - PS7 DDR 参数按板卡 1 GiB，DMA 的 HP0 窗口 0x0-0x3FFFFFFF（默认 512 MiB 版本已作废）。
    - Performance_ExploreWithRemap + 布线后 phys_opt：WNS +1.736 / WHS +0.025，DRC 0，无 Netlist 29-160，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
2026-10-31 docs(report): 收录大模型协作原始记录与 Ross 使用心得
    - report/llm_collab/: export_sessions.py、index.md 与 21 个会话导出
    （13 个工程会话，76 条用户提示，2635 次工具调用），与技术报告 2.5.4 的统计一致。
    - 按项目方决定省略 1 条与工程无关的用户提示原文（保留轮次与计数），
    export_sessions.py 以 OMIT_PROMPTS 记录该规则，index.md 同步说明。
    - docs/ross_usage_experience.md: 依据 project_log 与已有验证文档整理的 AMD Ross 使用心得，无新测量。
    - report/readme.md: 说明 llm_collab 的来源与导出命令。
    会话 Markdown 中的行尾空格为原始导出内容，未改写。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
2026-10-31 feat(advanced): 入库 DMA/PUF 扩展实验、技术报告源与当前证据包
    - 源码：src/rtl/{ascon_dma,pynq_dma_cpu,keys_v2,puf_soc_v2,puf_min}、对应固件、
    src/pynq 驱动与测试、sim/* 回归、board/ 下 4 个新工程脚本、build/advanced。
    - 证据：data/advanced 的日志、时序/资源报告、JSON 与两个当前候选的 bit/hwh
    （dma_direct 100 MHz、cpu_dma 80 MHz，见 current_candidates.json）；
    PUF v2 候选保留 INVALID 说明与报告，bit 不入库。
    - 技术报告：docs/tech_report 源、构建脚本、图、最新一次构建记录与成品 PDF；
    2.5.4 同步“省略 1 条无关提示”的处理说明。
    - submission：当前证据包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
    [ring_topology.tsv, simulation_dma_config.txt, strategy_sweep_summary.csv, sweep.tsv, sweep2.tsv, topology_final.tsv]
2026-10-31 feat(skill): 完成 PYNQ Skill L3 全流程实板验证
    - 更新 preflight、Ascon release、GPIO、DMA loopback 和 summary Notebook
    - 新增 l3_20261031_063709 实板验证 JSON/Markdown 证据
    - 新增 L3 各阶段实板运行截图
    - 完善 AXI DMA loopback 工程及 HP0/TLAST/manifest 校验说明
    - 记录 Ascon、GPIO、DMA 与环境预检全部通过
    - 同步更新项目 README、Skill 说明、任务状态和开发日志
    - 标记 S01-S03 完成，保留 S04/S05 后续收口事项
2026-10-31 feat(skill): S04 可配置报告采集与非 Ascon 示例；S04/S05 收口
    report.py 新增指标 schema（utilization/timing/json 来源、汇总、tool_report 证据级别、估算需 basis、缺失记 not_measured、必需缺失 exit 1）；AXI DMA 回环 Vivado 报告 + L3 实板结果示例归档 data/skill/s04_report_dma_loopback。63 单元测试通过、变异 16/16。skill/readme.md 补齐 S05 说明、验证案例与陌生使用者复现。L2/L3 证据对应 7bc1abf，S04 新增部分仅离线验证。看板 S04、S05 → done。
2026-10-31 feat(report): 添加 D04 演示视频脚本及更新相关文档
2026-10-31 chore(release): 装配 11-01 最终候选证据包；修复 Skill gen 自包含；更新看板与提交计划
    - assemble.py 新增 X-1~X-6（pynq_puf3 候选/板测、Skill、L2、L3、DMA/S04）及装配前一致性门禁
    - 证据包 evidence_20261101_20261031_154020（119 文件，ZIP sha256 c507447e…，ZIP 不入库）
    - Skill gen 默认内置 pynq_skill；64 passed、变异 16/16、harness 7 passed
    - release_plan/task_board/project_log 同步；报告 PDF 为 10-31 14:30 构建版
    [results_final.csv, results_holdout_t5.csv, strategy_sweep_summary.csv]
2026-10-31 chore(release): D02 报告数值核对、冻结清单脚本、证据包再装配（X-7/X-8）
    - check_benchmark_tables.py 15/15；assemble.py 加 D02/视频脚本与过期门禁
    - evidence_20261101_20261031_163056（122 文件，ZIP sha256 3452e05c…）
    - freeze_manifest.py：干净提交上生成冻结清单与 git archive 源码包
    - 看板 D02 done、V04 in_progress；删除未入库的 15:32 作废包
    [results_final.csv, results_holdout_t5.csv, strategy_sweep_summary.csv]
2026-10-31 fix(release): freeze_manifest 兼容仓库相对路径的 sha256sums
2026-10-31 docs(release): 11-01 冻结清单（源码 af34e65、证据包 3452e05c、源码包 d00fa669）
2026-10-31 update: 更新 PYNQ 上板测试数据
2026-11-01 delete: 删除失败测试数据和旧版测试数据
2026-11-01 fix(release): 装配/D02/冻结改指最终 LaTeX 报告与 10-31 板测
    - build_evidence.py 集中维护 REPORT_DIR/REPORT_PDF/BENCH/GATE/PUF3_RUN（10-31）
    - assemble.py 绑定报告最近构建记录（PDF/源/证据输入），核对 board_result 与报告引用文件；新增 --check-only
    - check_benchmark_tables.py 对最终 LaTeX 43/43；反例均 exit 1
    - freeze_manifest.py 同步路径与限制；10-31 证据包/冻结清单作废说明
2026-11-01 chore(release): 最终报告 PDF 装入证据包 evidence_20261101_20261101_181751
    - 报告构建 build_20261101_174743，PDF sha256 603c625a…；板测主采样 data/pynq_puf3/notebook_20261031_114512
    - 266 文件，ZIP sha256 01000e5c…（ZIP 不入库）；独立解包 266/266 一致，52 报告源/98 证据输入全部随包
    - D02 对最终报告 43/43；assemble --check-only 计数修正
    [results_final.csv, results_holdout_t5.csv, strategy_sweep_summary.csv]
2026-11-01 docs(release): 入口文档按最终报告/PUF3 10-31 统一；最终 PDF 入库；证据包 evidence_20261101_20261101_183826
    - AGENTS/README/概览/架构/规则/里程碑/简介/视频脚本/report readme/PUF3 readme 更新为 PUF3 主演示与 10-31 数据；旧 Markdown 报告流水线与 10-31 状态快照标注作废
    - final_report.pdf（build_20261101_174743，sha256 603c625a…）入库；截图与 LaTeX 源按要求不单独入库，随证据包提供
    - D02 64/64（含简介/视频脚本/README 数字核对）；证据包 267 文件，ZIP sha256 2a0f0304…（ZIP 不入库）
    - freeze_manifest 只约束已跟踪文件并记录未入库文件
    [results_final.csv, results_holdout_t5.csv, strategy_sweep_summary.csv]
2026-11-01 docs(release): 11-01 冻结清单（源码 92159b9、证据包 2a0f0304、源码包 0ade4e66、报告 PDF 603c625a）
2026-11-01 docs(poster): submit user-revised Ascon SoC poster
    Task: D03. Preserve user-edited PPTX; refresh preview and validation hashes. PowerPoint 16 read-only export; 31 evidence checks PASS; package/layout checks exit 0.
2026-11-01 docs(poster): add bilingual pages and official SCUT emblem
    Task D03: Chinese and English editable poster pages with official university emblem. Retain only PPTX, PNG previews and README in poster delivery; remove one-off scripts and validation JSON. PowerPoint 16 render and text fit pass; 51 content checks and package/layout checks pass.
2026-11-01 文档：完善海报编号并替换典型应用示意图
    任务：D03。为中英文两页的交付范围和两处创新说明逐项编号。
    左侧改为可编辑的传感器短消息认证加密应用示意，保留右上实物照片，明确未实地部署。
    同步两张预览、来源说明和项目日志；61项核验通过，结构和布局检查通过，文字无溢出。
    海报目录仍仅保留演示文件、预览图和说明文档。
2026-11-01 文档：将海报左侧替换为器件标识与物理响应密钥派生图
    任务：D03。仅替换中英文海报左图和图注，补充项目已有的器件标识、物理响应和置换派生介绍。
    其他版面和既有脚本保持不变，同步预览、来源说明及项目日志。
    通用核验51项、区域不变及新图专项157项通过；结构和布局检查通过，文字无溢出。
2026-11-01 文档：更新双语海报的PUF3实测数据
    同步中英文两页海报的周期、加速比、资源、时序和频率估测数据。
    明确历史版本门禁归属及物理响应与器件标识密钥通路的验证边界。
    保留原有版式和其他内容，同步两张预览、来源说明及项目日志。
2026-11-01 docs(repo): preserve version-scope clarification and project explainer before delivery cleanup
    [configuration.txt]
2026-11-01 整理：隔离历史源码并建立PUF3独立交付入口
    任务D07，owner TBD。当前PUF3及共享依赖保持原位，历史源码集中隔离，原始资料去重归档并校验。新增项目看板、分包和解包验证工具，Skill独立，报告CPU措辞更新后重新编译。
    验证：56项生产输入、7项构建支持和5个工件匹配；离线122通过/3跳过；解包host61、Skill61/3跳过、固件BIN一致、elaboration通过；4915个旧路径内容可追溯。
    不改当前RTL/固件算法，不新增板测或RO签核。网页原件未找到，明确列为待补，不宣称已交付。四个最终ZIP随后从本源码提交固化，原始许可与记录保留。
    [archive_inventory.csv, configuration.txt, failing_endpoints.csv, module_bbox.csv, paths_c100.csv, paths_ctl.csv, paths_d100.csv, paths_f100.csv]
2026-11-01 交付：固化PUF3与历史源码、独立Skill和技术报告四包
    任务D07，owner TBD。冻结源码124f5c7，四包分别263/1484/28/62件，含逐文件SHA-256与独立下载入口；仓库原始记录继续单独归档，不作为源码交付附件。
    正式ZIP解包、干净源树重新分包及再次解包全部通过；host61、Skill61/3可选跳过、固件BIN匹配、56项生产输入/7项构建支持检查通过。报告包LaTeX独立编译77页，保留字体/排版警告，未替换冻结PDF。
    不新增Vivado或实板验收，不关闭原PUF/完整矩阵边界。网页原件缺失已明确列为待补；正常推送main，不force push。
2026-11-02 文档：补充README目录说明与PUF3从零复现指南
    任务D08，owner TBD。新增README实际目录树与docs/reproduce_from_zero.md，区分现成候选、完整重建和四ZIP校验，补齐Windows/WSL环境、输出位置、候选备份及Notebook副本说明，并同步看板与项目记录。
    验证：44个相对链接、18处命令路径、8项CLI帮助核验；PUF3 elaboration通过；离线122通过、3项可选跳过；1132个程序/工件/数据/交付保护对象hash不变，diff检查通过。
    按用户明确授权提交推送。仅文档，不重打包、不改RTL/固件/candidate/PDF/原始记录，不新增硬件或PUF验收结论。
2026-11-02 整理：按赛题推荐结构将docs并入report并归位大模型协作记录
    - docs/tech_report -> report/technical，其余说明 -> report/design，
    复现指南 -> report/reproduce_from_zero.md（git rename保留历史）
    - llm_collab从archive/history/report移回report/，21个会话原文入库
    （与archive/evidence/raw_records_20261102.zip逐字节一致）
    - 只改映射后目标真实存在的引用；同步.gitignore、package_delivery.py、pytest.ini
    - README新增与比赛推荐目录的对照表；report/readme.md说明设计报告+协作记录
    - RTL/固件/candidate/交付ZIP未改；pytest 122 passed/3 skipped
2026-11-02 文档：修正全部 Markdown 在 GitHub 上的渲染问题
    - 以 cmark-gfm（GitHub 同款）逐个渲染 231 个已跟踪 .md，判定先经 GitHub /markdown API 校准
    - 只改标记不改文字：中文标点粗体、表格内管道符/被吞行/列数不等、单个 ~ 删除线、
    被剥除的 <tag>、裸 URL 吞中文标点、通配符斜体、2 个公式改 GitHub 可用写法
    - 修复 2 处历史结构损坏：key_subsystem.md 的 printf 换行（导致后文全变代码）、
    timing_route_tests §9.2 标题被误插的重复清单（恢复 8e51bee 原标题）
    - 会话记录：修 export_sessions.py（工具摘要入行内代码 + 渲染安全转义），用同一函数处理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
2026-11-02 文档：新增报名作品全貌图及素材说明
2026-11-02 文档：修正技术报告图件与仓库路径，重写复现说明
    - 图 2-1 去掉旋转标注白底、AXI/BRAM 竖线移出 soc_top 框线；图 2-2 重新布线，连线不穿框、标注不压线；
    图 2-4 改为水平/竖直正交走线；同类问题顺带修正图 2-3、2-7、2-9、2-13、2-14、3-3
    - 正文与附录路径对齐当前仓库结构（report/、archive/history/、raw_records 归档与恢复命令）
    - 第 3.4 节复现说明重写为七节并新增表 3-17~3-20；修正 longtable 与浮动图叠页导致表 2-14 被截断
    - 新增 build/metadata/offline_reproduce_check.json：864520d 干净检出离线复跑记录
    - 报告重编 83 页，review_evidence 194/194；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
2026-11-02 交付：单独重打技术报告包并记录复验
    - delivery/technical_report.zip 按 package_delivery.py 同一规则从 9433ff1 重建（83 页 PDF + LaTeX 源）
    - manifest 只更新该项并另记 source_revision；其余三包保持 124f5c7 快照
    - verify_delivery 四包 PASS，包内 LaTeX 独立编译 83 页，干净检出 review_evidence 194/194
    - 新增 build/metadata/report_repack_check.json；同步 delivery/README、项目看板与实际进度
2026-11-02 文档：技术报告新增 AMD ROSS 使用心得并准备整仓快照
    - 第四部分末尾新增 4.3「AMD ROSS 使用心得」：表 4-1 列接入、lint、156 端点归因、双策略实现、
    DSP 打包核实、方法学处置与 ISE 波形仿真八项实际用途，另述价值、版本边界、MCP 注意事项与团队裁决
    - 内容逐条对照 V07/V08/V09 日志、ROSS 评估与心得文档、lessons L68/L85/L87/L88/L91/L93，不含新测量
    - 2.5.1 增加交叉引用，参考文献补 ross-ai-assistant；报告重编 85 页，review_evidence 194/194
    - tools/verify_puf3_sources.py 改为 LF/CRLF 双向等价比较：候选按 CRLF 记录，LF 检出原先误报 49 项
    - README、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
2026-11-02 交付：重打技术报告包并新增整仓快照 ZIP
    - technical_report.zip 按 cd0f3f3 单独重打（62 件，SHA-256 e183bd4c…），报告 85 页，含 4.3 AMD ROSS 使用心得
    - 新增 amd_fpga_2026_repo_snapshot.zip（93,496,023 B）：cd0f3f3 全部 1620 个跟踪文件（去掉 delivery/）
    加报告包中不受 Git 跟踪的 58 个 LaTeX 源，内附 snapshot_readme.md 与逐文件 SHA-256
    - manifest.json 增加 repository_snapshot 项；README 说明范围、核对命令、需要 Git 的步骤与边界
    - snapshot_and_report_check.json：四包 verify_delivery（含内部编号扫描）PASS、报告独立编译 85 页；
    快照解压后与提交树逐字节一致，源集/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
2026-11-02 docs: 优化技术报告代码块换行与排版
2026-11-02 交付：整理代码、技术报告与Skill并打包RAR
2026-11-03 文档：导出AMD项目聊天记录并修正报告包说明
    D11：新增5份Codex项目会话，索引共26份；导出器支持增量保留和完整可见正文。修正正式报告ZIP内两份Markdown的版本、路径、工具与字体说明，并更新内外哈希。
    验证：Python3.14.3导出与隔离校验通过，61成员哈希及CRC、四ZIP哈希、26条索引链接通过；PDF仍85页，其余59成员不变。既有未提交改动单独保留。
